RichardSefton/AUV/MidtermReport/MidtermReport.pdf

# Final Project: Draft Report

### Richard Sefton

# Contents

Introduction | 1
Literature Review | 4
Project Design | 9
Feature Prototype | 14
Appendices | 26
A Project Permission | 27
B Project Plan | 28
C VQFN Breakout | 30
D AVR ATTiny 1627 Features | 32
E TWI Library Code | 43
F Sonar Schematics | 54

1

G Depth Controller | 56
H Pseudocode | 64
I Code | 80

2

Abstract

This preliminary report focuses on the initial research into, and the making of a prototype of an Autonomous Underwater Vehicle (AUV) for the Final Project. The AUV will be written in primarily C code using bare metal AVR ATTiny1627 Microcontrollers and developed as independent modules networked using the I

2C peripheral in a way that would make it extensible to accommodate various sensor payloads. An outline of the Minimum Viable Product for this project is a vehicle that is able to Autonomously drive itself through a body of water, avoiding obstacles, with additional features such as data transmission and following mission paths to be developed in phases once MVP has been reached.

# Introduction

For this project, I plan to develop an autonomous submarine or AUV (Autonomous Underwater Vehicle) as they are commonly known. AUVs are not a new or unexplored field. They have been produced since the 1950s with various examples at the commercial and research levels along with some parallels that can be drawn in the amateur space with remote control submarine projects.
This project was born from a personal enjoyment of the Internet of Things module which allowed me to explore microcontroller programming, and interacting with physical electronic sensors and actuators. This blossomed into a passion for robotics, and as one of the early module videos highlighted our projects should be something we are passionate about: without passion, we would be unmotivated to complete this lengthy and isolated piece of work [23]. This project does not comfortably fit within any of the given templates - I found the templates for Internet of Things were topics I’m not passionate about. I did gain permission for this idea via the Coursera forums[31] prior to embarking on this journey. Screenshots of the permission can be found in the images A and A of Appendix A.
The inspiration for this project came from various YouTube videos by a single YouTuber (Brick Experiment Channel[5]) whereby the person created iterative versions of a remote controlled submarine using a watertight container and Lego. While these videos and their associated blog[6] serves as the initial inspiration, the idea to automate it comes from a fascination with robotics.

## Previous Works

### Amateur Level

The YouTuber Brick Experiment Channel[5] wrote a series of blog posts[6] outlining the build process for the 4th iteration of their remote controlled submarine.
The posts are detailed covering the steps of building this submarine with reasoning behind the design decisions along with a critical evaluation of each step. This version is using a large syringe to bring water onboard the vehicle

1

to control buoyancy, and is driven by two motors: one for propulsion, and one for direction. The sensors incorporated measure pressure to accurately gauge depth, and a laser to measure distance from the bed of a body of water.
The blog also raised communication as a consideration: While the aim of this project is to build an autonomous vehicle, it would be nice to communicate with it in flight. The problem is this cannot be done easily with wireless frequencies as the higher frequencies that provide the required bandwidth do not penetrate water that well.

### Commercial Level

The company Advanced Navigation makes the Hydrus Drone[22], which claims to be one of the smallest AUVs on the market. The device itself controls depth and position with impellers, a 4K camera with AI integrations, and a forward facing sonar. The most important aspect of Advanced Navigation’s AUV is how they address the issues around wireless communication. This company has fitted their device with acoustic and optical modems so data can be transferred using audio frequencies and light (presumably similar to fibre octics).

### Research Level

The Woods Hole Oceanographic Institute[15] draws attention to the use of different AUVs depending on the area of research or environment. They use one of 6 AUV models, which operate at different depths or different functionality.The REMUS[16] can be equipped with varying sensors and is programmed for survey missions. It was adapted to survey the Delaware river Aqueduct for leaks.
One of the more interesting AUVs this institute uses is the Spray Glider[17]. This description for this device is one that glides through the water without any external thrusters so can be travel for weeks at a time. The device uses internal bladders to control buoyancy, and is set to navigate preset paths equipped with varying sensors. What is interesting about this device is the lack of external propulsion seems to make this device more passive, and can therefore operate at lower voltage.
The UK National Oceanography Centre has details on the challenges around an designing an AUV[14]. For power and propulsion it highlights the lack of oxygen for internal combustion makes it necessary to use batteries for power and notes the difference in speed between AUVs and surface ships. For navigation it highlights that because GPS can’t penetrate the top few mm of water, the reliance on other techniques is required. It suggests an approach called Dead Reckoning which gets the speed of the AUV by measuring the Doppler shift from the sea bed for relative speed and using

2

a gyro to measure the heading. It highlights that navigational accuracy is vital to survey missions.

3

# Literature Review

The definition for an AUV is best described in an article titled ”Autonomous Underwater Vehicles (AUVs): Their past, present and future contributions to the advancement of marine geoscience”.

Autonomous Underwater Vehicles (AUVs) are unmanned, selfpropelled vehicles that are typically deployed from a surface vessel, and can operate independently of that vessel for periods of
a few h to several days.[35]

The authors go on to highlight that ”In addition, recent economic drivers, such as rapidly increasing vessel fuel oil costs, are making autonomous systems a potentially attractive proposition to organisations responsible for large-scale and cost-effective marine data collection programmes”[35]. This article addresses the commercial benefits of AUV production and deployment but doesn’t address the human benefits such as safety.
The authors also discuss the applications of AUVs and point out that ”the sensors deployed determine the vehicle altitude, as well as its speed and endurance.”[35] The endurance in this context is the available power to the AUV which would affect its overall range. Because different sensors and actuators have varying power requirements, some of these components may draw more power than others. The array of sensors required is defined by the AUVs use case: it would be inefficient mounting water quality sensors onto an AUV designed for ocean bed mapping survey.
While this article includes a lot of jargon relating to marine geosciences, it provides a good overview of the uses of AUVs and their previous applications. More importantly, it provides some good starting points for some concepts I will need to explore during the development of this project. This includes references to works that look into the Dead Reckoning method of positioning, and a launch pad into some key concepts such as Sonar.

## Communication

Because the sensors deployed on an AUV are specific to its function and is something that can be configured, it is worth considering a modular design. As a part of this there could be some level of connectivity between

4

the separate modules. Modern MCUs typically feature multiple options for communication protocols such as UART, USART, I

2C, SPI, USB, Ethernet
or could be as simple as pulling a pin high or low. For the purpose of this project, we will consider I

2C as it uses minimal wires, and allows for two way communication. The MCU data sheet[20] is the manufacturers documentation and is a vital reference for development on any given MCU and it directly relates to the MCU specific library in code. It has all the details and requirements to setup any of the provided MCU features, and gives a brief overview of each feature.
With regards to the ATTiny 1627 MCU, the data sheet describes I

2C
as a TWI (Two Wire Interface): ”The Two-Wire Interface (TWI) is a bidirectional, two-wire communication interface (bus) with a Serial Data Line (SDA) and a Serial Clock Line (SCL)”[20]. There are several advantages to using the TWI bus as a communication protocol as it allows the connection of ”one or several slave devices to one or several master devices”[20] allowing a network of devices to become interconnected. This would also allow for parallel computation as instead leaving one device to perform all of the sensor readings and calculations, some of which could be computationally expensive or using deliberate pauses of code execution, a master device could simply trigger the networked modules to each perform their actions and then do nothing while waiting for the responses.
In the article ’FEATURES, OPERATION PRINCIPLE AND LIMITS OF SPI AND I

2C COMMUNICATION PROTOCOLS FOR SMART OB-JECTS’ the authors share their opinion on how an IoT network should operate and how it should be secured, and then give an overview of both I

2C and SPI protocols before suggesting a hybrid version of the two. For IoT networks the authors suggest that ”different devices with different capabilities will take part in the creation of a network. A self-describing interface for each device is necessary in order to optimize the management of required tasks”[32]. This point backs up my idea of a modular design where sensor modules can be attached in a way to form a network where each module is responsible for a specific task. They then go on to highlight that ”adding an object to the network should not cause the collapse of the network itself. The network should also properly handle the failure of a device”[32]. This point involves error handling within a network of discreet modules. If one module fails, the whole unit should not. If the module is deemed vital to the devices operation, such as obstacle avoidance sensors on an AUV, a graceful way to handle this could be to surface the device and broadcast a signal indicating the error on a predefined wavelength so it can be collected.
For I

2C the authors give a detailed overview stating that:

The Inter Integrated Circuit (I

2C) protocol, ..., was developed by Philips in 1982 and it is a serial, single-ended bus with multimaster support and typically used to connect low speed de-

5

vices.[32]

The bandwidth available over the standard I

2C rail is slow at 100kbit/s, but there is a Fast mode and Fast Plus mode which allows up to 1Mbit/s. Additionally some devices also support a high speed mode which allows up to 3.4Mbit/s.[4]. This means the I

2C rail may not be suitable for all types of sensors attached, particularly ones that gather a lot of data in real time, for example high definition cameras.

Since the bus is completely shared, it is possible, for devices, to receive not only unicast transmission but also broadcast messages: for this reason, whenever master wants to write or read data from a particular slave, it will address it first. Addressing bits were originally seven, extended to 10 with the latest reviews to increase supported maximum number of connected devices. I

2C bus supports multiple masters on the same bus too, but a proper conflict-solving algorithm has to be implemented. [32]

This addressing is how the devices know what devices they need to talk to on a network. With the system of addressing and the ability to broadcast transmissions we can begin to visualise the I

2C protocol as akin to web sockets. The interesting point raised here is that conflict resolution needs to be handled where the network has multiple masters. One such proposal they put forward is Arbitration: ”since I

2C supports multiple masters, an arbitration rule is necessary. In this protocol, arbitration proceeds bit by bit and the rule is deterministic: the first master that produces a one when the other produces a zero loses the arbitration”[32].
Another resource that covers a lot of information about AVR Microcontrollers and also providing an overview of the features as well as how to interact with actuators such as servos and stepper motors, is ’Make: AVR Programming’[33]. While this book does contain quite a broad overview of the features and protocols, it also has examples of code to interact with them, as well as an overview of the toolchain required to programme a microcontroller (in this instance involving Make, avr-gcc[11] and AVRDude[3] as well as a physical hardware programmer). However, the example code is all written for a specific MCU that the book focuses on, being the AT-MEGA168. However, as the author notes, this should not be too difficult to port to my specifically chosen MCU as the book also tries to teach another skill being the ability to refer to relevant sections of the data sheet.
As well as internal device communication protocols, it would also be good if we could have some way of interacting with the device in flight: receiving data, and possibly some rudimentary manual over ride/remote control. As corroborated in an article exploring underwater wireless networks, ”radio is seriously attenuated in water”[13]. Radio waves exist on the EM Spectrum and the lower the frequency, the further it can penetrate water due

6

to the electrical dissipation that occurs, which is accentuated by salt water. High frequencies that we are used to as standard data transfer frequencies (WiFi, Bluetooth) are measured in GHz, and these penetrate only a few cm of water. Even LoRa at 433MHz will only penetrate 30-50cm of water. The military use lower radio frequencies operating in the range of Hz to kHz to communicate with their submarines but the trade off is lower frequencies bandwidth (less data can be transferred as there are fewer cycles per second). Additionally, radio frequencies are controlled[24] and as a hobby enthusiast/student I only have access to a limited range of frequencies. The article also states ”acoustic communication is almost the only effective way for underwater wireless transmission. Nevertheless, compared with the traditional radio, underwater acoustic communication is greatly affected by poor conditions, such as absorption, scattering, multipath interference and Doppler effect”[13]. While I think the authors are perhaps exaggerating this point to justify their experiments somewhat, it does offer an alternate avenue to wireless communication with a device while it is operating underwater, but it would require the development of an ultrasonic modem of some description. Alternatively we could just add a plug to the device for a physical wire for external control/data transmission. While this goes against the design of an AUV as being untethered, it would also act as a lifeline to retrieve the device while minimising risk, even when testing in controlled bodies of water.

## Navigation

Since AUVs are unmanned, they require a method of obstacle avoidance. Above water levels, using air as the medium there are several options available such as ultrasonic range finding, lasers or LiDAR devices, Radar, machine vision (aided with cameras), or radio signal strength to avoid obstacles such as similar devices that are networked. When the environment changes, the methods become more restricted: ultrasonic range finding is not an option in the vacuum of space as it requires a medium for the sound waves to travel through. In the case of underwater, most of the options listed above can work under certain conditions. Machine vision using cameras for example can work in clear waters. Once the water becomes murky or turbulence occurs the images can become distorted or the effective range is reduced. Lasers have a similar issue where the refraction of light in the water makes it difficult to use this as an accurate gauge. Of all the options, Ultrasonic range finding is one of the few consistently viable options for consistently accurate measurements. When used underwater, Ultrasonic range finding becomes Sonar. ’A Brief History of Active Sonar’ while discussing the threat of submarines during WW1 states that:

Since sound is the only transmitted energy that penetrates water

7

for any appreciable distance, acoustic echo-ranging had to be exploited to counter this threat. [7]

the technology was developed by Reginald A Fessenden. ”In a response to the need for enhanced detection of submerged objects and enemies, the first successful underwater transducer developed was a 540-Hz electrodynamically driven circular plate”[7] and ”the use of the word sonar for these systems, defined as Sounding Navigation and Ranging, was coined in 1942 by F. V. Test Hunt, director of the Harvard Underwater Sound Laboratory” [7]. A transducer is an electrical component that can emit sound waves in a set frequency. Additionally, the transducer can detect sound waves on the same resonant frequency. When the detection occurs the sound waves cause the transducer to vibrate generating an electrical signal [28].

The inter-war period was also a time for basic research in underwater acoustics. One key discovery during this period was that amplitude of higher frequencies of underwater sound are attenuated more than lower frequencies as they pass through
the seawater. [7]

This observation states that lower frequencies penetrate water better than the higher frequencies, i.e. lower frequencies provide a longer range, but what this article fails to cover is that higher frequencies provide a higher resolution when it comes to sonar imaging technology [34].

8

# Project Design

## Domain

AUVs have applications spanning multiple domains both in scientific exploration as well as commercial enterprise. For science they are used for surveying coastlines and ocean beds, sampling in remote or hard to reach locations and exploring the depths to name a few applications. For commerce they can de deployed to monitor gas and oil pipelines, monitor drills, survey potential resource sites, and monitor ship hulls etc. The deployment of AUVs over physical diving or manned equipment offer more benefits when compared to the cost. AUVs can potentially spend longer underwater depending on the design and payload they are equipped with and the size of the power source, and can gather far more data than a diver with far less risk to human life (if they are deployed at sea the risk will never be zero, but there is considerably less additional risk).
For the purposes of this project the AUV I will develop will be targeted towards the scientific exploration domain, specifically those designed for survey missions. AUVs in this domain are highly configurable with the payload (being the array of sensors attached) being customised for the survey being conducted, often with fallback sensors to verify the data (such as cameras coupled with sonar), or designed from the ground up for a specific operational area. This project will be focused on a customisable AUV focusing on the core mechanics that make it autonomous. The minimal viable product for this project is going to offer basic functionality (object avoidance primarily), but will be modular in design. The sonar and motor controllers would be separate Client modules bound by a central Host MCU.

## Technologies

For this project I plan to use predominantly AVR based microcontrollers with code written in C using the official AVR libraries, but otherwise a ”bare metal” approach. This project will be using little to no Arduino code as now is a good learning opportunity to programme microcontrollers without relying the Arduino layer of abstraction or the on board programmer

9

attached to a pre-fabricated Arduino boards. Additionally, by focusing on the MCU alone, PCBs can be fabricated for this project with a far lower footprint than trying to fit in multiple individual Arduino boards, which could prove invaluable if space and weight becomes a premium. The specific MCU I plan to use is the AVR ATTiny1627[20] due to its small size and power requirements. The device can operate on 1.8V to 5.5V making it potentially extremely low powered, and is also feature rich (Appendix D). Unfortunately the chip itself is extremely small as the 24 pin 1627 is only available in QFN (or VQFN packaging), which is incompatible with a breadboard for development and testing. To mitigate this I have developed a QFN breakout board (Appendix C). This has proven to be economically viable as the cost per board was only £7 and the MCU was less than £1 making the per board cost for each MCU to be ¡ £8. This comparable with the Raspberry Pi Pico or the NodeMCU 8266[8] and significantly cheaper than the Arduino Uno or larger Raspberry Pi models.
The AUV itself will be using predominantly large diameter plastic tubing or a suitable size plastic tub along with various adhesives and sealants (silicone based) for waterproofing the device. Lego will also be used for structural support and for aiding in the various mechanisms to drive the device (such as rotors/propellers). The use of Lego has been decided over creating custom devices on a 3D printer due to budget and time constraints. For navigation and obstacle avoidance this project will employ the use of sonar. While prefabricated sonar units designed for underwater applications exist, these are often expensive with devices such as the Ping2 by Blue Robotics[27] which is designed for this type of application starting from £400. While devices such as this are extremely feature rich, they are out of reach for this project. Alternatively there are various fish finders on the market that start from £40 which could be hacked to become compatible with this project. There is also the option to use the HC-SR04[10] ultrasonic rangefinders, but they may not be suitable for this application for a few reasons:
- The HC-SR04 is not designed for underwater applications. There may be an issue with the air gap between the transducer itself and the hull of the vessel which in itself could be problematic. The transducers may have to be mounted outside of the vessel.
- The HC-SR04 is primarily designed for over the air applications. Speed of sound travels faster through water than in the air and the MCU that is controlling the device may be tuned to enable the receiving transducer only after set time period to reduce false positives and noise. This period would shorten the minimum range of the sensor.

For these reasons I will aim to develop a sonar module from scratch. The data sheet for the HC-SR04 module is also quite useful as it provides a

10 formula for calculating distance in the air.

Range =

HighLevelT ime × V elocity 2
[10]
In this formula, Velocity is the speed of sound. The data sheet describes this as a flat 340m/s which is slightly inaccurate. The speed of sound is impacted by environmental factors such as temperature, humidity and the transmission medium meaning the Velocity would need to be adjusted for water, and saltwater more so[9]. Another article, titled ’Design and Development of an Ultrasonic Motion Detector’[1] could prove to be valuable to this project as it covers the development process in creating an ultrasonic device to detect motion. While this is not fully what I will be looking to accomplish, it provides insight on two key concepts: A Sonar circuit diagram example, and Doppler Shift which is used in Dead Reckoning to help provide the speed of the AUV relative to a fixed point.
For propulsion the plan is to use either a toy motor or a stepper motor. The toy motors are easier to drive, using Pulse Width Modulation fed into a prefabricated driver circuit to specify the speed. The issue with the toy motor however is the torque - it may not have the required torque to drive a shaft as the current plan is to use magnets to connect an internal and external shaft in the same way as the YouTuber ”Brick Experiment Channel”[6]. The stepper motor will provide the required torque but speed adjustment is not quite as simple as modifying the PWM duty cycles.
For depth control the plan is to use a large syringe similar to ”Brick Experiment Channel” RC Submarine but this will involve some experimentation to see if this can be achieved by modifying the weight of the vessel by taking on water from outside, or by changing the density of the vessel by compressing the available air. The syringe will be driven by a motor, which will likely be a stepper motor given the compression and decompression will require more torque than the toy motors can provide and because this requires somewhat more precision. This will also require a method to convert the rotary force to a linear push/pull force on the syringe plunger.

## Project Plan

This is a highly ambitious project. For this reason it is necessary to outline a clear minimum viable product, with phased further development beyond this point. The MVP will consist of the core components that will make an AUV able to move through a body of water:

- Propulsion
- Directional control

11

- Depth Control
- Sonar for obstacle avoidance
- Main control unit to gather sonar data and respond to external influence (directional control and driving) - In short, Autonomy.

The MVP for this project will be broken down to its core modules and developed as discreet entities. For example the sonar module would be a module that sits on the I

2C rail and performs on receiving a command returning the distance to the requester. By splitting the development into modules, the development can be easily broken down to follow a more Agile method of development where the modules can be developed and integrated into the final product in sprints. The modular design will also allow the easy integration of multiple of the same modules: if it becomes apparent that more sonar is required, we can simply add another to the I

2C with
minimal changes to the controlling module.
Phase 2 of this project will involve expanding on the MVP to include the following features:
- Algorithm for surfacing and data transmission.
- Configured WiFi device (8266) to transmit the data
- Companion app to receive and visualise the data

Phase 3 of this project will involve expanding on Phase 2 to include the following feature:

- Use of Dead Reckoning to obtain relative speed of the vessel
- Integration of a gyro to gauge an accurate heading
- Programming interface to upload a planned path
- Algorithms to follow the path, correcting for unknown obstacles along the way

The project has been planned with the aid of GitHub Projects[12]. The details of the project planning can be found in B of the Appendix, and the GitHub repository is referenced in the bibliography. [29] [30]. The repository should be public, but the project itself may be private and inaccessible. Going by the project plan I am currently behind schedule owing to issues discovered building a working Sonar module from scratch, but this is the last component required to get working before MVP can be achieved so I am not overly concerned right now.

12

## Evaluation Plan

For the MVP of this project, the plan is to test each module in isolation before bringing them all together. The testing will primarily be done outside of the water, with calculations for the sonar tuned to over the air transmission and reception, with the objective to modify this small part prior to testing in the water. Using the RTC peripheral with a high frequency clock provides the requisite resolution to calculate underwater so this approach should work. Testing in water will only be done at the end of the project once a complete device has been created and can be verified to be water proof, as even with low voltages I lack the expertise to comfortably and safely test with water.
The acceptance criteria for a successful evaluation for the MVP once it has been accomplished will be a device that when in a body of water will be able to move autonomously in any direction, avoiding obstacles. There are ethical concerns surrounding wildlife that could be affected: ultrasonic is outside the range of human hearing, but even if wildlife can’t hear ultrasonic sound waves, there are other considerations such as failed tests causing injury to wildlife, or issues surrounding encroaching on territory and wildlife gaining injuries by attacking the AUV. To mitigate these concerns, the AUV will only be tested in small controllable bodies of water where no wildlife is present. The ideal solution would be a large swimming pool but this may not be an option due to availability or cost in renting a public pool for any period of time. Testing may have to be done in a smaller pool that can be erected and filled for testing purposes and relatively inexpensive depending on its capacity. A valid pool for testing would be one that allows testing of both navigation and depth control so it would need to be at least 1m in depth.

13

# Feature Prototype

## Overview

For this stage in the project I have developed a prototype as a proof of concept of the modular design of each of the feature components. This prototype consists of 3 different modules:

- Sonar
- Motor Controller
- Central Controller

The modules are all networked using the I

2C protocol using the AVR
TWI peripheral using a star network topology where the Sonar and Motor Controller modules are each connected to the Central Controller with a Hos -¿ Client or Master -¿ Slave relationship, with the Central Controller acting as the Host/Master. The Central Controller is configured to perform the same action every second. This is accomplished using the Real Time Counter setup to trigger an event every second using the Overflow Interrupt which uses I

2C to retrieve a distance from the Sonar Module, and depending on the data sent from the Sonar module will then issue an instruction to the Motor Controller module to either start or stop the motor, again using I

2C. The Sonar module is also using the RTC peripheral to time the delay between triggering the ultrasonic and receiving the response then calculates the distance before sending back the result. The Motor Controller module drives a motor in the main loop, controlled by a global variable adjusted depending on the value of the command received from the Central Controller module.

1. Device powers on
2. Module peripherals setup
3. Modules enter infinite loop
(a) Controller: RTC Interrupt event

14

(b) Controller: RTC issues I

2C read operation to the Sonar module and enters a waiting state for the response

(c) Sonar: I

2C Interrupt event fires

(d) Sonar: start time recorded from the RTC count buffer
(e) Sonar: HC-SR04 trigger pin pulled high for 10µs
(f) Sonar: Module waits for echo pin to fall low
(g) Sonar: Module gets the end time from the RTC count buffer and calculates the distance
(h) Sonar: Module sends data back to the Controller over I

2C

(i) Controller: Module uses the distance response to send either a start or stop command to the Motor Controller
(j) Motor Controller: Module receives a command to either start or stop the motor. I

2C interrupt updates the global variable controlling the motor

(k) Motor Controller: Motor is driven by pulling pins connected to a motor driver high or low in a specific order

The full code for this can be found in Appendix D and E.

## Challenges

While the prototype concept is quite a simple one, the decision to not use Arduino code to facilitate this made it much harder to build. There were a couple of challenges in making this prototype that needed to be overcome or a compromise devised. First was with the Sonar module. The original plan was to build my own Sonar module that functions similarly to the popular HC-SR04[10] prefabricated ultrasonic range finder. This module uses inexpensive 40kHz transducers to emit a signal pulse using a Pulse Width Modulation signal of the same frequency connected to a MOSFET with a power source 12V from a DC voltage step up circuit. The theory is the emitting transducer will emit a pulse which when bouncing off an object will cause the receiving transducer to oscillate at the same frequency generating an electrical signal. The received signal is amplified as the voltage would be quite small, and the time between starting the transmitter and receiving the response would be used to calculate the distance. In practice, this is not what is happening. The distance in my module is currently always returning the same value. At this stage I do not have any concrete reason why this is occurring but speculating I have a couple of ideas. First, it is possible that the voltage driving the transducers is not high enough. I have two different varieties of transducers: plastic ones[26] similar to the HC-SR04, and Aluminium ones[25] which are more waterproof. When integrating the

15

Aluminium ones into this module absolutely nothing happens. The data sheet for the Aluminium transducers indicates that the maximum voltage is 160V and 12V source is not even 10% of this. The plastic transducers have no maximum voltage in the data sheet but appears to work. The issue with the device always displaying the same distance value could be the receiving transducer is picking up the resonance from the transmitter while it is transmitting. As a compromise to build the prototype in time for this submission, I made this Sonar module using the HC-SR04[10]. The schematics for my Sonar module in its current state can be found in Appendix F
The second challenge faced during the development of this prototype was surrounding the I

2C protocol. Using Arduino, there is easy access to the ”Wire” class which initialises the protocol and supplies functions to send and receive data. The choice to use the bare metal approach meant I do not have access to such libraries. This meant that I needed to create my own library in order to use this feature, which I managed to do using a combination of the MCU data sheet[20] and the Make: AVR Programming book[33]. The way the protocol works is the Host is configured with a baud rate to set the clock and the Client devices are initialised with an Address. The Host makes a request to a Client by sending the Client Address along with a bit indicating the mode of operation (Read or Write).
For write operations, the Client must respond with an acknowledgement that the address is correct. Once the Host has received acknowledgement (ACK) the clock (SCL) is held low and the bus is set to a busy state. The host can then send data. Each time the Client reads from the data buffer it can send the (ACK). If the Client can no longer receive data, it will send a not acknowledged bit (NACK). At this point the Host can send the stop command. Once the stop command is issued the bus state is set back to Idle where it is ready for the next command. Read operations are similar to this, with the exceptions that the Client device is handed control of the SCL and the Host must issue the ACK or NACK bits as well as the stop command.
Luckily, the ACK and NACK bits are handled automatically if ”Smart Mode” is enabled on the peripheral which will automatically send these bits when the data buffers are read from or written to, or when the Interrupt flags are cleared. The main challenge faced developing this library was surrounding the stop command being issued incorrectly, which was either leaving the bus in an error state. This caused the protocol to hang after successfully sending the first request, or caused the Central Controller module to reset itself. This was eventually overcome after discovering[21] that the stop command should be sent before writing to or reading from the data buffer. Once this was discovered, the stop command successfully put the bus state to idle when ending an operation, ready for the next.

16

## Further Development

The next stage of development following on from this prototype is to get a working sonar module using the waterproof transducers[25]. This will require further research into increasing the voltage which is difficult with DC current. I think the options are either try to amplify the PWM signal, or convert the PWM signal into an analogue AC signal and use a transformer to try and reach anywhere between 40-100V. I don’t think this will require significant amperage, so this should be relatively safe. Once this is completed, the task after this would be to connect multiple modules to a central controller and have that drive 3 different motors depending on the distances recorded from each module. I will require to connect 4 sonar modules (left, right, bottom and front) and 3 motors (propulsion, direction and depth). Following this, it will be a case of designing PCBs and getting them fabricated while working on the vessel itself ensuring it is a suitable size and is water proof, and working out a mechanism to push or pull the plunger on a large syringe.

17

# Implementation

Disclaimer: this is a zero weighted draft report so this is not going to be very pretty. This will be a quick informal outline of development to date with some reflection but probably won’t be very well written.

## Sonar

So in a nutshell, the development to date has been rough, to the point I wished I didn’t choose an AUV when a land based vehicle would have been so much easier. I honestly thought I would be done with my own sonar module a week or so after the midterm but as it turns out, developing a sonar module from scratch is actually really difficult! So the issue is as mentioned, the HC-SR04[10] module is not really waterproof, and if housed inside, there are concerns about the air gap between the module and the water it would be trying to detect obstacles in causing either a degraded signal, reduced range or false positives.
The aluminium transducers I purchased to combat this are proving hard to power when compared to the plastic ones or the transducers on the SR04 module. The datasheet states they can take a maximum voltage of 160V peak to peak. While this is the maximum rating, I am presuming that in order to get nominal operation, they require more than say 5-10V. I have explored a number of DC-DC convertors to provide more power. I have tried this with a 12V supply, and more recently with a 30V supply, with the latter providing some briefly promising results. I am also waiting for a 30V DC-DC convertor that will provide a supply of pm15V (30V peak to peak). I also briefly experimented with a 100V DC-DC convertor but stopped this avenue of exploration as they get incredibly hot to the point that they pose a fire risk, and this device must be safe. In addition to this I have also tried printing waterproof enclosures for the lower power transducers, but these have a degraded (weakened) return signal when compared to unenclosed. However, while I am incredibly keen to finish this module and provide my own solution I have also been exploring other avenues so this is not a complete failure. To this end I have purchased 2 other devices similar to the HC-SR04 that are more weather/water proof, yet still more affordable than

18 dedicated underwater modules such as the Ping 2[27]. My journey to date has led me to understand why such modules are so expensive. These weather/water proof modules I originally discounted from being used as there are conflicting responses in forums as to their suitability underwater, with varying degrees of success, but at this stage, at least for a first prototype, it will be better to have something that kind of works than nothing at all. However, these modules will leave the device with an uncontrollable blind spot of about 4 times the over the air blind spot (which may be why online accounts little success with testing in small bodies of water such as buckets and bathtubs). I’ll do the maths later to determine the actual blind spot. If all else fails, and either the off the shelf modules don’t work and my module is not possible in the available timeframe, I have had another more unique idea for obstacle avoidance being whiskers. This was literally a shower thought and not fully researched but a quick google and such sensors are not readily available (maybe I’m inventing something here, I don’t know) but the concept is basically like a cats whisker: a flexible stick that when bent, will alert that there is an obstacle. this can be done simply with a wire and contacts in a side wall at the base. If the wire touches the side wall (caused by bending the stick) this would cause a rise in voltage which we can use to trigger some code in an interrupt routine. Its just an idea and probably won’t be implemented, and probably won’t even get mentioned in the final report.

## Vessel

Previously in the report, I mentioned that I would be aiming to use lego and a some unspecified suitable receptacle or tubing for the vessel itself. I stated that while 3D printers exist, this and CAD software for design would be too much of a learning curve in the alloted time.
During the course of making the prototype for the midterm, some elements, such as the stepper motor, are just incompatible with lego in a way to house it securely. Since some elements such as the depth controller requires securely fitted components with enough torque to pull a plunger from a large syringe I felt that some elements of the project required some custom made parts.
As it turns out, CAD software in general has not changed all that much since GCSE design tech from 20 years ago. The first iteration of the depth controller I sent to a company to get printed and the result was a poor design where I couldn’t get the stepper motor into the housing. This highlighted a necessity to invest in a 3D printer which also was not as big of a learning curve as imagined.
Currently, I have the main body of the hull and head of the AUV designed and printing in sections as I type. Once a complete prototype is printed

19 which should be the middle of next week as each section takes somewhere between 6-10 hours to print, I can test it for water proof, which will simply involve measuring moisture from inside the device after being submerged for a periods of time while attempting to simulate the various motions that it will be subjected to. The method of measuring the moisture quite low tech. I will be padding the interior with kitchen roll and checking its dry when the tests are completed. If any moisture is present, I will iteratively repeat the tests with checking for moisture in between to determine the cause and redesign as necessary.

## Depth Control

The Depth controller is a large (300mL) syringe, which will be driven by a stepper motor. The problem that required solving on this part of the AUV was converting the rotary force of the stepper motor to linear motion. As mentioned this was solved by designing and fabricating specific components in a secure enough housing. The stepper motor shaft is connected to a long threaded shaft with a large nut connected to the syringe plunger. As the motor turns, it traverses the length of the thread, pulling and pushing the plunger.
The mechanical side of this is theoretically sound. The next issue is the stepper motor must know when to stop and start. To this end, the two ends of the depth controller will have a metal plate with a voltage running through it and the plunger nut will have a wire that once in contact with the plate will detect the voltage telling the microcontroller it has reached the end of its travel. The code itself is also going to store the current position in an array. The array is zeroed and a 1 will mark its current position. The array will be updated after a period of time the motor is running using one of the microcontrollers Timer Counter peripherals using the end plates to calibrate itself.
The depth controller is in a working state: its not currently controlled by the central controller, but the stepper motor does drive the mechanics as expected (with one small alteration required being the end screw holder needs to be closed off to prevent the other end of the screw coming off the motor shaft). The inputs acting as a kind of buffer to detect the ends of the travel get triggered correctly and set the position array. The code for this is in Appendix G

## Central Controller

Just like the midterm prototype the different parts of the AUV (Sonars, Depth Controller and driving motors) will be connected to a central controller via the I

2C rail. This is a tested solution that only needs to be fleshed

20 out to handle more sensors on the rail and responds to the readings from the sensors as required.
While it will be a bit more complex due to the device running primarily on interrupts and Timer Counters, the pseudocode for the controller would look something like this:
1 | //Max distance is an arbitrary value here
2 | maxDistance = 30;
3 | array Sonars = [LEFT, RIGHT, DOWN, FORWARD];
4 | foreach sonar in Sonars
5 | {
6 | result = i2c.read(sonar);
7 | if (result < maxDistance)
8 | {
9 | respondToSensor(sonar)
10 | }
11 | }
12
13 | function respondToSensor(sensor)
14 | {
15 | switch(sensor)
16 | case LEFT:
17 | i2c.write(TURNRIGHT)
18 | case RIGHT:
19 | i2c.write(TURNLEFT)
20 | case FORWARD:
21 | i2c.write(STOP)
22 | i2c.write(UP)
23 | case DOWN
24 | i2c.write(UP)
25 | }
| The final solution will be more complex than this as the directional
| commands will require constant monitoring of the sensors, particularly those
| that triggered the operation, to check the obstacle has been cleared.

21

# FINAL DRAFT DEVELOPMENT NOTES

## 0.1 v1

Version 1 of the sonar (H, H.2 and I I.2) is working more or less as expected. On button press it returns a number. The number seems to be relative to whatever the sonar is bouncing from. This needs some refinement but for now it is in a place we can take it forward and connect I

2C peripheral and
get a value on request.
Version 1 of the depth controller (H, H.1 and I, I.1) more or less works. The button press doesn’t work but it bounces off the end buffers as expected. It needed a little tweaking from the pseudocode but not too much. The buffers are basically modified mosfets glued to the depth controller mechanics at each end of the screw. Wires are soldered to the heat sync of the mosfet (because I needed a plate) and voltage passed through. When the voltage is detected in the buffer pins it causes a change in direction of the stepper motor. Its simple and it shouldn’t cause an endless cycle of interrupt code to be triggered as we’re only listening for rising edges. We Can move these on to version 2.
Version 2 of the depth controller and sonar are written but untested. I need to write the central controller code to control these modules.
First waterproof test was not successful. Water leaked from the outside to the inside while fully submerged with the weakness being on the gaskets joining the sections. As a result of this, I’ve applied some silicon sealant to the affected areas and tightened the bolts with excess torque and will try again. The lower hull end sections are being reprinted as the design has been modified to accomodate the side motors for directional control. These have been placed at each end and to turn left or right, the motor at each end opposing each other would be used. This is preferable to the single point of turning being at the back as the turning circle is smaller.
Second waterproof test was not successful. Water did not ingress from the now silicone sealed gaskets and joints, but as it transpires there is a fundemantal flaw with PLA printed parts having small gaps in between the

22 layer lines that allows water in. The quickest solution to this will be to try and coat the parts with epoxy. If I coat both the interior and exterior this should hopefully elimninate this issue. I also need to look into waterproofing the electrinics. Maybe putting them inside a box.
The resin coating will take a few days to arrive. I have about 1 week therefore to get the electronics in a working order.
Coating with resin worked. In combination with the silicon this now creates a water tight seal.
Developing the internal electronics has been a challenge. For the midterm I had an TWI/I

2C library I developed but this seemed to not want to work for the final iterations of the code. So I’ve had to revisit this section. For Arduino, the TwoWire[2] library (the Wire.h file that is included for such communications) works flawlessly. However because the ATTiny 1627 is relatively new and also not commonly found on a prefabricated Arduino board, the registry addresses may not be accurate. Luckily, this MCU is covered by the megaTinyCore[18] which has a version of the TwoWire [19] library converted using the correct registers. Unfortunately it is coupled to some other libraries included in Arduino code and written in C++ so there was a bit of work to convert it to C and remove the dependencies. These dependencies were pretty much all around the Stream library to send and receive strings which I don’t care about for this application so easy to drop. This took some time but it works and seems to be quite stable as long as all the MCUs using the protocol have a common power source.

23

# Evaluation

So far no evaluations have taken place to date outside of testing the individual components during the course of development which in itself has been minimal due to the unexpected issues surrounding making a sonar module from scratch. However, I am currently just about on track to have an early prototype to begin testing and iteratively improve upon by the start of August.
These tests will primarily be ”simulations” by testing the device out of the water (substituting the speed of sound calculations to be suitable for over the air). Testing the device will be testing how the device responds to obstacles in each direction on the MVP. Once these tests pass it will be a case of moving on to testing in water. This includes testing the device is suitably water tight, and the weight is correct so it can sit in the desired position in the water without assistance. This will involve adding extra weight to both ends for balance, then testing the devices ability to traverse a body of water avoiding obstacles placed in its path.
The difficulty is going to be finding a place suitable to test. Ideally, I need a swimming pool. In practice I would find it highly unlikely that public pools would grant me permission to carry out such testing. Call me jaded, but in a world where insurance and liability exists its a pointless avenue to even entertain.
There are solutions however to try and get around this. First I will approach my local community on social media to see if anyone has a pool available I can test in. If this proves unsuccessful, I will search a wider area (the whole of the UK) for a location. There are sites that rent out pools for the purposes of film shoots but this comes at a price. If this is the case, I will need to carefully plan what will be tested to maximize the productivity in the allotted time frame.

24

# Conclusion

Overall, the project progress to date has been poorer than anticipated. In hindsight, I should have picked a land based autonomous vehicle as the limitations that have presented themselves have been related to the environment the device is designed to run in.
The Sonar module has been the biggest challenge and regret that I have sunk so much time into this with very little to show for it so far. I was blindly optimistic that this would be far easier than it turned out to be, and it has highlighted a need to study electronics in more depth in order to continue down this path in the future. The time spent on this specific module has prevented any hope of development beyond the Minimal Viable Product which is disappointing. But in fairness, even if I did reach a stage beyond MVP, I would still be disappointed not reaching a phase beyond any of the phases outlined earlier in the report. However there is plenty of room left for future development beyond the academic module.
It has been fun though and full of learning experiences and has even let me employ some design skills that I’ve not had the chance to use since school. I would have deffinately had more success sticking to the web based template projects, since this is what I do for work, but then it would have been less of an accomplishment as I would be far less likely to have learnt anything new. And really, isn’t that the whole point of this?

25

# Appendices

26

# Appendix A

# Project Permission

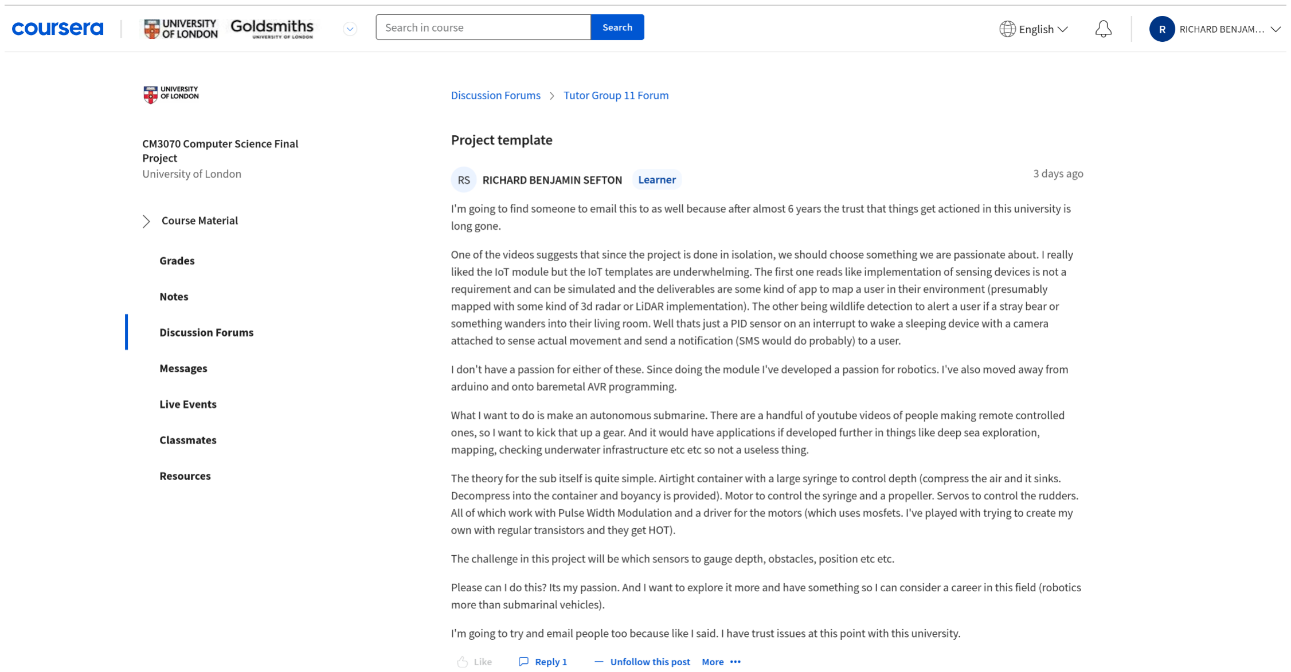
[picture p43: figure]
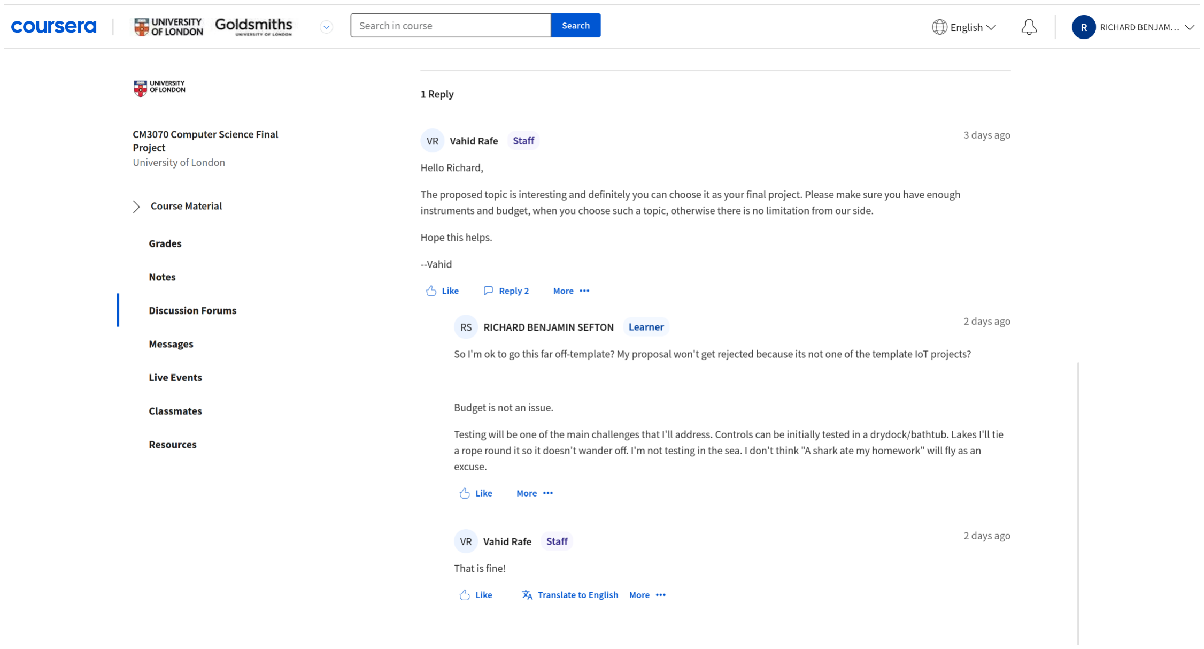
[picture p44: figure]

27

# Appendix B

# Project Plan


28


29

# Appendix C

# VQFN Breakout

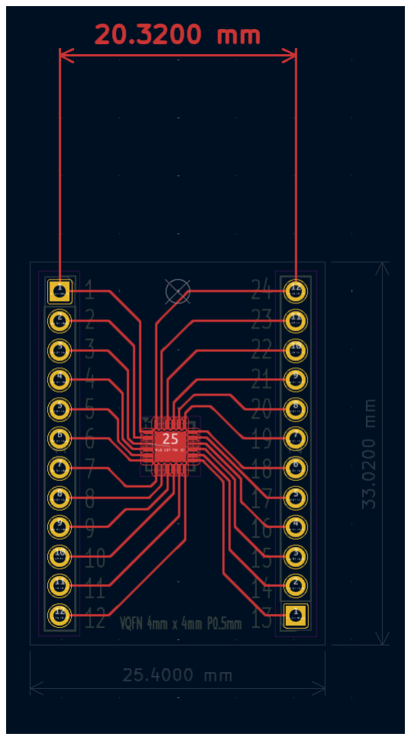
[picture p45: figure]

30


31

# Appendix D

# AVR ATTiny 1627 Features

- Low Power
- 16kB programmable flash memory
- 256B EEPROM
- Power on Reset
- Brown out Detection
- Configurable clock
- UPDI
- Idle, Standby and Power down sleep modes
- 3x 16 bit Timer Counters (TCA and 2 x TCB)
- PWM generation
- Real time Counter
- USART
- SPI
- TWI (I
2C)
- Analog to Digital conversion (ADC) with amplifier
- Watchdog Timer
- Interrupts on all GPIO pins
- 22 Programmable GPIO pins

32

# Prototype Module Code

Central Controller code

1 | #include <avr/io.h>
2 | #include <avr/interrupt.h>
3 | #include <util/delay.h>
4 | #include "TWI.h"
5
6 | #define MOTOR_DRIVER_ADDR 0x49
7 | #define SONAR_ADDR 0x08
8
9 | #define COM_STOP 0xFF
10 | #define COM_START 0xAA
11
12 | // LED For debugging
13 | #define RED PIN6_bm
14 | #define GREEN PIN5_bm
15 | #define BLUE PIN7_bm
16 | #define YELLOW (PIN6_bm | PIN5_bm)
17 | #define PURPLE (PIN6_bm | PIN7_bm)
18 | #define CYAN (PIN5_bm | PIN7_bm)
19 | #define WHITE (PIN6_bm | PIN5_bm | PIN7_bm)
20
21 | void MainClkCtrl(void);
22 | void SetupRTC(void);
23 | void SetupTCA(void);
24
25 | // For LED Debugging
26 | void SetupPins(void);
27 | void ChangeColour(uint8_t);
28
29 | volatile uint8_t distance = 0;
30 | volatile uint8_t sendMotorInstruction = 0;
31
32 | int main()
33 | {
34 | MainClkCtrl();
35
36 | // Allow Slaves to init first

33

37 | _delay_ms(2000);
38
39 | SetupRTC();
40 | SetupTCA();
41
42 | TWI_Master_Init();
43
44 | SetupPins();
45
46 | sei();
47
48 | while(1)
49 | {
50 | ChangeColour(GREEN);
51 | }
52
53 | return 0;
54 | }
55
56 | void MainClkCtrl(void)
57 | {
58 | _PROTECTED_WRITE(CLKCTRL.MCLKCTRLA,
| CLKCTRL_CLKSEL_OSC20M_gc);
59 | _PROTECTED_WRITE(CLKCTRL.MCLKCTRLB, CLKCTRL_PDIV_6X_gc |
| CLKCTRL_PEN_bm);
60 | // F_CPU with this configuration will be 3.33MHz
61 | }
62
63 | void SetupRTC(void)
64 | {
65 | RTC.CLKSEL |= RTC_CLKSEL_INT1K_gc;
66 | RTC.PER = 1024; //provides a 1 second interval timer
67 | // Clear any existing flags
68 | RTC.INTFLAGS |= RTC_OVF_bm;
69 | // Enable the overflow interrupt
70 | RTC.INTCTRL |= RTC_OVF_bm;
71 | // Enable the RTC
72 | RTC.CTRLA |= RTC_RTCEN_bm;
73 | }
74
75 | void SetupTCA(void)
76 | {
77 | // Set up TCA to overflow at a desired interval
78 | TCA0.SINGLE.PER = 0xFFFF; // Maximum period
79 | // Enable TCA overflow interrupt
80 | TCA0.SINGLE.INTCTRL |= TCA_SINGLE_OVF_bm;
81 | // Set TCA to Normal mode
82 | TCA0.SINGLE.CTRLB |= TCA_SINGLE_WGMODE_NORMAL_gc;
83 | // Use the system clock and set prescaler

34

84 | TCA0.SINGLE.CTRLA |= TCA_SINGLE_CLKSEL_DIV1_gc;
85 | }
86
87 | void SetupPins(void)
88 | {
89 | PORTB.DIR |= RED | GREEN | BLUE;
90 | }
91
92 | void ChangeColour(uint8_t c)
93 | {
94 | PORTB.OUTSET = RED | GREEN | BLUE;
95 | PORTB.OUTCLR = c;
96 | }
97
98 | ISR(RTC_CNT_vect)
99 | {
100 | // Clear the interrupt flag
101 | RTC.INTFLAGS = RTC_OVF_bm;
102
103 | ChangeColour(RED);
104
105 | // Start TWI operation
106 | distance = 0; //reset the distance
107 | TWI_Master_Start(SONAR_ADDR, 0x01); //Start TWI to sonar
| module
108 | distance = TWI_Master_Read_NACK(); //Get the distance
109 | TWI_Master_Start((uint8_t)MOTOR_DRIVER_ADDR, 0x00); //Start
| TWI to Motor
110 | if (distance < 55)
111 | {
112 | TWI_Master_Write(COM_STOP); //Send motor a stop command
113 | }
114 | else
115 | {
116 | TWI_Master_Write(COM_START); //Send motor a start
| command.
117 | }
118 | TWI_Master_Stop();
119
120 | ChangeColour(PURPLE);
121 | }

35

Ultrasonic Module code

1 | #include <avr/io.h>
2 | #include <avr/interrupt.h>
3 | #include <util/delay.h>
4
5 | #include "TWI.h"
6
7 | #define ADDR 0x08
8
9 | #define COM_SCAN 0xFF
10
11 | void MainClkCtrl(void);
12 | void SetupPins(void);
13 | void SetupRTC(void);
14 | void I2C_RX_Callback(uint8_t);
15 | uint8_t I2C_TX_Callback(void);
16
17 | uint8_t waitingForEcho = 0;
18 | uint16_t startTime = 0.0;
19 | uint16_t endTime = 0;
20 | float distance = 0.0;
21 | float speedOfSound = 0.0343; // cm per microsecond
22 | float ticks = 0.0;
23
24 | int main()
25 | {
26 | MainClkCtrl();
27 | SetupPins();
28 | SetupRTC();
29
30 | TWI_Slave_Init(ADDR, I2C_RX_Callback, I2C_TX_Callback);
31
32 | sei();
33
34 | while(1)
35 | {
36 | // Main loop does nothing, waiting for interrupts
37 | }
38
39 | return 0;
40 | }
41
42 | void MainClkCtrl(void)
43 | {
44 | _PROTECTED_WRITE(CLKCTRL.MCLKCTRLA,
| CLKCTRL_CLKSEL_OSC20M_gc);
45 | _PROTECTED_WRITE(CLKCTRL.MCLKCTRLB, CLKCTRL_PDIV_6X_gc |
| CLKCTRL_PEN_bm);

36

46 | // F_CPU with this configuration will be 3.33MHz
47 | }
48
49 | void SetupPins(void)
50 | {
51 | // Trigger
52 | PORTA.DIR |= PIN2_bm;
53
54 | // Echo
55 | PORTA.DIR &= ~(PIN3_bm);
56 | // | PORTA.PIN3CTRL = PORT_ISC_FALLING_gc;
57 | }
58
59 | void SetupRTC(void) {
60 | RTC.CLKSEL = RTC_CLKSEL_INT32K_gc;
61 | // Wait for synchronization
62 | while (RTC.STATUS & RTC_CTRLABUSY_bm);
63 | RTC.PER = 0xFFFF; //Maximum period
64 | // Enable the RTC, run in standby mode, no prescaler
65 | RTC.CTRLA = RTC_RUNSTDBY_bm | RTC_PRESCALER_DIV1_gc |
| | RTC_RTCEN_bm;
66 | }
67
68 | void I2C_RX_Callback(uint8_t com)
69 | {
70 | // We’re not actually using this. Just need the function
| | for the SlaveInit function
71 | }
72
73 | uint8_t I2C_TX_Callback(void)
74 | {
75 | // Set trigger pin to high
76 | PORTA.OUTSET = PIN2_bm;
77 | _delay_us(10); // Wait at least 10us
78 | PORTA.OUTCLR = PIN2_bm; // Disable trigger
79 | startTime = RTC.CNT;
80
81 | // Wait for echo pin to go high
82 | while (!(PORTA.IN & PIN3_bm));
83
84 | // Wait for echo pin to go low
85 | while (PORTA.IN & PIN3_bm);
86
87 | // Read RTC counter value
88 | endTime = RTC.CNT;
89
90 | // Calculate distance
91 | ticks = (float)(endTime - startTime) * 30.5176; // Convert
| | to microseconds

37

92 | distance = (ticks * speedOfSound) / 2;
93
94 | // Return the calculated distance as a byte
95 | return (uint8_t)distance;
96 | }

38

Motor Controller code

1 | #define F_CPU 3333333UL
2 | #include <avr/io.h>
3 | #include <util/delay.h>
4 | #include "TWI.h"
5
6 | void MainClkCtrl(void);
7 | void SetupPins(void);
8 | void digitalWrite(uint8_t, uint8_t);
9 | void I2C_RX_Callback(uint8_t);
10 | uint8_t I2C_TX_Callback(void);
11
12 | #define HIGH 0x01
13 | #define LOW 0x00
14
15 | #define STOP 0xFF
16 | #define FORWARD 0xAA
17 | #define BACKWARD 0x02
18
19 | #define ADDR 0x49
20
21 | volatile uint8_t state = FORWARD;
22 | volatile uint8_t step = 0x00;
23
24
25 | void stepperMotorStep(uint8_t step);
26
27 | int main()
28 | {
29 | MainClkCtrl();
30 | SetupPins();
31 | TWI_Slave_Init(ADDR, I2C_RX_Callback, I2C_TX_Callback);
32
33 | while(1)
34 | {
35 | if (state != STOP)
36 | {
37 | stepperMotorStep(step);
38
39 | if(state == FORWARD)
40 | {
41 | step++;
42 | }
43 | else
44 | {
45 | step--;
46 | }
47

39

48 | if(step > 0x07)
49 | {
50 | step = 0x00;
51 | }
52
53 | if(step < 0x00)
54 | {
55 | step = 0x07;
56 | }
57
58 | _delay_us(750); // Adjust delay as needed
59 | }
60 | }
61
62 | return 0;
63 | }
64
65 | void MainClkCtrl(void)
66 | {
67 | _PROTECTED_WRITE(CLKCTRL.MCLKCTRLA,
| CLKCTRL_CLKSEL_OSC20M_gc);
68 | _PROTECTED_WRITE(CLKCTRL.MCLKCTRLB, CLKCTRL_PDIV_6X_gc |
| CLKCTRL_PEN_bm); // Prescaler of 6
69 | // F_CPU with this configuration will be 3.33MHz
70 | }
71
72 | void SetupPins()
73 | {
74 | PORTA.DIR |= PIN4_bm | PIN5_bm | PIN6_bm | PIN7_bm;
75 | }
76
77 | void digitalWrite(uint8_t pin, uint8_t value)
78 | {
79 | if (value == LOW)
80 | {
81 | PORTA.OUTCLR = pin;
82 | }
83 | else
84 | {
85 | PORTA.OUTSET = pin;
86 | }
87 | }
88
89 | void stepperMotorStep(uint8_t step)
90 | {
91 | //This is basically from the datasheet
| http://eeshop.unl.edu/pdf/Stepper+Driver.pdf
92 | //Made the digitalWrite function to keep it inline.
93 | switch (step)

40

94 | {
95 | case 0:
96 | digitalWrite(PIN4_bm, LOW);
97 | digitalWrite(PIN5_bm, LOW);
98 | digitalWrite(PIN6_bm, LOW);
99 | digitalWrite(PIN7_bm, HIGH);
100 | break;
101 | case 1:
102 | digitalWrite(PIN4_bm, LOW);
103 | digitalWrite(PIN5_bm, LOW);
104 | digitalWrite(PIN6_bm, HIGH);
105 | digitalWrite(PIN7_bm, HIGH);
106 | break;
107 | case 2:
108 | digitalWrite(PIN4_bm, LOW);
109 | digitalWrite(PIN5_bm, LOW);
110 | digitalWrite(PIN6_bm, HIGH);
111 | digitalWrite(PIN7_bm, LOW);
112 | break;
113 | case 3:
114 | digitalWrite(PIN4_bm, LOW);
115 | digitalWrite(PIN5_bm, HIGH);
116 | digitalWrite(PIN6_bm, HIGH);
117 | digitalWrite(PIN7_bm, LOW);
118 | break;
119 | case 4:
120 | digitalWrite(PIN4_bm, LOW);
121 | digitalWrite(PIN5_bm, HIGH);
122 | digitalWrite(PIN6_bm, LOW);
123 | digitalWrite(PIN7_bm, LOW);
124 | break;
125 | case 5:
126 | digitalWrite(PIN4_bm, HIGH);
127 | digitalWrite(PIN5_bm, HIGH);
128 | digitalWrite(PIN6_bm, LOW);
129 | digitalWrite(PIN7_bm, LOW);
130 | break;
131 | case 6:
132 | digitalWrite(PIN4_bm, HIGH);
133 | digitalWrite(PIN5_bm, LOW);
134 | digitalWrite(PIN6_bm, LOW);
135 | digitalWrite(PIN7_bm, LOW);
136 | break;
137 | case 7:
138 | digitalWrite(PIN4_bm, HIGH);
139 | digitalWrite(PIN5_bm, LOW);
140 | digitalWrite(PIN6_bm, LOW);
141 | digitalWrite(PIN7_bm, HIGH);
142 | break;

41

143 | }
144 | }
145
146 | void I2C_RX_Callback(uint8_t com)
147 | {
148 | if (com == STOP)
149 | {
150 | state = STOP;
151 | }
152 | else if (com == FORWARD)
153 | {
154 | state = FORWARD;
155 | }
156 | else if (com == BACKWARD)
157 | {
158 | state = BACKWARD;
159 | }
160 | else
161 | {
162 | state = STOP;
163 | }
164 | }
165
166 | uint8_t I2C_TX_Callback(void)
167 | {
168 | //Not used, but needed for SlaveInit
169 | }

42

# Appendix E

# TWI Library Code

TWI.h

1 | #ifndef TWI_H
2 | #define TWI_H
3
4 | #include <avr/io.h>
5 | #include <avr/interrupt.h>
6 | #include <stddef.h>
7
8 | /*
9 | * Macros used to help calculate the BAUD rate for the TWI/I2C
| Protocol.
10 | *
11 | * The formulas can be found on the datasheet.
12 | */
13 | //only if not defined.
14 | #ifndef F_CPU
15 | #define F_CPU 3333333UL
16 | #endif
17 | #define TWI_FREQ 100000UL //1MHz
18 | #define TWI_BAUD(F_SCL, T_RISE) ((((F_CPU / (F_SCL)) - 10) /
2) - (T_RISE / 2))
19
20 | /*
21 | * Callback functions for the Slave initialisation of the
| protocol. This will be
22 | * called by the ISR for Slave received requests so the code
| that implements this
23 | * library can provide functionality without having to
| customise the library itself,
24 | * and call helper functions outside the scope of the library.
25 | */
26 | typedef void (*I2C_ReceiveCallback)(uint8_t data);
27 | typedef uint8_t (*I2C_TransmitCallback)(void);
28
| 43

29 | // TWI/I2C Master functions
30 | /**
31 | * This function initialises the TWI/I2C Protocol on a device
designated as the master
32 | * where it will be able to specify and send requests to the
connected slave devices.
33 | */
34 | void TWI_Master_Init(void);
35
36 | /**
37 | * This function will try to force the TWI protocol back into
its starting state.
38 | * This is to stop an issue where repeated requests are
crashing the device.
39 | */
40 | void TWI_Master_Reset(void);
41
42 | /**
43 | * This function will put the protocol in a state where it is
able to either read or
44 | * write data. It will target a slave, and specify if its a
read or write operation.
45 | *
46 | * Read | 0x01
47 | * Write | 0x00
48 | *
49 | * @param address | The Slave address to be contacted
50 | * @param read | The mode of operation (Read, Write)
51 | */
52 | void TWI_Master_Start(uint8_t address, uint8_t read);
53
54 | /**
55 | * This function will perform the Write operation. The function
will write data to the
56 | * MDATA buffer which should transfer to the Slave.
57 | *
58 | * At the moment, this library will only really send a single
uint8_t (one byte) of
59 | * data.
60 | *
61 | * @param data | Data to be sent.
62 | */
63 | void TWI_Master_Write(uint8_t data);
64
65 | /**
66 | * This function will read from the MDATA buffer for data sent
from the Slave on Read
67 | * operations. The device will then send an ACK (0) to confirm
it is ready for more

44

68 | * data.
69 | *
70 | * @return | Data received from the Slave
71 | */
72 | uint8_t TWI_Master_Read_ACK(void);
73
74 | /**
75 | * This function will read from the MDATA buffer for data sent
from the Slave on Read
76 | * operations. The device will then send an NACK (1) to tell
the Slave it can’t accept
77 | * more data.
78 | *
79 | * @return | Data received from the Slave
80 | */
81 | uint8_t TWI_Master_Read_NACK(void);
82
83 | /**
84 | * This function issues a stop command to the protocol to cease
| transmissions.
85 | *
86 | * This should then put the bus in an IDLE state.
87 | */
88 | void TWI_Master_Stop(void);
89
90 | // I2C Slave functions
91 | /**
92 | * This function will initialise the I2C Protocol on Slave
devices. It will set the
93 | * address to the SADDR buffer, and set the callback functions
so they can be called
94 | * by the ISR when an address is confirmed and the mode of
operation is identified.
95 | *
96 | * In Read operations the data should be returned by the TX
callback function so the ISR
97 | * can pick it up and continue. In the current state we can’t
just leave this function hanging.
98 | * It MUST return a value that will be sent so we can’t rely on
interrupts to populate a value.
99 | *
100 | * In Write operations the data from the Master will be sent to
the RX callback function.
101 | * @param address | The address of the Slave device. Requests
from the Master will work on this device.
102 | * @param | The RX Callback function
103 | * @param | The TX Callback function
104 | */
105 | void TWI_Slave_Init(uint8_t address, I2C_ReceiveCallback,

45

I2C_TransmitCallback);
106
107 | /**
108 | * This function will send data to the Master device. It will
write data to the SDATA
109 | * buffer which will be transmitted to the Master.
110 | *
111 | * @param data | The data to be sent
112 | */
113 | void TWI_Slave_Write(uint8_t data);
114
115 | /**
116 | * This function will read data from the Master device. It will
get the data sent by
117 | * reading from the SDATA buffer.
118 | *
119 | * @return | The received data
120 | */
121 | uint8_t TWI_Slave_Read(void);
122
123 | /**
124 | * Same as above but explicitly sends ACK
125 | * @return
126 | */
127 | uint8_t TWI_Slave_Read_ACK(void);
128
129 | /**
130 | * Same as above but explicitly sends NACK and Transaction
Complete command.
131 | * @return
132 | */
133 | uint8_t TWI_Slave_Read_NACK(void);
134
135 | #endif // TWI_H

46

TWI.c

1 | #include "TWI.h"
2
3 | /* Initialize TWI/I2C master - TWI is AVR version that
| supports I2C since I2C is a
4 | * protocol made by Phillips and supported by many MCUs.
5 | *
6 | * This library is developed using the datasheet and the Make:
| AVR Programming book
7 | * with some reference to libraries such as
| https://github.com/technoblogy/tiny-i2c
8 | *
9 | * Finding code examples online is a challenge and they need to
| be adapted because
10 | * the ATTiny1627 is not widely used as say anything from the
| ATMega line. Typically
11 | * users of the Tiny series use chips such as the ATTiny45 or
| similar that comes in a
12 | * DIP (breadboard friendly) packaging.
13 | *
14 | * Also alot of the existing libraries are focused towards
| Arduino which I’m trying
15 | * to move away from.
16 | */
17
18 | void TWI_Master_Init(void)
19 | {
20 | /* Set the TWI baud rate
21 | * This calculation should for the ATTiny1627 on standard
| speed come to ~12
22 | * but because the way C handles float conversion to uint8,
| the fractional is dropped
23 | * and the result rounded down. So we’re adding one at the
| end to combat this.
24 | */
25 | TWI0.MBAUD = (uint8_t)TWI_BAUD(TWI_FREQ, 0) + 1; // Adding
| 1 as it is rounding down
26
27 | /* Enable TWI master and Smart Mode
28 | * Smart mode will automatically raise the DIF, RIF and WIF
| interrupt flags when
29 | * reading from and or writing to the MDATA, SDATA and MADDR
| buffers. This takes
30 | * a fair bit of the work out of our hands, but may raise
| some issues when we come
31 | * to ending the Read operation as the Master should send a
| NACK to RXACK with a
32 | * stop condition to end the operation.

47

33 | */
34 | TWI0.MCTRLA |= TWI_ENABLE_bm | TWI_SMEN_bm;
35
36 | /**
37 | * Writing to the Flush bit on the MCTRLB register will
| | flush any errors or bus busy states
38 | * try to force the protocol into IDLE. Since in this
| | implementation we only have
39 | * one Master, this should work but I’ve never writen a
| | protocol from scratch before
40 | * so I guess we’ll find out..
41 | */
42 | TWI0.MCTRLB |= TWI_FLUSH_bm; // Flush TWI data
43
44 | // Explicitly set the bus state to IDLE.
45 | TWI0.MSTATUS = TWI_BUSSTATE_IDLE_gc;
46
47 | // Enable the Master Write Interrupt and Master Read
| | Interrupt
48 | TWI0.MCTRLA |= TWI_WIEN_bm | TWI_RIEN_bm;
49
50 | /**
51 | * Because some implementations of this library may not need
| | Interrupts (Motor
52 | * Controller is a key suspect here), we should enable
| | Interrupts so code in this
53 | * library will still work.
54 | */
55 | sei();
56 | }
57
58 | void TWI_Master_Reset(void)
59 | {
60 | // Disable TWI by writing a zero to the enable bit
61 | TWI0.MCTRLA &= ~TWI_ENABLE_bm;
62
63 | // Clear status registers to reset the state
64 | TWI0.MSTATUS |= TWI_BUSERR_bm | TWI_ARBLOST_bm |
| | TWI_RXACK_bm | TWI_COLL_bm | TWI_BUSSTATE_IDLE_gc;
65 | // | TWI0.MCTRLB |= TWI_FLUSH_bm; // Flush TWI
66
67 | // Re-enable TWI
68 | TWI0.MCTRLA |= TWI_ENABLE_bm;
69 | }
70
71 | void TWI_Master_Start(uint8_t address, uint8_t read)
72 | {
73 | TWI0.MADDR = (address << 1) | read;
74 | //Wait for the address transmission to complete. When the

48

address is confirmed
75 | //by the slave, the WIF or RIF flags will be raised.
76 | while (!(TWI0.MSTATUS & (TWI_RIF_bm | TWI_WIF_bm)));
77 | }
78
79 | void TWI_Master_Write(uint8_t data)
80 | {
81 | TWI0.MDATA = data;
82
83 | //Wait for the WIF to become high. Writing data will set it
low (Smart mode),
84 | //When the Slave receives it will be set back to high.
85 | while (!(TWI0.MSTATUS & TWI_WIF_bm));
86
87 | // Check for arbitration lost or bus error
88 | if (TWI0.MSTATUS & (TWI_ARBLOST_bm | TWI_BUSERR_bm)) {
89 | | // Handle error
90 | | TWI0.MCTRLB = TWI_FLUSH_bm;
91 | | TWI0.MSTATUS = TWI_BUSSTATE_IDLE_gc;
92 | }
93 | }
94
95 | uint8_t TWI_Master_Read_ACK(void)
96 | {
97 | // | //Temporarily Disable SM
98 | // | TWI0.MCTRLA &= ~TWI_SMEN_bm;
99 | //Prime the MCTRLB with the ACK bit
100 | TWI0.MCTRLB = TWI_ACKACT_ACK_gc;
101
102 | //Wait till the device has received data
103 | while (!(TWI0.MSTATUS & TWI_RIF_bm));
104
105 | //return the data from the buffer. Smart mode should then
| | send the ACK bit and
106 | //clear the relevant flags.
107 | return TWI0.MDATA;
108 | }
109
110 | uint8_t TWI_Master_Read_NACK(void)
111 | {
112 | //Temporarily Disable SM
113 | // | TWI0.MCTRLA &= ~TWI_SMEN_bm;
114
115 | //Prime the MCTRLB with the NACK bit
116 | TWI0.MCTRLB = TWI_ACKACT_NACK_gc;
117
118 | //Wait till the device has received the data
119 | while (!(TWI0.MSTATUS & TWI_RIF_bm));
120

49

121 | TWI0.MCTRLB |= TWI_MCMD_STOP_gc;
122 | //Return the data from the buffer. Smart mode should then
send the NACK bit
123 | //and clear the relevant flags
124 | uint8_t data = TWI0.MDATA;
125
126 | // | TWI0.MCTRLB |= TWI_MCMD_STOP_gc;
127
128 | //Renable SM
129 | // | TWI0.MCTRLA |= TWI_SMEN_bm;
130
131 | // | return TWI0.MDATA;
132 | return data;
133 | }
134
135 | /**
136 | * DO NOT CALL ARBITRARILY. THIS COULD PUT THE BUS IN AN ERROR
STATE.
137 | */
138 | void TWI_Master_Stop(void) {
139 | TWI0.MCTRLB = TWI_MCMD_STOP_gc;
140 | // | TWI0.MSTATUS = TWI_BUSSTATE_IDLE_gc;
141 | }
142
143 | // Global variable to store the receive callback function
144 | static I2C_ReceiveCallback receive_callback = NULL;
145 | static I2C_TransmitCallback transmit_callback = NULL;
146
147 | void TWI_Slave_Init(uint8_t address, I2C_ReceiveCallback rx,
I2C_TransmitCallback tx)
148 | {
149 | //Assign the RX and TX callback functions so they can be
| | accessed by this script (raise their scope).
150 | receive_callback = rx;
151 | transmit_callback = tx;
152
153 | // Set the slave address. << 1 as the first bit is for
| | enabling broadcast mode on 0x00
154 | TWI0.SADDR = address << 1;
155
156 | // Enable TWI slave and various interrupts. Also Smart Mode.
157 | TWI0.SCTRLA |= TWI_ENABLE_bm | TWI_SMEN_bm | TWI_DIEN_bm |
| | TWI_APIEN_bm | TWI_PIEN_bm;
158
159 | sei();
160 | }
161
162 | void TWI_Slave_Write(uint8_t data) {
163 | //Write the data to the buffer to send to the Master. This

50 should clear the DIF interrupt.
164 | TWI0.SDATA = data;
165
166 | //When the Master has received the data the DIF interrupt
should be high again.
167 | while (!(TWI0.SSTATUS & TWI_DIF_bm));
168
169 | if (TWI0.SSTATUS & TWI_RXACK_bm)
170 | {
171 | | //Master send dobby an NACK. END TRANSMISSION
172 | | TWI0.SCTRLB |= TWI_SCMD_COMPTRANS_gc;
173 | }
174
175 | // Clear the DIF
176 | // | TWI0.SSTATUS |= TWI_DIF_bm;
177
178 | }
179
180 | uint8_t TWI_Slave_Read(void) {
181 | //Wait for the data to be ready.
182 | while (!(TWI0.SSTATUS & TWI_DIF_bm));
183
184 | //Read the data from the buffer
185 | uint8_t data = TWI0.SDATA;
186
187 | // Clear the data interrupt flag
188 | //THIS SHOULDNT BE REQUIRED BECAUSE SMART MODE.
189 | // | TWI0.SSTATUS |= TWI_DIF_bm;
190
191
192 | return data;
193 | }
194
195 | uint8_t TWI_Slave_Read_ACK(void) {
196 | // Wait for the data to be ready
197 | while (!(TWI0.SSTATUS & TWI_DIF_bm));
198
199 | // Read the data from the buffer
200 | uint8_t data = TWI0.SDATA;
201
202 | // Send ACK after receiving data
203 | TWI0.SCTRLB = TWI_ACKACT_ACK_gc;
204
205 | return data;
206 | }
207
208 | uint8_t TWI_Slave_Read_NACK(void) {
209 | // Wait for the data to be ready
210 | while (!(TWI0.SSTATUS & TWI_DIF_bm));

51

211
212 | // | Send NACK after receiving data
213 | TWI0.SCTRLB = TWI_ACKACT_NACK_gc;
214
215 | return TWI0.SDATA;
216 | }
217
218 | /**
219 | * Interrupt Service Routines
220 | *
221 | * This is how the Slave will begin responding to the requests.
222 | *
223 | * First it will check the address. AP is an address match.
Clearing the flag will
224 | * trigger the Master to begin its operation.
225 | *
226 | * DIF is raised when data is received or Master is ready to
receive. the DIR register bit
227 | * will identify which mode of operation it is.
228 | */
229 | ISR(TWI0_TWIS_vect)
230 | {
231 | // Check if Address/Stop interrupt
232 | // | if (TWI0.SSTATUS & TWI_APIF_bm) {
233 | // | // Clear the interrupt flag
234 | // | TWI0.SSTATUS |= TWI_APIF_bm;
235 | // | // Check if the address match
236 | // | if (TWI0.SSTATUS & TWI_AP_bm) {
237 | // | // Clear the address match flag
238 | // | TWI0.SSTATUS |= TWI_AP_bm;
239 | // | }
240 | // | }
241 | // Check if Address/Stop interrupt
242 | if (TWI0.SSTATUS & TWI_APIF_bm)
243 | {
244 | // Clear the interrupt flag
245 | TWI0.SSTATUS = TWI_APIF_bm;
246
247 | // Check if the address match
248 | if (TWI0.SSTATUS & TWI_AP_bm)
249 | {
250 | // Clear the address match flag
251 | TWI0.SSTATUS = TWI_AP_bm;
252 | TWI0.SCTRLB = TWI_SCMD_RESPONSE_gc;
253 | }
254 | // | else
255 | // | {
256 | // | // If not an address match, it must be a
stop condition

52

257 | // | TWI0.SCTRLB = TWI_SCMD_COMPTRANS_gc;
258 | // | }
259 | }
260
261 | // Check if Data interrupt
262 | if (TWI0.SSTATUS & TWI_DIF_bm) {
263 | // Check if data was requested (read operation)
264 | if (TWI0.SSTATUS & TWI_DIR_bm) {
265 | //Get the data from the callback function passed in in
| | initialisation.
266 | //Should handle cases where this is NULL. but eh. Not
| | for this this implementation.
267 | uint8_t data_to_send = transmit_callback();
268 | TWI_Slave_Write(data_to_send); // Example data
269 | } else {
270 | //Read the received data.
271 | uint8_t received_data = TWI_Slave_Read_NACK();
272 | //Send the data to the callback function
273 | receive_callback(received_data);
274 | }
275
276 | TWI0.SSTATUS |= TWI_DIF_bm;
277 | }
278 | }

53

# Appendix F

# Sonar Schematics

Transmitter

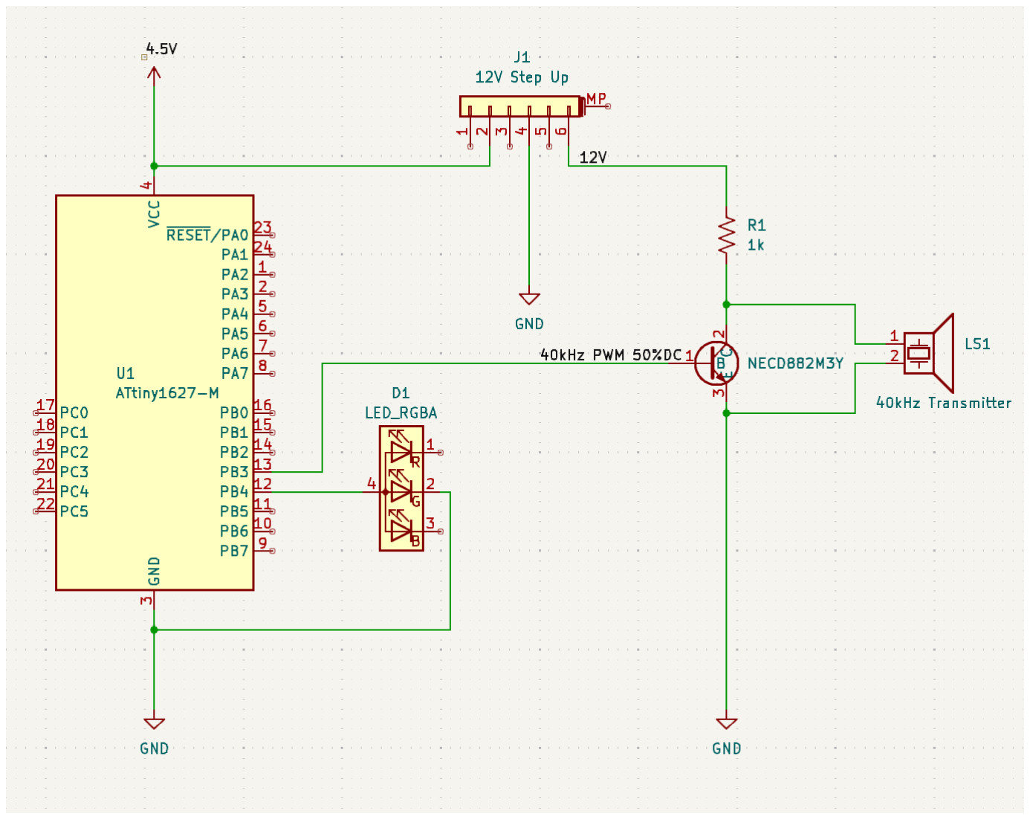
[picture p46: figure]

54

Receiver


55

# Appendix G

# Depth Controller

1 | /**
2 | * This is the depth controller for the submarine.
3 | *
4 | * This is a stepper motor connected to a convertor of my own
| design to convert
5 | * linear to rotary force. Its basically a screw connected to a
| large nut with a housing for the syringe
6 | * plunger.
7 | *
8 | * So basically this controller needs to control the stepper
| motor in two directions (forward
9 | * and reverse), and also make sure the motor does not turn
| beyond a certain point in either direction.
10 | *
11 | * Basically we need a way to track the position of the nut.
12 | */
13
14 | //Lets get the basics out the way.
15 | #define F_CPU 3333333UL
16 | #include <avr/io.h>
17 | #include <util/delay.h>
18 | #include <avr/interrupt.h>
19
20 | void MainClkCtrl(void);
21
22 | /**
23 | * Need a way to track the position. I’m thinking an array. As
| the motor turns,
24 | * every second or so we can either increment or decrement the
| array based on direction.
25 | *
26 | * If the array is at the start of end, we can’t progress. It
| would be neat. As long
27 | * as theres no reset of the device.
| 56

28 | *
29 | * Option 2 would be a wire and a contact plate so we know
| where at the start or the
30 | * end of the rail.
31 | *
32 | * I think both. So in cases where the device has no power at
| non-start or stop position its
33 | * reference isn’t completely lost.
34 | *
35 | * To traverse the array we’ll have a Timer Counter that will
| increment the index after a
36 | * set period
37 | */
38 | volatile uint8_t pos[30];
39 | void PosSetup(void);
40 | void BufferSetup(void);
41 | void RTCSetup(void);
42 | void PosDec(void);
43 | void PosInc(void);
44
45 | /*
46 | * Motor driver. We can steal this from the midterm prototype.
| which in itself was
47 | * stolen from some forum describing how to use stepper motors
| with arduino. I think it
48 | * was the original stepper motor datasheet but this was a
| while ago. - I just read its
49 | * comments. It was from the datasheet
50 | *
51 | * So we need a digital write function
52 | *
53 | * We also need to rejig the pins its using.
54 | *
55 | * And have a setup function to setup the pins
56 | */
57 | void MotorSetup(void);
58 | void StepperMotorStep(int8_t);
59 | void digitalWrite(uint8_t, uint8_t);
60 | #define HIGH 0x01
61 | #define LOW 0x00
62 | //Contols the step
63 | volatile int8_t step = 1; //needs to be signed so it can slip
| into negative values
64
65 | /**
66 | * Need a way to control the direction. We’ll use some
| constants and a direction variable
67 | *
68 | * There are 3 possible directions. UP, DOWN and NONE

57

69 | */
70 | #define UP 0
71 | #define NONE 1
72 | #define DOWN 2
73 | volatile uint8_t dir = 2;
74
75 | int main(void)
76 | {
77 | MainClkCtrl();
78 | PosSetup();
79 | BufferSetup();
80
81 | MotorSetup();
82
83 | sei();
84
85 | while(1)
86 | {
87 | //1 is the marker number. If the element is 1, it means
| the device thinks the
88 | //nut is in that position. so we won’t go any further.
89 | if (dir == UP && pos[29] != 1)
90 | {
91 | StepperMotorStep(step);
92 | step--;
93 | }
94 | else if (dir == DOWN && pos[0] != 1)
95 | {
96 | StepperMotorStep(step);
97 | step++;
98 | }
99
100 | //Keep the step in bounds
101 | if(step > 0x07)
102 | {
103 | step = 0x00;
104 | }
105
106 | if(step < 0x00)
107 | {
108 | step = 0x07;
109 | }
110
111 | _delay_us(750); //controls the speed. Adjust as needed.
112 | }
113
114 | return 0;
115 | }
116

58

117 | /**
118 | * I think I’ve mentioned this in a previous part. This MCU has
a default clock speed
119 | * of 3.33MHz. (20MHz with a default prescaler of 6). These
settings are fine so we’re
120 | * just going to make it explicit.
121 | */
122 | void MainClkCtrl(void)
123 | {
124 | _PROTECTED_WRITE(CLKCTRL.MCLKCTRLA,
| | CLKCTRL_CLKSEL_OSC20M_gc | CLKCTRL_CLKOUT_bm);
125 | _PROTECTED_WRITE(CLKCTRL.MCLKCTRLB, CLKCTRL_PDIV_6X_gc |
| | CLKCTRL_PEN_bm);
126 | }
127
128 | /*
129 | * Basically we’re going to 0 the array and make the midpoint
(512) 1.
130 | * It will sort itself out in travel with the buffer
131 | */
132 | void PosSetup(void)
133 | {
134 | for (int i = 0; i < 30; i++)
135 | {
136 | | pos[i] = 0;
137 | }
138 | pos[15] = 1;
139 | }
140
141 | /**
142 | Buffer setup is the setup function for the start/stop plate we
can use to reset the array to
143 | * make sure we don’t go out of bounds.
144 | */
145 | void BufferSetup(void)
146 | {
147 | //Pins to avoid are 15(PB1) and 16(PB0) as these are SDA
| | and SCL respectively.
148 | //also 23 (PA0) is the UPDI pin.
149
150 | //Going to use 6(PA5), 7(PA6). These need to be inputs to
| | detect voltage
151 | // | PORTA.DIR &= ~(PIN5_bm | PIN6_bm);
152 | PORTA.DIR &= ~(PIN5_bm);
153 | PORTA.DIR &= ~(PIN6_bm);
154 | // | PORTA.IN |= PIN5_bm | PIN6_bm;
155
156 | //Gonna need the interrupts on these
157 | //Because these pins are floating they need a pullup.

59

158 | PORTA.PIN5CTRL |= PORT_PULLUPEN_bm | PORT_ISC_RISING_gc;
159 | PORTA.PIN6CTRL |= PORT_PULLUPEN_bm | PORT_ISC_RISING_gc;
160 | }
161
162 | /**
163 | * Setup the RTC to count periods of time to control the motor
| position
164 | */
165 | void RTCSetup(void)
166 | {
167
168 | }
169
170 | /**
171 | * Pos mover.
172 | */
173 | void PosDec(void)
174 | {
175 | int index = 0;
176 | for (int i = 0; i < 30; i++)
177 | {
178 | if (pos[i] == 1)
179 | {
180 | index = i;
181 | }
182 | pos[i] = 0;
183 | }
184 | pos[index - 1] = 1;
185 | }
186 | void PosInc(void)
187 | {
188 | int index = 0;
189 | for (int i = 0; i < 30; i++)
190 | {
191 | if (pos[i] == 1)
192 | {
193 | index = i;
194 | }
195 | pos[i] = 0;
196 | }
197 | pos[index + 1] = 1;
198 | }
199
200 | /**
201 | * Need to setup the pins for the stepper motor. Because of the
| digital write function
202 | * we need to keep them on the same port.
203 | *
204 | * We’ll use port c.

60

205 | * 17 - PC0
206 | * 18 - PC1
207 | * 19 - PC2
208 | * 20 - PC3
209 | */
210 | void MotorSetup(void)
211 | {
212 | PORTC.DIR |= PIN0_bm | PIN1_bm | PIN2_bm | PIN3_bm;
213 | }
214
215 | /*
216 | * This function will drive the stepper motor. The sequance
| depends on the step
217 | */
218 | void StepperMotorStep(int8_t step)
219 | {
220 | //This is basically from the datasheet
| http://eeshop.unl.edu/pdf/Stepper+Driver.pdf
221 | //Made the digitalWrite function to keep it inline.
222 | switch (step)
223 | {
224 | case 0:
225 | digitalWrite(PIN0_bm, LOW);
226 | digitalWrite(PIN1_bm, LOW);
227 | digitalWrite(PIN2_bm, LOW);
228 | digitalWrite(PIN3_bm, HIGH);
229 | break;
230 | case 1:
231 | digitalWrite(PIN0_bm, LOW);
232 | digitalWrite(PIN1_bm, LOW);
233 | digitalWrite(PIN2_bm, HIGH);
234 | digitalWrite(PIN3_bm, HIGH);
235 | break;
236 | case 2:
237 | digitalWrite(PIN0_bm, LOW);
238 | digitalWrite(PIN1_bm, LOW);
239 | digitalWrite(PIN2_bm, HIGH);
240 | digitalWrite(PIN3_bm, LOW);
241 | break;
242 | case 3:
243 | digitalWrite(PIN0_bm, LOW);
244 | digitalWrite(PIN1_bm, HIGH);
245 | digitalWrite(PIN2_bm, HIGH);
246 | digitalWrite(PIN3_bm, LOW);
247 | break;
248 | case 4:
249 | digitalWrite(PIN0_bm, LOW);
250 | digitalWrite(PIN1_bm, HIGH);
251 | digitalWrite(PIN2_bm, LOW);

61

252 | digitalWrite(PIN3_bm, LOW);
253 | break;
254 | case 5:
255 | digitalWrite(PIN0_bm, HIGH);
256 | digitalWrite(PIN1_bm, HIGH);
257 | digitalWrite(PIN2_bm, LOW);
258 | digitalWrite(PIN3_bm, LOW);
259 | break;
260 | case 6:
261 | digitalWrite(PIN0_bm, HIGH);
262 | digitalWrite(PIN1_bm, LOW);
263 | digitalWrite(PIN2_bm, LOW);
264 | digitalWrite(PIN3_bm, LOW);
265 | break;
266 | case 7:
267 | digitalWrite(PIN0_bm, HIGH);
268 | digitalWrite(PIN1_bm, LOW);
269 | digitalWrite(PIN2_bm, LOW);
270 | digitalWrite(PIN3_bm, HIGH);
271 | break;
272 | }
273 | }
274 | void digitalWrite(uint8_t pin, uint8_t value)
275 | {
276 | if (value == LOW)
277 | {
278 | PORTC.OUTCLR = pin;
279 | }
280 | else
281 | {
282 | PORTC.OUTSET = pin;
283 | }
284 | }
285
286 | ISR(PORTA_PORT_vect)
287 | {
288 | //Two pins that could trigger this. Need to handle each one
| differently
289 | //5 We’ll have as the near end
290 | if (PORTA.INTFLAGS & PIN5_bm) {
291 | //I know normally we would use the size of the array but
| in c we need to calculate this.
292 | //Its sizeof the array / sizeof the first element. We
| know the size and its not going to change.
293 | //so we’ll just use that..
294 | if (pos[29] != 1)
295 | {
296 | for (int i = 0; i < 30; i++)
297 | {

62

298 | pos[i] = 0;
299 | }
300 | pos[29] = 1;
301 | }
302
303 | //Clear the flag so it can be raised in the future
304 | PORTA.INTFLAGS = PIN5_bm;
305 | }
306
307 | if (PORTA.INTFLAGS & PIN6_bm) {
308 | if (pos[1] != 1)
309 | {
310 | for (int i = 0; i < 30; i++)
311 | {
312 | pos[i] = 0;
313 | }
314 | pos[0] = 1;
315 | }
316
317 | //Clear the flag so it can be raised in the future
318 | PORTA.INTFLAGS = PIN6_bm;
319 | }
320 | }

63

# Appendix H

# Pseudocode

H.1 | Depth Controller v1
1 | /*
2 | So this is v1 before connection to any i2c controller.
3 | We are going to use a button to stop start, let it travel
| to the end and go back. Should be very simple.
4
5 | This is pseudocode so its not going to be precise in terms
| of memory addresses.
6
7 | blocks of ISR are Interrupt Service Routines so will be
| triggered by events of the peripherals. For simplicity
| we will skip over things like interrupt flags etc.
8 | */
9
10 | //Going to track the position of the plunger nut along the
| screw
11 | //we can do this with a simple integer. 0 - 255
12 | int plungerPos = 0 //fully in.
13
14 | //Also need a direction
15 | int OUT = 1
16 | int IN = 2
17 | int dir = OUT
18
19 | //Also need a start/stop condition.
20 | int START = 1
21 | int STOP = 0
22 | int move = STOP
23
24 | function main() {
25 | setup()
26

64

27 | int step = 0
28 | //main infinite loop
29 | while(1) {
30 | if (move == START) {
31 | //Make sure we don’t over extend
32 | if (dir == OUT && plungerPos != 255) &&
33 | (dir == IN && plungerPos != 0) {
34 | stepper(step)
35
36 | if (dir == IN) {
37 | step--
38 | } else {
39 | step++
40 | }
41
42 | //make sure the step is in range
43 | if (step < 0) {
44 | step = 7
45 | }
46 | if (step > 7) {
47 | step = 0
48 | }
49 | }
50 | }
51 | }
52 | }
53
54 | //function to move the stepper motor.
55 | //This is repetitive and the code is known. Its basically
56 | //a switch statement turning various pins for the stepper
| motor on and //off.
57 | function stepper(int step) {
58 | switch (step)
59 | {
60 | case 0:
61 | STEP_PIN_1 = LOW
62 | STEP_PIN_2 = LOW
63 | STEP_PIN_3 = LOW
64 | STEP_PIN_4 = HIGH
65 | break
66 | case 1:
67 | STEP_PIN_1 = LOW
68 | STEP_PIN_2 = LOW
69 | STEP_PIN_3 = HIGH
70 | STEP_PIN_4 = HIGH
71 | break
72 | case 2:
73 | STEP_PIN_1 = LOW
74 | STEP_PIN_2 = LOW

65

75 | STEP_PIN_3 = HIGH
76 | STEP_PIN_4 = LOW
77 | break
78 | case 3:
79 | STEP_PIN_1 = LOW
80 | STEP_PIN_2 = HIGH
81 | STEP_PIN_3 = HIGH
82 | STEP_PIN_4 = LOW
83 | break
84 | case 4:
85 | STEP_PIN_1 = LOW
86 | STEP_PIN_2 = HIGH
87 | STEP_PIN_3 = LOW
88 | STEP_PIN_4 = LOW
89 | break
90 | case 5:
91 | STEP_PIN_1 = HIGH
92 | STEP_PIN_2 = HIGH
93 | STEP_PIN_3 = LOW
94 | STEP_PIN_4 = LOW
95 | break
96 | case 6:
97 | STEP_PIN_1 = HIGH
98 | STEP_PIN_2 = LOW
99 | STEP_PIN_3 = LOW
100 | STEP_PIN_4 = LOW
101 | break
102 | case 7:
103 | STEP_PIN_1 = HIGH
104 | STEP_PIN_2 = LOW
105 | STEP_PIN_3 = LOW
106 | STEP_PIN_4 = HIGH
107 | break
108 | }
109 | }
110
111 | function setup() {
112 | setupRTC()
113 | setupPins()
114 | }
115
116 | /*
117 | pins to setup:
118 | Button to start/stop
119 | OUT buffer detection
120 | IN buffer detection
121
122 | Stepper Motor Pins
123 | */

66

124 | function setupPins() {
125 | BUTTON_PIN.DIR = IN
126 | BUFFER_OUT_PIN.DIR = IN
127 | BUFFER_IN_PIN.DIR = IN
128
129 | STEP_PIN_1 = OUT
130 | STEP_PIN_2 = OUT
131 | STEP_PIN_3 = OUT
132 | STEP_PIN_4 = OUT
133 | }
134
135 | //RTC should count to 5 seconds.
136 | function setupRTC() {
137 | //Timing is controlled with Clock and Period. with the
| standard //32k clock, the period for 5 seconds would
| need to be ~32000 * 5
138
139 | //32000 * 5 = 160000. Too big for 16 bit integer. so a
| prescaler //of 64 will be applied.
140
141 | //Could also select the 1k clock. Either are valid.
142 | RTC.CLKSEL = 32000 / 64
143
144 | //This makes the calc (32000/64) * 5 = 2500
145 | RTC.PER = 2500
146 | }
147
148 | //Function to enable the RTC. We should set the count to 0.
149 | function enableRTC() {
150 | RTC.CNT = 0
151 | RTC.ENABLE = 1
152 | }
153
154 | //function to disable the RTC
155 | function disableRTC() {
156 | RTC.ENABLE = 0
157 | }
158
159 | //ISR for the RTC Period so this code will trigger 5 seconds
| after RTC // has been enabled.
160 | ISR(RTC_Period) {
161 | if (dir == OUT) {
162 | //Add 1 tick per second. To be adjusted later
163 | plungerPos += 5
164 | }
165 | if (dir == IN) {
166 | //Remove 1 tick per second. To be adjusted
167 | plungerPos -= 5
168 | }

67

169 | }
170
171 | //ISRs for the Buffer detection
172 | ISR(BUFFER_OUT_PIN) {
173 | plungerPos = 255
174 | dir = IN
175 | }
176 | ISR(BUFFER_IN_PIN) {
177 | plungerPos = 0
178 | dir = OUT
179 | }
180
181 | //ISR for the Button Press
182 | ISR(BUTTON_PIN) {
183 | if (move == STOP) {
184 | enableRTC()
185 | move = START
186 | }
187 | else if (move == START) {
188 | disableRTC()
189 | move = STOP
190 | }
191 | }
H.2 | Sonar Module v1
1 | /*
2 | This version of the sonar module will just ping a sonar module
| using over the air calculations on button press. This way,
| when it comes to verification it works I can just hook up
| a debugger and stop the code on the lines calculating the
| total value.
3 | */
4
5 | //we need a variable to hold the distance.
6 | long count
7 | double distance
8
9
10 | //main function
11 | function main() {
12 | setup()
13
14 | while(1) {
15 | //main loop
16 | }
17 | }
| 68

18
19 | function setup() {
20 | setupPins()
21 | setupTCA()
22 | setupTCB()
23 | }
24
25 | /*
26 | We’re going to wire the echo pin from the ultrasonic to 2
| different pins: one for trigger, one for input. We’ll use
| 2 pins for the echo. One to sense the rising edge and one
| for the falling edge. We could do this in 1 isr looking
| for both edges but then we need to verify which edge it is
| before starting and stopping the counter.
27 | */
28 | function setupPins() {
29 | TRIGGER_PIN.DIR = OUT
30 | ECHO_PIN_RISING.DIR = IN
31 | ECHO_PIN_FALLING = IN
32
33 | //The temporary testing trigger.
34 | BUTTON_PIN.DIR = IN
35 | }
36
37 | //The TCA peripheral will be used to count the ticks between
| the rising //and falling edges of the ECHO pin
38 | function setupTCA() {
39 | TCA.PER = 0xFFFF //Maximum on the Period
40 | }
41 | //function to enable the TCA peripheral. Reset the Count
| buffer and start
42 | function enableTCA() {
43 | TCA.CNT = 0
44 | TCA.ENABLE = 1
45 | }
46 | //function to disable the TCA peripheral
47 | function disableTCA() {
48 | TCA.ENABLE = 0
49 | }
50
51 | //We need TCB to count to 10us
52 | function setupTCB() {
53 | //Need to convert the required time (10us) from seconds to
| ticks
54 | int period = (TCB.CLK / TCB.PRESCALER) * 10 / 1000000;
55 | TCB.PERIOD = period;
56 | }
57 | //Need to enable TCB and disable
58 | function enableTCB() {

69

59 | TCB.CNT = 0
60 | TCB.ENABLE = 1
61 | }
62 | function disableTCB() {
63 | TCB.ENABLE = 0
64 | }
65
66 | //We need a function to pull the trigger pin high for minimum
| of 10us
67 | function triggerSonar() {
68 | TRIGGER_PIN = HIGH
69 | enableTCB()
70 | }
71
72 | //function to calculate the distance
73 | function calcDistance(int ticks) {
74 | /*
75 | Speed of sound OTA is 343m/s. For cm this would be 34300
76
77 | distance = (time * SoS) / 2
78
79 | time is in ticks. We need to convert the ticks to a unit
| of time in seconds.
80
81 | time = ticks / (freq/prescaler)
82 | */
83 | double time = ticks / (F_CPU / TCA.PRESCALER)
84 | distance = (time * SOS) / 2
85 | }
86
87 | //Interrupt Service Routines
88 | //TCB for the trigger
89 | ISR(TCB) {
90 | disableTCB()
91 | TRIGGER_PIN = LOW
92 | }
93
94 | //The ultrasonic is calculated by using the time the Echo pin
| is held //high.
95 | ISR(ECHO_PIN_RISING) {
96 | enableTCA()
97 | }
98
99 | ISR(ECHO_PIN_FALLING) {
100 | disableTCA()
101 | int ticks = TCA.CNT
102 | calcDistance(ticks)
103 | }
104

70

105 | //Button press to trigger the whole ping cycle
106 | ISR(BUTTON_PIN) {
107 | triggerSonar()
108 | }
H.3 | Depth Controller v2
1 | /*
2 | Version 2 of the depth controller is building off of v1. We
| really need to refine the ability to travel along the
| mechanism to raise or lower the AUV.
3
4 | The final version of this module will be I2C connected, where
| the I2C Host sends this module a command with a position.
| So we’ll let the Host send a value between 0 and 255. 0 is
| fully surfaced, 255 is max depth (depending on testing
| this may need to be limited due to water pressure).
5
6 | So we need an algorithm to move to position. We’ll also remove
| the button press control from this version and replace it
| with I2C commands
7 | */
8
9 | //Going to track the position of the plunger nut along the
| screw
10 | //we can do this with a simple integer. 0 - 255
11 | int plungerPos = 125 //approximately halfway. The buffers will
| track the position
12 | //Also need a commanded position so the device knows where its
| going
13 | //Primed at the surface. This will mean before a command is
| received it should always //home in on home
14 | int commandedPos = 0
15
16 | //Also need a direction
17 | int OUT = 1
18 | int IN = 2
19 | int dir = OUT
20
21 | function main() {
22 | setup()
23
24 | int step = 0
25 | //main infinite loop
26 | while(1) {
27 | //Only move if the commanded position comparison is
| false.
| 71

28 | if (plungerPos != commandedPos) {
29 | //Make sure we don’t over extend
30 | if (dir == OUT && plungerPos != 255) {
31 | stepper(step)
32 | step--
33 | if (step < 0) {
34 | step = 7
35 | }
36 | }
37
38 | if (dir == IN && plungerPos != 0) {
39 | stepper(step)
40 | step++
41 | if (step > 7) {
42 | step = 0
43 | }
44 | }
45 | }
46 | }
47 | }
48
49 | //function to move the stepper motor.
50 | //This is repetitive and the code is known. Its basically
51 | //a switch statement turning various pins for the stepper
| motor on and //off.
52 | function stepper(int step) {
53 | switch (step)
54 | {
55 | case 0:
56 | STEP_PIN_1 = LOW
57 | STEP_PIN_2 = LOW
58 | STEP_PIN_3 = LOW
59 | STEP_PIN_4 = HIGH
60 | break
61 | case 1:
62 | STEP_PIN_1 = LOW
63 | STEP_PIN_2 = LOW
64 | STEP_PIN_3 = HIGH
65 | STEP_PIN_4 = HIGH
66 | break
67 | case 2:
68 | STEP_PIN_1 = LOW
69 | STEP_PIN_2 = LOW
70 | STEP_PIN_3 = HIGH
71 | STEP_PIN_4 = LOW
72 | break
73 | case 3:
74 | STEP_PIN_1 = LOW
75 | STEP_PIN_2 = HIGH

72

76 | STEP_PIN_3 = HIGH
77 | STEP_PIN_4 = LOW
78 | break
79 | case 4:
80 | STEP_PIN_1 = LOW
81 | STEP_PIN_2 = HIGH
82 | STEP_PIN_3 = LOW
83 | STEP_PIN_4 = LOW
84 | break
85 | case 5:
86 | STEP_PIN_1 = HIGH
87 | STEP_PIN_2 = HIGH
88 | STEP_PIN_3 = LOW
89 | STEP_PIN_4 = LOW
90 | break
91 | case 6:
92 | STEP_PIN_1 = HIGH
93 | STEP_PIN_2 = LOW
94 | STEP_PIN_3 = LOW
95 | STEP_PIN_4 = LOW
96 | break
97 | case 7:
98 | STEP_PIN_1 = HIGH
99 | STEP_PIN_2 = LOW
100 | STEP_PIN_3 = LOW
101 | STEP_PIN_4 = HIGH
102 | break
103 | }
104 | }
105
106 | function setup() {
107 | setupRTC()
108 | setupPins()
109 | }
110
111 | /*
112 | pins to setup:
113 | Button to start/stop
114 | OUT buffer detection
115 | IN buffer detection
116
117 | Stepper Motor Pins
118 | */
119 | function setupPins() {
120 | BUTTON_PIN.DIR = IN
121 | BUFFER_OUT_PIN.DIR = IN
122 | BUFFER_IN_PIN.DIR = IN
123
124 | STEP_PIN_1 = OUT

73

125 | STEP_PIN_2 = OUT
126 | STEP_PIN_3 = OUT
127 | STEP_PIN_4 = OUT
128 | }
129
130 | //RTC should count to 1 seconds. Each second will increase or
| decrese the
131 | function setupRTC() {
132 | //Timing is controlled with Clock and Period.
133
134 | //Could also select the 1k clock. Either are valid.
135 | RTC.CLKSEL = 32000 / 64
136
137 | //This makes the calc (32000/64) = 500
138 | RTC.PER = 500
139 | }
140
141 | //Function to enable the RTC. We should set the count to 0.
142 | function enableRTC() {
143 | RTC.CNT = 0
144 | RTC.ENABLE = 1
145 | }
146
147 | //function to disable the RTC
148 | function disableRTC() {
149 | RTC.ENABLE = 0
150 | }
151
152 | //ISR for the RTC Period so this code will trigger 5 seconds
| after RTC // has been enabled.
153 | ISR(RTC_Period) {
154 | if (dir == OUT) {
155 | //Add 1 tick per second. To be adjusted later
156 | plungerPos += 1
157 | }
158 | if (dir == IN) {
159 | //Remove 1 tick per second. To be adjusted
160 | plungerPos -= 1
161 | }
162 | }
163
164 | ISR(TWI) {
165 | int command = TWI.IN
166
167 | //Set the direction so the buffer stops from going out of
| bounds.
168 | if (command > plungerPos) {
169 | dir = OUT
170 | } else {

74

171 | dir = IN
172 | }
173
174 | //Setting the commandedPos should start the depth controller
175 | commandedPos = command
176 | }
177
178 | //ISRs for the Buffer detection
179 | ISR(BUFFER_OUT_PIN) {
180 | plungerPos = 255
181 | dir = IN
182 | }
183 | ISR(BUFFER_IN_PIN) {
184 | plungerPos = 0
185 | dir = OUT
186 | }
H.4 | Sonar Module v2
1 | /*
2 | Now we have a working calculation we are going to change the
| button trigger to an I2C trigger.
3 | */
4
5 | //we need a variable to hold the distance.
6 | long count
7 | double distance
8
9
10 | //main function
11 | function main() {
12 | setup()
13
14 | while(1) {
15 | //main loop
16 | }
17 | }
18
19 | function setup() {
20 | setupPins()
21 | setupTCA()
22 | setupTCB()
23 | }
24
25 | /*
26 | We’re going to wire the echo pin from the ultrasonic to 2
| different pins: one for trigger, one for input. We’ll use
| 75

2 pins for the echo. One to sense the rising edge and one for the falling edge. We could do this in 1 isr looking for both edges but then we need to verify which edge it is before starting and stopping the counter.
27 | */
28 | function setupPins() {
29 | TRIGGER_PIN.DIR = OUT
30 | ECHO_PIN_RISING.DIR = IN
31 | ECHO_PIN_FALLING = IN
32
33 | //The temporary testing trigger.
34 | BUTTON_PIN.DIR = IN
35 | }
36
37 | //The TCA peripheral will be used to count the ticks between
| the rising //and falling edges of the ECHO pin
38 | function setupTCA() {
39 | TCA.PER = 0xFFFF //Maximum on the Period
40 | }
41 | //function to enable the TCA peripheral. Reset the Count
| buffer and start
42 | function enableTCA() {
43 | TCA.CNT = 0
44 | TCA.ENABLE = 1
45 | }
46 | //function to disable the TCA peripheral
47 | function disableTCA() {
48 | TCA.ENABLE = 0
49 | }
50
51 | //We need TCB to count to 10us
52 | function setupTCB() {
53 | //Need to convert the required time (10us) from seconds to
| ticks
54 | int period = (TCB.CLK / TCB.PRESCALER) * 10 / 1000000;
55 | TCB.PERIOD = period;
56 | }
57 | //Need to enable TCB and disable
58 | function enableTCB() {
59 | TCB.CNT = 0
60 | TCB.ENABLE = 1
61 | }
62 | function disableTCB() {
63 | TCB.ENABLE = 0
64 | }
65
66 | //We need a function to pull the trigger pin high for minimum
| of 10us
67 | function triggerSonar() {

76

68 | TRIGGER_PIN = HIGH
69 | enableTCB()
70 | }
71
72 | //function to calculate the distance
73 | function calcDistance(int ticks) {
74 | /*
75 | Speed of sound OTA is 343m/s. For cm this would be 34300
76
77 | distance = (time * SoS) / 2
78
79 | time is in ticks. We need to convert the ticks to a unit of
| time in seconds.
80
81 | time = ticks / (freq/prescaler)
82 | */
83 | double time = ticks / (F_CPU / TCA.PRESCALER)
84 | distance = (time * SOS) / 2
85 | }
86
87 | //Interrupt Service Routines
88 | //TCB for the trigger
89 | ISR(TCB) {
90 | disableTCB()
91 | TRIGGER_PIN = LOW
92 | }
93
94 | //The ultrasonic is calculated by using the time the Echo pin
| is held //high.
95 | ISR(ECHO_PIN_RISING) {
96 | enableTCA()
97 | }
98
99 | ISR(ECHO_PIN_FALLING) {
100 | disableTCA()
101 | int ticks = TCA.CNT
102 | calcDistance(ticks)
103 | TWI.MDATA = distance
104 | }
105
106 | //Button press to trigger the whole ping cycle
107 | ISR(TWI) {
108 | triggerSonar()
109 | }
H.5 | Central Controller v1

77

1 | /*
2 | The central controller is the controller responsible for
| querying the sensor modules
3 | and sending instructions to the actuator modules based on
| the results received.
4 | */
5
6 | //We need to define the sensors. For now we’ll focus on the
| bottom only then iteratively add the rest.
7 | ULTRASONIC_BOTTOM = 0x08
8
9 | //And the actuators
10 | DEPTH_CONTROLLER = 0x09
11
12 | //We also need to track the current depth
13 | int depth = 0
14
15 | function main() {
16 | setup()
17
18 | //To start, this is a submarine so lets DIVE DIVE DIVE
19 | dive(255);
20
21 | while(1) {
22
23 | }
24
25 | return 0
26 | }
27
28 | function setup() {
29 | setupRTC()
30 | }
31
32 | //Need a function to query the sonar module and a function to
| handle the response.
33 | function ping(sensor) {
34 | TWI.SEND(sensor)
35 | int distance = TWI.MDATA
36 | return distance
37 | }
38
39 | function handleDistanceResponse(distance, direction) {
40 | switch(direction) {
41 | case: ’LOWER’: {
42 | //Because we will be affected by a blind spot and we
| don’t know how large that will be,
43 | //(should be ~4.5*20cm so ~80-90cm), we will respond
| to anything < 1m
| 78

44 | if (distance < 100) {
45 | //If we’re at surface, we will need to stop and
| reverse. We’ll handle that when we plug in the
| forward prop
46 | if (depth == 0) {
47 | //Handle later.
48 | } else {
49 | depth -= 10
50 | raise(depth)
51 | }
52 | }
53 | }
54 | }
55 | }
56
57 | //I know its bad to repeat code, but this is for readability.
| Both functions perform the same but when reading the code
58 | //its better to be able to differentiate between dive and
| raise.
59 | function dive(depth) {
60 | TWI.MDATA = depth
61 | TWI.SEND(DEPTH_CONTROLLER)
62 | }
63 | function raise(depth) {
64 | TWI.MDATA = depth
65 | TWI.SEND(DEPTH_CONTROLLER)
66 | }
67
68 | //Every Second we want to ping the sensor. We could use delay
| but that is blocking code.
69 | //We want a timer setup to count to 1s
70 | function setupRTC() {
71 | //Timing is controlled with Clock and Period.
72
73 | //1k clock. 1 cycle = 1 second
74 | RTC.CLKSEL = 1024
75 | RTC.PER = 1024
76 | }
77
78 | //ISR to respond every second
79 | ISR(RTC) {
80 | int distance = ping(ULTRASONIC_BOTTOM)
81 | handleDistanceResponse(distance, ’LOWER’)
82 | }

79

# Appendix I

# Code

I.1 | Depth Controller v1
1 | /**
2 | * v1 based on the Psuedocode.
3 | */
4
5 | #define F_CPU 3333333UL
6 | #include <avr/io.h>
7 | // #include <avr/iotn1627.h>
8 | #include <util/delay.h>
9 | #include <avr/interrupt.h>
10
11 | int plungerPos = 0;
12
13 | #define OUT 1
14 | #define IN 2
15 | int dir = OUT;
16
17 | #define START 1
18 | #define STOP 0
19 | int move = START;
20
21 | /*
22 | * Lets apply the pins to some defines
23 | *
24 | *
25 | *
26 | * StepperMotor
27 | * 17 - PC0
28 | * 18 - PC1
29 | * 19 - PC2
30 | * 20 - PC3
31 | *

80

32 | * Going to use 6(PA5), 7(PA6). These need to be inputs to
| detect voltage
33 | * Will also need interrupts on these and pullup enabled
| because they’re floating
34 | *
35 | * Button we’ll put on PB2
36 | * Also we’ll add the pullup because while theres no voltage
| its also floating.
37 | */
38 | //PortC
39 | #define STEP_PIN_1 PIN0_bm
40 | #define STEP_PIN_2 PIN1_bm
41 | #define STEP_PIN_3 PIN2_bm
42 | #define STEP_PIN_4 PIN3_bm
43
44 | //PortA
45 | #define BUFFER_OUT_PIN PIN5_bm
46 | #define BUFFER_IN_PIN PIN7_bm
47
48 | //PortB
49 | #define BUTTON_PIN PIN2_bm
50
51 | //Functions we need to define.
52 | //This isn’t in pseudocode. I like to include it to be explicit
53 | void mainClkCtrl(void);
54 | void stepper(int);
55 | void setup(void);
56 | void setupPins(void);
57 | void setupRTC(void);
58 | void enableRTC(void);
59 | void disableRTC(void);
60
61 | int main(void) {
62 | setup();
63
64 | sei();
65
66 | int step = 0;
67 | while(1) {
68 | if (move == START) {
69 | if (dir == OUT && plungerPos != 255) {
70 | stepper(step);
71 | step--;
72 | if (step < 0) {
73 | step = 7;
74 | }
75 | } else if (dir == IN && plungerPos != 0) {
76 | stepper(step);
77 | step++;

81

78 | if (step > 7) {
79 | step = 0;
80 | }
81 | }
82 | _delay_us(750);
83 | }
84 | }
85
86 | return 0;
87 | }
88
89 | void stepper(int step) {
90 | switch(step) {
91 | case 0:
92 | PORTC.OUTCLR |= STEP_PIN_1 | STEP_PIN_2 | STEP_PIN_3;
93 | PORTC.OUTSET |= STEP_PIN_4;
94 | break;
95 | case 1:
96 | PORTC.OUTCLR |= STEP_PIN_1 | STEP_PIN_2;
97 | PORTC.OUTSET |= STEP_PIN_3 | STEP_PIN_4;
98 | break;
99 | case 2:
100 | PORTC.OUTCLR |= STEP_PIN_1 | STEP_PIN_2 | STEP_PIN_4;
101 | PORTC.OUTSET |= STEP_PIN_3;
102 | break;
103 | case 3:
104 | PORTC.OUTCLR |= STEP_PIN_1 | STEP_PIN_4;
105 | PORTC.OUTSET |= STEP_PIN_2 | STEP_PIN_3;
106 | break;
107 | case 4:
108 | PORTC.OUTCLR |= STEP_PIN_1 | STEP_PIN_3 | STEP_PIN_4;
109 | PORTC.OUTSET |= STEP_PIN_2;
110 | break;
111 | case 5:
112 | PORTC.OUTCLR |= STEP_PIN_3 | STEP_PIN_4;
113 | PORTC.OUTSET |= STEP_PIN_1 | STEP_PIN_2;
114 | break;
115 | case 6:
116 | PORTC.OUTCLR |= STEP_PIN_2 | STEP_PIN_3 | STEP_PIN_4;
117 | PORTC.OUTSET |= STEP_PIN_1;
118 | break;
119 | case 7:
120 | PORTC.OUTCLR |= STEP_PIN_2 | STEP_PIN_3;
121 | PORTC.OUTSET |= STEP_PIN_1 | STEP_PIN_4;
122 | break;
123 | }
124 | }
125
126 | void mainClkCtrl(void)

82

127 | {
128 | _PROTECTED_WRITE(CLKCTRL.MCLKCTRLA,
| CLKCTRL_CLKSEL_OSC20M_gc | CLKCTRL_CLKOUT_bm);
129 | _PROTECTED_WRITE(CLKCTRL.MCLKCTRLB, CLKCTRL_PDIV_6X_gc |
| CLKCTRL_PEN_bm);
130 | }
131
132 | void setup(void) {
133 | mainClkCtrl();
134 | setupRTC();
135 | setupPins();
136 | }
137
138 | void setupRTC(void) {
139 | RTC.CLKSEL = RTC_CLKSEL_INT32K_gc; // Using internal 32.768
| kHz oscillator
140 | RTC.CTRLA = RTC_PRESCALER_DIV64_gc;
141 | RTC.PER = 2560;
142 | RTC.INTCTRL |= RTC_OVF_bm;
143 | }
144
145 | void enableRTC(void) {
146 | RTC.CNT = 0;
147 | RTC.CTRLA |= RTC_RTCEN_bm;
148 | }
149 | void disableRTC(void) {
150 | RTC.CTRLA &= ~(RTC_RTCEN_bm);
151 | }
152
153 | void setupPins(void) {
154 | //Motor
155 | PORTC.DIR |= STEP_PIN_1 | STEP_PIN_2 | STEP_PIN_3 |
STEP_PIN_4;
156
157 | //Buffers
158 | PORTA.DIR &= ~(BUFFER_OUT_PIN);
159 | PORTA.DIR &= ~(BUFFER_IN_PIN);
160 | PORTA.PIN5CTRL |= PORT_PULLUPEN_bm | PORT_ISC_RISING_gc;
161 | PORTA.PIN7CTRL |= PORT_PULLUPEN_bm | PORT_ISC_RISING_gc;
162
163 | //Button
164 | PORTB.DIR &= ~(BUTTON_PIN);
165 | PORTB.PIN2CTRL |= PORT_PULLUPEN_bm | PORT_ISC_RISING_gc;
166 | }
167
168 | //ISRS
169 | ISR(RTC_CNT_vect) {
170 | RTC.INTFLAGS = RTC_OVF_bm;
171 | if (dir == OUT) {

83

172 | plungerPos += 5;
173 | } else if (dir == IN) {
174 | plungerPos -= 5;
175 | }
176 | }
177
178 | ISR(PORTA_PORT_vect) {
179 | if (PORTA.INTFLAGS & BUFFER_OUT_PIN) {
180 | plungerPos = 255;
181 | dir = IN;
182 | PORTA.INTFLAGS |= BUFFER_OUT_PIN;
183 | }
184
185 | if (PORTA.INTFLAGS & BUFFER_IN_PIN) {
186 | plungerPos = 0;
187 | dir = OUT;
188 | PORTA.INTFLAGS |= BUFFER_IN_PIN;
189 | }
190 | }
191
192 | ISR(PORTB_PORT_vect) {
193 | if (move == STOP) {
194 | enableRTC();
195 | move = START;
196 | } else if (move == START) {
197 | disableRTC();
198 | move = STOP;
199 | }
200 | PORTB.INTFLAGS |= BUTTON_PIN;
201 | }
I.2 | Sonar Module v1
1 | /**
2 | * Based on the v1 pseudocode
3 | */
4 | #define F_CPU 3333333UL
5
6 | #include <avr/io.h>
7 | // #include <avr/iotn1627.h>
8
9 | #include <util/delay.h>
10 | #include <avr/interrupt.h>
11
12 | float distance = 0.0;
13
14 | #define TRIGGER_PIN PIN0_bm
| 84

15 | #define ECHO_PIN_RISING PIN1_bm
16 | #define ECHO_PIN_FALLING PIN2_bm
17 | #define BUTTON_PIN PIN3_bm
18
19 | void setup(void);
20 | void mainClkCtrl(void);
21 | void setupPins(void);
22 | void setupTCA(void);
23 | void enableTCA(void);
24 | void disableTCA(void);
25 | void setupTCB(void);
26 | void enableTCB(void);
27 | void disableTCB(void);
28 | void triggerSonar(void);
29 | void calcDistance(float);
30
31
32 | int main(void) {
33 | setup();
34
35 | sei();
36
37 | while(1) {
38 | //Do nothing.
39 | }
40 | }
41
42 | void setup(void) {
43 | mainClkCtrl();
44 | setupPins();
45 | setupTCA();
46 | setupTCB();
47 | }
48
49 | void mainClkCtrl(void) {
50 | _PROTECTED_WRITE(CLKCTRL.MCLKCTRLA,
| CLKCTRL_CLKSEL_OSC20M_gc | CLKCTRL_CLKOUT_bm);
51 | _PROTECTED_WRITE(CLKCTRL.MCLKCTRLB, CLKCTRL_PDIV_6X_gc |
| CLKCTRL_PEN_bm);
52 | }
53
54 | void setupPins(void) {
55 | PORTC.DIR |= TRIGGER_PIN;
56 | PORTC.DIR &= ~(ECHO_PIN_RISING | ECHO_PIN_FALLING |
| BUTTON_PIN);
57
58 | PORTC.PIN1CTRL |= PORT_ISC_RISING_gc | PORT_PULLUPEN_bm;
59 | PORTC.PIN2CTRL |= PORT_ISC_FALLING_gc | PORT_PULLUPEN_bm;
60

85

61 | PORTC.PIN3CTRL |= PORT_ISC_RISING_gc | PORT_PULLUPEN_bm;
62 | }
63
64 | void setupTCA(void) {
65 | TCA0.SINGLE.CTRLA |= TCA_SINGLE_CLKSEL_DIV1_gc;
66 | TCA0.SINGLE.CNT = 0;
67 | TCA0.SINGLE.PER = 0xFFFF;
68 | TCA0.SINGLE.INTCTRL |= TCA_SINGLE_OVF_bm;
69 | }
70 | void enableTCA(void) {
71 | TCA0.SINGLE.CNT = 0;
72 | TCA0.SINGLE.CTRLA |= TCA_SINGLE_ENABLE_bm;
73 | }
74 | void disableTCA(void) {
75 | TCA0.SINGLE.CTRLA &= ~(TCA_SINGLE_ENABLE_bm);
76 | }
77
78 | void setupTCB(void) {
79 | TCB0.CTRLA |= TCB_CLKSEL_DIV2_gc; // Clock / 2
80 | uint16_t period = (F_CPU / 2) * 10 / 1000000;
81 | TCB0.CCMP = period;
82 | TCB0.CTRLB |= TCB_CNTMODE_INT_gc;
83 | TCB0.INTCTRL |= TCB_CAPT_bm;
84 | }
85 | void enableTCB(void) {
86 | TCB0.CNT = 0;
87 | TCB0.CTRLA |= TCB_ENABLE_bm;
88 | }
89 | void disableTCB(void) {
90 | TCB0.CTRLA &= ~(TCB_ENABLE_bm);
91 | }
92
93 | void triggerSonar(void) {
94 | PORTC.OUTSET |= TRIGGER_PIN;
95 | enableTCB();
96 | }
97
98 | void calcDistance(float ticks) {
99 | float cpu = (float)F_CPU / 64.0f;
100 | float time = ticks / cpu;
101 | float sos = 34300.0f;
102 | distance = time * sos / 2.0f;
103 | }
104
105 | ISR(PORTC_PORT_vect) {
106 | if (PORTC.INTFLAGS & ECHO_PIN_RISING) {
107 | enableTCA();
108 | PORTC.INTFLAGS |= ECHO_PIN_RISING;
109 | }

86

110
111 | if (PORTC.INTFLAGS & ECHO_PIN_FALLING) {
112 | disableTCA();
113 | uint16_t ticks = TCA0.SINGLE.CNT;
114 | calcDistance((float)ticks);
115 | PORTC.INTFLAGS |= ECHO_PIN_FALLING;
116 | }
117
118 | if (PORTC.INTFLAGS & BUTTON_PIN) {
119 | triggerSonar();
120 | PORTC.INTFLAGS = BUTTON_PIN;
121 | }
122 | }
123
124 | ISR(TCB0_INT_vect) {
125 | disableTCB();
126 | PORTC.OUTCLR |= TRIGGER_PIN;
127 | TCB0.INTFLAGS = TCB_CAPT_bm;
128 | }
I.3 | Depth Controller v2
1 | /**
2 | * v2 based on the Psuedocode.
3 | */
4
5 | #define F_CPU 3333333UL
6 | #include <avr/io.h>
7 | #include <avr/iotn1627.h>
8 | #include <util/delay.h>
9 | #include <avr/interrupt.h>
10 | #include "TWI.h"
11
12 | int plungerPos = 125;
13 | int commandedPos = 0;
14
15 | #define OUT 1
16 | #define IN 2
17 | int dir = IN;
18
19 | /*
20 | * Lets apply the pins to some defines
21 | *
22 | *
23 | *
24 | * StepperMotor
25 | * 17 - PC0
| 87

26 | * 18 - PC1
27 | * 19 - PC2
28 | * 20 - PC3
29 | *
30 | * Going to use 6(PA5), 7(PA6). These need to be inputs to
| detect voltage
31 | * Will also need interrupts on these and pullup enabled
| because they’re floating
32 | *
33 | * Button we’ll put on PB2
34 | * Also we’ll add the pullup because while theres no voltage
| its also floating.
35 | */
36 | //PortC
37 | #define STEP_PIN_1 PIN0_bm
38 | #define STEP_PIN_2 PIN1_bm
39 | #define STEP_PIN_3 PIN2_bm
40 | #define STEP_PIN_4 PIN3_bm
41
42 | //PortA
43 | #define BUFFER_OUT_PIN PIN5_bm
44 | #define BUFFER_IN_PIN PIN7_bm
45
46 | //Functions we need to define.
47 | //This isn’t in pseudocode. I like to include it to be explicit
48 | void mainClkCtrl(void);
49 | void stepper(int);
50 | void setup(void);
51 | void setupPins(void);
52 | void setupRTC(void);
53 | void enableRTC(void);
54 | void disableRTC(void);
55
56 | //My TWI Library requires callbacks.
57 | void I2C_RX_Callback(uint8_t);
58 | uint8_t I2C_TX_Callback(void);
59 | //Also need an address we can bind this module to.
60 | #define ADDR 0x08
61
62 | int main(void) {
63 | setup();
64
65 | TWI_Slave_Init(ADDR, I2C_RX_Callback, I2C_TX_Callback);
66
67 | sei();
68
69 | int step = 0;
70 | while(1) {
71 | if (plungerPos != commandedPos) {

88

72 | if (dir == OUT && plungerPos != 255) {
73 | stepper(step);
74 | step--;
75 | if (step < 0) {
76 | step = 7;
77 | }
78 | } else if (dir == IN && plungerPos != 0) {
79 | stepper(step);
80 | step++;
81 | if (step > 7) {
82 | step = 0;
83 | }
84 | }
85 | _delay_us(750);
86 | }
87 | }
88
89 | return 0;
90 | }
91
92 | void stepper(int step) {
93 | switch(step) {
94 | case 0:
95 | PORTC.OUTCLR |= STEP_PIN_1 | STEP_PIN_2 | STEP_PIN_3;
96 | PORTC.OUTSET |= STEP_PIN_4;
97 | break;
98 | case 1:
99 | PORTC.OUTCLR |= STEP_PIN_1 | STEP_PIN_2;
100 | PORTC.OUTSET |= STEP_PIN_3 | STEP_PIN_4;
101 | break;
102 | case 2:
103 | PORTC.OUTCLR |= STEP_PIN_1 | STEP_PIN_2 | STEP_PIN_4;
104 | PORTC.OUTSET |= STEP_PIN_3;
105 | break;
106 | case 3:
107 | PORTC.OUTCLR |= STEP_PIN_1 | STEP_PIN_4;
108 | PORTC.OUTSET |= STEP_PIN_2 | STEP_PIN_3;
109 | break;
110 | case 4:
111 | PORTC.OUTCLR |= STEP_PIN_1 | STEP_PIN_3 | STEP_PIN_4;
112 | PORTC.OUTSET |= STEP_PIN_2;
113 | break;
114 | case 5:
115 | PORTC.OUTCLR |= STEP_PIN_3 | STEP_PIN_4;
116 | PORTC.OUTSET |= STEP_PIN_1 | STEP_PIN_2;
117 | break;
118 | case 6:
119 | PORTC.OUTCLR |= STEP_PIN_2 | STEP_PIN_3 | STEP_PIN_4;
120 | PORTC.OUTSET |= STEP_PIN_1;

89

121 | break;
122 | case 7:
123 | PORTC.OUTCLR |= STEP_PIN_2 | STEP_PIN_3;
124 | PORTC.OUTSET |= STEP_PIN_1 | STEP_PIN_4;
125 | break;
126 | }
127 | }
128
129 | void mainClkCtrl(void)
130 | {
131 | _PROTECTED_WRITE(CLKCTRL.MCLKCTRLA,
| CLKCTRL_CLKSEL_OSC20M_gc | CLKCTRL_CLKOUT_bm);
132 | _PROTECTED_WRITE(CLKCTRL.MCLKCTRLB, CLKCTRL_PDIV_6X_gc |
| CLKCTRL_PEN_bm);
133 | }
134
135 | void setup(void) {
136 | mainClkCtrl();
137 | setupRTC();
138 | setupPins();
139 | }
140
141 | void setupRTC(void) {
142 | RTC.CLKSEL = RTC_CLKSEL_INT32K_gc; // Using internal 32.768
| kHz oscillator
143 | RTC.CTRLA = RTC_PRESCALER_DIV64_gc;
144 | RTC.PER = 2560;
145 | RTC.INTCTRL |= RTC_OVF_bm;
146 | }
147
148 | void enableRTC(void) {
149 | RTC.CNT = 0;
150 | RTC.CTRLA |= RTC_RTCEN_bm;
151 | }
152 | void disableRTC(void) {
153 | RTC.CTRLA &= ~(RTC_RTCEN_bm);
154 | }
155
156 | void setupPins(void) {
157 | //Motor
158 | PORTC.DIR |= STEP_PIN_1 | STEP_PIN_2 | STEP_PIN_3 |
STEP_PIN_4;
159
160 | //Buffers
161 | PORTA.DIR &= ~(BUFFER_OUT_PIN);
162 | PORTA.DIR &= ~(BUFFER_IN_PIN);
163 | PORTA.PIN5CTRL |= PORT_PULLUPEN_bm | PORT_ISC_RISING_gc;
164 | PORTA.PIN7CTRL |= PORT_PULLUPEN_bm | PORT_ISC_RISING_gc;
165 | }

90

166
167 | void I2C_RX_Callback(uint8_t com) {
168 | // We’re not actually using this. Just need the function
| for the SlaveInit function
169 | if (com > plungerPos) {
170 | dir = OUT;
171 | } else {
172 | dir = IN;
173 | }
174
175 | commandedPos = com;
176 | }
177
178 | uint8_t I2C_TX_Callback(void) {
179 | // We’re not actually using this. Just need the function
| for the SlaveInit function
180 | }
181
182 | //ISRS
183 | ISR(RTC_CNT_vect) {
184 | RTC.INTFLAGS = RTC_OVF_bm;
185 | if (dir == OUT) {
186 | plungerPos += 5;
187 | } else if (dir == IN) {
188 | plungerPos -= 5;
189 | }
190 | }
191
192 | ISR(PORTA_PORT_vect) {
193 | if (PORTA.INTFLAGS & BUFFER_OUT_PIN) {
194 | plungerPos = 255;
195 | dir = IN;
196 | PORTA.INTFLAGS |= BUFFER_OUT_PIN;
197 | }
198
199 | if (PORTA.INTFLAGS & BUFFER_IN_PIN) {
200 | plungerPos = 0;
201 | dir = OUT;
202 | PORTA.INTFLAGS |= BUFFER_IN_PIN;
203 | }
204 | }
I.4 | Sonar Module v2
1 | /**
2 | * Based on the v2 pseudocode
3 | */
| 91

4 | #include <stdint.h>
5 | #define F_CPU 3333333UL
6
7 | #include <avr/io.h>
8 | #include <avr/iotn1627.h>
9
10 | #include <util/delay.h>
11 | #include <avr/interrupt.h>
12
13 | #include "TWI.h"
14
15 | float distance = 0.0;
16
17 | #define TRIGGER_PIN PIN0_bm
18 | #define ECHO_PIN PIN1_bm
19
20 | void setup(void);
21 | void mainClkCtrl(void);
22 | void setupPins(void);
23 | void setupTCA(void);
24 | void enableTCA(void);
25 | void disableTCA(void);
26 | void triggerSonar(void);
27 | void calcDistance(float);
28
29 | //TWI Library requires callbacks.
30 | void I2C_RX_Callback(uint8_t);
31 | uint8_t I2C_TX_Callback(void);
32 | //Also need an address
33 | #define ADDR 0x09
34
35 | int main(void) {
36 | setup();
37
38 | TWI_Slave_Init(ADDR, I2C_RX_Callback, I2C_TX_Callback);
39
40 | sei();
41
42 | while(1) {
43 | //Do nothing.
44 | }
45 | }
46
47 | void setup(void) {
48 | mainClkCtrl();
49 | setupPins();
50 | setupTCA();
51 | }
52

92

53 | void mainClkCtrl(void) {
54 | _PROTECTED_WRITE(CLKCTRL.MCLKCTRLA,
| CLKCTRL_CLKSEL_OSC20M_gc | CLKCTRL_CLKOUT_bm);
55 | _PROTECTED_WRITE(CLKCTRL.MCLKCTRLB, CLKCTRL_PDIV_6X_gc |
| CLKCTRL_PEN_bm);
56 | }
57
58 | void setupPins(void) {
59 | PORTC.DIR |= TRIGGER_PIN;
60 | PORTC.DIR &= ~(ECHO_PIN);
61
62 | PORTC.PIN1CTRL |= PORT_PULLUPEN_bm;
63
64 | PORTC.PIN3CTRL |= PORT_ISC_RISING_gc | PORT_PULLUPEN_bm;
65 | }
66
67 | void setupTCA(void) {
68 | TCA0.SINGLE.CTRLA |= TCA_SINGLE_CLKSEL_DIV1_gc;
69 | TCA0.SINGLE.CNT = 0;
70 | TCA0.SINGLE.PER = 0xFFFF;
71 | }
72 | void enableTCA(void) {
73 | TCA0.SINGLE.CNT = 0;
74 | TCA0.SINGLE.CTRLA |= TCA_SINGLE_ENABLE_bm;
75 | }
76 | void disableTCA(void) {
77 | TCA0.SINGLE.CTRLA &= ~(TCA_SINGLE_ENABLE_bm);
78 | }
79
80 | void triggerSonar(void) {
81 | PORTC.OUTSET |= TRIGGER_PIN;
82 | _delay_us(10);
83 | PORTC.OUTCLR |= TRIGGER_PIN;
84 | }
85
86 | void calcDistance(float ticks) {
87 | float cpu = (float)F_CPU / 64.0f;
88 | float time = ticks / cpu;
89 | float sos = 34300.0f;
90 | distance = time * sos / 2.0f;
91 | }
92
93 | void I2C_RX_Callback(uint8_t) {
94 | //This one doesn’t do anything. We receive a command and
| send a distance.
95 | //There is no need to use any data passed to the request
96 | }
97 | //The response requires blocking code as we can’t just sit
| around and wait for the calculations

93

98 | //to drop. We need to sequentially do everything in this
| function
99 | uint8_t I2C_TX_Callback(void) {
100 | triggerSonar();
101 | //wait for echo to go high
102 | while((!(PORTC.IN & ECHO_PIN)));
103 | enableTCA();
104 | //Wait for echo to go High
105 | while(PORTC.IN & ECHO_PIN);
106 | disableTCA();
107 | uint16_t ticks = TCA0.SINGLE.CNT;
108 | calcDistance((float)ticks);
109 | return (uint8_t)distance;
110 | }
I.5 | Central Controller v1
1 | /**
2 | Based on the v1 pseudocode
3 | */
4
5 | #include <avr/io.h>
6 | #include <avr/iotn1627.h>
7
8 | #include "TWI.h"
9
10 | #define ULTRASONIC_BOTTOM 0x08
11
12 | #define DEPTH_CONTROLLER 0x09
13
14 | int depth = 0;
15
16 | #define LOWER 1
17
18 | void setup(void);
19 | void mainClkCtrl(void);
20 | void setupRTC(void);
21 | int ping(void);
22 | void handleDistanceResponse(int, int);
23 | void dive(int);
24 | void raise(int);
25
26 | int main() {
27 | setup();
28
29 | TWI_Master_Init();
30
| 94

31 | //DIVE, DIVE, DIVE!
32 | dive(255);
33
34 | sei();
35 | while(1) {
36
37 | }
38
39 | return 0;
40 | }
41
42 | void setup(void) {
43 | setupRTC();
44 | mainClkCtrl();
45 | }
46
47 | void mainClkCtrl(void)
48 | {
49 | _PROTECTED_WRITE(CLKCTRL.MCLKCTRLA,
| CLKCTRL_CLKSEL_OSC20M_gc);
50 | _PROTECTED_WRITE(CLKCTRL.MCLKCTRLB, CLKCTRL_PDIV_6X_gc |
| CLKCTRL_PEN_bm);
51 | // F_CPU with this configuration will be 3.33MHz
52 | }
53
54 | void setupRTC(void) {
55 | RTC.CLKSEL = RTC_CLKSEL_INT1K_gc; // Using internal 32.768
| kHz oscillator
56 | RTC.PER = 1024;
57 | RTC.INTCTRL |= RTC_OVF_bm;
58 | RTC.CTRLA |= RTC_RTCEN_bm;
59 | }
60
61 | int ping(void) {
62 | TWI_Master_Start(ULTRASONIC_BOTTOM, 0x01); //Start TWI to
| sonar module
63 | int distance = TWI_Master_Read_NACK();
64 | return distance;
65 | TWI_Master_Stop();
66 | }
67
68 | void handleDistanceResponse(int distance, int direction) {
69 | switch (direction) {
70 | case LOWER: {
71 | if (depth == 0) {
72 | //Handle later
73 | } else {
74 | depth -= 10;
75 | raise(depth);

95

76 | }
77 | }
78
79 | default: {
80 | return;
81 | }
82 | }
83 | }
84
85 | void dive(int d) {
86 | TWI_Master_Start(DEPTH_CONTROLLER, 0x00); //Write Command..
87 | TWI_Master_Write(d);
88 | TWI_Master_Stop();
89 | }
90 | void raise(int d) {
91 | TWI_Master_Start(DEPTH_CONTROLLER, 0x00);
92 | TWI_Master_Write(d);
93 | TWI_Master_Stop();
94 | }
95
96 | ISR(RTC_CNT_vect) {
97 | int distance = ping();
98 | handleDistanceResponse(distance, LOWER);
99 | }

96

# Bibliography

[1] M. Z. Adamu. Design and development of an ultrasonic motion detector. International Journal of Security Privacy and Trust Management, 2013.
[2] Arduino. Wire.h. url: https://github.com/arduino/ArduinoCorerenesas/tree/main/libraries/Wire.
[3] avrdude. Avrdude documentation. 15 2023. url: https://avrdudes.github.io/avrdude/7.2/avrdude.pdf.
[4] I. Bus. Fast mode. url: https://www.i2c-bus.org/fastmode/.
[5] B. E. Channel. Brick experiment channel. url: https://www.youtube.com/c/BrickExperimentChannel.
[6] B. E. Channel. Brick experiment channel. url: https://brickexperimentchannel.wordpress.com/.
[7] A. D’Amico and R. Pittenger. A breif history of active sonar. Aquatic
Mammels, 35:426–434, 2009.
[8] Espressif. Esp8266ex datasheet. url: https://components101.com/sites/default/files/component_datasheet/ESP8266%20NodeMCU%20Datasheet.pdf.
[9] A. L. et al. Correction factors in determining speed of sound amoung freshmen in undergraduate physics laboratory. Journal of Physics, 997, 2018.
[10] E. Freaks. Ultrasonic ranging module hc - sr04. url: https://cdn.robotshop.com/media/s/spa/rb-spa-1388/pdf/hcsr04-ultrasonicrange-finder.pdf.
[11] gcc. Avr-gcc documentation. 27 2024. url: https://gcc.gnu.org/wiki/avr-gcc.
[12] GitHub. About projects. url: https : / / docs . github . com / en / issues/planning-and-tracking-with-projects/learning-about-projects/about-projects.
[13] Z. Hong, X. Pan, P. Chen, X. Su, N. Wang, and W. Lu. A topology control with energy balance in underwater wireless sensor networks for iot-based applications. Sensors, 2018.

97

[14] N. O. Institute. Autosubs. url: https://noc.ac.uk/facilities/marine-autonomous-robotic-systems/autosubs.
[15] W. H. O. Institute. Auvs. url: https://www.whoi.edu/what-we-do/explore/underwater-vehicles/auvs/.
[16] W. H. O. Institute. Remus. url: https://www.whoi.edu/what-we-do/explore/underwater-vehicles/auvs/remus/.
[17] W. H. O. Institute. Spray glider. url: https://www.whoi.edu/what-we-do/explore/underwater-vehicles/auvs/spray-glider/.
[18] megaTinyCore. Spence konde. url: https://github.com/SpenceKonde/megaTinyCore.
[19] megaTinyCore TwoWire. Spence konde. url: https://github.com/SpenceKonde / megaTinyCore / tree / master / megaavr / libraries /
Wire/src.
[20] Microchip. Attiny1624/1626/1627 data sheet. url: https : / / ww1 . microchip.com/downloads/aemDocuments/documents/MCU08/ProductDocuments/ DataSheets/ATtiny1624-26-27-DataSheet-DS40002234B.pdf.
[21] Microchip. What is twi? how to configure the twi for i2c communication. url: https://ww1.microchip.com/downloads/en/DeviceDoc/90003181A.pdf.
[22] A. Navigation. Hydrus. url: https : / / www . advancednavigation . com/robotics/micro-auv/hydrus.
[23] U. of London. Module author interviews - project templates. url: https : / / www . coursera . org / learn / uol - cm3070 - computer -science-final-project/lecture/xTXbf/module-author-interviewsproject-templates.
[24] Ofcom. Uk frequency allocation table. Aug. 2022. url: http : / / static.ofcom.org.uk/static/spectrum/fat.html.
[25] M. Pro. Ultrasonic sensor. url: https://www.farnell.com/datasheets/3771814.pdf.
[26] M. Pro. Ultrasonic transmitter. url: https://www.farnell.com/datasheets/3771805.pdf.
[27] B. Robotics. Ping2 sonar altimeter and echosounder. url: https : //bluerobotics.com/store/sonars/echosounders/ping-sonarr2-rp/.
[28] scanlime. Ultrasonic transducer - scanlime:011. url: https://www.youtube.com/watch?v=VuzytIcSxwI.
[29] R. Sefton. Auv. url: https://github.com/RichardSefton/AUV.
[30] R. Sefton. Auv. url: https://github.com/users/RichardSefton/projects/1.

98

[31] R. Sefton. Project template. url: https : / / www . coursera . org / learn/uol-cm3070-computer-science-final-project/discussions/ groups/nZogU_NUEe6kARIL6JjJgQ/threads/SPXNkveKEe6EwA4ifGOouQ.
[32] P. Visconti, G. Giannotta, R. Brama, P. Primiceri, A. Malvasi, and
A. Centuori. Feature, operation principle and limits of spi and i2c communication protocols for smart objects: a novel spi-based hybrid protocol especially suitable for iot applications. International Journal on Smart Sensing and Intelligent Systems, 10:262–295, 2017.
[33] E. Williams. Make: AVR Programming. Maker Media Inc., 2015.
[34] Wolfram. High-frequency sonar performance. url: https://demonstrations.wolfram.com/HighFrequencySonarPerformance/.
[35] R. B. Wynn, V. A. Huvenne, T. P. L. Bas, B. J. Murton, D. P. Connelly, B. J. Bett, H. A. Ruhl, K. J. Morris, J. Peakall, D. R. Parsons,
E. J. Summer, S. E. Darby, R. M. Dorrell, and J. E. Hunt. Autonomous underwater vehicles (auvs): their past, present and future contributions to the advancement of marine geoscience. Elsevier, 352:451–468, 2014.

99
