RichardSefton/AUV/assesment/assets/AUV_Electronics1.jpg

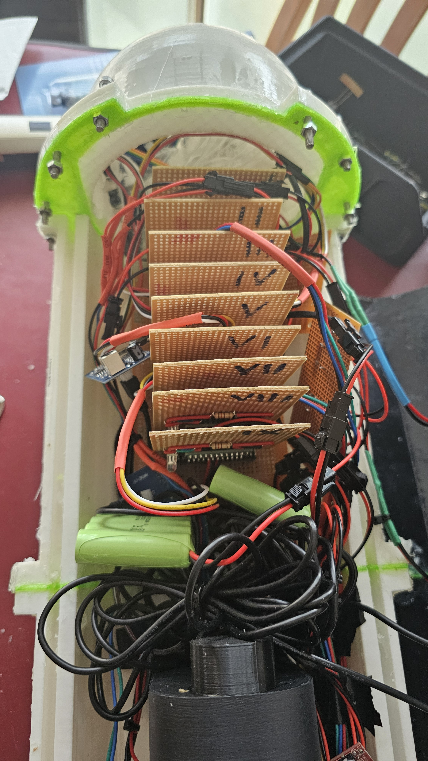
assesment/assets/AUV_Electronics1.jpg
