RichardSefton/AUV/assesment/assets/AUV_Electronics2.jpg

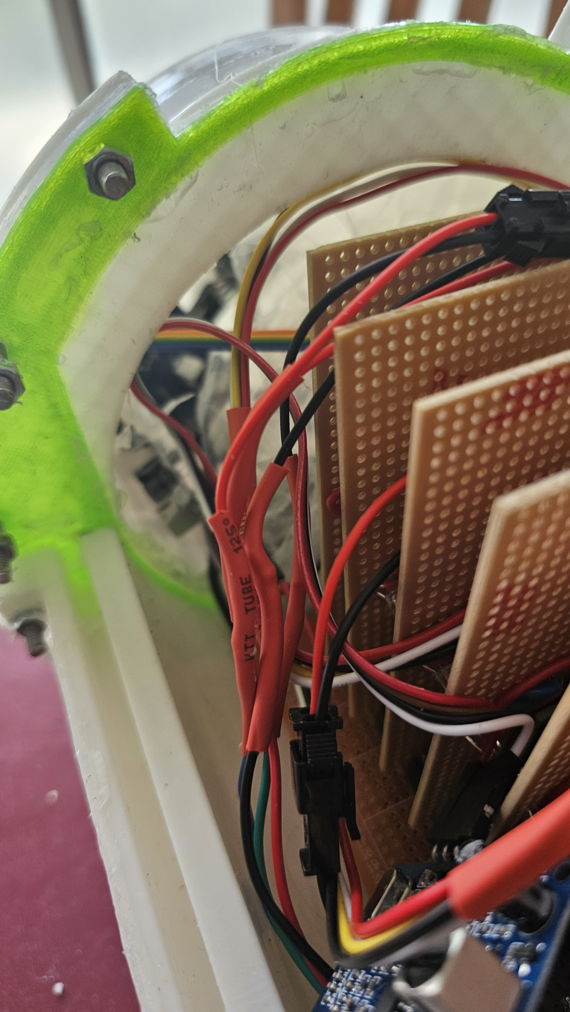
assesment/assets/AUV_Electronics2.jpg
