RichardSefton/AUV/assesment/assets/Transducer_response1.jpg

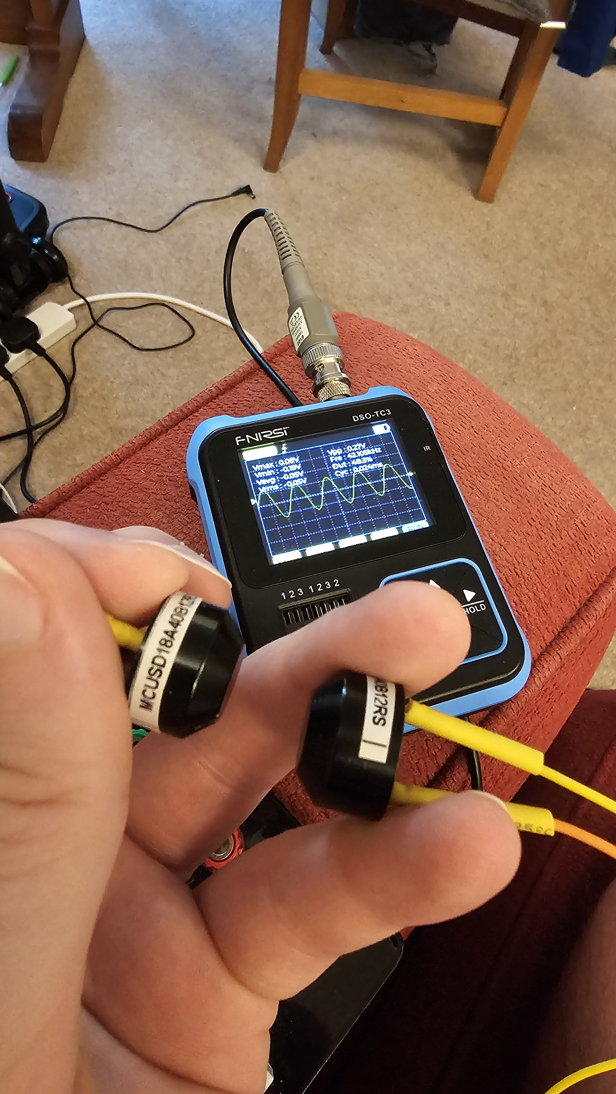
assesment/assets/Transducer_response1.jpg
