RichardSefton/AUV/(list of files, cad)

Other CAD files:
CAD/AUVv27_0808241707.dwg
