RichardSefton/AUV/assesment/assets/Water_test1.jpg

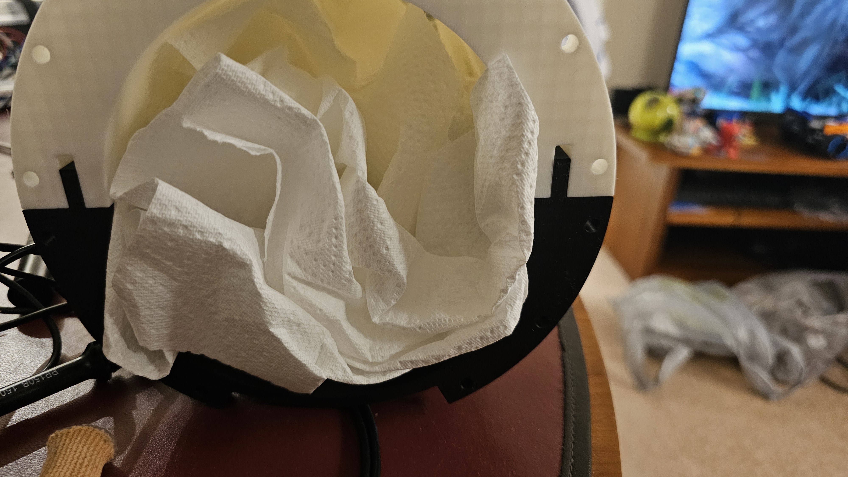
assesment/assets/Water_test1.jpg
