RichardSefton/AUV/assesment/assets/Water_Test2.jpg

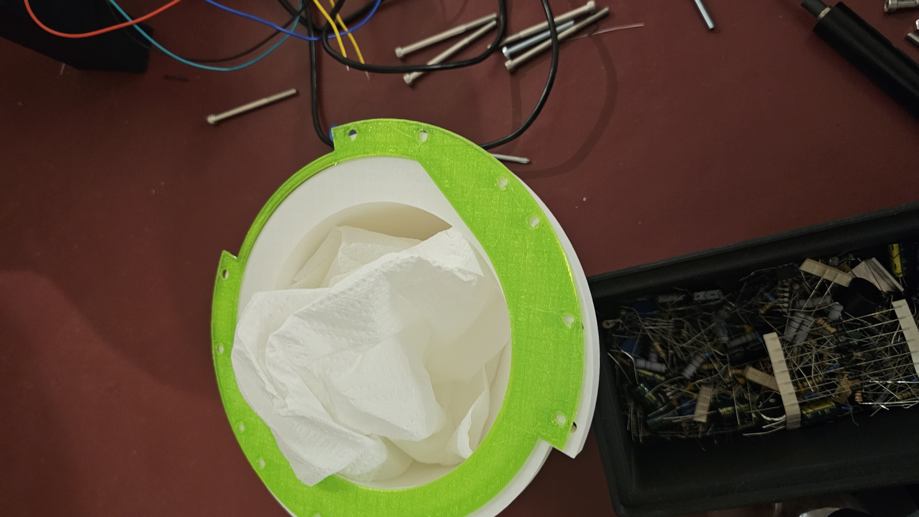
assesment/assets/Water_Test2.jpg
