RichardSefton/AUV/FinalCode/Sonar_Forward.X/queuelogs/debugtool.txt

768 1724082343642 GEN4_CONNECT_DIAGNOSTICS:MPLABCommTool is NOT null
768 1724082343642 GEN4_CONNECT_DIAGNOSTICS:AttachedToolPID = 2141, AttachedToolVID = 3eb
768 1724082343642 GEN4_CONNECT_DIAGNOSTICS:transport type = USB
768 1724082343642 GEN4_CONNECT_DIAGNOSTICS:AttachedToolPID = 2141, AttachedToolVID = 3eb
768 1724082343713 com.microchip.mplab.mdbcore.RealICETool.RIDbgToolCom
768 1724082343713 GEN4_CONNECT_DIAGNOSTICS:Before MPLABCommTool.Connect()
768 1724082343713 GEN4_CONNECT_DIAGNOSTICS:After MPLABCommTool.Connect()
768 1724082343713 GEN4_CONNECT_DIAGNOSTICS:MPLABCommTool.Connect() returned MPLABCOMM_NO_ERROR
768 1724082343714 GEN4_CONNECT_DIAGNOSTICS:Attaching to MPLABCommTool plugnplay
768 1724082343733 GEN4_CONNECT_DIAGNOSTICS:Adding new plug and play observer com.microchip.mplab.mdbcore.RI4Tool.RI4ToolBase$RI4PlugNPlayObserver@75d7fd1f
768 1724082343733 GEN4_CONNECT_DIAGNOSTICS:Begin PlugNPlayObservers list dump:
768 1724082343733 GEN4_CONNECT_DIAGNOSTICS:com.microchip.mplab.mdbcore.RI4Tool.RI4ToolBase$RI4PlugNPlayObserver@75d7fd1f
768 1724082343733 GEN4_CONNECT_DIAGNOSTICS:End PlugNPlayObservers list dump:
768 1724082343738 GEN4_CONNECT_DIAGNOSTICS:Registering for alternate PNP notifications. CommPnPCriteria.cPIDList = [2177, 2179, 217a, 2142, 2142], CommPnPCriteria.cSerialNumber = j42700073141

768 1724082343877 GEN4_TO_CONTROLLER_LOG:GEN4_INIT_INT_LOG_ATtiny1627 Pre:init
768 1724082343877 GEN4_TO_CONTROLLER_LOG:GEN4_INIT_INT_LOG_ATtiny1627 Payload
768 1724082343877 GEN4_TO_CONTROLLER_LOG:GEN4_INIT_INT_LOG_ATtiny1627 DeviceInfo: Values:
768 1724082343877 GEN4_TO_CONTROLLER_LOG:GEN4_INIT_INT_LOG_ATtiny1627 DeviceInfo: pcAddress = 7fffffffffffffff, Vpp = 5.00, useRowEraseIfVoltageIsLow = false, voltageBelowWhichUseRowErase = 0.00, deviceName = ATtiny1627, programmerType = 
768 1724082343877 GEN4_TO_CONTROLLER_LOG:GEN4_INIT_INT_LOG_ATtiny1627 DeviceInfo: MemInfo values:
768 1724082343878 GEN4_TO_CONTROLLER_LOG:GEN4_INIT_INT_LOG_ATtiny1627 DeviceInfo: mask = ffff, exists = true, startAddr = 00000000, endAddr = 00003fff, rowSize = 0040, rowEraseSize = 0040, addrInc = 0001, widthProgram = 0001
768 1724082343878 GEN4_TO_CONTROLLER_LOG:GEN4_INIT_INT_LOG_ATtiny1627 DeviceInfo: mask = 00ff, exists = true, startAddr = 00821280, endAddr = 0083128a, rowSize = 0001, rowEraseSize = 0000, addrInc = 0001, widthProgram = 0001
768 1724082343878 GEN4_TO_CONTROLLER_LOG:GEN4_INIT_INT_LOG_ATtiny1627 DeviceInfo: mask = 0000, exists = false, startAddr = 00000000, endAddr = 00000000, rowSize = 0000, rowEraseSize = 0000, addrInc = 0000, widthProgram = 0000
768 1724082343878 GEN4_TO_CONTROLLER_LOG:GEN4_INIT_INT_LOG_ATtiny1627 DeviceInfo: mask = 00ff, exists = true, startAddr = 00001400, endAddr = 000014ff, rowSize = 0020, rowEraseSize = 0000, addrInc = 0001, widthProgram = 0001
768 1724082343878 GEN4_TO_CONTROLLER_LOG:GEN4_INIT_INT_LOG_ATtiny1627 DeviceInfo: mask = 00ff, exists = true, startAddr = 00001300, endAddr = 0000131f, rowSize = 0020, rowEraseSize = 0000, addrInc = 0001, widthProgram = 0001
768 1724082343878 GEN4_TO_CONTROLLER_LOG:GEN4_INIT_INT_LOG_ATtiny1627 DeviceInfo: mask = 0000, exists = false, startAddr = 00000000, endAddr = 00000000, rowSize = 0000, rowEraseSize = 0040, addrInc = 0000, widthProgram = 0000
768 1724082343878 GEN4_TO_CONTROLLER_LOG:GEN4_INIT_INT_LOG_ATtiny1627 DeviceInfo: mask = 0000, exists = false, startAddr = 00000000, endAddr = 00000000, rowSize = 0000, rowEraseSize = 0000, addrInc = 0001, widthProgram = 0001
768 1724082343878 GEN4_TO_CONTROLLER_LOG:GEN4_INIT_INT_LOG_ATtiny1627 DeviceInfo: mask = 0000, exists = false, startAddr = 00000000, endAddr = 00000000, rowSize = 0000, rowEraseSize = 0000, addrInc = 0000, widthProgram = 0000
768 1724082343878 GEN4_TO_CONTROLLER_LOG:GEN4_INIT_INT_LOG_ATtiny1627 DeviceInfo: mask = 0000, exists = false, startAddr = 00000000, endAddr = 00000000, rowSize = 0000, rowEraseSize = 0000, addrInc = 0000, widthProgram = 0000
768 1724082343878 GEN4_TO_CONTROLLER_LOG:GEN4_INIT_INT_LOG_ATtiny1627 DeviceInfo: mask = 0000, exists = false, startAddr = 00000000, endAddr = 00000000, rowSize = 0000, rowEraseSize = 0000, addrInc = 0000, widthProgram = 0000
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
768 1724082343878 GEN4_TO_CONTROLLER_LOG:GEN4_INIT_INT_LOG_ATtiny1627 Address = 0000110c, Mask = 00000000
768 1724082343878 GEN4_TO_CONTROLLER_LOG:GEN4_INIT_INT_LOG_ATtiny1627 Address = 00001118, Mask = 00000000
768 1724082343878 GEN4_TO_CONTROLLER_LOG:GEN4_INIT_INT_LOG_ATtiny1627 Address = 00001119, Mask = 00000000
768 1724082343878 GEN4_TO_CONTROLLER_LOG:GEN4_INIT_INT_LOG_ATtiny1627 Address = 0000111a, Mask = 00000000
768 1724082343878 GEN4_TO_CONTROLLER_LOG:GEN4_INIT_INT_LOG_ATtiny1627 Address = 0000111b, Mask = 00000000
768 1724082343878 GEN4_TO_CONTROLLER_LOG:GEN4_INIT_INT_LOG_ATtiny1627 Address = 00001120, Mask = 00000000
768 1724082343878 GEN4_TO_CONTROLLER_LOG:GEN4_INIT_INT_LOG_ATtiny1627 Address = 00001121, Mask = 00000000
768 1724082343878 GEN4_TO_CONTROLLER_LOG:GEN4_INIT_INT_LOG_ATtiny1627 Address = 00821280, Mask = 000000ff
768 1724082343878 GEN4_TO_CONTROLLER_LOG:GEN4_INIT_INT_LOG_ATtiny1627 Address = 00821281, Mask = 000000ff
768 1724082343878 GEN4_TO_CONTROLLER_LOG:GEN4_INIT_INT_LOG_ATtiny1627 Address = 00821282, Mask = 00000083
768 1724082343878 GEN4_TO_CONTROLLER_LOG:GEN4_INIT_INT_LOG_ATtiny1627 Address = 00821285, Mask = 000000dd
768 1724082343878 GEN4_TO_CONTROLLER_LOG:GEN4_INIT_INT_LOG_ATtiny1627 Address = 00821286, Mask = 00000007
768 1724082343878 GEN4_TO_CONTROLLER_LOG:GEN4_INIT_INT_LOG_ATtiny1627 Address = 00821287, Mask = 000000ff
768 1724082343878 GEN4_TO_CONTROLLER_LOG:GEN4_INIT_INT_LOG_ATtiny1627 Address = 00821288, Mask = 000000ff
768 1724082343878 GEN4_TO_CONTROLLER_LOG:GEN4_INIT_INT_LOG_ATtiny1627 Address = 0083128a, Mask = 000000ff
768 1724082343878 GEN4_TO_CONTROLLER_LOG:GEN4_INIT_INT_LOG_ATtiny1627 BasicInfo: Values:
768 1724082343878 GEN4_TO_CONTROLLER_LOG:GEN4_INIT_INT_LOG_ATtiny1627 Payload End
768 1724082343946 GEN4_TO_CONTROLLER_LOG:GEN4_INIT_INT_LOG_ATtiny1627 Post:init
768 1724082343946 GEN4_TO_CONTROLLER_LOG:GEN4_INIT_INT_LOG_ATtiny1627 Return Value
768 1724082343946 GEN4_TO_CONTROLLER_LOG:GEN4_INIT_INT_LOG_ATtiny1627 none
768 1724082343946 GEN4_TO_CONTROLLER_LOG:GEN4_INIT_INT_LOG_ATtiny1627 Return End

768 1724082343946 GEN4_TO_CONTROLLER_LOG:GEN4_INIT_INT_LOG_ATtiny1627 Pre:GetInterfaceProvider
768 1724082343946 GEN4_TO_CONTROLLER_LOG:GEN4_INIT_INT_LOG_ATtiny1627 Payload
768 1724082343946 GEN4_TO_CONTROLLER_LOG:GEN4_INIT_INT_LOG_ATtiny1627 RI4DebugInterface
768 1724082343946 GEN4_TO_CONTROLLER_LOG:GEN4_INIT_INT_LOG_ATtiny1627 Payload End
768 1724082343947 GEN4_TO_CONTROLLER_LOG:GEN4_INIT_INT_LOG_ATtiny1627 Post:GetInterfaceProvider
768 1724082343947 GEN4_TO_CONTROLLER_LOG:GEN4_INIT_INT_LOG_ATtiny1627 Return Value
768 1724082343947 GEN4_TO_CONTROLLER_LOG:GEN4_INIT_INT_LOG_ATtiny1627 com.microchip.mplab.libs.atmelice.implementations.DebugInterface@3b72b1a2
768 1724082343947 GEN4_TO_CONTROLLER_LOG:GEN4_INIT_INT_LOG_ATtiny1627 Return End

768 1724082343973 GEN4_TO_CONTROLLER_LOG:GEN4_INIT_INT_LOG_ATtiny1627 Pre:GetInterfaceProvider
768 1724082343973 GEN4_TO_CONTROLLER_LOG:GEN4_INIT_INT_LOG_ATtiny1627 Payload
768 1724082343973 GEN4_TO_CONTROLLER_LOG:GEN4_INIT_INT_LOG_ATtiny1627 RI4ProgramInterface
768 1724082343973 GEN4_TO_CONTROLLER_LOG:GEN4_INIT_INT_LOG_ATtiny1627 Payload End
768 1724082343973 GEN4_TO_CONTROLLER_LOG:GEN4_INIT_INT_LOG_ATtiny1627 Post:GetInterfaceProvider
768 1724082343973 GEN4_TO_CONTROLLER_LOG:GEN4_INIT_INT_LOG_ATtiny1627 Return Value
768 1724082343973 GEN4_TO_CONTROLLER_LOG:GEN4_INIT_INT_LOG_ATtiny1627 com.microchip.mplab.libs.atmelice.implementations.ProgramInterface@36d14e93
768 1724082343973 GEN4_TO_CONTROLLER_LOG:GEN4_INIT_INT_LOG_ATtiny1627 Return End

768 1724082343985 GEN4_TO_CONTROLLER_LOG:GEN4_INIT_INT_LOG_ATtiny1627 Pre:GetInterfaceProvider
768 1724082343985 GEN4_TO_CONTROLLER_LOG:GEN4_INIT_INT_LOG_ATtiny1627 Payload
768 1724082343985 GEN4_TO_CONTROLLER_LOG:GEN4_INIT_INT_LOG_ATtiny1627 RI4ConnectInterface
768 1724082343985 GEN4_TO_CONTROLLER_LOG:GEN4_INIT_INT_LOG_ATtiny1627 Payload End
768 1724082343985 GEN4_TO_CONTROLLER_LOG:GEN4_INIT_INT_LOG_ATtiny1627 Post:GetInterfaceProvider
768 1724082343985 GEN4_TO_CONTROLLER_LOG:GEN4_INIT_INT_LOG_ATtiny1627 Return Value
768 1724082343985 GEN4_TO_CONTROLLER_LOG:GEN4_INIT_INT_LOG_ATtiny1627 com.microchip.mplab.libs.atmelice.implementations.ConnectInterface@333972ad
768 1724082343985 GEN4_TO_CONTROLLER_LOG:GEN4_INIT_INT_LOG_ATtiny1627 Return End

768 1724082343989 GEN4_TO_CONTROLLER_LOG:GEN4_INIT_INT_LOG_ATtiny1627 Pre:GetInterfaceProvider
768 1724082343989 GEN4_TO_CONTROLLER_LOG:GEN4_INIT_INT_LOG_ATtiny1627 Payload
768 1724082343989 GEN4_TO_CONTROLLER_LOG:GEN4_INIT_INT_LOG_ATtiny1627 RI4ControllerDiagnosticsInterface
768 1724082343989 GEN4_TO_CONTROLLER_LOG:GEN4_INIT_INT_LOG_ATtiny1627 Payload End
768 1724082343990 GEN4_TO_CONTROLLER_LOG:GEN4_INIT_INT_LOG_ATtiny1627 Post:GetInterfaceProvider
768 1724082343990 GEN4_TO_CONTROLLER_LOG:GEN4_INIT_INT_LOG_ATtiny1627 Return Value
768 1724082343990 GEN4_TO_CONTROLLER_LOG:GEN4_INIT_INT_LOG_ATtiny1627 com.microchip.mplab.libs.atmelice.implementations.UnimplementedDiagnostics@57326f74
768 1724082343990 GEN4_TO_CONTROLLER_LOG:GEN4_INIT_INT_LOG_ATtiny1627 Return End

768 1724082343990 GEN4_TO_CONTROLLER_LOG:GEN4_INIT_INT_LOG_ATtiny1627 Pre:GetInterfaceProvider
768 1724082343990 GEN4_TO_CONTROLLER_LOG:GEN4_INIT_INT_LOG_ATtiny1627 Payload
768 1724082343990 GEN4_TO_CONTROLLER_LOG:GEN4_INIT_INT_LOG_ATtiny1627 ProgrammerToGo
768 1724082343990 GEN4_TO_CONTROLLER_LOG:GEN4_INIT_INT_LOG_ATtiny1627 Payload End
768 1724082343990 GEN4_TO_CONTROLLER_LOG:GEN4_INIT_INT_LOG_ATtiny1627 Post:GetInterfaceProvider
768 1724082343990 GEN4_TO_CONTROLLER_LOG:GEN4_INIT_INT_LOG_ATtiny1627 Return Value
768 1724082343990 GEN4_TO_CONTROLLER_LOG:GEN4_INIT_INT_LOG_ATtiny1627 null
768 1724082343990 GEN4_TO_CONTROLLER_LOG:GEN4_INIT_INT_LOG_ATtiny1627 Return End

768 1724082343990 GEN4_TO_CONTROLLER_LOG:GEN4_INIT_INT_LOG_ATtiny1627 Pre:GetInterfaceProvider
768 1724082343990 GEN4_TO_CONTROLLER_LOG:GEN4_INIT_INT_LOG_ATtiny1627 Payload
768 1724082343990 GEN4_TO_CONTROLLER_LOG:GEN4_INIT_INT_LOG_ATtiny1627 Status
768 1724082343990 GEN4_TO_CONTROLLER_LOG:GEN4_INIT_INT_LOG_ATtiny1627 Payload End
768 1724082343990 GEN4_TO_CONTROLLER_LOG:GEN4_INIT_INT_LOG_ATtiny1627 Post:GetInterfaceProvider
768 1724082343990 GEN4_TO_CONTROLLER_LOG:GEN4_INIT_INT_LOG_ATtiny1627 Return Value
768 1724082343990 GEN4_TO_CONTROLLER_LOG:GEN4_INIT_INT_LOG_ATtiny1627 null
768 1724082343990 GEN4_TO_CONTROLLER_LOG:GEN4_INIT_INT_LOG_ATtiny1627 Return End

768 1724082344016 GEN4_TO_CONTROLLER_LOG:GEN4_CONNECT_INT_LOG Pre:EstablishCommunincations
768 1724082344016 GEN4_TO_CONTROLLER_LOG:GEN4_CONNECT_INT_LOG Payload
768 1724082344016 GEN4_TO_CONTROLLER_LOG:GEN4_CONNECT_INT_LOG com.microchip.mplab.mdbcore.AtmelIceScripting.AIceScriptingCom@2fca9b55
768 1724082344016 GEN4_TO_CONTROLLER_LOG:GEN4_CONNECT_INT_LOG Payload End
768 1724082344023 NativeController::EstablishCommunincations entry
768 1724082344026 pro JtagIce3 [0x00] <<< 00 00 00 
768 1724082344030 pro JtagIce3 [0x00] >>> 81 00 00 01 11 12 13 14 
768 1724082344031 pro JtagIce3 [0x01] <<< 10 00 
768 1724082344033 pro JtagIce3 [0x01] >>> 80 00 
768 1724082344035 pro JtagIce3 [0x00] <<< 00 00 03 
768 1724082344036 pro JtagIce3 [0x00] >>> 81 00 01 04 05 06 07 
768 1724082344043 pro JtagIce3 [0x01] <<< 02 00 01 20 02 
768 1724082344045 pro JtagIce3 [0x01] >>> 84 01 00 00 11 
768 1724082344047 NativeController::EstablishCommunincations exit
768 1724082344047 GEN4_TO_CONTROLLER_LOG:GEN4_CONNECT_INT_LOG Post:EstablishCommunincations
768 1724082344047 GEN4_TO_CONTROLLER_LOG:GEN4_CONNECT_INT_LOG Return Value
768 1724082344048 GEN4_TO_CONTROLLER_LOG:GEN4_CONNECT_INT_LOG true
768 1724082344048 GEN4_TO_CONTROLLER_LOG:GEN4_CONNECT_INT_LOG Return End

768 1724082344048 GEN4_TO_CONTROLLER_LOG:GEN4_CONNECT_INT_LOG Pre:GetFirmwareInfo
768 1724082344048 GEN4_TO_CONTROLLER_LOG:GEN4_CONNECT_INT_LOG Payload
768 1724082344048 GEN4_TO_CONTROLLER_LOG:GEN4_CONNECT_INT_LOG null
768 1724082344048 GEN4_TO_CONTROLLER_LOG:GEN4_CONNECT_INT_LOG Payload End
768 1724082344048 NativeController::GetFirmwareInfo entry
768 1724082344048 pro JtagIce3 [0x01] <<< 02 00 00 00 01 
768 1724082344051 pro JtagIce3 [0x01] >>> 84 01 00 00 
768 1724082344051 NativeController::getFirmwareVersion entry
768 1724082344051 pro JtagIce3 [0x01] <<< 02 00 00 01 01 
768 1724082344051 pro JtagIce3 [0x01] >>> 84 01 01 00 
768 1724082344051 pro JtagIce3 [0x01] <<< 02 00 00 02 01 
768 1724082344054 pro JtagIce3 [0x01] >>> 84 01 2D 00 
768 1724082344054 pro JtagIce3 [0x01] <<< 02 00 00 03 02 
768 1724082344055 pro JtagIce3 [0x01] >>> 84 01 07 00 00 
768 1724082344055 NativeController::getFirmwareVersion exit
768 1724082344055 pro JtagIce3 [0x01] <<< 02 00 00 09 01 
768 1724082344057 pro JtagIce3 [0x01] >>> 84 01 00 11 
768 1724082344057 NativeController::tryGetFPGAVersion entry
768 1724082344057 pro JtagIce3 [0x01] <<< 02 00 00 10 01 
768 1724082344058 pro JtagIce3 [0x01] >>> 84 01 00 11 
768 1724082344058 pro JtagIce3 [0x01] <<< 02 00 00 11 01 
768 1724082344060 pro JtagIce3 [0x01] >>> 84 01 00 11 
768 1724082344060 pro JtagIce3 [0x01] <<< 02 00 00 12 01 
768 1724082344061 pro JtagIce3 [0x01] >>> 84 01 00 11 
768 1724082344061 NativeController::tryGetFPGAVersion exit
768 1724082344061 NativeController::tryGetFPGAVersion exit with exception No value present
768 1724082344061 pro JtagIce3 [0x01] <<< 02 00 00 06 01 
768 1724082344062 pro JtagIce3 [0x01] >>> 84 01 05 00 
768 1724082344062 pro JtagIce3 [0x01] <<< 02 00 00 07 01 
768 1724082344063 pro JtagIce3 [0x01] >>> 84 01 05 00 
768 1724082344063 pro JtagIce3 [0x01] <<< 02 00 00 0A 01 
768 1724082344064 pro JtagIce3 [0x01] >>> 84 01 00 11 
768 1724082344065 NativeController::GetFirmwareInfo exit
768 1724082344065 GEN4_TO_CONTROLLER_LOG:GEN4_CONNECT_INT_LOG Post:GetFirmwareInfo
768 1724082344065 GEN4_TO_CONTROLLER_LOG:GEN4_CONNECT_INT_LOG Return Value
768 1724082344065 GEN4_TO_CONTROLLER_LOG:GEN4_CONNECT_INT_LOG FirmwareInfo: Values:
768 1724082344065 GEN4_TO_CONTROLLER_LOG:GEN4_CONNECT_INT_LOG FirmwareInfo: boot = false, bootVer = 5.5.0 (0x05.0x05.0x00), apVer = 1.45.7 (0x01.0x2d.0x07), fpgaVer = null, scriptVer = null, macAddress = , devID = 0, devID1 = 0, devSN0 = 0, devSN1 = 0, serialNumber = null, appCommitID = null, scriptCommitID = null, PCB_ID = 0
768 1724082344065 GEN4_TO_CONTROLLER_LOG:GEN4_CONNECT_INT_LOG Return End
768 1724082344067 GEN4_CONNECT_DIAGNOSTICS:ENTERING: com.microchip.mplab.mdbcore.RI4Tool.ConnectionHandler.CheckForFWUpdates()
768 1724082344068 GEN4_CONNECT_DIAGNOSTICS:Created FirmwareUpdateHandler com.microchip.mplab.mdbcore.AtmelIceScripting.OperationHandlers.AIceScriptingFirmwareUpdateHandler@12372fa8

768 1724082344086 GEN4_TO_CONTROLLER_LOG:GEN4_CONNECT_INT_LOG Pre:SetUpdateFirmwareInfo
768 1724082344086 GEN4_TO_CONTROLLER_LOG:GEN4_CONNECT_INT_LOG Payload
768 1724082344086 GEN4_TO_CONTROLLER_LOG:GEN4_CONNECT_INT_LOG UpdateFirmwareInfo: Values:
768 1724082344086 GEN4_TO_CONTROLLER_LOG:GEN4_CONNECT_INT_LOG UpdateFirmwareInfo: license = dCejLCt9ZV4fWdqYk3htQgdNYCC2nccSTvVdTD2oCjW3gRUtjikRtla11IiYo1wq, updateId = 2147483647
768 1724082344086 GEN4_TO_CONTROLLER_LOG:GEN4_CONNECT_INT_LOG Payload End
768 1724082344086 GEN4_TO_CONTROLLER_LOG:GEN4_CONNECT_INT_LOG Post:SetUpdateFirmwareInfo
768 1724082344086 GEN4_TO_CONTROLLER_LOG:GEN4_CONNECT_INT_LOG Return Value
768 1724082344086 GEN4_TO_CONTROLLER_LOG:GEN4_CONNECT_INT_LOG none
768 1724082344086 GEN4_TO_CONTROLLER_LOG:GEN4_CONNECT_INT_LOG Return End
768 1724082344087 GEN4_CONNECT_DIAGNOSTICS:EXITING: com.microchip.mplab.mdbcore.RI4Tool.ConnectionHandler.CheckForFWUpdates()

768 1724082344089 GEN4_TO_CONTROLLER_LOG:GEN4_CONNECT_INT_LOG Pre:SetPowerInfo
768 1724082344089 GEN4_TO_CONTROLLER_LOG:GEN4_CONNECT_INT_LOG Payload
768 1724082344089 GEN4_TO_CONTROLLER_LOG:GEN4_CONNECT_INT_LOG PowerInfo: Values:
768 1724082344089 GEN4_TO_CONTROLLER_LOG:GEN4_CONNECT_INT_LOG PowerInfo: shotDownSystem = false, isToolPower = false, voltage = 5.000000, useVppFirst = false, useLowVoltageProgramming = true, useMaintainActivePower = false
768 1724082344089 GEN4_TO_CONTROLLER_LOG:GEN4_CONNECT_INT_LOG Payload End
768 1724082344089 NativeController::GetVoltageInfo entry
768 1724082344089 pro JtagIce3 [0x01] <<< 02 00 01 00 02 
768 1724082344090 pro JtagIce3 [0x01] >>> 84 01 FC 10 00 
768 1724082344091 pro JtagIce3 [0x01] <<< 02 00 01 20 02 
768 1724082344092 pro JtagIce3 [0x01] >>> 84 01 00 00 11 
768 1724082344092 NativeController::GetVoltageInfo TSUP exit with exception + The requested command is not supported. (17)
768 1724082344092 pro JtagIce3 [0x01] <<< 02 00 01 02 02 
768 1724082344093 pro JtagIce3 [0x01] >>> 84 01 00 00 11 
768 1724082344093 NativeController::GetVoltageInfo VUSB exit with exception + The requested command is not supported. (17)
768 1724082344093 NativeController::GetVoltageInfo exit
768 1724082344093 GEN4_TO_CONTROLLER_LOG:GEN4_CONNECT_INT_LOG Post:SetPowerInfo
768 1724082344093 GEN4_TO_CONTROLLER_LOG:GEN4_CONNECT_INT_LOG Return Value
768 1724082344093 GEN4_TO_CONTROLLER_LOG:GEN4_CONNECT_INT_LOG none
768 1724082344094 GEN4_TO_CONTROLLER_LOG:GEN4_CONNECT_INT_LOG Return End

768 1724082344094 GEN4_TO_CONTROLLER_LOG:GEN4_CONNECT_INT_LOG Pre:GetVoltageInfo
768 1724082344094 GEN4_TO_CONTROLLER_LOG:GEN4_CONNECT_INT_LOG Payload
768 1724082344094 GEN4_TO_CONTROLLER_LOG:GEN4_CONNECT_INT_LOG null
768 1724082344094 GEN4_TO_CONTROLLER_LOG:GEN4_CONNECT_INT_LOG Payload End
768 1724082344094 NativeController::GetVoltageInfo entry
768 1724082344094 pro JtagIce3 [0x01] <<< 02 00 01 00 02 
768 1724082344095 pro JtagIce3 [0x01] >>> 84 01 FD 10 00 
768 1724082344095 pro JtagIce3 [0x01] <<< 02 00 01 20 02 
768 1724082344096 pro JtagIce3 [0x01] >>> 84 01 00 00 11 
768 1724082344096 NativeController::GetVoltageInfo TSUP exit with exception + The requested command is not supported. (17)
768 1724082344096 pro JtagIce3 [0x01] <<< 02 00 01 02 02 
768 1724082344098 pro JtagIce3 [0x01] >>> 84 01 00 00 11 
768 1724082344098 NativeController::GetVoltageInfo VUSB exit with exception + The requested command is not supported. (17)
768 1724082344098 NativeController::GetVoltageInfo exit
768 1724082344098 GEN4_TO_CONTROLLER_LOG:GEN4_CONNECT_INT_LOG Post:GetVoltageInfo
768 1724082344098 GEN4_TO_CONTROLLER_LOG:GEN4_CONNECT_INT_LOG Return Value
768 1724082344098 GEN4_TO_CONTROLLER_LOG:GEN4_CONNECT_INT_LOG VoltagesInfo: Values:
768 1724082344098 GEN4_TO_CONTROLLER_LOG:GEN4_CONNECT_INT_LOG VoltagesInfo: internalVdd = 0, internalVpp = 0, targetVdd = 0, targetVpp = -2147483648, vddSense = 4349, temp = 0, vddCurrentSense = 0, vddVoltageSense = -2147483648
768 1724082344098 GEN4_TO_CONTROLLER_LOG:GEN4_CONNECT_INT_LOG Return End

768 1724082344098 GEN4_TO_CONTROLLER_LOG:GEN4_CONNECT_INT_LOG Pre:SetLEDBrightness
768 1724082344098 GEN4_TO_CONTROLLER_LOG:GEN4_CONNECT_INT_LOG Payload
768 1724082344098 GEN4_TO_CONTROLLER_LOG:GEN4_CONNECT_INT_LOG 5
768 1724082344098 GEN4_TO_CONTROLLER_LOG:GEN4_CONNECT_INT_LOG Payload End
768 1724082344098 GEN4_TO_CONTROLLER_LOG:GEN4_CONNECT_INT_LOG Post:SetLEDBrightness
768 1724082344098 GEN4_TO_CONTROLLER_LOG:GEN4_CONNECT_INT_LOG Return Value
768 1724082344098 GEN4_TO_CONTROLLER_LOG:GEN4_CONNECT_INT_LOG none
768 1724082344098 GEN4_TO_CONTROLLER_LOG:GEN4_CONNECT_INT_LOG Return End

768 1724082344098 GEN4_TO_CONTROLLER_LOG:GEN4_CONNECT_INT_LOG Pre:SetToolInfo
768 1724082344098 GEN4_TO_CONTROLLER_LOG:GEN4_CONNECT_INT_LOG Payload
768 1724082344098 GEN4_TO_CONTROLLER_LOG:GEN4_CONNECT_INT_LOG ToolInfo: Values:
768 1724082344098 GEN4_TO_CONTROLLER_LOG:GEN4_CONNECT_INT_LOG ToolInfo: speedLevel = 1, PGCResistance = 4700, PGDResistance = 4700, PGCPullDir = PullDown, PGDPullDir = PullDown, ICSPSelected = Wire2
768 1724082344098 GEN4_TO_CONTROLLER_LOG:GEN4_CONNECT_INT_LOG Payload End
768 1724082344098 GEN4_TO_CONTROLLER_LOG:GEN4_CONNECT_INT_LOG Post:SetToolInfo
768 1724082344098 GEN4_TO_CONTROLLER_LOG:GEN4_CONNECT_INT_LOG Return Value
768 1724082344098 GEN4_TO_CONTROLLER_LOG:GEN4_CONNECT_INT_LOG none
768 1724082344098 GEN4_TO_CONTROLLER_LOG:GEN4_CONNECT_INT_LOG Return End

768 1724082344099 GEN4_TO_CONTROLLER_LOG:GEN4_CONNECT_INT_LOG Pre:GetTargetIDInfo
768 1724082344099 GEN4_TO_CONTROLLER_LOG:GEN4_CONNECT_INT_LOG Payload
768 1724082344099 GEN4_TO_CONTROLLER_LOG:GEN4_CONNECT_INT_LOG null
768 1724082344099 GEN4_TO_CONTROLLER_LOG:GEN4_CONNECT_INT_LOG Payload End
768 1724082344099 NativeController::GetTargetIDInfo entry
768 1724082344100 pro JtagIce3 [0x12] <<< 01 00 01 31 02 F4 01 
768 1724082344101 pro JtagIce3 [0x12] >>> 80 00 
768 1724082344101 pro JtagIce3 [0x12] <<< 01 00 00 00 01 05 
768 1724082344102 pro JtagIce3 [0x12] >>> 80 00 
768 1724082344103 pro JtagIce3 [0x12] <<< 01 00 00 01 01 01 
768 1724082344104 pro JtagIce3 [0x12] >>> 80 00 
768 1724082344104 pro JtagIce3 [0x12] <<< 01 00 01 00 01 08 
768 1724082344106 pro JtagIce3 [0x12] >>> 80 00 
768 1724082344106 pro JtagIce3 [0x12] <<< 01 00 02 00 30 00 80 40 20 00 10 80 0F 94 11 8C 0A 98 08 DC 05 EE 02 00 40 00 00 00 01 20 00 0A 05 FF 00 FF 00 00 14 00 13 00 11 80 12 8A 12 28 94 00 00 00 00 
768 1724082344108 pro JtagIce3 [0x12] >>> 80 00 
768 1724082344108 pro JtagIce3 [0x12] <<< 01 00 03 06 01 00 
768 1724082344109 pro JtagIce3 [0x12] >>> 80 00 
768 1724082344110 pro JtagIce3 [0x12] <<< 10 00 00 
768 1724082344123 pro JtagIce3 [0x12] >>> 84 00 74 69 6E 79 00 
768 1724082344123 pro JtagIce3 [0x12] <<< 01 00 03 06 01 00 
768 1724082344124 pro JtagIce3 [0x12] >>> 80 00 
768 1724082344125 pro JtagIce3 [0x12] <<< 15 00 
768 1724082344191 pro JtagIce3 [0x12] >>> 80 00 
768 1724082344192 pro JtagIce3 [0x12] <<< 21 00 B4 00 11 00 00 03 00 00 00 
768 1724082344193 pro JtagIce3 [0x12] >>> 84 00 1E 94 28 00 
768 1724082344196 pro JtagIce3 [0x12] <<< 21 00 B4 00 11 00 00 03 00 00 00 
768 1724082344198 pro JtagIce3 [0x12] >>> 84 00 1E 94 28 00 
768 1724082344198 pro JtagIce3 [0x12] <<< 21 00 B4 00 11 00 00 03 00 00 00 
768 1724082344199 pro JtagIce3 [0x12] >>> 84 00 1E 94 28 00 
768 1724082344199 pro JtagIce3 [0x12] <<< 21 00 B2 01 0F 00 00 01 00 00 00 
768 1724082344201 pro JtagIce3 [0x12] >>> 84 00 04 00 
768 1724082344201 pro JtagIce3 [0x12] <<< 16 00 
768 1724082344204 pro JtagIce3 [0x12] >>> 80 00 
768 1724082344204 pro JtagIce3 [0x12] <<< 11 00 
768 1724082344204 pro JtagIce3 [0x12] >>> 80 00 
768 1724082344204 pro JtagIce3 [0x01] <<< 11 00 00 
768 1724082344206 pro JtagIce3 [0x01] >>> 80 00 
768 1724082344206 NativeController::GetTargetIDInfo exit device ID 0x1e9428
768 1724082344206 GEN4_TO_CONTROLLER_LOG:GEN4_CONNECT_INT_LOG Post:GetTargetIDInfo
768 1724082344206 GEN4_TO_CONTROLLER_LOG:GEN4_CONNECT_INT_LOG Return Value
768 1724082344206 GEN4_TO_CONTROLLER_LOG:GEN4_CONNECT_INT_LOG TargetIDInfo: Values:
768 1724082344206 GEN4_TO_CONTROLLER_LOG:GEN4_CONNECT_INT_LOG TargetIDInfo: DeviceID = 001e9428
768 1724082344206 GEN4_TO_CONTROLLER_LOG:GEN4_CONNECT_INT_LOG Return End

768 1724082344265 GEN4_TO_CONTROLLER_LOG:GEN4_PROGRAM_INT_LOG_ATtiny1627 Pre:SendOperation
768 1724082344265 GEN4_TO_CONTROLLER_LOG:GEN4_PROGRAM_INT_LOG_ATtiny1627 Payload
768 1724082344265 GEN4_TO_CONTROLLER_LOG:GEN4_PROGRAM_INT_LOG_ATtiny1627 OperationInfo: Values:
768 1724082344265 GEN4_TO_CONTROLLER_LOG:GEN4_PROGRAM_INT_LOG_ATtiny1627 OperationInfo: Type = erase, Mask = 00000000, Erase = false, Production Mode = true
768 1724082344265 GEN4_TO_CONTROLLER_LOG:GEN4_PROGRAM_INT_LOG_ATtiny1627 TransferInfo: Start = 0, End = 3fff, Buffer Length = 0, Type = Pgm, Mask = 00000000
768 1724082344265 GEN4_TO_CONTROLLER_LOG:GEN4_PROGRAM_INT_LOG_ATtiny1627 TransferInfo: Start = 1280, End = 1288, Buffer Length = 0, Type = Cfg, Mask = 00000000
768 1724082344265 GEN4_TO_CONTROLLER_LOG:GEN4_PROGRAM_INT_LOG_ATtiny1627 TransferInfo: Start = 128a, End = 128a, Buffer Length = 0, Type = Cfg, Mask = 00000000
768 1724082344265 GEN4_TO_CONTROLLER_LOG:GEN4_PROGRAM_INT_LOG_ATtiny1627 TransferInfo: Start = 1400, End = 14ff, Buffer Length = 0, Type = EEData, Mask = 00000000
768 1724082344265 GEN4_TO_CONTROLLER_LOG:GEN4_PROGRAM_INT_LOG_ATtiny1627 TransferInfo: Start = 1300, End = 131f, Buffer Length = 0, Type = UserID, Mask = 00000000
768 1724082344265 GEN4_TO_CONTROLLER_LOG:GEN4_PROGRAM_INT_LOG_ATtiny1627 Payload End
768 1724082344266 pro JtagIce3 [0x12] <<< 01 00 01 31 02 F4 01 
768 1724082344267 pro JtagIce3 [0x12] >>> 80 00 
768 1724082344267 pro JtagIce3 [0x12] <<< 01 00 00 00 01 05 
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
768 1724082344925 GEN4_TO_CONTROLLER_LOG:GEN4_PROGRAM_INT_LOG_ATtiny1627 Return Value
768 1724082344925 GEN4_TO_CONTROLLER_LOG:GEN4_PROGRAM_INT_LOG_ATtiny1627 None
768 1724082344925 GEN4_TO_CONTROLLER_LOG:GEN4_PROGRAM_INT_LOG_ATtiny1627 Return End

768 1724082344929 GEN4_TO_CONTROLLER_LOG:GEN4_PROGRAM_INT_LOG_ATtiny1627 Pre:SendOperation
768 1724082344929 GEN4_TO_CONTROLLER_LOG:GEN4_PROGRAM_INT_LOG_ATtiny1627 Payload
768 1724082344929 GEN4_TO_CONTROLLER_LOG:GEN4_PROGRAM_INT_LOG_ATtiny1627 OperationInfo: Values:
768 1724082344929 GEN4_TO_CONTROLLER_LOG:GEN4_PROGRAM_INT_LOG_ATtiny1627 OperationInfo: Type = releasefromreset, Mask = 00000000, Erase = false, Production Mode = true
768 1724082344929 GEN4_TO_CONTROLLER_LOG:GEN4_PROGRAM_INT_LOG_ATtiny1627 Payload End
768 1724082344929 pro JtagIce3 [0x01] <<< 11 00 00 
768 1724082344930 pro JtagIce3 [0x01] >>> 80 00 
768 1724082344930 GEN4_TO_CONTROLLER_LOG:GEN4_PROGRAM_INT_LOG_ATtiny1627 Post:SendOperation
768 1724082344930 GEN4_TO_CONTROLLER_LOG:GEN4_PROGRAM_INT_LOG_ATtiny1627 Return Value
768 1724082344930 GEN4_TO_CONTROLLER_LOG:GEN4_PROGRAM_INT_LOG_ATtiny1627 None
768 1724082344930 GEN4_TO_CONTROLLER_LOG:GEN4_PROGRAM_INT_LOG_ATtiny1627 Return End
768 1724082344931 GEN4_CONNECT_DIAGNOSTICS:MPLABCommTool is null

768 1724082344931 GEN4_TO_CONTROLLER_LOG:GEN4_CONNECT_INT_LOG Pre:GetFirmwareInfo
768 1724082344931 GEN4_TO_CONTROLLER_LOG:GEN4_CONNECT_INT_LOG Payload
768 1724082344931 GEN4_TO_CONTROLLER_LOG:GEN4_CONNECT_INT_LOG null
768 1724082344931 GEN4_TO_CONTROLLER_LOG:GEN4_CONNECT_INT_LOG Payload End
768 1724082344931 NativeController::GetFirmwareInfo entry
768 1724082344931 pro JtagIce3 [0x01] <<< 02 00 00 00 01 
768 1724082344932 pro JtagIce3 [0x01] >>> 84 01 00 00 
768 1724082344932 NativeController::getFirmwareVersion entry
768 1724082344932 pro JtagIce3 [0x01] <<< 02 00 00 01 01 
768 1724082344934 pro JtagIce3 [0x01] >>> 84 01 01 00 
768 1724082344934 pro JtagIce3 [0x01] <<< 02 00 00 02 01 
768 1724082344935 pro JtagIce3 [0x01] >>> 84 01 2D 00 
768 1724082344935 pro JtagIce3 [0x01] <<< 02 00 00 03 02 
768 1724082344937 pro JtagIce3 [0x01] >>> 84 01 07 00 00 
768 1724082344937 NativeController::getFirmwareVersion exit
768 1724082344937 pro JtagIce3 [0x01] <<< 02 00 00 09 01 
768 1724082344938 pro JtagIce3 [0x01] >>> 84 01 00 11 
768 1724082344938 NativeController::tryGetFPGAVersion entry
768 1724082344938 pro JtagIce3 [0x01] <<< 02 00 00 10 01 
768 1724082344939 pro JtagIce3 [0x01] >>> 84 01 00 11 
768 1724082344940 pro JtagIce3 [0x01] <<< 02 00 00 11 01 
768 1724082344941 pro JtagIce3 [0x01] >>> 84 01 00 11 
768 1724082344941 pro JtagIce3 [0x01] <<< 02 00 00 12 01 
768 1724082344942 pro JtagIce3 [0x01] >>> 84 01 00 11 
768 1724082344942 NativeController::tryGetFPGAVersion exit
768 1724082344942 NativeController::tryGetFPGAVersion exit with exception No value present
768 1724082344943 pro JtagIce3 [0x01] <<< 02 00 00 06 01 
768 1724082344944 pro JtagIce3 [0x01] >>> 84 01 05 00 
768 1724082344944 pro JtagIce3 [0x01] <<< 02 00 00 07 01 
768 1724082344946 pro JtagIce3 [0x01] >>> 84 01 05 00 
768 1724082344946 pro JtagIce3 [0x01] <<< 02 00 00 0A 01 
768 1724082344947 pro JtagIce3 [0x01] >>> 84 01 00 11 
768 1724082344947 NativeController::GetFirmwareInfo exit
768 1724082344947 GEN4_TO_CONTROLLER_LOG:GEN4_CONNECT_INT_LOG Post:GetFirmwareInfo
768 1724082344947 GEN4_TO_CONTROLLER_LOG:GEN4_CONNECT_INT_LOG Return Value
768 1724082344947 GEN4_TO_CONTROLLER_LOG:GEN4_CONNECT_INT_LOG FirmwareInfo: Values:
768 1724082344947 GEN4_TO_CONTROLLER_LOG:GEN4_CONNECT_INT_LOG FirmwareInfo: boot = false, bootVer = 5.5.0 (0x05.0x05.0x00), apVer = 1.45.7 (0x01.0x2d.0x07), fpgaVer = null, scriptVer = null, macAddress = , devID = 0, devID1 = 0, devSN0 = 0, devSN1 = 0, serialNumber = null, appCommitID = null, scriptCommitID = null, PCB_ID = 0
768 1724082344947 GEN4_TO_CONTROLLER_LOG:GEN4_CONNECT_INT_LOG Return End

768 1724082344947 GEN4_TO_CONTROLLER_LOG:GEN4_CONNECT_INT_LOG Pre:SetPowerInfo
768 1724082344947 GEN4_TO_CONTROLLER_LOG:GEN4_CONNECT_INT_LOG Payload
768 1724082344947 GEN4_TO_CONTROLLER_LOG:GEN4_CONNECT_INT_LOG PowerInfo: Values:
768 1724082344947 GEN4_TO_CONTROLLER_LOG:GEN4_CONNECT_INT_LOG PowerInfo: shotDownSystem = true, isToolPower = false, voltage = 0.000000, useVppFirst = false, useLowVoltageProgramming = true, useMaintainActivePower = false
768 1724082344947 GEN4_TO_CONTROLLER_LOG:GEN4_CONNECT_INT_LOG Payload End
768 1724082344947 NativeController::GetVoltageInfo entry
768 1724082344947 pro JtagIce3 [0x01] <<< 02 00 01 00 02 
768 1724082344949 pro JtagIce3 [0x01] >>> 84 01 1F 11 00 
768 1724082344949 pro JtagIce3 [0x01] <<< 02 00 01 20 02 
768 1724082344950 pro JtagIce3 [0x01] >>> 84 01 00 00 11 
768 1724082344950 NativeController::GetVoltageInfo TSUP exit with exception + The requested command is not supported. (17)
768 1724082344950 pro JtagIce3 [0x01] <<< 02 00 01 02 02 
768 1724082344951 pro JtagIce3 [0x01] >>> 84 01 00 00 11 
768 1724082344951 NativeController::GetVoltageInfo VUSB exit with exception + The requested command is not supported. (17)
768 1724082344951 NativeController::GetVoltageInfo exit
768 1724082344951 GEN4_TO_CONTROLLER_LOG:GEN4_CONNECT_INT_LOG Post:SetPowerInfo
768 1724082344951 GEN4_TO_CONTROLLER_LOG:GEN4_CONNECT_INT_LOG Return Value
768 1724082344951 GEN4_TO_CONTROLLER_LOG:GEN4_CONNECT_INT_LOG none
768 1724082344952 GEN4_TO_CONTROLLER_LOG:GEN4_CONNECT_INT_LOG Return End

768 1724082344952 GEN4_TO_CONTROLLER_LOG:GEN4_CONNECT_INT_LOG Pre:Disconnect
768 1724082344952 GEN4_TO_CONTROLLER_LOG:GEN4_CONNECT_INT_LOG Payload
768 1724082344952 GEN4_TO_CONTROLLER_LOG:GEN4_CONNECT_INT_LOG Payload End
768 1724082344952 NativeController::Disconnect entry
768 1724082344952 pro JtagIce3 [0x01] <<< 11 00 00 
768 1724082344953 pro JtagIce3 [0x01] >>> 80 00 
768 1724082344953 NativeController::Disconnect exit
768 1724082344953 GEN4_TO_CONTROLLER_LOG:GEN4_CONNECT_INT_LOG Post:Disconnect
768 1724082344953 GEN4_TO_CONTROLLER_LOG:GEN4_CONNECT_INT_LOG Return Value
768 1724082344953 GEN4_TO_CONTROLLER_LOG:GEN4_CONNECT_INT_LOG none
768 1724082344953 GEN4_TO_CONTROLLER_LOG:GEN4_CONNECT_INT_LOG Return End
768 1724082344953 GEN4_CONNECT_DIAGNOSTICS:Removing plug and play observer com.microchip.mplab.mdbcore.RI4Tool.RI4ToolBase$RI4PlugNPlayObserver@75d7fd1f
768 1724082344953 GEN4_CONNECT_DIAGNOSTICS:Begin PlugNPlayObservers list dump:
768 1724082344953 GEN4_CONNECT_DIAGNOSTICS:End PlugNPlayObservers list dump:
768 1724082345054 GEN4_CONNECT_DIAGNOSTICS:Calling RIDbgToolCom.Disconnect
768 1724082345054 GEN4_CONNECT_DIAGNOSTICS:Calling MPLABCommTool.Detach to remove tool from plug and play list
768 1724082345054 GEN4_CONNECT_DIAGNOSTICS:Calling RIDbgToolCom.DisconnectFromMPlabComm
768 1724082345054 GEN4_CONNECT_DIAGNOSTICS:Calling MPLABCommTool.Disconnect
1349 1724099441030 GEN4_CONNECT_DIAGNOSTICS:MPLABCommTool is NOT null
1349 1724099441030 GEN4_CONNECT_DIAGNOSTICS:AttachedToolPID = 2141, AttachedToolVID = 3eb
1349 1724099441030 GEN4_CONNECT_DIAGNOSTICS:transport type = USB
1349 1724099441030 GEN4_CONNECT_DIAGNOSTICS:AttachedToolPID = 2141, AttachedToolVID = 3eb
1349 1724099441035 com.microchip.mplab.mdbcore.RealICETool.RIDbgToolCom
1349 1724099441035 GEN4_CONNECT_DIAGNOSTICS:Before MPLABCommTool.Connect()
1349 1724099441035 GEN4_CONNECT_DIAGNOSTICS:After MPLABCommTool.Connect()
1349 1724099441035 GEN4_CONNECT_DIAGNOSTICS:MPLABCommTool.Connect() returned MPLABCOMM_NO_ERROR
1349 1724099441035 GEN4_CONNECT_DIAGNOSTICS:Attaching to MPLABCommTool plugnplay
1349 1724099441035 GEN4_CONNECT_DIAGNOSTICS:Adding new plug and play observer com.microchip.mplab.mdbcore.RI4Tool.RI4ToolBase$RI4PlugNPlayObserver@37c3e317
1349 1724099441035 GEN4_CONNECT_DIAGNOSTICS:Begin PlugNPlayObservers list dump:
1349 1724099441035 GEN4_CONNECT_DIAGNOSTICS:com.microchip.mplab.mdbcore.RI4Tool.RI4ToolBase$RI4PlugNPlayObserver@37c3e317
1349 1724099441035 GEN4_CONNECT_DIAGNOSTICS:End PlugNPlayObservers list dump:
1349 1724099441036 GEN4_CONNECT_DIAGNOSTICS:Registering for alternate PNP notifications. CommPnPCriteria.cPIDList = [2177, 2179, 217a, 2142, 2142], CommPnPCriteria.cSerialNumber = j42700073141

1349 1724099441061 GEN4_TO_CONTROLLER_LOG:GEN4_INIT_INT_LOG_ATtiny1627 Pre:init
1349 1724099441061 GEN4_TO_CONTROLLER_LOG:GEN4_INIT_INT_LOG_ATtiny1627 Payload
1349 1724099441061 GEN4_TO_CONTROLLER_LOG:GEN4_INIT_INT_LOG_ATtiny1627 DeviceInfo: Values:
1349 1724099441061 GEN4_TO_CONTROLLER_LOG:GEN4_INIT_INT_LOG_ATtiny1627 DeviceInfo: pcAddress = 7fffffffffffffff, Vpp = 5.00, useRowEraseIfVoltageIsLow = false, voltageBelowWhichUseRowErase = 0.00, deviceName = ATtiny1627, programmerType = 
1349 1724099441061 GEN4_TO_CONTROLLER_LOG:GEN4_INIT_INT_LOG_ATtiny1627 DeviceInfo: MemInfo values:
1349 1724099441062 GEN4_TO_CONTROLLER_LOG:GEN4_INIT_INT_LOG_ATtiny1627 DeviceInfo: mask = ffff, exists = true, startAddr = 00000000, endAddr = 00003fff, rowSize = 0040, rowEraseSize = 0040, addrInc = 0001, widthProgram = 0001
1349 1724099441062 GEN4_TO_CONTROLLER_LOG:GEN4_INIT_INT_LOG_ATtiny1627 DeviceInfo: mask = 00ff, exists = true, startAddr = 00821280, endAddr = 0083128a, rowSize = 0001, rowEraseSize = 0000, addrInc = 0001, widthProgram = 0001
1349 1724099441062 GEN4_TO_CONTROLLER_LOG:GEN4_INIT_INT_LOG_ATtiny1627 DeviceInfo: mask = 0000, exists = false, startAddr = 00000000, endAddr = 00000000, rowSize = 0000, rowEraseSize = 0000, addrInc = 0000, widthProgram = 0000
1349 1724099441062 GEN4_TO_CONTROLLER_LOG:GEN4_INIT_INT_LOG_ATtiny1627 DeviceInfo: mask = 00ff, exists = true, startAddr = 00001400, endAddr = 000014ff, rowSize = 0020, rowEraseSize = 0000, addrInc = 0001, widthProgram = 0001
1349 1724099441062 GEN4_TO_CONTROLLER_LOG:GEN4_INIT_INT_LOG_ATtiny1627 DeviceInfo: mask = 00ff, exists = true, startAddr = 00001300, endAddr = 0000131f, rowSize = 0020, rowEraseSize = 0000, addrInc = 0001, widthProgram = 0001
1349 1724099441062 GEN4_TO_CONTROLLER_LOG:GEN4_INIT_INT_LOG_ATtiny1627 DeviceInfo: mask = 0000, exists = false, startAddr = 00000000, endAddr = 00000000, rowSize = 0000, rowEraseSize = 0040, addrInc = 0000, widthProgram = 0000
1349 1724099441062 GEN4_TO_CONTROLLER_LOG:GEN4_INIT_INT_LOG_ATtiny1627 DeviceInfo: mask = 0000, exists = false, startAddr = 00000000, endAddr = 00000000, rowSize = 0000, rowEraseSize = 0000, addrInc = 0001, widthProgram = 0001
1349 1724099441062 GEN4_TO_CONTROLLER_LOG:GEN4_INIT_INT_LOG_ATtiny1627 DeviceInfo: mask = 0000, exists = false, startAddr = 00000000, endAddr = 00000000, rowSize = 0000, rowEraseSize = 0000, addrInc = 0000, widthProgram = 0000
1349 1724099441062 GEN4_TO_CONTROLLER_LOG:GEN4_INIT_INT_LOG_ATtiny1627 DeviceInfo: mask = 0000, exists = false, startAddr = 00000000, endAddr = 00000000, rowSize = 0000, rowEraseSize = 0000, addrInc = 0000, widthProgram = 0000
1349 1724099441062 GEN4_TO_CONTROLLER_LOG:GEN4_INIT_INT_LOG_ATtiny1627 DeviceInfo: mask = 0000, exists = false, startAddr = 00000000, endAddr = 00000000, rowSize = 0000, rowEraseSize = 0000, addrInc = 0000, widthProgram = 0000
1349 1724099441062 GEN4_TO_CONTROLLER_LOG:GEN4_INIT_INT_LOG_ATtiny1627 DeviceInfo: mask = 0000, exists = false, startAddr = 00000000, endAddr = 00000000, rowSize = 0000, rowEraseSize = 0000, addrInc = 0000, widthProgram = 0000
1349 1724099441062 GEN4_TO_CONTROLLER_LOG:GEN4_INIT_INT_LOG_ATtiny1627 DeviceInfo: mask = 0000, exists = false, startAddr = 00000000, endAddr = 00000000, rowSize = 0000, rowEraseSize = 0000, addrInc = 0001, widthProgram = 0001
1349 1724099441062 GEN4_TO_CONTROLLER_LOG:GEN4_INIT_INT_LOG_ATtiny1627 DeviceInfo: mask = 0000, exists = false, startAddr = 00000000, endAddr = 00000000, rowSize = 0000, rowEraseSize = 0000, addrInc = 0000, widthProgram = 0000
1349 1724099441062 GEN4_TO_CONTROLLER_LOG:GEN4_INIT_INT_LOG_ATtiny1627 DeviceInfo: mask = 0000, exists = false, startAddr = 00000000, endAddr = 00000000, rowSize = 0000, rowEraseSize = 0000, addrInc = 0000, widthProgram = 0000
1349 1724099441062 GEN4_TO_CONTROLLER_LOG:GEN4_INIT_INT_LOG_ATtiny1627 DeviceInfo: mask = 0000, exists = false, startAddr = 00000000, endAddr = 00000000, rowSize = 0000, rowEraseSize = 0000, addrInc = 0000, widthProgram = 0000
1349 1724099441062 GEN4_TO_CONTROLLER_LOG:GEN4_INIT_INT_LOG_ATtiny1627 DeviceInfo: mask = 0000, exists = false, startAddr = 00000000, endAddr = 00000000, rowSize = 0000, rowEraseSize = 0000, addrInc = 0000, widthProgram = 0000
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
1349 1724099441063 GEN4_TO_CONTROLLER_LOG:GEN4_INIT_INT_LOG_ATtiny1627 com.microchip.mplab.libs.atmelice.implementations.ConnectInterface@382efb42
1349 1724099441063 GEN4_TO_CONTROLLER_LOG:GEN4_INIT_INT_LOG_ATtiny1627 Return End

1349 1724099441063 GEN4_TO_CONTROLLER_LOG:GEN4_INIT_INT_LOG_ATtiny1627 Pre:GetInterfaceProvider
1349 1724099441063 GEN4_TO_CONTROLLER_LOG:GEN4_INIT_INT_LOG_ATtiny1627 Payload
1349 1724099441064 GEN4_TO_CONTROLLER_LOG:GEN4_INIT_INT_LOG_ATtiny1627 RI4ControllerDiagnosticsInterface
1349 1724099441064 GEN4_TO_CONTROLLER_LOG:GEN4_INIT_INT_LOG_ATtiny1627 Payload End
1349 1724099441064 GEN4_TO_CONTROLLER_LOG:GEN4_INIT_INT_LOG_ATtiny1627 Post:GetInterfaceProvider
1349 1724099441064 GEN4_TO_CONTROLLER_LOG:GEN4_INIT_INT_LOG_ATtiny1627 Return Value
1349 1724099441064 GEN4_TO_CONTROLLER_LOG:GEN4_INIT_INT_LOG_ATtiny1627 com.microchip.mplab.libs.atmelice.implementations.UnimplementedDiagnostics@3a5b1e12
1349 1724099441064 GEN4_TO_CONTROLLER_LOG:GEN4_INIT_INT_LOG_ATtiny1627 Return End

1349 1724099441064 GEN4_TO_CONTROLLER_LOG:GEN4_INIT_INT_LOG_ATtiny1627 Pre:GetInterfaceProvider
1349 1724099441064 GEN4_TO_CONTROLLER_LOG:GEN4_INIT_INT_LOG_ATtiny1627 Payload
1349 1724099441064 GEN4_TO_CONTROLLER_LOG:GEN4_INIT_INT_LOG_ATtiny1627 ProgrammerToGo
1349 1724099441064 GEN4_TO_CONTROLLER_LOG:GEN4_INIT_INT_LOG_ATtiny1627 Payload End
1349 1724099441064 GEN4_TO_CONTROLLER_LOG:GEN4_INIT_INT_LOG_ATtiny1627 Post:GetInterfaceProvider
1349 1724099441064 GEN4_TO_CONTROLLER_LOG:GEN4_INIT_INT_LOG_ATtiny1627 Return Value
1349 1724099441064 GEN4_TO_CONTROLLER_LOG:GEN4_INIT_INT_LOG_ATtiny1627 null
1349 1724099441064 GEN4_TO_CONTROLLER_LOG:GEN4_INIT_INT_LOG_ATtiny1627 Return End

1349 1724099441064 GEN4_TO_CONTROLLER_LOG:GEN4_INIT_INT_LOG_ATtiny1627 Pre:GetInterfaceProvider
1349 1724099441064 GEN4_TO_CONTROLLER_LOG:GEN4_INIT_INT_LOG_ATtiny1627 Payload
1349 1724099441064 GEN4_TO_CONTROLLER_LOG:GEN4_INIT_INT_LOG_ATtiny1627 Status
1349 1724099441064 GEN4_TO_CONTROLLER_LOG:GEN4_INIT_INT_LOG_ATtiny1627 Payload End
1349 1724099441064 GEN4_TO_CONTROLLER_LOG:GEN4_INIT_INT_LOG_ATtiny1627 Post:GetInterfaceProvider
1349 1724099441064 GEN4_TO_CONTROLLER_LOG:GEN4_INIT_INT_LOG_ATtiny1627 Return Value
1349 1724099441064 GEN4_TO_CONTROLLER_LOG:GEN4_INIT_INT_LOG_ATtiny1627 null
1349 1724099441064 GEN4_TO_CONTROLLER_LOG:GEN4_INIT_INT_LOG_ATtiny1627 Return End

1349 1724099441084 GEN4_TO_CONTROLLER_LOG:GEN4_CONNECT_INT_LOG Pre:EstablishCommunincations
1349 1724099441084 GEN4_TO_CONTROLLER_LOG:GEN4_CONNECT_INT_LOG Payload
1349 1724099441084 GEN4_TO_CONTROLLER_LOG:GEN4_CONNECT_INT_LOG com.microchip.mplab.mdbcore.AtmelIceScripting.AIceScriptingCom@5491b614
1349 1724099441084 GEN4_TO_CONTROLLER_LOG:GEN4_CONNECT_INT_LOG Payload End
1349 1724099441084 NativeController::EstablishCommunincations entry
1349 1724099441084 pro JtagIce3 [0x00] <<< 00 00 00 
1349 1724099441086 pro JtagIce3 [0x00] >>> 81 00 00 01 11 12 13 14 
1349 1724099441086 pro JtagIce3 [0x01] <<< 10 00 
1349 1724099441089 pro JtagIce3 [0x01] >>> 80 00 
1349 1724099441089 pro JtagIce3 [0x00] <<< 00 00 03 
1349 1724099441090 pro JtagIce3 [0x00] >>> 81 00 01 04 05 06 07 
1349 1724099441090 pro JtagIce3 [0x01] <<< 02 00 01 20 02 
1349 1724099441091 pro JtagIce3 [0x01] >>> 84 01 00 00 11 
1349 1724099441091 NativeController::EstablishCommunincations exit
1349 1724099441091 GEN4_TO_CONTROLLER_LOG:GEN4_CONNECT_INT_LOG Post:EstablishCommunincations
1349 1724099441091 GEN4_TO_CONTROLLER_LOG:GEN4_CONNECT_INT_LOG Return Value
1349 1724099441091 GEN4_TO_CONTROLLER_LOG:GEN4_CONNECT_INT_LOG true
1349 1724099441091 GEN4_TO_CONTROLLER_LOG:GEN4_CONNECT_INT_LOG Return End

1349 1724099441091 GEN4_TO_CONTROLLER_LOG:GEN4_CONNECT_INT_LOG Pre:GetFirmwareInfo
1349 1724099441091 GEN4_TO_CONTROLLER_LOG:GEN4_CONNECT_INT_LOG Payload
1349 1724099441091 GEN4_TO_CONTROLLER_LOG:GEN4_CONNECT_INT_LOG null
1349 1724099441091 GEN4_TO_CONTROLLER_LOG:GEN4_CONNECT_INT_LOG Payload End
1349 1724099441091 NativeController::GetFirmwareInfo entry
1349 1724099441091 pro JtagIce3 [0x01] <<< 02 00 00 00 01 
1349 1724099441093 pro JtagIce3 [0x01] >>> 84 01 00 00 
1349 1724099441093 NativeController::getFirmwareVersion entry
1349 1724099441093 pro JtagIce3 [0x01] <<< 02 00 00 01 01 
1349 1724099441094 pro JtagIce3 [0x01] >>> 84 01 01 00 
1349 1724099441094 pro JtagIce3 [0x01] <<< 02 00 00 02 01 
1349 1724099441095 pro JtagIce3 [0x01] >>> 84 01 2D 00 
1349 1724099441095 pro JtagIce3 [0x01] <<< 02 00 00 03 02 
1349 1724099441096 pro JtagIce3 [0x01] >>> 84 01 07 00 00 
1349 1724099441096 NativeController::getFirmwareVersion exit
1349 1724099441096 pro JtagIce3 [0x01] <<< 02 00 00 09 01 
1349 1724099441098 pro JtagIce3 [0x01] >>> 84 01 00 11 
1349 1724099441098 NativeController::tryGetFPGAVersion entry
1349 1724099441098 pro JtagIce3 [0x01] <<< 02 00 00 10 01 
1349 1724099441099 pro JtagIce3 [0x01] >>> 84 01 00 11 
1349 1724099441099 pro JtagIce3 [0x01] <<< 02 00 00 11 01 
1349 1724099441101 pro JtagIce3 [0x01] >>> 84 01 00 11 
1349 1724099441101 pro JtagIce3 [0x01] <<< 02 00 00 12 01 
1349 1724099441102 pro JtagIce3 [0x01] >>> 84 01 00 11 
1349 1724099441102 NativeController::tryGetFPGAVersion exit
1349 1724099441102 NativeController::tryGetFPGAVersion exit with exception No value present
1349 1724099441102 pro JtagIce3 [0x01] <<< 02 00 00 06 01 
1349 1724099441103 pro JtagIce3 [0x01] >>> 84 01 05 00 
1349 1724099441103 pro JtagIce3 [0x01] <<< 02 00 00 07 01 
1349 1724099441105 pro JtagIce3 [0x01] >>> 84 01 05 00 
1349 1724099441105 pro JtagIce3 [0x01] <<< 02 00 00 0A 01 
1349 1724099441106 pro JtagIce3 [0x01] >>> 84 01 00 11 
1349 1724099441106 NativeController::GetFirmwareInfo exit
1349 1724099441106 GEN4_TO_CONTROLLER_LOG:GEN4_CONNECT_INT_LOG Post:GetFirmwareInfo
1349 1724099441106 GEN4_TO_CONTROLLER_LOG:GEN4_CONNECT_INT_LOG Return Value
1349 1724099441106 GEN4_TO_CONTROLLER_LOG:GEN4_CONNECT_INT_LOG FirmwareInfo: Values:
1349 1724099441106 GEN4_TO_CONTROLLER_LOG:GEN4_CONNECT_INT_LOG FirmwareInfo: boot = false, bootVer = 5.5.0 (0x05.0x05.0x00), apVer = 1.45.7 (0x01.0x2d.0x07), fpgaVer = null, scriptVer = null, macAddress = , devID = 0, devID1 = 0, devSN0 = 0, devSN1 = 0, serialNumber = null, appCommitID = null, scriptCommitID = null, PCB_ID = 0
1349 1724099441106 GEN4_TO_CONTROLLER_LOG:GEN4_CONNECT_INT_LOG Return End
1349 1724099441106 GEN4_CONNECT_DIAGNOSTICS:ENTERING: com.microchip.mplab.mdbcore.RI4Tool.ConnectionHandler.CheckForFWUpdates()
1349 1724099441106 GEN4_CONNECT_DIAGNOSTICS:Created FirmwareUpdateHandler com.microchip.mplab.mdbcore.AtmelIceScripting.OperationHandlers.AIceScriptingFirmwareUpdateHandler@e85f2f3

1349 1724099441121 GEN4_TO_CONTROLLER_LOG:GEN4_CONNECT_INT_LOG Pre:SetUpdateFirmwareInfo
1349 1724099441121 GEN4_TO_CONTROLLER_LOG:GEN4_CONNECT_INT_LOG Payload
1349 1724099441121 GEN4_TO_CONTROLLER_LOG:GEN4_CONNECT_INT_LOG UpdateFirmwareInfo: Values:
1349 1724099441121 GEN4_TO_CONTROLLER_LOG:GEN4_CONNECT_INT_LOG UpdateFirmwareInfo: license = dCejLCt9ZV4fWdqYk3htQgdNYCC2nccSTvVdTD2oCjW3gRUtjikRtla11IiYo1wq, updateId = 2147483647
1349 1724099441121 GEN4_TO_CONTROLLER_LOG:GEN4_CONNECT_INT_LOG Payload End
1349 1724099441121 GEN4_TO_CONTROLLER_LOG:GEN4_CONNECT_INT_LOG Post:SetUpdateFirmwareInfo
1349 1724099441121 GEN4_TO_CONTROLLER_LOG:GEN4_CONNECT_INT_LOG Return Value
1349 1724099441121 GEN4_TO_CONTROLLER_LOG:GEN4_CONNECT_INT_LOG none
1349 1724099441121 GEN4_TO_CONTROLLER_LOG:GEN4_CONNECT_INT_LOG Return End
1349 1724099441121 GEN4_CONNECT_DIAGNOSTICS:EXITING: com.microchip.mplab.mdbcore.RI4Tool.ConnectionHandler.CheckForFWUpdates()

1349 1724099441121 GEN4_TO_CONTROLLER_LOG:GEN4_CONNECT_INT_LOG Pre:SetPowerInfo
1349 1724099441121 GEN4_TO_CONTROLLER_LOG:GEN4_CONNECT_INT_LOG Payload
1349 1724099441121 GEN4_TO_CONTROLLER_LOG:GEN4_CONNECT_INT_LOG PowerInfo: Values:
1349 1724099441122 GEN4_TO_CONTROLLER_LOG:GEN4_CONNECT_INT_LOG PowerInfo: shotDownSystem = false, isToolPower = false, voltage = 5.000000, useVppFirst = false, useLowVoltageProgramming = true, useMaintainActivePower = false
1349 1724099441122 GEN4_TO_CONTROLLER_LOG:GEN4_CONNECT_INT_LOG Payload End
1349 1724099441122 NativeController::GetVoltageInfo entry
1349 1724099441122 pro JtagIce3 [0x01] <<< 02 00 01 00 02 
1349 1724099441123 pro JtagIce3 [0x01] >>> 84 01 FC 10 00 
1349 1724099441123 pro JtagIce3 [0x01] <<< 02 00 01 20 02 
1349 1724099441124 pro JtagIce3 [0x01] >>> 84 01 00 00 11 
1349 1724099441124 NativeController::GetVoltageInfo TSUP exit with exception + The requested command is not supported. (17)
1349 1724099441124 pro JtagIce3 [0x01] <<< 02 00 01 02 02 
1349 1724099441126 pro JtagIce3 [0x01] >>> 84 01 00 00 11 
1349 1724099441126 NativeController::GetVoltageInfo VUSB exit with exception + The requested command is not supported. (17)
1349 1724099441126 NativeController::GetVoltageInfo exit
1349 1724099441126 GEN4_TO_CONTROLLER_LOG:GEN4_CONNECT_INT_LOG Post:SetPowerInfo
1349 1724099441126 GEN4_TO_CONTROLLER_LOG:GEN4_CONNECT_INT_LOG Return Value
1349 1724099441126 GEN4_TO_CONTROLLER_LOG:GEN4_CONNECT_INT_LOG none
1349 1724099441126 GEN4_TO_CONTROLLER_LOG:GEN4_CONNECT_INT_LOG Return End

1349 1724099441126 GEN4_TO_CONTROLLER_LOG:GEN4_CONNECT_INT_LOG Pre:GetVoltageInfo
1349 1724099441126 GEN4_TO_CONTROLLER_LOG:GEN4_CONNECT_INT_LOG Payload
1349 1724099441126 GEN4_TO_CONTROLLER_LOG:GEN4_CONNECT_INT_LOG null
1349 1724099441126 GEN4_TO_CONTROLLER_LOG:GEN4_CONNECT_INT_LOG Payload End
1349 1724099441126 NativeController::GetVoltageInfo entry
1349 1724099441126 pro JtagIce3 [0x01] <<< 02 00 01 00 02 
1349 1724099441127 pro JtagIce3 [0x01] >>> 84 01 F6 10 00 
1349 1724099441127 pro JtagIce3 [0x01] <<< 02 00 01 20 02 
1349 1724099441128 pro JtagIce3 [0x01] >>> 84 01 00 00 11 
1349 1724099441128 NativeController::GetVoltageInfo TSUP exit with exception + The requested command is not supported. (17)
1349 1724099441128 pro JtagIce3 [0x01] <<< 02 00 01 02 02 
1349 1724099441129 pro JtagIce3 [0x01] >>> 84 01 00 00 11 
1349 1724099441130 NativeController::GetVoltageInfo VUSB exit with exception + The requested command is not supported. (17)
1349 1724099441130 NativeController::GetVoltageInfo exit
1349 1724099441130 GEN4_TO_CONTROLLER_LOG:GEN4_CONNECT_INT_LOG Post:GetVoltageInfo
1349 1724099441130 GEN4_TO_CONTROLLER_LOG:GEN4_CONNECT_INT_LOG Return Value
1349 1724099441130 GEN4_TO_CONTROLLER_LOG:GEN4_CONNECT_INT_LOG VoltagesInfo: Values:
1349 1724099441130 GEN4_TO_CONTROLLER_LOG:GEN4_CONNECT_INT_LOG VoltagesInfo: internalVdd = 0, internalVpp = 0, targetVdd = 0, targetVpp = -2147483648, vddSense = 4342, temp = 0, vddCurrentSense = 0, vddVoltageSense = -2147483648
1349 1724099441130 GEN4_TO_CONTROLLER_LOG:GEN4_CONNECT_INT_LOG Return End

1349 1724099441130 GEN4_TO_CONTROLLER_LOG:GEN4_CONNECT_INT_LOG Pre:SetLEDBrightness
1349 1724099441130 GEN4_TO_CONTROLLER_LOG:GEN4_CONNECT_INT_LOG Payload
1349 1724099441130 GEN4_TO_CONTROLLER_LOG:GEN4_CONNECT_INT_LOG 5
1349 1724099441130 GEN4_TO_CONTROLLER_LOG:GEN4_CONNECT_INT_LOG Payload End
1349 1724099441130 GEN4_TO_CONTROLLER_LOG:GEN4_CONNECT_INT_LOG Post:SetLEDBrightness
1349 1724099441130 GEN4_TO_CONTROLLER_LOG:GEN4_CONNECT_INT_LOG Return Value
1349 1724099441130 GEN4_TO_CONTROLLER_LOG:GEN4_CONNECT_INT_LOG none
1349 1724099441130 GEN4_TO_CONTROLLER_LOG:GEN4_CONNECT_INT_LOG Return End

1349 1724099441130 GEN4_TO_CONTROLLER_LOG:GEN4_CONNECT_INT_LOG Pre:SetToolInfo
1349 1724099441130 GEN4_TO_CONTROLLER_LOG:GEN4_CONNECT_INT_LOG Payload
1349 1724099441130 GEN4_TO_CONTROLLER_LOG:GEN4_CONNECT_INT_LOG ToolInfo: Values:
1349 1724099441130 GEN4_TO_CONTROLLER_LOG:GEN4_CONNECT_INT_LOG ToolInfo: speedLevel = 1, PGCResistance = 4700, PGDResistance = 4700, PGCPullDir = PullDown, PGDPullDir = PullDown, ICSPSelected = Wire2
1349 1724099441130 GEN4_TO_CONTROLLER_LOG:GEN4_CONNECT_INT_LOG Payload End
1349 1724099441130 GEN4_TO_CONTROLLER_LOG:GEN4_CONNECT_INT_LOG Post:SetToolInfo
1349 1724099441130 GEN4_TO_CONTROLLER_LOG:GEN4_CONNECT_INT_LOG Return Value
1349 1724099441130 GEN4_TO_CONTROLLER_LOG:GEN4_CONNECT_INT_LOG none
1349 1724099441130 GEN4_TO_CONTROLLER_LOG:GEN4_CONNECT_INT_LOG Return End

1349 1724099441131 GEN4_TO_CONTROLLER_LOG:GEN4_CONNECT_INT_LOG Pre:GetTargetIDInfo
1349 1724099441131 GEN4_TO_CONTROLLER_LOG:GEN4_CONNECT_INT_LOG Payload
1349 1724099441131 GEN4_TO_CONTROLLER_LOG:GEN4_CONNECT_INT_LOG null
1349 1724099441131 GEN4_TO_CONTROLLER_LOG:GEN4_CONNECT_INT_LOG Payload End
1349 1724099441131 NativeController::GetTargetIDInfo entry
1349 1724099441131 pro JtagIce3 [0x12] <<< 01 00 01 31 02 F4 01 
1349 1724099441132 pro JtagIce3 [0x12] >>> 80 00 
1349 1724099441132 pro JtagIce3 [0x12] <<< 01 00 00 00 01 05 
1349 1724099441133 pro JtagIce3 [0x12] >>> 80 00 
1349 1724099441133 pro JtagIce3 [0x12] <<< 01 00 00 01 01 01 
1349 1724099441134 pro JtagIce3 [0x12] >>> 80 00 
1349 1724099441134 pro JtagIce3 [0x12] <<< 01 00 01 00 01 08 
1349 1724099441136 pro JtagIce3 [0x12] >>> 80 00 
1349 1724099441136 pro JtagIce3 [0x12] <<< 01 00 02 00 30 00 80 40 20 00 10 80 0F 94 11 8C 0A 98 08 DC 05 EE 02 00 40 00 00 00 01 20 00 0A 05 FF 00 FF 00 00 14 00 13 00 11 80 12 8A 12 28 94 00 00 00 00 
1349 1724099441137 pro JtagIce3 [0x12] >>> 80 00 
1349 1724099441137 pro JtagIce3 [0x12] <<< 01 00 03 06 01 00 
1349 1724099441138 pro JtagIce3 [0x12] >>> 80 00 
1349 1724099441138 pro JtagIce3 [0x12] <<< 10 00 00 
1349 1724099441264 pro JtagIce3 [0x12] >>> A0 00 19 
1349 1724099441265 NativeController::GetTargetIDInfo exit with exception PDI physical timed out. (25)
