RichardSefton/AUV/ExperimentalCode/DepthController.X/queuelogs/debugtool.txt

3980 1721593070516 GEN4_TO_CONTROLLER_LOG:GEN4_INIT_INT_LOG_ATtiny1627 DeviceInfo: mask = 0000, exists = false, startAddr = 00000000, endAddr = 00000000, rowSize = 0000, rowEraseSize = 0000, addrInc = 0000, widthProgram = 0000
3980 1721593070516 GEN4_TO_CONTROLLER_LOG:GEN4_INIT_INT_LOG_ATtiny1627 DeviceInfo: CfgRequiredBitsMask Values:
3980 1721593070516 GEN4_TO_CONTROLLER_LOG:GEN4_INIT_INT_LOG_ATtiny1627 Address = 00001100, Mask = 00000000
3980 1721593070516 GEN4_TO_CONTROLLER_LOG:GEN4_INIT_INT_LOG_ATtiny1627 Address = 00001101, Mask = 00000000
3980 1721593070516 GEN4_TO_CONTROLLER_LOG:GEN4_INIT_INT_LOG_ATtiny1627 Address = 00001102, Mask = 00000000
3980 1721593070516 GEN4_TO_CONTROLLER_LOG:GEN4_INIT_INT_LOG_ATtiny1627 Address = 00001103, Mask = 00000000
3980 1721593070516 GEN4_TO_CONTROLLER_LOG:GEN4_INIT_INT_LOG_ATtiny1627 Address = 00001104, Mask = 00000000
3980 1721593070516 GEN4_TO_CONTROLLER_LOG:GEN4_INIT_INT_LOG_ATtiny1627 Address = 00001105, Mask = 00000000
3980 1721593070516 GEN4_TO_CONTROLLER_LOG:GEN4_INIT_INT_LOG_ATtiny1627 Address = 00001106, Mask = 00000000
3980 1721593070516 GEN4_TO_CONTROLLER_LOG:GEN4_INIT_INT_LOG_ATtiny1627 Address = 00001107, Mask = 00000000
3980 1721593070516 GEN4_TO_CONTROLLER_LOG:GEN4_INIT_INT_LOG_ATtiny1627 Address = 00001108, Mask = 00000000
3980 1721593070516 GEN4_TO_CONTROLLER_LOG:GEN4_INIT_INT_LOG_ATtiny1627 Address = 00001109, Mask = 00000000
3980 1721593070516 GEN4_TO_CONTROLLER_LOG:GEN4_INIT_INT_LOG_ATtiny1627 Address = 0000110a, Mask = 00000000
3980 1721593070516 GEN4_TO_CONTROLLER_LOG:GEN4_INIT_INT_LOG_ATtiny1627 Address = 0000110b, Mask = 00000000
3980 1721593070516 GEN4_TO_CONTROLLER_LOG:GEN4_INIT_INT_LOG_ATtiny1627 Address = 0000110c, Mask = 00000000
3980 1721593070516 GEN4_TO_CONTROLLER_LOG:GEN4_INIT_INT_LOG_ATtiny1627 Address = 00001118, Mask = 00000000
3980 1721593070516 GEN4_TO_CONTROLLER_LOG:GEN4_INIT_INT_LOG_ATtiny1627 Address = 00001119, Mask = 00000000
3980 1721593070516 GEN4_TO_CONTROLLER_LOG:GEN4_INIT_INT_LOG_ATtiny1627 Address = 0000111a, Mask = 00000000
3980 1721593070516 GEN4_TO_CONTROLLER_LOG:GEN4_INIT_INT_LOG_ATtiny1627 Address = 0000111b, Mask = 00000000
3980 1721593070516 GEN4_TO_CONTROLLER_LOG:GEN4_INIT_INT_LOG_ATtiny1627 Address = 00001120, Mask = 00000000
3980 1721593070516 GEN4_TO_CONTROLLER_LOG:GEN4_INIT_INT_LOG_ATtiny1627 Address = 00001121, Mask = 00000000
3980 1721593070516 GEN4_TO_CONTROLLER_LOG:GEN4_INIT_INT_LOG_ATtiny1627 Address = 00821280, Mask = 000000ff
3980 1721593070516 GEN4_TO_CONTROLLER_LOG:GEN4_INIT_INT_LOG_ATtiny1627 Address = 00821281, Mask = 000000ff
3980 1721593070516 GEN4_TO_CONTROLLER_LOG:GEN4_INIT_INT_LOG_ATtiny1627 Address = 00821282, Mask = 00000083
3980 1721593070516 GEN4_TO_CONTROLLER_LOG:GEN4_INIT_INT_LOG_ATtiny1627 Address = 00821285, Mask = 000000dd
3980 1721593070516 GEN4_TO_CONTROLLER_LOG:GEN4_INIT_INT_LOG_ATtiny1627 Address = 00821286, Mask = 00000007
3980 1721593070516 GEN4_TO_CONTROLLER_LOG:GEN4_INIT_INT_LOG_ATtiny1627 Address = 00821287, Mask = 000000ff
3980 1721593070516 GEN4_TO_CONTROLLER_LOG:GEN4_INIT_INT_LOG_ATtiny1627 Address = 00821288, Mask = 000000ff
3980 1721593070516 GEN4_TO_CONTROLLER_LOG:GEN4_INIT_INT_LOG_ATtiny1627 Address = 0083128a, Mask = 000000ff
3980 1721593070516 GEN4_TO_CONTROLLER_LOG:GEN4_INIT_INT_LOG_ATtiny1627 BasicInfo: Values:
3980 1721593070516 GEN4_TO_CONTROLLER_LOG:GEN4_INIT_INT_LOG_ATtiny1627 Payload End
3980 1721593070516 GEN4_TO_CONTROLLER_LOG:GEN4_INIT_INT_LOG_ATtiny1627 Post:init
3980 1721593070516 GEN4_TO_CONTROLLER_LOG:GEN4_INIT_INT_LOG_ATtiny1627 Return Value
3980 1721593070516 GEN4_TO_CONTROLLER_LOG:GEN4_INIT_INT_LOG_ATtiny1627 none
3980 1721593070516 GEN4_TO_CONTROLLER_LOG:GEN4_INIT_INT_LOG_ATtiny1627 Return End

3980 1721593070516 GEN4_TO_CONTROLLER_LOG:GEN4_INIT_INT_LOG_ATtiny1627 Pre:GetInterfaceProvider
3980 1721593070516 GEN4_TO_CONTROLLER_LOG:GEN4_INIT_INT_LOG_ATtiny1627 Payload
3980 1721593070516 GEN4_TO_CONTROLLER_LOG:GEN4_INIT_INT_LOG_ATtiny1627 RI4DebugInterface
3980 1721593070516 GEN4_TO_CONTROLLER_LOG:GEN4_INIT_INT_LOG_ATtiny1627 Payload End
3980 1721593070516 GEN4_TO_CONTROLLER_LOG:GEN4_INIT_INT_LOG_ATtiny1627 Post:GetInterfaceProvider
3980 1721593070516 GEN4_TO_CONTROLLER_LOG:GEN4_INIT_INT_LOG_ATtiny1627 Return Value
3980 1721593070516 GEN4_TO_CONTROLLER_LOG:GEN4_INIT_INT_LOG_ATtiny1627 com.microchip.mplab.libs.atmelice.implementations.DebugInterface@40163a22
3980 1721593070516 GEN4_TO_CONTROLLER_LOG:GEN4_INIT_INT_LOG_ATtiny1627 Return End

3980 1721593070516 GEN4_TO_CONTROLLER_LOG:GEN4_INIT_INT_LOG_ATtiny1627 Pre:GetInterfaceProvider
3980 1721593070516 GEN4_TO_CONTROLLER_LOG:GEN4_INIT_INT_LOG_ATtiny1627 Payload
3980 1721593070516 GEN4_TO_CONTROLLER_LOG:GEN4_INIT_INT_LOG_ATtiny1627 RI4ProgramInterface
3980 1721593070516 GEN4_TO_CONTROLLER_LOG:GEN4_INIT_INT_LOG_ATtiny1627 Payload End
3980 1721593070516 GEN4_TO_CONTROLLER_LOG:GEN4_INIT_INT_LOG_ATtiny1627 Post:GetInterfaceProvider
3980 1721593070516 GEN4_TO_CONTROLLER_LOG:GEN4_INIT_INT_LOG_ATtiny1627 Return Value
3980 1721593070516 GEN4_TO_CONTROLLER_LOG:GEN4_INIT_INT_LOG_ATtiny1627 com.microchip.mplab.libs.atmelice.implementations.ProgramInterface@355ad6ca
3980 1721593070516 GEN4_TO_CONTROLLER_LOG:GEN4_INIT_INT_LOG_ATtiny1627 Return End

3980 1721593070516 GEN4_TO_CONTROLLER_LOG:GEN4_INIT_INT_LOG_ATtiny1627 Pre:GetInterfaceProvider
3980 1721593070516 GEN4_TO_CONTROLLER_LOG:GEN4_INIT_INT_LOG_ATtiny1627 Payload
3980 1721593070516 GEN4_TO_CONTROLLER_LOG:GEN4_INIT_INT_LOG_ATtiny1627 RI4ConnectInterface
3980 1721593070516 GEN4_TO_CONTROLLER_LOG:GEN4_INIT_INT_LOG_ATtiny1627 Payload End
3980 1721593070516 GEN4_TO_CONTROLLER_LOG:GEN4_INIT_INT_LOG_ATtiny1627 Post:GetInterfaceProvider
3980 1721593070516 GEN4_TO_CONTROLLER_LOG:GEN4_INIT_INT_LOG_ATtiny1627 Return Value
3980 1721593070516 GEN4_TO_CONTROLLER_LOG:GEN4_INIT_INT_LOG_ATtiny1627 com.microchip.mplab.libs.atmelice.implementations.ConnectInterface@6527bf3d
3980 1721593070516 GEN4_TO_CONTROLLER_LOG:GEN4_INIT_INT_LOG_ATtiny1627 Return End

3980 1721593070516 GEN4_TO_CONTROLLER_LOG:GEN4_INIT_INT_LOG_ATtiny1627 Pre:GetInterfaceProvider
3980 1721593070516 GEN4_TO_CONTROLLER_LOG:GEN4_INIT_INT_LOG_ATtiny1627 Payload
3980 1721593070516 GEN4_TO_CONTROLLER_LOG:GEN4_INIT_INT_LOG_ATtiny1627 RI4ControllerDiagnosticsInterface
3980 1721593070516 GEN4_TO_CONTROLLER_LOG:GEN4_INIT_INT_LOG_ATtiny1627 Payload End
3980 1721593070517 GEN4_TO_CONTROLLER_LOG:GEN4_INIT_INT_LOG_ATtiny1627 Post:GetInterfaceProvider
3980 1721593070517 GEN4_TO_CONTROLLER_LOG:GEN4_INIT_INT_LOG_ATtiny1627 Return Value
3980 1721593070517 GEN4_TO_CONTROLLER_LOG:GEN4_INIT_INT_LOG_ATtiny1627 com.microchip.mplab.libs.atmelice.implementations.UnimplementedDiagnostics@3e7d1526
3980 1721593070517 GEN4_TO_CONTROLLER_LOG:GEN4_INIT_INT_LOG_ATtiny1627 Return End

3980 1721593070517 GEN4_TO_CONTROLLER_LOG:GEN4_INIT_INT_LOG_ATtiny1627 Pre:GetInterfaceProvider
3980 1721593070517 GEN4_TO_CONTROLLER_LOG:GEN4_INIT_INT_LOG_ATtiny1627 Payload
3980 1721593070517 GEN4_TO_CONTROLLER_LOG:GEN4_INIT_INT_LOG_ATtiny1627 ProgrammerToGo
3980 1721593070517 GEN4_TO_CONTROLLER_LOG:GEN4_INIT_INT_LOG_ATtiny1627 Payload End
3980 1721593070517 GEN4_TO_CONTROLLER_LOG:GEN4_INIT_INT_LOG_ATtiny1627 Post:GetInterfaceProvider
3980 1721593070517 GEN4_TO_CONTROLLER_LOG:GEN4_INIT_INT_LOG_ATtiny1627 Return Value
3980 1721593070517 GEN4_TO_CONTROLLER_LOG:GEN4_INIT_INT_LOG_ATtiny1627 null
3980 1721593070517 GEN4_TO_CONTROLLER_LOG:GEN4_INIT_INT_LOG_ATtiny1627 Return End

3980 1721593070517 GEN4_TO_CONTROLLER_LOG:GEN4_INIT_INT_LOG_ATtiny1627 Pre:GetInterfaceProvider
3980 1721593070517 GEN4_TO_CONTROLLER_LOG:GEN4_INIT_INT_LOG_ATtiny1627 Payload
3980 1721593070517 GEN4_TO_CONTROLLER_LOG:GEN4_INIT_INT_LOG_ATtiny1627 Status
3980 1721593070517 GEN4_TO_CONTROLLER_LOG:GEN4_INIT_INT_LOG_ATtiny1627 Payload End
3980 1721593070517 GEN4_TO_CONTROLLER_LOG:GEN4_INIT_INT_LOG_ATtiny1627 Post:GetInterfaceProvider
3980 1721593070517 GEN4_TO_CONTROLLER_LOG:GEN4_INIT_INT_LOG_ATtiny1627 Return Value
3980 1721593070517 GEN4_TO_CONTROLLER_LOG:GEN4_INIT_INT_LOG_ATtiny1627 null
3980 1721593070517 GEN4_TO_CONTROLLER_LOG:GEN4_INIT_INT_LOG_ATtiny1627 Return End

3980 1721593070519 GEN4_TO_CONTROLLER_LOG:GEN4_CONNECT_INT_LOG Pre:EstablishCommunincations
3980 1721593070519 GEN4_TO_CONTROLLER_LOG:GEN4_CONNECT_INT_LOG Payload
3980 1721593070519 GEN4_TO_CONTROLLER_LOG:GEN4_CONNECT_INT_LOG com.microchip.mplab.mdbcore.AtmelIceScripting.AIceScriptingCom@4fcbefe1
3980 1721593070519 GEN4_TO_CONTROLLER_LOG:GEN4_CONNECT_INT_LOG Payload End
3980 1721593070519 NativeController::EstablishCommunincations entry
3980 1721593070519 pro JtagIce3 [0x00] <<< 00 00 00 
3980 1721593070520 pro JtagIce3 [0x00] >>> 81 00 00 01 11 12 13 14 
3980 1721593070521 pro JtagIce3 [0x01] <<< 10 00 
3980 1721593070523 pro JtagIce3 [0x01] >>> 80 00 
3980 1721593070523 pro JtagIce3 [0x00] <<< 00 00 03 
3980 1721593070524 pro JtagIce3 [0x00] >>> 81 00 01 04 05 06 07 
3980 1721593070524 pro JtagIce3 [0x01] <<< 02 00 01 20 02 
3980 1721593070525 pro JtagIce3 [0x01] >>> 84 01 00 00 11 
3980 1721593070525 NativeController::EstablishCommunincations exit
3980 1721593070525 GEN4_TO_CONTROLLER_LOG:GEN4_CONNECT_INT_LOG Post:EstablishCommunincations
3980 1721593070525 GEN4_TO_CONTROLLER_LOG:GEN4_CONNECT_INT_LOG Return Value
3980 1721593070525 GEN4_TO_CONTROLLER_LOG:GEN4_CONNECT_INT_LOG true
3980 1721593070525 GEN4_TO_CONTROLLER_LOG:GEN4_CONNECT_INT_LOG Return End

3980 1721593070525 GEN4_TO_CONTROLLER_LOG:GEN4_CONNECT_INT_LOG Pre:GetFirmwareInfo
3980 1721593070525 GEN4_TO_CONTROLLER_LOG:GEN4_CONNECT_INT_LOG Payload
3980 1721593070525 GEN4_TO_CONTROLLER_LOG:GEN4_CONNECT_INT_LOG null
3980 1721593070525 GEN4_TO_CONTROLLER_LOG:GEN4_CONNECT_INT_LOG Payload End
3980 1721593070525 NativeController::GetFirmwareInfo entry
3980 1721593070525 pro JtagIce3 [0x01] <<< 02 00 00 00 01 
3980 1721593070526 pro JtagIce3 [0x01] >>> 84 01 00 00 
3980 1721593070526 NativeController::getFirmwareVersion entry
3980 1721593070526 pro JtagIce3 [0x01] <<< 02 00 00 01 01 
3980 1721593070527 pro JtagIce3 [0x01] >>> 84 01 01 00 
3980 1721593070527 pro JtagIce3 [0x01] <<< 02 00 00 02 01 
3980 1721593070528 pro JtagIce3 [0x01] >>> 84 01 2D 00 
3980 1721593070528 pro JtagIce3 [0x01] <<< 02 00 00 03 02 
3980 1721593070529 pro JtagIce3 [0x01] >>> 84 01 07 00 00 
3980 1721593070529 NativeController::getFirmwareVersion exit
3980 1721593070529 pro JtagIce3 [0x01] <<< 02 00 00 09 01 
3980 1721593070531 pro JtagIce3 [0x01] >>> 84 01 00 11 
3980 1721593070531 NativeController::tryGetFPGAVersion entry
3980 1721593070531 pro JtagIce3 [0x01] <<< 02 00 00 10 01 
3980 1721593070532 pro JtagIce3 [0x01] >>> 84 01 00 11 
3980 1721593070532 pro JtagIce3 [0x01] <<< 02 00 00 11 01 
3980 1721593070533 pro JtagIce3 [0x01] >>> 84 01 00 11 
3980 1721593070533 pro JtagIce3 [0x01] <<< 02 00 00 12 01 
3980 1721593070534 pro JtagIce3 [0x01] >>> 84 01 00 11 
3980 1721593070534 NativeController::tryGetFPGAVersion exit
3980 1721593070534 NativeController::tryGetFPGAVersion exit with exception No value present
3980 1721593070534 pro JtagIce3 [0x01] <<< 02 00 00 06 01 
3980 1721593070535 pro JtagIce3 [0x01] >>> 84 01 05 00 
3980 1721593070535 pro JtagIce3 [0x01] <<< 02 00 00 07 01 
3980 1721593070536 pro JtagIce3 [0x01] >>> 84 01 05 00 
3980 1721593070536 pro JtagIce3 [0x01] <<< 02 00 00 0A 01 
3980 1721593070537 pro JtagIce3 [0x01] >>> 84 01 00 11 
3980 1721593070537 NativeController::GetFirmwareInfo exit
3980 1721593070537 GEN4_TO_CONTROLLER_LOG:GEN4_CONNECT_INT_LOG Post:GetFirmwareInfo
3980 1721593070537 GEN4_TO_CONTROLLER_LOG:GEN4_CONNECT_INT_LOG Return Value
3980 1721593070537 GEN4_TO_CONTROLLER_LOG:GEN4_CONNECT_INT_LOG FirmwareInfo: Values:
3980 1721593070537 GEN4_TO_CONTROLLER_LOG:GEN4_CONNECT_INT_LOG FirmwareInfo: boot = false, bootVer = 5.5.0 (0x05.0x05.0x00), apVer = 1.45.7 (0x01.0x2d.0x07), fpgaVer = null, scriptVer = null, macAddress = , devID = 0, devID1 = 0, devSN0 = 0, devSN1 = 0, serialNumber = null, appCommitID = null, scriptCommitID = null, PCB_ID = 0
3980 1721593070537 GEN4_TO_CONTROLLER_LOG:GEN4_CONNECT_INT_LOG Return End
3980 1721593070538 GEN4_CONNECT_DIAGNOSTICS:ENTERING: com.microchip.mplab.mdbcore.RI4Tool.ConnectionHandler.CheckForFWUpdates()
3980 1721593070538 GEN4_CONNECT_DIAGNOSTICS:Created FirmwareUpdateHandler com.microchip.mplab.mdbcore.AtmelIceScripting.OperationHandlers.AIceScriptingFirmwareUpdateHandler@2c449c54

3980 1721593070540 GEN4_TO_CONTROLLER_LOG:GEN4_CONNECT_INT_LOG Pre:SetUpdateFirmwareInfo
3980 1721593070540 GEN4_TO_CONTROLLER_LOG:GEN4_CONNECT_INT_LOG Payload
3980 1721593070540 GEN4_TO_CONTROLLER_LOG:GEN4_CONNECT_INT_LOG UpdateFirmwareInfo: Values:
3980 1721593070540 GEN4_TO_CONTROLLER_LOG:GEN4_CONNECT_INT_LOG UpdateFirmwareInfo: license = dCejLCt9ZV4fWdqYk3htQgdNYCC2nccSTvVdTD2oCjW3gRUtjikRtla11IiYo1wq, updateId = 2147483647
3980 1721593070540 GEN4_TO_CONTROLLER_LOG:GEN4_CONNECT_INT_LOG Payload End
3980 1721593070540 GEN4_TO_CONTROLLER_LOG:GEN4_CONNECT_INT_LOG Post:SetUpdateFirmwareInfo
3980 1721593070540 GEN4_TO_CONTROLLER_LOG:GEN4_CONNECT_INT_LOG Return Value
3980 1721593070540 GEN4_TO_CONTROLLER_LOG:GEN4_CONNECT_INT_LOG none
3980 1721593070540 GEN4_TO_CONTROLLER_LOG:GEN4_CONNECT_INT_LOG Return End
3980 1721593070540 GEN4_CONNECT_DIAGNOSTICS:EXITING: com.microchip.mplab.mdbcore.RI4Tool.ConnectionHandler.CheckForFWUpdates()

3980 1721593070540 GEN4_TO_CONTROLLER_LOG:GEN4_CONNECT_INT_LOG Pre:SetPowerInfo
3980 1721593070540 GEN4_TO_CONTROLLER_LOG:GEN4_CONNECT_INT_LOG Payload
3980 1721593070540 GEN4_TO_CONTROLLER_LOG:GEN4_CONNECT_INT_LOG PowerInfo: Values:
3980 1721593070540 GEN4_TO_CONTROLLER_LOG:GEN4_CONNECT_INT_LOG PowerInfo: shotDownSystem = false, isToolPower = false, voltage = 5.000000, useVppFirst = false, useLowVoltageProgramming = true, useMaintainActivePower = false
3980 1721593070540 GEN4_TO_CONTROLLER_LOG:GEN4_CONNECT_INT_LOG Payload End
3980 1721593070540 NativeController::GetVoltageInfo entry
3980 1721593070540 pro JtagIce3 [0x01] <<< 02 00 01 00 02 
3980 1721593070542 pro JtagIce3 [0x01] >>> 84 01 A6 13 00 
3980 1721593070542 pro JtagIce3 [0x01] <<< 02 00 01 20 02 
3980 1721593070543 pro JtagIce3 [0x01] >>> 84 01 00 00 11 
3980 1721593070543 NativeController::GetVoltageInfo TSUP exit with exception + The requested command is not supported. (17)
3980 1721593070543 pro JtagIce3 [0x01] <<< 02 00 01 02 02 
3980 1721593070544 pro JtagIce3 [0x01] >>> 84 01 00 00 11 
3980 1721593070544 NativeController::GetVoltageInfo VUSB exit with exception + The requested command is not supported. (17)
3980 1721593070544 NativeController::GetVoltageInfo exit
3980 1721593070544 GEN4_TO_CONTROLLER_LOG:GEN4_CONNECT_INT_LOG Post:SetPowerInfo
3980 1721593070544 GEN4_TO_CONTROLLER_LOG:GEN4_CONNECT_INT_LOG Return Value
3980 1721593070544 GEN4_TO_CONTROLLER_LOG:GEN4_CONNECT_INT_LOG none
3980 1721593070544 GEN4_TO_CONTROLLER_LOG:GEN4_CONNECT_INT_LOG Return End

3980 1721593070544 GEN4_TO_CONTROLLER_LOG:GEN4_CONNECT_INT_LOG Pre:GetVoltageInfo
3980 1721593070544 GEN4_TO_CONTROLLER_LOG:GEN4_CONNECT_INT_LOG Payload
3980 1721593070544 GEN4_TO_CONTROLLER_LOG:GEN4_CONNECT_INT_LOG null
3980 1721593070544 GEN4_TO_CONTROLLER_LOG:GEN4_CONNECT_INT_LOG Payload End
3980 1721593070544 NativeController::GetVoltageInfo entry
3980 1721593070544 pro JtagIce3 [0x01] <<< 02 00 01 00 02 
3980 1721593070545 pro JtagIce3 [0x01] >>> 84 01 A9 13 00 
3980 1721593070545 pro JtagIce3 [0x01] <<< 02 00 01 20 02 
3980 1721593070546 pro JtagIce3 [0x01] >>> 84 01 00 00 11 
3980 1721593070546 NativeController::GetVoltageInfo TSUP exit with exception + The requested command is not supported. (17)
3980 1721593070546 pro JtagIce3 [0x01] <<< 02 00 01 02 02 
3980 1721593070547 pro JtagIce3 [0x01] >>> 84 01 00 00 11 
3980 1721593070547 NativeController::GetVoltageInfo VUSB exit with exception + The requested command is not supported. (17)
3980 1721593070547 NativeController::GetVoltageInfo exit
3980 1721593070547 GEN4_TO_CONTROLLER_LOG:GEN4_CONNECT_INT_LOG Post:GetVoltageInfo
3980 1721593070547 GEN4_TO_CONTROLLER_LOG:GEN4_CONNECT_INT_LOG Return Value
3980 1721593070547 GEN4_TO_CONTROLLER_LOG:GEN4_CONNECT_INT_LOG VoltagesInfo: Values:
3980 1721593070547 GEN4_TO_CONTROLLER_LOG:GEN4_CONNECT_INT_LOG VoltagesInfo: internalVdd = 0, internalVpp = 0, targetVdd = 0, targetVpp = -2147483648, vddSense = 5033, temp = 0, vddCurrentSense = 0, vddVoltageSense = -2147483648
3980 1721593070547 GEN4_TO_CONTROLLER_LOG:GEN4_CONNECT_INT_LOG Return End

3980 1721593070547 GEN4_TO_CONTROLLER_LOG:GEN4_CONNECT_INT_LOG Pre:SetLEDBrightness
3980 1721593070547 GEN4_TO_CONTROLLER_LOG:GEN4_CONNECT_INT_LOG Payload
3980 1721593070547 GEN4_TO_CONTROLLER_LOG:GEN4_CONNECT_INT_LOG 5
3980 1721593070547 GEN4_TO_CONTROLLER_LOG:GEN4_CONNECT_INT_LOG Payload End
3980 1721593070547 GEN4_TO_CONTROLLER_LOG:GEN4_CONNECT_INT_LOG Post:SetLEDBrightness
3980 1721593070547 GEN4_TO_CONTROLLER_LOG:GEN4_CONNECT_INT_LOG Return Value
3980 1721593070547 GEN4_TO_CONTROLLER_LOG:GEN4_CONNECT_INT_LOG none
3980 1721593070547 GEN4_TO_CONTROLLER_LOG:GEN4_CONNECT_INT_LOG Return End

3980 1721593070547 GEN4_TO_CONTROLLER_LOG:GEN4_CONNECT_INT_LOG Pre:SetToolInfo
3980 1721593070547 GEN4_TO_CONTROLLER_LOG:GEN4_CONNECT_INT_LOG Payload
3980 1721593070547 GEN4_TO_CONTROLLER_LOG:GEN4_CONNECT_INT_LOG ToolInfo: Values:
3980 1721593070547 GEN4_TO_CONTROLLER_LOG:GEN4_CONNECT_INT_LOG ToolInfo: speedLevel = 1, PGCResistance = 4700, PGDResistance = 4700, PGCPullDir = PullDown, PGDPullDir = PullDown, ICSPSelected = Wire2
3980 1721593070547 GEN4_TO_CONTROLLER_LOG:GEN4_CONNECT_INT_LOG Payload End
3980 1721593070547 GEN4_TO_CONTROLLER_LOG:GEN4_CONNECT_INT_LOG Post:SetToolInfo
3980 1721593070547 GEN4_TO_CONTROLLER_LOG:GEN4_CONNECT_INT_LOG Return Value
3980 1721593070547 GEN4_TO_CONTROLLER_LOG:GEN4_CONNECT_INT_LOG none
3980 1721593070547 GEN4_TO_CONTROLLER_LOG:GEN4_CONNECT_INT_LOG Return End

3980 1721593070547 GEN4_TO_CONTROLLER_LOG:GEN4_CONNECT_INT_LOG Pre:GetTargetIDInfo
3980 1721593070547 GEN4_TO_CONTROLLER_LOG:GEN4_CONNECT_INT_LOG Payload
3980 1721593070547 GEN4_TO_CONTROLLER_LOG:GEN4_CONNECT_INT_LOG null
3980 1721593070547 GEN4_TO_CONTROLLER_LOG:GEN4_CONNECT_INT_LOG Payload End
3980 1721593070547 NativeController::GetTargetIDInfo entry
3980 1721593070547 pro JtagIce3 [0x12] <<< 01 00 01 31 02 F4 01 
3980 1721593070548 pro JtagIce3 [0x12] >>> 80 00 
3980 1721593070548 pro JtagIce3 [0x12] <<< 01 00 00 00 01 05 
3980 1721593070549 pro JtagIce3 [0x12] >>> 80 00 
3980 1721593070549 pro JtagIce3 [0x12] <<< 01 00 00 01 01 01 
3980 1721593070550 pro JtagIce3 [0x12] >>> 80 00 
3980 1721593070550 pro JtagIce3 [0x12] <<< 01 00 01 00 01 08 
3980 1721593070551 pro JtagIce3 [0x12] >>> 80 00 
3980 1721593070551 pro JtagIce3 [0x12] <<< 01 00 02 00 30 00 80 40 20 00 10 80 0F 94 11 8C 0A 98 08 DC 05 EE 02 00 40 00 00 00 01 20 00 0A 05 FF 00 FF 00 00 14 00 13 00 11 80 12 8A 12 28 94 00 00 00 00 
3980 1721593070552 pro JtagIce3 [0x12] >>> 80 00 
3980 1721593070552 pro JtagIce3 [0x12] <<< 01 00 03 06 01 00 
3980 1721593070553 pro JtagIce3 [0x12] >>> 80 00 
3980 1721593070553 pro JtagIce3 [0x12] <<< 10 00 00 
3980 1721593070565 pro JtagIce3 [0x12] >>> 84 00 74 69 6E 79 00 
3980 1721593070565 pro JtagIce3 [0x12] <<< 01 00 03 06 01 00 
3980 1721593070567 pro JtagIce3 [0x12] >>> 80 00 
3980 1721593070567 pro JtagIce3 [0x12] <<< 15 00 
3980 1721593070630 pro JtagIce3 [0x12] >>> 80 00 
3980 1721593070630 pro JtagIce3 [0x12] <<< 21 00 B4 00 11 00 00 03 00 00 00 
3980 1721593070632 pro JtagIce3 [0x12] >>> 84 00 1E 94 28 00 
3980 1721593070632 pro JtagIce3 [0x12] <<< 21 00 B4 00 11 00 00 03 00 00 00 
3980 1721593070633 pro JtagIce3 [0x12] >>> 84 00 1E 94 28 00 
3980 1721593070633 pro JtagIce3 [0x12] <<< 21 00 B4 00 11 00 00 03 00 00 00 
3980 1721593070635 pro JtagIce3 [0x12] >>> 84 00 1E 94 28 00 
3980 1721593070635 pro JtagIce3 [0x12] <<< 21 00 B2 01 0F 00 00 01 00 00 00 
3980 1721593070636 pro JtagIce3 [0x12] >>> 84 00 04 00 
3980 1721593070636 pro JtagIce3 [0x12] <<< 16 00 
3980 1721593070638 pro JtagIce3 [0x12] >>> 80 00 
3980 1721593070638 pro JtagIce3 [0x12] <<< 11 00 
3980 1721593070639 pro JtagIce3 [0x12] >>> 80 00 
3980 1721593070639 pro JtagIce3 [0x01] <<< 11 00 00 
3980 1721593070640 pro JtagIce3 [0x01] >>> 80 00 
3980 1721593070640 NativeController::GetTargetIDInfo exit device ID 0x1e9428
3980 1721593070640 GEN4_TO_CONTROLLER_LOG:GEN4_CONNECT_INT_LOG Post:GetTargetIDInfo
3980 1721593070640 GEN4_TO_CONTROLLER_LOG:GEN4_CONNECT_INT_LOG Return Value
3980 1721593070640 GEN4_TO_CONTROLLER_LOG:GEN4_CONNECT_INT_LOG TargetIDInfo: Values:
3980 1721593070640 GEN4_TO_CONTROLLER_LOG:GEN4_CONNECT_INT_LOG TargetIDInfo: DeviceID = 001e9428
3980 1721593070640 GEN4_TO_CONTROLLER_LOG:GEN4_CONNECT_INT_LOG Return End

3980 1721593070643 GEN4_TO_CONTROLLER_LOG:GEN4_PROGRAM_INT_LOG_ATtiny1627 Pre:SendOperation
3980 1721593070643 GEN4_TO_CONTROLLER_LOG:GEN4_PROGRAM_INT_LOG_ATtiny1627 Payload
3980 1721593070643 GEN4_TO_CONTROLLER_LOG:GEN4_PROGRAM_INT_LOG_ATtiny1627 OperationInfo: Values:
3980 1721593070643 GEN4_TO_CONTROLLER_LOG:GEN4_PROGRAM_INT_LOG_ATtiny1627 OperationInfo: Type = erase, Mask = 00000000, Erase = false, Production Mode = false
3980 1721593070643 GEN4_TO_CONTROLLER_LOG:GEN4_PROGRAM_INT_LOG_ATtiny1627 TransferInfo: Start = 0, End = 3fff, Buffer Length = 0, Type = Pgm, Mask = 00000000
3980 1721593070643 GEN4_TO_CONTROLLER_LOG:GEN4_PROGRAM_INT_LOG_ATtiny1627 TransferInfo: Start = 1280, End = 1288, Buffer Length = 0, Type = Cfg, Mask = 00000000
3980 1721593070643 GEN4_TO_CONTROLLER_LOG:GEN4_PROGRAM_INT_LOG_ATtiny1627 TransferInfo: Start = 128a, End = 128a, Buffer Length = 0, Type = Cfg, Mask = 00000000
3980 1721593070643 GEN4_TO_CONTROLLER_LOG:GEN4_PROGRAM_INT_LOG_ATtiny1627 TransferInfo: Start = 1400, End = 14ff, Buffer Length = 0, Type = EEData, Mask = 00000000
3980 1721593070643 GEN4_TO_CONTROLLER_LOG:GEN4_PROGRAM_INT_LOG_ATtiny1627 TransferInfo: Start = 1300, End = 131f, Buffer Length = 0, Type = UserID, Mask = 00000000
3980 1721593070643 GEN4_TO_CONTROLLER_LOG:GEN4_PROGRAM_INT_LOG_ATtiny1627 Payload End
3980 1721593070643 pro JtagIce3 [0x12] <<< 01 00 01 31 02 F4 01 
3980 1721593070644 pro JtagIce3 [0x12] >>> 80 00 
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
3980 1721593070922 GEN4_TO_CONTROLLER_LOG:GEN4_PROGRAM_INT_LOG_ATtiny1627 Return Value
3980 1721593070922 GEN4_TO_CONTROLLER_LOG:GEN4_PROGRAM_INT_LOG_ATtiny1627 None
3980 1721593070922 GEN4_TO_CONTROLLER_LOG:GEN4_PROGRAM_INT_LOG_ATtiny1627 Return End

3980 1721593070922 GEN4_TO_CONTROLLER_LOG:GEN4_DEBUG_INT_LOG_ATtiny1627 Pre:InitDebugSession
3980 1721593070922 GEN4_TO_CONTROLLER_LOG:GEN4_DEBUG_INT_LOG_ATtiny1627 Payload
3980 1721593070922 GEN4_TO_CONTROLLER_LOG:GEN4_DEBUG_INT_LOG_ATtiny1627 null
3980 1721593070922 GEN4_TO_CONTROLLER_LOG:GEN4_DEBUG_INT_LOG_ATtiny1627 Payload End
3980 1721593070923 pro JtagIce3 [0x00] <<< 00 00 00 
3980 1721593070924 pro JtagIce3 [0x00] >>> 81 00 00 01 11 12 13 14 
3980 1721593070924 pro JtagIce3 [0x01] <<< 10 00 
3980 1721593070925 pro JtagIce3 [0x01] >>> 80 00 
3980 1721593070925 pro JtagIce3 [0x00] <<< 00 00 03 
3980 1721593070926 pro JtagIce3 [0x00] >>> 81 00 01 04 05 06 07 
3980 1721593070926 pro JtagIce3 [0x01] <<< 02 00 01 20 02 
3980 1721593070927 pro JtagIce3 [0x01] >>> 84 01 00 00 11 
3980 1721593070927 pro JtagIce3 [0x12] <<< 01 00 01 31 02 F4 01 
3980 1721593070928 pro JtagIce3 [0x12] >>> 80 00 
3980 1721593070928 pro JtagIce3 [0x12] <<< 01 00 00 00 01 05 
3980 1721593070929 pro JtagIce3 [0x12] >>> 80 00 
3980 1721593070929 pro JtagIce3 [0x12] <<< 01 00 00 01 01 02 
3980 1721593070930 pro JtagIce3 [0x12] >>> 80 00 
3980 1721593070930 pro JtagIce3 [0x12] <<< 01 00 01 00 01 08 
3980 1721593070931 pro JtagIce3 [0x12] >>> 80 00 
3980 1721593070931 pro JtagIce3 [0x12] <<< 01 00 02 00 30 00 80 40 20 00 10 80 0F 94 11 8C 0A 98 08 DC 05 EE 02 00 40 00 00 00 01 20 00 0A 05 FF 00 FF 00 00 14 00 13 00 11 80 12 8A 12 28 94 00 00 00 00 
3980 1721593070932 pro JtagIce3 [0x12] >>> 80 00 
3980 1721593070932 pro JtagIce3 [0x12] <<< 01 00 03 06 01 00 
3980 1721593070933 pro JtagIce3 [0x12] >>> 80 00 
3980 1721593070933 pro JtagIce3 [0x12] <<< 10 00 00 
3980 1721593070946 pro JtagIce3 [0x12] >>> 84 00 74 69 6E 79 00 
3980 1721593070946 pro JtagIce3 [0x12] <<< 01 00 03 06 01 00 
3980 1721593070947 pro JtagIce3 [0x12] >>> 80 00 
3980 1721593070947 pro JtagIce3 [0x12] <<< 13 00 00 
3980 1721593070983 pro JtagIce3 [0x12] >>> 80 00 
3980 1721593070983 pro JtagIce3 [0x12] <<< 31 00 01 
3980 1721593070985 pro JtagIce3 [0x12] >>> 80 00 
3980 1721593071036 pro JtagIce3 ||| 0E 00 43 01 12 40 15 01 00 00 01 44 00 0E 
3980 1721593071036 pro JtagIce3 [0x12] <<< 30 00 01 
3980 1721593071038 pro JtagIce3 [0x12] >>> 80 00 
3980 1721593071138 pro JtagIce3 ||| 0E 00 44 01 12 40 00 00 00 00 01 84 00 0E 
3980 1721593071138 GEN4_TO_CONTROLLER_LOG:GEN4_DEBUG_INT_LOG_ATtiny1627 Post:InitDebugSession
3980 1721593071138 GEN4_TO_CONTROLLER_LOG:GEN4_DEBUG_INT_LOG_ATtiny1627 Return Value
3980 1721593071138 GEN4_TO_CONTROLLER_LOG:GEN4_DEBUG_INT_LOG_ATtiny1627 none
3980 1721593071138 GEN4_TO_CONTROLLER_LOG:GEN4_DEBUG_INT_LOG_ATtiny1627 Return End

3986 1721593071146 GEN4_TO_CONTROLLER_LOG:GEN4_DEBUG_INT_LOG_ATtiny1627 Pre:setTraceDescriptor
3986 1721593071146 GEN4_TO_CONTROLLER_LOG:GEN4_DEBUG_INT_LOG_ATtiny1627 Payload
3986 1721593071146 GEN4_TO_CONTROLLER_LOG:GEN4_DEBUG_INT_LOG_ATtiny1627 com.microchip.mplab.libs.RI4ToolsController.DataClasses.TraceDescriptor@7c06d3f3
3986 1721593071146 GEN4_TO_CONTROLLER_LOG:GEN4_DEBUG_INT_LOG_ATtiny1627 Payload End
3986 1721593071146 GEN4_TO_CONTROLLER_LOG:GEN4_DEBUG_INT_LOG_ATtiny1627 Post:setTraceDescriptor
3986 1721593071146 GEN4_TO_CONTROLLER_LOG:GEN4_DEBUG_INT_LOG_ATtiny1627 Return Value
3986 1721593071146 GEN4_TO_CONTROLLER_LOG:GEN4_DEBUG_INT_LOG_ATtiny1627 none
3986 1721593071146 GEN4_TO_CONTROLLER_LOG:GEN4_DEBUG_INT_LOG_ATtiny1627 Return End

3986 1721593071146 GEN4_TO_CONTROLLER_LOG:GEN4_DEBUG_INT_LOG_ATtiny1627 Pre:SetSoftwareBreakpoint
3986 1721593071146 GEN4_TO_CONTROLLER_LOG:GEN4_DEBUG_INT_LOG_ATtiny1627 Payload
3986 1721593071146 GEN4_TO_CONTROLLER_LOG:GEN4_DEBUG_INT_LOG_ATtiny1627 133
3986 1721593071146 GEN4_TO_CONTROLLER_LOG:GEN4_DEBUG_INT_LOG_ATtiny1627 9598
3986 1721593071146 GEN4_TO_CONTROLLER_LOG:GEN4_DEBUG_INT_LOG_ATtiny1627 1
3986 1721593071146 GEN4_TO_CONTROLLER_LOG:GEN4_DEBUG_INT_LOG_ATtiny1627 Payload End
3986 1721593071146 pro JtagIce3 [0x12] <<< 43 00 66 02 00 00 
3986 1721593071148 pro JtagIce3 [0x12] >>> 80 00 
3986 1721593071148 GEN4_TO_CONTROLLER_LOG:GEN4_DEBUG_INT_LOG_ATtiny1627 Post:SetSoftwareBreakpoint
3986 1721593071148 GEN4_TO_CONTROLLER_LOG:GEN4_DEBUG_INT_LOG_ATtiny1627 Return Value
3986 1721593071148 GEN4_TO_CONTROLLER_LOG:GEN4_DEBUG_INT_LOG_ATtiny1627 9598
3986 1721593071148 GEN4_TO_CONTROLLER_LOG:GEN4_DEBUG_INT_LOG_ATtiny1627 Return End

3986 1721593071148 GEN4_TO_CONTROLLER_LOG:GEN4_DEBUG_INT_LOG_ATtiny1627 Pre:SetSoftwareBreakpoint
3986 1721593071148 GEN4_TO_CONTROLLER_LOG:GEN4_DEBUG_INT_LOG_ATtiny1627 Payload
3986 1721593071148 GEN4_TO_CONTROLLER_LOG:GEN4_DEBUG_INT_LOG_ATtiny1627 147
3986 1721593071148 GEN4_TO_CONTROLLER_LOG:GEN4_DEBUG_INT_LOG_ATtiny1627 9598
3986 1721593071148 GEN4_TO_CONTROLLER_LOG:GEN4_DEBUG_INT_LOG_ATtiny1627 1
3986 1721593071148 GEN4_TO_CONTROLLER_LOG:GEN4_DEBUG_INT_LOG_ATtiny1627 Payload End
3986 1721593071148 pro JtagIce3 [0x12] <<< 43 00 8E 02 00 00 
3986 1721593071149 pro JtagIce3 [0x12] >>> 80 00 
3986 1721593071149 GEN4_TO_CONTROLLER_LOG:GEN4_DEBUG_INT_LOG_ATtiny1627 Post:SetSoftwareBreakpoint
3986 1721593071149 GEN4_TO_CONTROLLER_LOG:GEN4_DEBUG_INT_LOG_ATtiny1627 Return Value
3986 1721593071149 GEN4_TO_CONTROLLER_LOG:GEN4_DEBUG_INT_LOG_ATtiny1627 9598
3986 1721593071149 GEN4_TO_CONTROLLER_LOG:GEN4_DEBUG_INT_LOG_ATtiny1627 Return End

3986 1721593071149 GEN4_TO_CONTROLLER_LOG:GEN4_DEBUG_INT_LOG_ATtiny1627 Pre:GetPC
3986 1721593071149 GEN4_TO_CONTROLLER_LOG:GEN4_DEBUG_INT_LOG_ATtiny1627 Payload
3986 1721593071149 GEN4_TO_CONTROLLER_LOG:GEN4_DEBUG_INT_LOG_ATtiny1627 null
3986 1721593071149 GEN4_TO_CONTROLLER_LOG:GEN4_DEBUG_INT_LOG_ATtiny1627 Payload End
3986 1721593071149 pro JtagIce3 [0x12] <<< 35 00 
3986 1721593071150 pro JtagIce3 [0x12] >>> 83 00 00 00 00 00 
3986 1721593071150 GEN4_TO_CONTROLLER_LOG:GEN4_DEBUG_INT_LOG_ATtiny1627 Post:GetPC
3986 1721593071150 GEN4_TO_CONTROLLER_LOG:GEN4_DEBUG_INT_LOG_ATtiny1627 Return Value
3986 1721593071150 GEN4_TO_CONTROLLER_LOG:GEN4_DEBUG_INT_LOG_ATtiny1627 0
3986 1721593071150 GEN4_TO_CONTROLLER_LOG:GEN4_DEBUG_INT_LOG_ATtiny1627 Return End

3986 1721593071150 GEN4_TO_CONTROLLER_LOG:GEN4_DEBUG_INT_LOG_ATtiny1627 Pre:RunTarget
3986 1721593071150 GEN4_TO_CONTROLLER_LOG:GEN4_DEBUG_INT_LOG_ATtiny1627 Payload
3986 1721593071150 GEN4_TO_CONTROLLER_LOG:GEN4_DEBUG_INT_LOG_ATtiny1627 com.microchip.mplab.mdbcore.RI4Tool.atmelice.AIceDebugHandlerWithBP@783948ab
3986 1721593071150 GEN4_TO_CONTROLLER_LOG:GEN4_DEBUG_INT_LOG_ATtiny1627 Payload End
3986 1721593071150 pro JtagIce3 [0x12] <<< 32 00 
3986 1721593071177 pro JtagIce3 [0x12] >>> 80 00 
3986 1721593071178 GEN4_TO_CONTROLLER_LOG:GEN4_DEBUG_INT_LOG_ATtiny1627 Post:RunTarget
3986 1721593071178 GEN4_TO_CONTROLLER_LOG:GEN4_DEBUG_INT_LOG_ATtiny1627 Return Value
3986 1721593071178 GEN4_TO_CONTROLLER_LOG:GEN4_DEBUG_INT_LOG_ATtiny1627 true
3986 1721593071178 GEN4_TO_CONTROLLER_LOG:GEN4_DEBUG_INT_LOG_ATtiny1627 Return End
3986 1721593092809 pro JtagIce3 ||| 0E 00 45 01 01 11 00 01 00 

3986 1721593096914 GEN4_TO_CONTROLLER_LOG:GEN4_DEBUG_INT_LOG_ATtiny1627 Pre:HaltTarget
3986 1721593096914 GEN4_TO_CONTROLLER_LOG:GEN4_DEBUG_INT_LOG_ATtiny1627 Payload
3986 1721593096914 GEN4_TO_CONTROLLER_LOG:GEN4_DEBUG_INT_LOG_ATtiny1627 null
3986 1721593096914 GEN4_TO_CONTROLLER_LOG:GEN4_DEBUG_INT_LOG_ATtiny1627 Payload End
3986 1721593096914 pro JtagIce3 [0x12] <<< 31 00 01 
3986 1721593097064 pro JtagIce3 [0x12] >>> A0 00 1C 

2511 1721593100425 GEN4_TO_CONTROLLER_LOG:GEN4_DEBUG_INT_LOG_ATtiny1627 Pre:SetSoftwareBreakpoint
2511 1721593100425 GEN4_TO_CONTROLLER_LOG:GEN4_DEBUG_INT_LOG_ATtiny1627 Payload
2511 1721593100425 GEN4_TO_CONTROLLER_LOG:GEN4_DEBUG_INT_LOG_ATtiny1627 133
2511 1721593100425 GEN4_TO_CONTROLLER_LOG:GEN4_DEBUG_INT_LOG_ATtiny1627 9598
2511 1721593100425 GEN4_TO_CONTROLLER_LOG:GEN4_DEBUG_INT_LOG_ATtiny1627 0
2511 1721593100425 GEN4_TO_CONTROLLER_LOG:GEN4_DEBUG_INT_LOG_ATtiny1627 Payload End
2511 1721593100425 pro JtagIce3 [0x12] <<< 44 00 66 02 00 00 

2511 1721593100426 GEN4_TO_CONTROLLER_LOG:GEN4_DEBUG_INT_LOG_ATtiny1627 Pre:SetSoftwareBreakpoint
2511 1721593100426 GEN4_TO_CONTROLLER_LOG:GEN4_DEBUG_INT_LOG_ATtiny1627 Payload
2511 1721593100426 GEN4_TO_CONTROLLER_LOG:GEN4_DEBUG_INT_LOG_ATtiny1627 133
2511 1721593100426 GEN4_TO_CONTROLLER_LOG:GEN4_DEBUG_INT_LOG_ATtiny1627 9598
2511 1721593100426 GEN4_TO_CONTROLLER_LOG:GEN4_DEBUG_INT_LOG_ATtiny1627 0
2511 1721593100426 GEN4_TO_CONTROLLER_LOG:GEN4_DEBUG_INT_LOG_ATtiny1627 Payload End
2511 1721593100426 pro JtagIce3 [0x12] <<< 44 00 66 02 00 00 

2511 1721593100426 GEN4_TO_CONTROLLER_LOG:GEN4_DEBUG_INT_LOG_ATtiny1627 Pre:SetSoftwareBreakpoint
2511 1721593100426 GEN4_TO_CONTROLLER_LOG:GEN4_DEBUG_INT_LOG_ATtiny1627 Payload
2511 1721593100426 GEN4_TO_CONTROLLER_LOG:GEN4_DEBUG_INT_LOG_ATtiny1627 133
2511 1721593100426 GEN4_TO_CONTROLLER_LOG:GEN4_DEBUG_INT_LOG_ATtiny1627 9598
2511 1721593100426 GEN4_TO_CONTROLLER_LOG:GEN4_DEBUG_INT_LOG_ATtiny1627 0
2511 1721593100426 GEN4_TO_CONTROLLER_LOG:GEN4_DEBUG_INT_LOG_ATtiny1627 Payload End
2511 1721593100426 pro JtagIce3 [0x12] <<< 44 00 66 02 00 00 
2511 1721593100428 pro JtagIce3 [0x12] >>> A0 00 32 
4244 1721593106576 GEN4_CONNECT_DIAGNOSTICS:MPLABCommTool is null

4244 1721593106576 GEN4_TO_CONTROLLER_LOG:GEN4_DEBUG_INT_LOG_ATtiny1627 Pre:EndDebugSession
4244 1721593106576 GEN4_TO_CONTROLLER_LOG:GEN4_DEBUG_INT_LOG_ATtiny1627 Payload
4244 1721593106576 GEN4_TO_CONTROLLER_LOG:GEN4_DEBUG_INT_LOG_ATtiny1627 null
4244 1721593106576 GEN4_TO_CONTROLLER_LOG:GEN4_DEBUG_INT_LOG_ATtiny1627 Payload End
4244 1721593106576 pro JtagIce3 [0x12] <<< 45 00 
4244 1721593106577 pro JtagIce3 [0x12] >>> A0 00 32 
4244 1721593106578 GEN4_CONNECT_DIAGNOSTICS:Removing plug and play observer com.microchip.mplab.mdbcore.RI4Tool.RI4ToolBase$RI4PlugNPlayObserver@30f33bca
4244 1721593106578 GEN4_CONNECT_DIAGNOSTICS:Begin PlugNPlayObservers list dump:
4244 1721593106578 GEN4_CONNECT_DIAGNOSTICS:End PlugNPlayObservers list dump:
4244 1721593106680 GEN4_CONNECT_DIAGNOSTICS:Calling RIDbgToolCom.Disconnect
4244 1721593106680 GEN4_CONNECT_DIAGNOSTICS:Calling MPLABCommTool.Detach to remove tool from plug and play list
4244 1721593106680 GEN4_CONNECT_DIAGNOSTICS:Calling RIDbgToolCom.DisconnectFromMPlabComm
4244 1721593106680 GEN4_CONNECT_DIAGNOSTICS:Calling MPLABCommTool.Disconnect
4244 1721593106680 GEN4_CONNECT_DIAGNOSTICS:MPLABCommTool is NOT null
4244 1721593106680 GEN4_CONNECT_DIAGNOSTICS:AttachedToolPID = 2141, AttachedToolVID = 3eb
4244 1721593106680 GEN4_CONNECT_DIAGNOSTICS:transport type = USB
4244 1721593106680 GEN4_CONNECT_DIAGNOSTICS:AttachedToolPID = 2141, AttachedToolVID = 3eb
4244 1721593106681 com.microchip.mplab.mdbcore.RealICETool.RIDbgToolCom
4244 1721593106681 GEN4_CONNECT_DIAGNOSTICS:Before MPLABCommTool.Connect()
4244 1721593106681 GEN4_CONNECT_DIAGNOSTICS:After MPLABCommTool.Connect()
4244 1721593106681 GEN4_CONNECT_DIAGNOSTICS:MPLABCommTool.Connect() returned MPLABCOMM_NO_ERROR
4244 1721593106681 GEN4_CONNECT_DIAGNOSTICS:Attaching to MPLABCommTool plugnplay
4244 1721593106681 GEN4_CONNECT_DIAGNOSTICS:Adding new plug and play observer com.microchip.mplab.mdbcore.RI4Tool.RI4ToolBase$RI4PlugNPlayObserver@a30e648
4244 1721593106681 GEN4_CONNECT_DIAGNOSTICS:Begin PlugNPlayObservers list dump:
4244 1721593106681 GEN4_CONNECT_DIAGNOSTICS:com.microchip.mplab.mdbcore.RI4Tool.RI4ToolBase$RI4PlugNPlayObserver@a30e648
4244 1721593106681 GEN4_CONNECT_DIAGNOSTICS:End PlugNPlayObservers list dump:
4244 1721593106681 GEN4_CONNECT_DIAGNOSTICS:Registering for alternate PNP notifications. CommPnPCriteria.cPIDList = [2177, 2179, 217a, 2142, 2142], CommPnPCriteria.cSerialNumber = j42700073141

4244 1721593106689 GEN4_TO_CONTROLLER_LOG:GEN4_INIT_INT_LOG_ATtiny1627 Pre:init
4244 1721593106689 GEN4_TO_CONTROLLER_LOG:GEN4_INIT_INT_LOG_ATtiny1627 Payload
4244 1721593106689 GEN4_TO_CONTROLLER_LOG:GEN4_INIT_INT_LOG_ATtiny1627 DeviceInfo: Values:
4244 1721593106689 GEN4_TO_CONTROLLER_LOG:GEN4_INIT_INT_LOG_ATtiny1627 DeviceInfo: pcAddress = 7fffffffffffffff, Vpp = 5.00, useRowEraseIfVoltageIsLow = false, voltageBelowWhichUseRowErase = 0.00, deviceName = ATtiny1627, programmerType = 
4244 1721593106689 GEN4_TO_CONTROLLER_LOG:GEN4_INIT_INT_LOG_ATtiny1627 DeviceInfo: MemInfo values:
4244 1721593106689 GEN4_TO_CONTROLLER_LOG:GEN4_INIT_INT_LOG_ATtiny1627 DeviceInfo: mask = ffff, exists = true, startAddr = 00000000, endAddr = 00003fff, rowSize = 0040, rowEraseSize = 0040, addrInc = 0001, widthProgram = 0001
4244 1721593106689 GEN4_TO_CONTROLLER_LOG:GEN4_INIT_INT_LOG_ATtiny1627 DeviceInfo: mask = 00ff, exists = true, startAddr = 00821280, endAddr = 0083128a, rowSize = 0001, rowEraseSize = 0000, addrInc = 0001, widthProgram = 0001
4244 1721593106689 GEN4_TO_CONTROLLER_LOG:GEN4_INIT_INT_LOG_ATtiny1627 DeviceInfo: mask = 0000, exists = false, startAddr = 00000000, endAddr = 00000000, rowSize = 0000, rowEraseSize = 0000, addrInc = 0000, widthProgram = 0000
4244 1721593106689 GEN4_TO_CONTROLLER_LOG:GEN4_INIT_INT_LOG_ATtiny1627 DeviceInfo: mask = 00ff, exists = true, startAddr = 00001400, endAddr = 000014ff, rowSize = 0020, rowEraseSize = 0000, addrInc = 0001, widthProgram = 0001
4244 1721593106689 GEN4_TO_CONTROLLER_LOG:GEN4_INIT_INT_LOG_ATtiny1627 DeviceInfo: mask = 00ff, exists = true, startAddr = 00001300, endAddr = 0000131f, rowSize = 0020, rowEraseSize = 0000, addrInc = 0001, widthProgram = 0001
4244 1721593106689 GEN4_TO_CONTROLLER_LOG:GEN4_INIT_INT_LOG_ATtiny1627 DeviceInfo: mask = 0000, exists = false, startAddr = 00000000, endAddr = 00000000, rowSize = 0000, rowEraseSize = 0040, addrInc = 0000, widthProgram = 0000
4244 1721593106689 GEN4_TO_CONTROLLER_LOG:GEN4_INIT_INT_LOG_ATtiny1627 DeviceInfo: mask = 0000, exists = false, startAddr = 00000000, endAddr = 00000000, rowSize = 0000, rowEraseSize = 0000, addrInc = 0001, widthProgram = 0001
4244 1721593106689 GEN4_TO_CONTROLLER_LOG:GEN4_INIT_INT_LOG_ATtiny1627 DeviceInfo: mask = 0000, exists = false, startAddr = 00000000, endAddr = 00000000, rowSize = 0000, rowEraseSize = 0000, addrInc = 0000, widthProgram = 0000
4244 1721593106689 GEN4_TO_CONTROLLER_LOG:GEN4_INIT_INT_LOG_ATtiny1627 DeviceInfo: mask = 0000, exists = false, startAddr = 00000000, endAddr = 00000000, rowSize = 0000, rowEraseSize = 0000, addrInc = 0000, widthProgram = 0000
4244 1721593106689 GEN4_TO_CONTROLLER_LOG:GEN4_INIT_INT_LOG_ATtiny1627 DeviceInfo: mask = 0000, exists = false, startAddr = 00000000, endAddr = 00000000, rowSize = 0000, rowEraseSize = 0000, addrInc = 0000, widthProgram = 0000
4244 1721593106689 GEN4_TO_CONTROLLER_LOG:GEN4_INIT_INT_LOG_ATtiny1627 DeviceInfo: mask = 0000, exists = false, startAddr = 00000000, endAddr = 00000000, rowSize = 0000, rowEraseSize = 0000, addrInc = 0000, widthProgram = 0000
4244 1721593106689 GEN4_TO_CONTROLLER_LOG:GEN4_INIT_INT_LOG_ATtiny1627 DeviceInfo: mask = 0000, exists = false, startAddr = 00000000, endAddr = 00000000, rowSize = 0000, rowEraseSize = 0000, addrInc = 0001, widthProgram = 0001
4244 1721593106689 GEN4_TO_CONTROLLER_LOG:GEN4_INIT_INT_LOG_ATtiny1627 DeviceInfo: mask = 0000, exists = false, startAddr = 00000000, endAddr = 00000000, rowSize = 0000, rowEraseSize = 0000, addrInc = 0000, widthProgram = 0000
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
4244 1721593106689 GEN4_TO_CONTROLLER_LOG:GEN4_INIT_INT_LOG_ATtiny1627 Address = 00001121, Mask = 00000000
4244 1721593106689 GEN4_TO_CONTROLLER_LOG:GEN4_INIT_INT_LOG_ATtiny1627 Address = 00821280, Mask = 000000ff
4244 1721593106689 GEN4_TO_CONTROLLER_LOG:GEN4_INIT_INT_LOG_ATtiny1627 Address = 00821281, Mask = 000000ff
4244 1721593106689 GEN4_TO_CONTROLLER_LOG:GEN4_INIT_INT_LOG_ATtiny1627 Address = 00821282, Mask = 00000083
4244 1721593106689 GEN4_TO_CONTROLLER_LOG:GEN4_INIT_INT_LOG_ATtiny1627 Address = 00821285, Mask = 000000dd
4244 1721593106689 GEN4_TO_CONTROLLER_LOG:GEN4_INIT_INT_LOG_ATtiny1627 Address = 00821286, Mask = 00000007
4244 1721593106689 GEN4_TO_CONTROLLER_LOG:GEN4_INIT_INT_LOG_ATtiny1627 Address = 00821287, Mask = 000000ff
4244 1721593106689 GEN4_TO_CONTROLLER_LOG:GEN4_INIT_INT_LOG_ATtiny1627 Address = 00821288, Mask = 000000ff
4244 1721593106689 GEN4_TO_CONTROLLER_LOG:GEN4_INIT_INT_LOG_ATtiny1627 Address = 0083128a, Mask = 000000ff
4244 1721593106689 GEN4_TO_CONTROLLER_LOG:GEN4_INIT_INT_LOG_ATtiny1627 BasicInfo: Values:
4244 1721593106689 GEN4_TO_CONTROLLER_LOG:GEN4_INIT_INT_LOG_ATtiny1627 Payload End
4244 1721593106689 GEN4_TO_CONTROLLER_LOG:GEN4_INIT_INT_LOG_ATtiny1627 Post:init
4244 1721593106689 GEN4_TO_CONTROLLER_LOG:GEN4_INIT_INT_LOG_ATtiny1627 Return Value
4244 1721593106689 GEN4_TO_CONTROLLER_LOG:GEN4_INIT_INT_LOG_ATtiny1627 none
4244 1721593106689 GEN4_TO_CONTROLLER_LOG:GEN4_INIT_INT_LOG_ATtiny1627 Return End

4244 1721593106689 GEN4_TO_CONTROLLER_LOG:GEN4_INIT_INT_LOG_ATtiny1627 Pre:GetInterfaceProvider
4244 1721593106689 GEN4_TO_CONTROLLER_LOG:GEN4_INIT_INT_LOG_ATtiny1627 Payload
4244 1721593106689 GEN4_TO_CONTROLLER_LOG:GEN4_INIT_INT_LOG_ATtiny1627 RI4DebugInterface
4244 1721593106689 GEN4_TO_CONTROLLER_LOG:GEN4_INIT_INT_LOG_ATtiny1627 Payload End
4244 1721593106689 GEN4_TO_CONTROLLER_LOG:GEN4_INIT_INT_LOG_ATtiny1627 Post:GetInterfaceProvider
4244 1721593106689 GEN4_TO_CONTROLLER_LOG:GEN4_INIT_INT_LOG_ATtiny1627 Return Value
4244 1721593106689 GEN4_TO_CONTROLLER_LOG:GEN4_INIT_INT_LOG_ATtiny1627 com.microchip.mplab.libs.atmelice.implementations.DebugInterface@2799484b
4244 1721593106689 GEN4_TO_CONTROLLER_LOG:GEN4_INIT_INT_LOG_ATtiny1627 Return End

4244 1721593106689 GEN4_TO_CONTROLLER_LOG:GEN4_INIT_INT_LOG_ATtiny1627 Pre:GetInterfaceProvider
4244 1721593106689 GEN4_TO_CONTROLLER_LOG:GEN4_INIT_INT_LOG_ATtiny1627 Payload
4244 1721593106689 GEN4_TO_CONTROLLER_LOG:GEN4_INIT_INT_LOG_ATtiny1627 RI4ProgramInterface
4244 1721593106689 GEN4_TO_CONTROLLER_LOG:GEN4_INIT_INT_LOG_ATtiny1627 Payload End
4244 1721593106689 GEN4_TO_CONTROLLER_LOG:GEN4_INIT_INT_LOG_ATtiny1627 Post:GetInterfaceProvider
4244 1721593106689 GEN4_TO_CONTROLLER_LOG:GEN4_INIT_INT_LOG_ATtiny1627 Return Value
4244 1721593106689 GEN4_TO_CONTROLLER_LOG:GEN4_INIT_INT_LOG_ATtiny1627 com.microchip.mplab.libs.atmelice.implementations.ProgramInterface@678f1da2
4244 1721593106689 GEN4_TO_CONTROLLER_LOG:GEN4_INIT_INT_LOG_ATtiny1627 Return End

4244 1721593106689 GEN4_TO_CONTROLLER_LOG:GEN4_INIT_INT_LOG_ATtiny1627 Pre:GetInterfaceProvider
4244 1721593106689 GEN4_TO_CONTROLLER_LOG:GEN4_INIT_INT_LOG_ATtiny1627 Payload
4244 1721593106689 GEN4_TO_CONTROLLER_LOG:GEN4_INIT_INT_LOG_ATtiny1627 RI4ConnectInterface
4244 1721593106689 GEN4_TO_CONTROLLER_LOG:GEN4_INIT_INT_LOG_ATtiny1627 Payload End
4244 1721593106689 GEN4_TO_CONTROLLER_LOG:GEN4_INIT_INT_LOG_ATtiny1627 Post:GetInterfaceProvider
4244 1721593106689 GEN4_TO_CONTROLLER_LOG:GEN4_INIT_INT_LOG_ATtiny1627 Return Value
4244 1721593106689 GEN4_TO_CONTROLLER_LOG:GEN4_INIT_INT_LOG_ATtiny1627 com.microchip.mplab.libs.atmelice.implementations.ConnectInterface@57f6a5b8
4244 1721593106689 GEN4_TO_CONTROLLER_LOG:GEN4_INIT_INT_LOG_ATtiny1627 Return End

4244 1721593106689 GEN4_TO_CONTROLLER_LOG:GEN4_INIT_INT_LOG_ATtiny1627 Pre:GetInterfaceProvider
4244 1721593106689 GEN4_TO_CONTROLLER_LOG:GEN4_INIT_INT_LOG_ATtiny1627 Payload
4244 1721593106689 GEN4_TO_CONTROLLER_LOG:GEN4_INIT_INT_LOG_ATtiny1627 RI4ControllerDiagnosticsInterface
4244 1721593106689 GEN4_TO_CONTROLLER_LOG:GEN4_INIT_INT_LOG_ATtiny1627 Payload End
4244 1721593106689 GEN4_TO_CONTROLLER_LOG:GEN4_INIT_INT_LOG_ATtiny1627 Post:GetInterfaceProvider
4244 1721593106689 GEN4_TO_CONTROLLER_LOG:GEN4_INIT_INT_LOG_ATtiny1627 Return Value
4244 1721593106689 GEN4_TO_CONTROLLER_LOG:GEN4_INIT_INT_LOG_ATtiny1627 com.microchip.mplab.libs.atmelice.implementations.UnimplementedDiagnostics@307624eb
4244 1721593106689 GEN4_TO_CONTROLLER_LOG:GEN4_INIT_INT_LOG_ATtiny1627 Return End

4244 1721593106689 GEN4_TO_CONTROLLER_LOG:GEN4_INIT_INT_LOG_ATtiny1627 Pre:GetInterfaceProvider
4244 1721593106689 GEN4_TO_CONTROLLER_LOG:GEN4_INIT_INT_LOG_ATtiny1627 Payload
4244 1721593106689 GEN4_TO_CONTROLLER_LOG:GEN4_INIT_INT_LOG_ATtiny1627 ProgrammerToGo
4244 1721593106689 GEN4_TO_CONTROLLER_LOG:GEN4_INIT_INT_LOG_ATtiny1627 Payload End
4244 1721593106689 GEN4_TO_CONTROLLER_LOG:GEN4_INIT_INT_LOG_ATtiny1627 Post:GetInterfaceProvider
4244 1721593106689 GEN4_TO_CONTROLLER_LOG:GEN4_INIT_INT_LOG_ATtiny1627 Return Value
4244 1721593106689 GEN4_TO_CONTROLLER_LOG:GEN4_INIT_INT_LOG_ATtiny1627 null
4244 1721593106689 GEN4_TO_CONTROLLER_LOG:GEN4_INIT_INT_LOG_ATtiny1627 Return End

4244 1721593106689 GEN4_TO_CONTROLLER_LOG:GEN4_INIT_INT_LOG_ATtiny1627 Pre:GetInterfaceProvider
4244 1721593106689 GEN4_TO_CONTROLLER_LOG:GEN4_INIT_INT_LOG_ATtiny1627 Payload
4244 1721593106689 GEN4_TO_CONTROLLER_LOG:GEN4_INIT_INT_LOG_ATtiny1627 Status
4244 1721593106689 GEN4_TO_CONTROLLER_LOG:GEN4_INIT_INT_LOG_ATtiny1627 Payload End
4244 1721593106689 GEN4_TO_CONTROLLER_LOG:GEN4_INIT_INT_LOG_ATtiny1627 Post:GetInterfaceProvider
4244 1721593106689 GEN4_TO_CONTROLLER_LOG:GEN4_INIT_INT_LOG_ATtiny1627 Return Value
4244 1721593106689 GEN4_TO_CONTROLLER_LOG:GEN4_INIT_INT_LOG_ATtiny1627 null
4244 1721593106689 GEN4_TO_CONTROLLER_LOG:GEN4_INIT_INT_LOG_ATtiny1627 Return End

4244 1721593106690 GEN4_TO_CONTROLLER_LOG:GEN4_CONNECT_INT_LOG Pre:EstablishCommunincations
4244 1721593106690 GEN4_TO_CONTROLLER_LOG:GEN4_CONNECT_INT_LOG Payload
4244 1721593106690 GEN4_TO_CONTROLLER_LOG:GEN4_CONNECT_INT_LOG com.microchip.mplab.mdbcore.AtmelIceScripting.AIceScriptingCom@5d40e9be
4244 1721593106690 GEN4_TO_CONTROLLER_LOG:GEN4_CONNECT_INT_LOG Payload End
4244 1721593106690 NativeController::EstablishCommunincations entry
4244 1721593106690 pro JtagIce3 [0x00] <<< 00 00 00 
4244 1721593106692 pro JtagIce3 [0x00] >>> 81 00 00 01 11 12 13 14 
4244 1721593106692 pro JtagIce3 [0x01] <<< 10 00 
4244 1721593106693 pro JtagIce3 [0x01] >>> 80 00 
4244 1721593106693 pro JtagIce3 [0x00] <<< 00 00 03 
4244 1721593106694 pro JtagIce3 [0x00] >>> 81 00 01 04 05 06 07 
4244 1721593106694 pro JtagIce3 [0x01] <<< 02 00 01 20 02 
4244 1721593106695 pro JtagIce3 [0x01] >>> 84 01 00 00 11 
4244 1721593106695 NativeController::EstablishCommunincations exit
4244 1721593106695 GEN4_TO_CONTROLLER_LOG:GEN4_CONNECT_INT_LOG Post:EstablishCommunincations
4244 1721593106695 GEN4_TO_CONTROLLER_LOG:GEN4_CONNECT_INT_LOG Return Value
4244 1721593106695 GEN4_TO_CONTROLLER_LOG:GEN4_CONNECT_INT_LOG true
4244 1721593106695 GEN4_TO_CONTROLLER_LOG:GEN4_CONNECT_INT_LOG Return End

4244 1721593106695 GEN4_TO_CONTROLLER_LOG:GEN4_CONNECT_INT_LOG Pre:GetFirmwareInfo
4244 1721593106695 GEN4_TO_CONTROLLER_LOG:GEN4_CONNECT_INT_LOG Payload
4244 1721593106695 GEN4_TO_CONTROLLER_LOG:GEN4_CONNECT_INT_LOG null
4244 1721593106695 GEN4_TO_CONTROLLER_LOG:GEN4_CONNECT_INT_LOG Payload End
4244 1721593106695 NativeController::GetFirmwareInfo entry
4244 1721593106695 pro JtagIce3 [0x01] <<< 02 00 00 00 01 
4244 1721593106696 pro JtagIce3 [0x01] >>> 84 01 00 00 
4244 1721593106696 NativeController::getFirmwareVersion entry
4244 1721593106696 pro JtagIce3 [0x01] <<< 02 00 00 01 01 
4244 1721593106697 pro JtagIce3 [0x01] >>> 84 01 01 00 
4244 1721593106697 pro JtagIce3 [0x01] <<< 02 00 00 02 01 
4244 1721593106698 pro JtagIce3 [0x01] >>> 84 01 2D 00 
4244 1721593106698 pro JtagIce3 [0x01] <<< 02 00 00 03 02 
4244 1721593106699 pro JtagIce3 [0x01] >>> 84 01 07 00 00 
4244 1721593106699 NativeController::getFirmwareVersion exit
4244 1721593106699 pro JtagIce3 [0x01] <<< 02 00 00 09 01 
4244 1721593106700 pro JtagIce3 [0x01] >>> 84 01 00 11 
4244 1721593106700 NativeController::tryGetFPGAVersion entry
4244 1721593106700 pro JtagIce3 [0x01] <<< 02 00 00 10 01 
4244 1721593106701 pro JtagIce3 [0x01] >>> 84 01 00 11 
4244 1721593106701 pro JtagIce3 [0x01] <<< 02 00 00 11 01 
4244 1721593106702 pro JtagIce3 [0x01] >>> 84 01 00 11 
4244 1721593106702 pro JtagIce3 [0x01] <<< 02 00 00 12 01 
4244 1721593106703 pro JtagIce3 [0x01] >>> 84 01 00 11 
4244 1721593106703 NativeController::tryGetFPGAVersion exit
4244 1721593106703 NativeController::tryGetFPGAVersion exit with exception No value present
4244 1721593106703 pro JtagIce3 [0x01] <<< 02 00 00 06 01 
4244 1721593106704 pro JtagIce3 [0x01] >>> 84 01 05 00 
4244 1721593106704 pro JtagIce3 [0x01] <<< 02 00 00 07 01 
4244 1721593106705 pro JtagIce3 [0x01] >>> 84 01 05 00 
4244 1721593106705 pro JtagIce3 [0x01] <<< 02 00 00 0A 01 
4244 1721593106706 pro JtagIce3 [0x01] >>> 84 01 00 11 
4244 1721593106706 NativeController::GetFirmwareInfo exit
4244 1721593106706 GEN4_TO_CONTROLLER_LOG:GEN4_CONNECT_INT_LOG Post:GetFirmwareInfo
4244 1721593106706 GEN4_TO_CONTROLLER_LOG:GEN4_CONNECT_INT_LOG Return Value
4244 1721593106706 GEN4_TO_CONTROLLER_LOG:GEN4_CONNECT_INT_LOG FirmwareInfo: Values:
4244 1721593106706 GEN4_TO_CONTROLLER_LOG:GEN4_CONNECT_INT_LOG FirmwareInfo: boot = false, bootVer = 5.5.0 (0x05.0x05.0x00), apVer = 1.45.7 (0x01.0x2d.0x07), fpgaVer = null, scriptVer = null, macAddress = , devID = 0, devID1 = 0, devSN0 = 0, devSN1 = 0, serialNumber = null, appCommitID = null, scriptCommitID = null, PCB_ID = 0
4244 1721593106706 GEN4_TO_CONTROLLER_LOG:GEN4_CONNECT_INT_LOG Return End
4244 1721593106706 GEN4_CONNECT_DIAGNOSTICS:ENTERING: com.microchip.mplab.mdbcore.RI4Tool.ConnectionHandler.CheckForFWUpdates()
4244 1721593106706 GEN4_CONNECT_DIAGNOSTICS:Created FirmwareUpdateHandler com.microchip.mplab.mdbcore.AtmelIceScripting.OperationHandlers.AIceScriptingFirmwareUpdateHandler@423d9db9

4244 1721593106708 GEN4_TO_CONTROLLER_LOG:GEN4_CONNECT_INT_LOG Pre:SetUpdateFirmwareInfo
4244 1721593106708 GEN4_TO_CONTROLLER_LOG:GEN4_CONNECT_INT_LOG Payload
4244 1721593106708 GEN4_TO_CONTROLLER_LOG:GEN4_CONNECT_INT_LOG UpdateFirmwareInfo: Values:
4244 1721593106708 GEN4_TO_CONTROLLER_LOG:GEN4_CONNECT_INT_LOG UpdateFirmwareInfo: license = dCejLCt9ZV4fWdqYk3htQgdNYCC2nccSTvVdTD2oCjW3gRUtjikRtla11IiYo1wq, updateId = 2147483647
4244 1721593106708 GEN4_TO_CONTROLLER_LOG:GEN4_CONNECT_INT_LOG Payload End
4244 1721593106708 GEN4_TO_CONTROLLER_LOG:GEN4_CONNECT_INT_LOG Post:SetUpdateFirmwareInfo
4244 1721593106708 GEN4_TO_CONTROLLER_LOG:GEN4_CONNECT_INT_LOG Return Value
4244 1721593106708 GEN4_TO_CONTROLLER_LOG:GEN4_CONNECT_INT_LOG none
4244 1721593106708 GEN4_TO_CONTROLLER_LOG:GEN4_CONNECT_INT_LOG Return End
4244 1721593106708 GEN4_CONNECT_DIAGNOSTICS:EXITING: com.microchip.mplab.mdbcore.RI4Tool.ConnectionHandler.CheckForFWUpdates()

4244 1721593106708 GEN4_TO_CONTROLLER_LOG:GEN4_CONNECT_INT_LOG Pre:SetPowerInfo
4244 1721593106708 GEN4_TO_CONTROLLER_LOG:GEN4_CONNECT_INT_LOG Payload
4244 1721593106708 GEN4_TO_CONTROLLER_LOG:GEN4_CONNECT_INT_LOG PowerInfo: Values:
4244 1721593106708 GEN4_TO_CONTROLLER_LOG:GEN4_CONNECT_INT_LOG PowerInfo: shotDownSystem = false, isToolPower = false, voltage = 5.000000, useVppFirst = false, useLowVoltageProgramming = true, useMaintainActivePower = false
4244 1721593106708 GEN4_TO_CONTROLLER_LOG:GEN4_CONNECT_INT_LOG Payload End
4244 1721593106708 NativeController::GetVoltageInfo entry
4244 1721593106708 pro JtagIce3 [0x01] <<< 02 00 01 00 02 
4244 1721593106709 pro JtagIce3 [0x01] >>> 84 01 AD 13 00 
4244 1721593106709 pro JtagIce3 [0x01] <<< 02 00 01 20 02 
4244 1721593106710 pro JtagIce3 [0x01] >>> 84 01 00 00 11 
4244 1721593106710 NativeController::GetVoltageInfo TSUP exit with exception + The requested command is not supported. (17)
4244 1721593106710 pro JtagIce3 [0x01] <<< 02 00 01 02 02 
4244 1721593106711 pro JtagIce3 [0x01] >>> 84 01 00 00 11 
4244 1721593106711 NativeController::GetVoltageInfo VUSB exit with exception + The requested command is not supported. (17)
4244 1721593106711 NativeController::GetVoltageInfo exit
4244 1721593106711 GEN4_TO_CONTROLLER_LOG:GEN4_CONNECT_INT_LOG Post:SetPowerInfo
4244 1721593106711 GEN4_TO_CONTROLLER_LOG:GEN4_CONNECT_INT_LOG Return Value
4244 1721593106711 GEN4_TO_CONTROLLER_LOG:GEN4_CONNECT_INT_LOG none
4244 1721593106711 GEN4_TO_CONTROLLER_LOG:GEN4_CONNECT_INT_LOG Return End

4244 1721593106711 GEN4_TO_CONTROLLER_LOG:GEN4_CONNECT_INT_LOG Pre:GetVoltageInfo
4244 1721593106711 GEN4_TO_CONTROLLER_LOG:GEN4_CONNECT_INT_LOG Payload
4244 1721593106711 GEN4_TO_CONTROLLER_LOG:GEN4_CONNECT_INT_LOG null
4244 1721593106711 GEN4_TO_CONTROLLER_LOG:GEN4_CONNECT_INT_LOG Payload End
4244 1721593106711 NativeController::GetVoltageInfo entry
4244 1721593106711 pro JtagIce3 [0x01] <<< 02 00 01 00 02 
4244 1721593106712 pro JtagIce3 [0x01] >>> 84 01 AF 13 00 
4244 1721593106712 pro JtagIce3 [0x01] <<< 02 00 01 20 02 
4244 1721593106713 pro JtagIce3 [0x01] >>> 84 01 00 00 11 
4244 1721593106713 NativeController::GetVoltageInfo TSUP exit with exception + The requested command is not supported. (17)
4244 1721593106713 pro JtagIce3 [0x01] <<< 02 00 01 02 02 
4244 1721593106714 pro JtagIce3 [0x01] >>> 84 01 00 00 11 
4244 1721593106714 NativeController::GetVoltageInfo VUSB exit with exception + The requested command is not supported. (17)
4244 1721593106714 NativeController::GetVoltageInfo exit
4244 1721593106714 GEN4_TO_CONTROLLER_LOG:GEN4_CONNECT_INT_LOG Post:GetVoltageInfo
4244 1721593106714 GEN4_TO_CONTROLLER_LOG:GEN4_CONNECT_INT_LOG Return Value
4244 1721593106714 GEN4_TO_CONTROLLER_LOG:GEN4_CONNECT_INT_LOG VoltagesInfo: Values:
4244 1721593106714 GEN4_TO_CONTROLLER_LOG:GEN4_CONNECT_INT_LOG VoltagesInfo: internalVdd = 0, internalVpp = 0, targetVdd = 0, targetVpp = -2147483648, vddSense = 5039, temp = 0, vddCurrentSense = 0, vddVoltageSense = -2147483648
4244 1721593106714 GEN4_TO_CONTROLLER_LOG:GEN4_CONNECT_INT_LOG Return End

4244 1721593106714 GEN4_TO_CONTROLLER_LOG:GEN4_CONNECT_INT_LOG Pre:SetLEDBrightness
4244 1721593106714 GEN4_TO_CONTROLLER_LOG:GEN4_CONNECT_INT_LOG Payload
4244 1721593106714 GEN4_TO_CONTROLLER_LOG:GEN4_CONNECT_INT_LOG 5
4244 1721593106714 GEN4_TO_CONTROLLER_LOG:GEN4_CONNECT_INT_LOG Payload End
4244 1721593106714 GEN4_TO_CONTROLLER_LOG:GEN4_CONNECT_INT_LOG Post:SetLEDBrightness
4244 1721593106714 GEN4_TO_CONTROLLER_LOG:GEN4_CONNECT_INT_LOG Return Value
4244 1721593106714 GEN4_TO_CONTROLLER_LOG:GEN4_CONNECT_INT_LOG none
4244 1721593106714 GEN4_TO_CONTROLLER_LOG:GEN4_CONNECT_INT_LOG Return End

4244 1721593106714 GEN4_TO_CONTROLLER_LOG:GEN4_CONNECT_INT_LOG Pre:SetToolInfo
4244 1721593106714 GEN4_TO_CONTROLLER_LOG:GEN4_CONNECT_INT_LOG Payload
4244 1721593106714 GEN4_TO_CONTROLLER_LOG:GEN4_CONNECT_INT_LOG ToolInfo: Values:
4244 1721593106714 GEN4_TO_CONTROLLER_LOG:GEN4_CONNECT_INT_LOG ToolInfo: speedLevel = 1, PGCResistance = 4700, PGDResistance = 4700, PGCPullDir = PullDown, PGDPullDir = PullDown, ICSPSelected = Wire2
4244 1721593106714 GEN4_TO_CONTROLLER_LOG:GEN4_CONNECT_INT_LOG Payload End
4244 1721593106714 GEN4_TO_CONTROLLER_LOG:GEN4_CONNECT_INT_LOG Post:SetToolInfo
4244 1721593106714 GEN4_TO_CONTROLLER_LOG:GEN4_CONNECT_INT_LOG Return Value
4244 1721593106714 GEN4_TO_CONTROLLER_LOG:GEN4_CONNECT_INT_LOG none
4244 1721593106714 GEN4_TO_CONTROLLER_LOG:GEN4_CONNECT_INT_LOG Return End

4244 1721593106714 GEN4_TO_CONTROLLER_LOG:GEN4_CONNECT_INT_LOG Pre:GetTargetIDInfo
4244 1721593106714 GEN4_TO_CONTROLLER_LOG:GEN4_CONNECT_INT_LOG Payload
4244 1721593106714 GEN4_TO_CONTROLLER_LOG:GEN4_CONNECT_INT_LOG null
4244 1721593106714 GEN4_TO_CONTROLLER_LOG:GEN4_CONNECT_INT_LOG Payload End
4244 1721593106714 NativeController::GetTargetIDInfo entry
4244 1721593106714 pro JtagIce3 [0x12] <<< 01 00 01 31 02 F4 01 
4244 1721593106715 pro JtagIce3 [0x12] >>> 80 00 
4244 1721593106715 pro JtagIce3 [0x12] <<< 01 00 00 00 01 05 
4244 1721593106716 pro JtagIce3 [0x12] >>> 80 00 
4244 1721593106716 pro JtagIce3 [0x12] <<< 01 00 00 01 01 01 
4244 1721593106717 pro JtagIce3 [0x12] >>> 80 00 
4244 1721593106717 pro JtagIce3 [0x12] <<< 01 00 01 00 01 08 
4244 1721593106718 pro JtagIce3 [0x12] >>> 80 00 
4244 1721593106718 pro JtagIce3 [0x12] <<< 01 00 02 00 30 00 80 40 20 00 10 80 0F 94 11 8C 0A 98 08 DC 05 EE 02 00 40 00 00 00 01 20 00 0A 05 FF 00 FF 00 00 14 00 13 00 11 80 12 8A 12 28 94 00 00 00 00 
4244 1721593106719 pro JtagIce3 [0x12] >>> 80 00 
4244 1721593106719 pro JtagIce3 [0x12] <<< 01 00 03 06 01 00 
4244 1721593106720 pro JtagIce3 [0x12] >>> 80 00 
4244 1721593106720 pro JtagIce3 [0x12] <<< 10 00 00 
4244 1721593106845 pro JtagIce3 [0x12] >>> 84 00 74 69 6E 79 00 
4244 1721593106845 pro JtagIce3 [0x12] <<< 01 00 03 06 01 00 
4244 1721593106846 pro JtagIce3 [0x12] >>> 80 00 
4244 1721593106846 pro JtagIce3 [0x12] <<< 15 00 
4244 1721593106909 pro JtagIce3 [0x12] >>> 80 00 
4244 1721593106909 pro JtagIce3 [0x12] <<< 21 00 B4 00 11 00 00 03 00 00 00 
4244 1721593106911 pro JtagIce3 [0x12] >>> 84 00 1E 94 28 00 
4244 1721593106911 pro JtagIce3 [0x12] <<< 21 00 B4 00 11 00 00 03 00 00 00 
4244 1721593106913 pro JtagIce3 [0x12] >>> 84 00 1E 94 28 00 
4244 1721593106913 pro JtagIce3 [0x12] <<< 21 00 B4 00 11 00 00 03 00 00 00 
4244 1721593106915 pro JtagIce3 [0x12] >>> 84 00 1E 94 28 00 
4244 1721593106915 pro JtagIce3 [0x12] <<< 21 00 B2 01 0F 00 00 01 00 00 00 
4244 1721593106916 pro JtagIce3 [0x12] >>> 84 00 04 00 
4244 1721593106916 pro JtagIce3 [0x12] <<< 16 00 
4244 1721593106918 pro JtagIce3 [0x12] >>> 80 00 
4244 1721593106918 pro JtagIce3 [0x12] <<< 11 00 
4244 1721593106920 pro JtagIce3 [0x12] >>> 80 00 
4244 1721593106920 pro JtagIce3 [0x01] <<< 11 00 00 
4244 1721593106921 pro JtagIce3 [0x01] >>> 80 00 
4244 1721593106921 NativeController::GetTargetIDInfo exit device ID 0x1e9428
4244 1721593106921 GEN4_TO_CONTROLLER_LOG:GEN4_CONNECT_INT_LOG Post:GetTargetIDInfo
4244 1721593106921 GEN4_TO_CONTROLLER_LOG:GEN4_CONNECT_INT_LOG Return Value
4244 1721593106921 GEN4_TO_CONTROLLER_LOG:GEN4_CONNECT_INT_LOG TargetIDInfo: Values:
4244 1721593106921 GEN4_TO_CONTROLLER_LOG:GEN4_CONNECT_INT_LOG TargetIDInfo: DeviceID = 001e9428
4244 1721593106921 GEN4_TO_CONTROLLER_LOG:GEN4_CONNECT_INT_LOG Return End

4244 1721593106927 GEN4_TO_CONTROLLER_LOG:GEN4_PROGRAM_INT_LOG_ATtiny1627 Pre:SendOperation
4244 1721593106927 GEN4_TO_CONTROLLER_LOG:GEN4_PROGRAM_INT_LOG_ATtiny1627 Payload
4244 1721593106927 GEN4_TO_CONTROLLER_LOG:GEN4_PROGRAM_INT_LOG_ATtiny1627 OperationInfo: Values:
4244 1721593106927 GEN4_TO_CONTROLLER_LOG:GEN4_PROGRAM_INT_LOG_ATtiny1627 OperationInfo: Type = erase, Mask = 00000000, Erase = false, Production Mode = false
4244 1721593106927 GEN4_TO_CONTROLLER_LOG:GEN4_PROGRAM_INT_LOG_ATtiny1627 TransferInfo: Start = 0, End = 3fff, Buffer Length = 0, Type = Pgm, Mask = 00000000
4244 1721593106927 GEN4_TO_CONTROLLER_LOG:GEN4_PROGRAM_INT_LOG_ATtiny1627 TransferInfo: Start = 1280, End = 1288, Buffer Length = 0, Type = Cfg, Mask = 00000000
4244 1721593106927 GEN4_TO_CONTROLLER_LOG:GEN4_PROGRAM_INT_LOG_ATtiny1627 TransferInfo: Start = 128a, End = 128a, Buffer Length = 0, Type = Cfg, Mask = 00000000
4244 1721593106927 GEN4_TO_CONTROLLER_LOG:GEN4_PROGRAM_INT_LOG_ATtiny1627 TransferInfo: Start = 1400, End = 14ff, Buffer Length = 0, Type = EEData, Mask = 00000000
4244 1721593106927 GEN4_TO_CONTROLLER_LOG:GEN4_PROGRAM_INT_LOG_ATtiny1627 TransferInfo: Start = 1300, End = 131f, Buffer Length = 0, Type = UserID, Mask = 00000000
4244 1721593106927 GEN4_TO_CONTROLLER_LOG:GEN4_PROGRAM_INT_LOG_ATtiny1627 Payload End
4244 1721593106927 pro JtagIce3 [0x12] <<< 01 00 01 31 02 F4 01 
4244 1721593106928 pro JtagIce3 [0x12] >>> 80 00 
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
4244 1721593107424 GEN4_TO_CONTROLLER_LOG:GEN4_DEBUG_INT_LOG_ATtiny1627 Return Value
4244 1721593107424 GEN4_TO_CONTROLLER_LOG:GEN4_DEBUG_INT_LOG_ATtiny1627 none
4244 1721593107424 GEN4_TO_CONTROLLER_LOG:GEN4_DEBUG_INT_LOG_ATtiny1627 Return End

4258 1721593107429 GEN4_TO_CONTROLLER_LOG:GEN4_DEBUG_INT_LOG_ATtiny1627 Pre:setTraceDescriptor
4258 1721593107429 GEN4_TO_CONTROLLER_LOG:GEN4_DEBUG_INT_LOG_ATtiny1627 Payload
4258 1721593107429 GEN4_TO_CONTROLLER_LOG:GEN4_DEBUG_INT_LOG_ATtiny1627 com.microchip.mplab.libs.RI4ToolsController.DataClasses.TraceDescriptor@2d2f9f0
4258 1721593107429 GEN4_TO_CONTROLLER_LOG:GEN4_DEBUG_INT_LOG_ATtiny1627 Payload End
4258 1721593107429 GEN4_TO_CONTROLLER_LOG:GEN4_DEBUG_INT_LOG_ATtiny1627 Post:setTraceDescriptor
4258 1721593107429 GEN4_TO_CONTROLLER_LOG:GEN4_DEBUG_INT_LOG_ATtiny1627 Return Value
4258 1721593107429 GEN4_TO_CONTROLLER_LOG:GEN4_DEBUG_INT_LOG_ATtiny1627 none
4258 1721593107429 GEN4_TO_CONTROLLER_LOG:GEN4_DEBUG_INT_LOG_ATtiny1627 Return End

4258 1721593107429 GEN4_TO_CONTROLLER_LOG:GEN4_DEBUG_INT_LOG_ATtiny1627 Pre:SetSoftwareBreakpoint
4258 1721593107429 GEN4_TO_CONTROLLER_LOG:GEN4_DEBUG_INT_LOG_ATtiny1627 Payload
4258 1721593107429 GEN4_TO_CONTROLLER_LOG:GEN4_DEBUG_INT_LOG_ATtiny1627 147
4258 1721593107429 GEN4_TO_CONTROLLER_LOG:GEN4_DEBUG_INT_LOG_ATtiny1627 9598
4258 1721593107429 GEN4_TO_CONTROLLER_LOG:GEN4_DEBUG_INT_LOG_ATtiny1627 1
4258 1721593107429 GEN4_TO_CONTROLLER_LOG:GEN4_DEBUG_INT_LOG_ATtiny1627 Payload End
4258 1721593107429 pro JtagIce3 [0x12] <<< 43 00 8E 02 00 00 
4258 1721593107430 pro JtagIce3 [0x12] >>> 80 00 
4258 1721593107430 GEN4_TO_CONTROLLER_LOG:GEN4_DEBUG_INT_LOG_ATtiny1627 Post:SetSoftwareBreakpoint
4258 1721593107430 GEN4_TO_CONTROLLER_LOG:GEN4_DEBUG_INT_LOG_ATtiny1627 Return Value
4258 1721593107430 GEN4_TO_CONTROLLER_LOG:GEN4_DEBUG_INT_LOG_ATtiny1627 9598
4258 1721593107430 GEN4_TO_CONTROLLER_LOG:GEN4_DEBUG_INT_LOG_ATtiny1627 Return End

4258 1721593107430 GEN4_TO_CONTROLLER_LOG:GEN4_DEBUG_INT_LOG_ATtiny1627 Pre:GetPC
4258 1721593107430 GEN4_TO_CONTROLLER_LOG:GEN4_DEBUG_INT_LOG_ATtiny1627 Payload
4258 1721593107430 GEN4_TO_CONTROLLER_LOG:GEN4_DEBUG_INT_LOG_ATtiny1627 null
4258 1721593107430 GEN4_TO_CONTROLLER_LOG:GEN4_DEBUG_INT_LOG_ATtiny1627 Payload End
4258 1721593107430 pro JtagIce3 [0x12] <<< 35 00 
4258 1721593107431 pro JtagIce3 [0x12] >>> 83 00 00 00 00 00 
4258 1721593107431 GEN4_TO_CONTROLLER_LOG:GEN4_DEBUG_INT_LOG_ATtiny1627 Post:GetPC
4258 1721593107431 GEN4_TO_CONTROLLER_LOG:GEN4_DEBUG_INT_LOG_ATtiny1627 Return Value
4258 1721593107431 GEN4_TO_CONTROLLER_LOG:GEN4_DEBUG_INT_LOG_ATtiny1627 0
4258 1721593107431 GEN4_TO_CONTROLLER_LOG:GEN4_DEBUG_INT_LOG_ATtiny1627 Return End

4258 1721593107431 GEN4_TO_CONTROLLER_LOG:GEN4_DEBUG_INT_LOG_ATtiny1627 Pre:RunTarget
4258 1721593107431 GEN4_TO_CONTROLLER_LOG:GEN4_DEBUG_INT_LOG_ATtiny1627 Payload
4258 1721593107431 GEN4_TO_CONTROLLER_LOG:GEN4_DEBUG_INT_LOG_ATtiny1627 com.microchip.mplab.mdbcore.RI4Tool.atmelice.AIceDebugHandlerWithBP@6ed7d72
4258 1721593107431 GEN4_TO_CONTROLLER_LOG:GEN4_DEBUG_INT_LOG_ATtiny1627 Payload End
4258 1721593107431 pro JtagIce3 [0x12] <<< 32 00 
4258 1721593107446 pro JtagIce3 [0x12] >>> 80 00 
4258 1721593107448 GEN4_TO_CONTROLLER_LOG:GEN4_DEBUG_INT_LOG_ATtiny1627 Post:RunTarget
4258 1721593107448 GEN4_TO_CONTROLLER_LOG:GEN4_DEBUG_INT_LOG_ATtiny1627 Return Value
4258 1721593107448 GEN4_TO_CONTROLLER_LOG:GEN4_DEBUG_INT_LOG_ATtiny1627 true
4258 1721593107448 GEN4_TO_CONTROLLER_LOG:GEN4_DEBUG_INT_LOG_ATtiny1627 Return End
4258 1721593112034 pro JtagIce3 ||| 0E 00 49 01 01 11 00 01 00
