RichardSefton/AUV/ExperimentalCode/A02YYUW.X/queuelogs/debugtool.txt

1116 1721085184798 GEN4_CONNECT_DIAGNOSTICS:MPLABCommTool is null

1116 1721085184798 GEN4_TO_CONTROLLER_LOG:GEN4_DEBUG_INT_LOG_ATtiny1627 Pre:EndDebugSession
1116 1721085184798 GEN4_TO_CONTROLLER_LOG:GEN4_DEBUG_INT_LOG_ATtiny1627 Payload
1116 1721085184798 GEN4_TO_CONTROLLER_LOG:GEN4_DEBUG_INT_LOG_ATtiny1627 null
1116 1721085184798 GEN4_TO_CONTROLLER_LOG:GEN4_DEBUG_INT_LOG_ATtiny1627 Payload End
1116 1721085184798 pro JtagIce3 [0x12] <<< 45 00
