RichardSefton/AUV/ExperimentalCode/Sonar_Test.X/queuelogs/debugtool.txt

549 1720829370531 GEN4_CONNECT_DIAGNOSTICS:MPLABCommTool is null

549 1720829370531 GEN4_TO_CONTROLLER_LOG:GEN4_CONNECT_INT_LOG Pre:GetFirmwareInfo
549 1720829370531 GEN4_TO_CONTROLLER_LOG:GEN4_CONNECT_INT_LOG Payload
549 1720829370531 GEN4_TO_CONTROLLER_LOG:GEN4_CONNECT_INT_LOG null
549 1720829370531 GEN4_TO_CONTROLLER_LOG:GEN4_CONNECT_INT_LOG Payload End
549 1720829370531 NativeController::GetFirmwareInfo entry
549 1720829370531 pro JtagIce3 [0x01] <<< 02 00 00 00 01 
549 1720829370532 pro JtagIce3 [0x01] >>> 84 01 00 00 
549 1720829370532 NativeController::getFirmwareVersion entry
549 1720829370532 pro JtagIce3 [0x01] <<< 02 00 00 01 01 
549 1720829370534 pro JtagIce3 [0x01] >>> 84 01 01 00 
549 1720829370534 pro JtagIce3 [0x01] <<< 02 00 00 02 01 
549 1720829370536 pro JtagIce3 [0x01] >>> 84 01 2D 00 
549 1720829370536 pro JtagIce3 [0x01] <<< 02 00 00 03 02 
549 1720829370537 pro JtagIce3 [0x01] >>> 84 01 07 00 00 
549 1720829370537 NativeController::getFirmwareVersion exit
549 1720829370537 pro JtagIce3 [0x01] <<< 02 00 00 09 01 
549 1720829370539 pro JtagIce3 [0x01] >>> 84 01 00 11 
549 1720829370539 NativeController::tryGetFPGAVersion entry
549 1720829370539 pro JtagIce3 [0x01] <<< 02 00 00 10 01 
549 1720829370540 pro JtagIce3 [0x01] >>> 84 01 00 11 
549 1720829370540 pro JtagIce3 [0x01] <<< 02 00 00 11 01 
549 1720829370541 pro JtagIce3 [0x01] >>> 84 01 00 11 
549 1720829370541 pro JtagIce3 [0x01] <<< 02 00 00 12 01 
549 1720829370543 pro JtagIce3 [0x01] >>> 84 01 00 11 
549 1720829370543 NativeController::tryGetFPGAVersion exit
549 1720829370543 NativeController::tryGetFPGAVersion exit with exception No value present
549 1720829370543 pro JtagIce3 [0x01] <<< 02 00 00 06 01 
549 1720829370544 pro JtagIce3 [0x01] >>> 84 01 05 00 
549 1720829370544 pro JtagIce3 [0x01] <<< 02 00 00 07 01 
549 1720829370545 pro JtagIce3 [0x01] >>> 84 01 05 00 
549 1720829370545 pro JtagIce3 [0x01] <<< 02 00 00 0A 01 
549 1720829370546 pro JtagIce3 [0x01] >>> 84 01 00 11 
549 1720829370546 NativeController::GetFirmwareInfo exit
549 1720829370546 GEN4_TO_CONTROLLER_LOG:GEN4_CONNECT_INT_LOG Post:GetFirmwareInfo
549 1720829370546 GEN4_TO_CONTROLLER_LOG:GEN4_CONNECT_INT_LOG Return Value
549 1720829370546 GEN4_TO_CONTROLLER_LOG:GEN4_CONNECT_INT_LOG FirmwareInfo: Values:
549 1720829370546 GEN4_TO_CONTROLLER_LOG:GEN4_CONNECT_INT_LOG FirmwareInfo: boot = false, bootVer = 5.5.0 (0x05.0x05.0x00), apVer = 1.45.7 (0x01.0x2d.0x07), fpgaVer = null, scriptVer = null, macAddress = , devID = 0, devID1 = 0, devSN0 = 0, devSN1 = 0, serialNumber = null, appCommitID = null, scriptCommitID = null, PCB_ID = 0
549 1720829370546 GEN4_TO_CONTROLLER_LOG:GEN4_CONNECT_INT_LOG Return End

549 1720829370546 GEN4_TO_CONTROLLER_LOG:GEN4_CONNECT_INT_LOG Pre:SetPowerInfo
549 1720829370546 GEN4_TO_CONTROLLER_LOG:GEN4_CONNECT_INT_LOG Payload
549 1720829370546 GEN4_TO_CONTROLLER_LOG:GEN4_CONNECT_INT_LOG PowerInfo: Values:
549 1720829370546 GEN4_TO_CONTROLLER_LOG:GEN4_CONNECT_INT_LOG PowerInfo: shotDownSystem = true, isToolPower = false, voltage = 0.000000, useVppFirst = false, useLowVoltageProgramming = true, useMaintainActivePower = false
549 1720829370546 GEN4_TO_CONTROLLER_LOG:GEN4_CONNECT_INT_LOG Payload End
549 1720829370546 NativeController::GetVoltageInfo entry
549 1720829370546 pro JtagIce3 [0x01] <<< 02 00 01 00 02 
549 1720829370547 pro JtagIce3 [0x01] >>> 84 01 E9 13 00 
549 1720829370547 pro JtagIce3 [0x01] <<< 02 00 01 20 02 
549 1720829370548 pro JtagIce3 [0x01] >>> 84 01 00 00 11 
549 1720829370548 NativeController::GetVoltageInfo TSUP exit with exception + The requested command is not supported. (17)
549 1720829370548 pro JtagIce3 [0x01] <<< 02 00 01 02 02 
549 1720829370549 pro JtagIce3 [0x01] >>> 84 01 00 00 11 
549 1720829370549 NativeController::GetVoltageInfo VUSB exit with exception + The requested command is not supported. (17)
549 1720829370549 NativeController::GetVoltageInfo exit
549 1720829370549 GEN4_TO_CONTROLLER_LOG:GEN4_CONNECT_INT_LOG Post:SetPowerInfo
549 1720829370549 GEN4_TO_CONTROLLER_LOG:GEN4_CONNECT_INT_LOG Return Value
549 1720829370549 GEN4_TO_CONTROLLER_LOG:GEN4_CONNECT_INT_LOG none
549 1720829370549 GEN4_TO_CONTROLLER_LOG:GEN4_CONNECT_INT_LOG Return End

549 1720829370549 GEN4_TO_CONTROLLER_LOG:GEN4_CONNECT_INT_LOG Pre:Disconnect
549 1720829370549 GEN4_TO_CONTROLLER_LOG:GEN4_CONNECT_INT_LOG Payload
549 1720829370549 GEN4_TO_CONTROLLER_LOG:GEN4_CONNECT_INT_LOG Payload End
549 1720829370549 NativeController::Disconnect entry
549 1720829370549 pro JtagIce3 [0x01] <<< 11 00 00 
549 1720829370550 pro JtagIce3 [0x01] >>> 80 00 
549 1720829370550 NativeController::Disconnect exit
549 1720829370550 GEN4_TO_CONTROLLER_LOG:GEN4_CONNECT_INT_LOG Post:Disconnect
549 1720829370550 GEN4_TO_CONTROLLER_LOG:GEN4_CONNECT_INT_LOG Return Value
549 1720829370550 GEN4_TO_CONTROLLER_LOG:GEN4_CONNECT_INT_LOG none
549 1720829370550 GEN4_TO_CONTROLLER_LOG:GEN4_CONNECT_INT_LOG Return End
549 1720829370550 GEN4_CONNECT_DIAGNOSTICS:Removing plug and play observer com.microchip.mplab.mdbcore.RI4Tool.RI4ToolBase$RI4PlugNPlayObserver@4736c712
549 1720829370550 GEN4_CONNECT_DIAGNOSTICS:Begin PlugNPlayObservers list dump:
549 1720829370550 GEN4_CONNECT_DIAGNOSTICS:End PlugNPlayObservers list dump:
549 1720829370650 GEN4_CONNECT_DIAGNOSTICS:Calling RIDbgToolCom.Disconnect
549 1720829370650 GEN4_CONNECT_DIAGNOSTICS:Calling MPLABCommTool.Detach to remove tool from plug and play list
549 1720829370650 GEN4_CONNECT_DIAGNOSTICS:Calling RIDbgToolCom.DisconnectFromMPlabComm
549 1720829370650 GEN4_CONNECT_DIAGNOSTICS:Calling MPLABCommTool.Disconnect
559 1720829397834 GEN4_CONNECT_DIAGNOSTICS:MPLABCommTool is NOT null
559 1720829397834 GEN4_CONNECT_DIAGNOSTICS:AttachedToolPID = 2141, AttachedToolVID = 3eb
559 1720829397834 GEN4_CONNECT_DIAGNOSTICS:transport type = USB
559 1720829397834 GEN4_CONNECT_DIAGNOSTICS:AttachedToolPID = 2141, AttachedToolVID = 3eb
559 1720829397834 com.microchip.mplab.mdbcore.RealICETool.RIDbgToolCom
559 1720829397834 GEN4_CONNECT_DIAGNOSTICS:Before MPLABCommTool.Connect()
559 1720829397834 GEN4_CONNECT_DIAGNOSTICS:After MPLABCommTool.Connect()
559 1720829397834 GEN4_CONNECT_DIAGNOSTICS:MPLABCommTool.Connect() returned MPLABCOMM_NO_ERROR
559 1720829397834 GEN4_CONNECT_DIAGNOSTICS:Attaching to MPLABCommTool plugnplay
559 1720829397835 GEN4_CONNECT_DIAGNOSTICS:Adding new plug and play observer com.microchip.mplab.mdbcore.RI4Tool.RI4ToolBase$RI4PlugNPlayObserver@2b6735ff
559 1720829397835 GEN4_CONNECT_DIAGNOSTICS:Begin PlugNPlayObservers list dump:
559 1720829397835 GEN4_CONNECT_DIAGNOSTICS:com.microchip.mplab.mdbcore.RI4Tool.RI4ToolBase$RI4PlugNPlayObserver@2b6735ff
559 1720829397835 GEN4_CONNECT_DIAGNOSTICS:End PlugNPlayObservers list dump:
559 1720829397836 GEN4_CONNECT_DIAGNOSTICS:Registering for alternate PNP notifications. CommPnPCriteria.cPIDList = [2177, 2179, 217a, 2142, 2142], CommPnPCriteria.cSerialNumber = j42700073141

559 1720829397849 GEN4_TO_CONTROLLER_LOG:GEN4_INIT_INT_LOG_ATtiny1627 Pre:init
559 1720829397849 GEN4_TO_CONTROLLER_LOG:GEN4_INIT_INT_LOG_ATtiny1627 Payload
559 1720829397849 GEN4_TO_CONTROLLER_LOG:GEN4_INIT_INT_LOG_ATtiny1627 DeviceInfo: Values:
559 1720829397850 GEN4_TO_CONTROLLER_LOG:GEN4_INIT_INT_LOG_ATtiny1627 DeviceInfo: pcAddress = 7fffffffffffffff, Vpp = 5.00, useRowEraseIfVoltageIsLow = false, voltageBelowWhichUseRowErase = 0.00, deviceName = ATtiny1627, programmerType = 
559 1720829397850 GEN4_TO_CONTROLLER_LOG:GEN4_INIT_INT_LOG_ATtiny1627 DeviceInfo: MemInfo values:
559 1720829397850 GEN4_TO_CONTROLLER_LOG:GEN4_INIT_INT_LOG_ATtiny1627 DeviceInfo: mask = ffff, exists = true, startAddr = 00000000, endAddr = 00003fff, rowSize = 0040, rowEraseSize = 0040, addrInc = 0001, widthProgram = 0001
559 1720829397850 GEN4_TO_CONTROLLER_LOG:GEN4_INIT_INT_LOG_ATtiny1627 DeviceInfo: mask = 00ff, exists = true, startAddr = 00821280, endAddr = 0083128a, rowSize = 0001, rowEraseSize = 0000, addrInc = 0001, widthProgram = 0001
559 1720829397850 GEN4_TO_CONTROLLER_LOG:GEN4_INIT_INT_LOG_ATtiny1627 DeviceInfo: mask = 0000, exists = false, startAddr = 00000000, endAddr = 00000000, rowSize = 0000, rowEraseSize = 0000, addrInc = 0000, widthProgram = 0000
559 1720829397850 GEN4_TO_CONTROLLER_LOG:GEN4_INIT_INT_LOG_ATtiny1627 DeviceInfo: mask = 00ff, exists = true, startAddr = 00001400, endAddr = 000014ff, rowSize = 0020, rowEraseSize = 0000, addrInc = 0001, widthProgram = 0001
559 1720829397850 GEN4_TO_CONTROLLER_LOG:GEN4_INIT_INT_LOG_ATtiny1627 DeviceInfo: mask = 00ff, exists = true, startAddr = 00001300, endAddr = 0000131f, rowSize = 0020, rowEraseSize = 0000, addrInc = 0001, widthProgram = 0001
559 1720829397850 GEN4_TO_CONTROLLER_LOG:GEN4_INIT_INT_LOG_ATtiny1627 DeviceInfo: mask = 0000, exists = false, startAddr = 00000000, endAddr = 00000000, rowSize = 0000, rowEraseSize = 0040, addrInc = 0000, widthProgram = 0000
559 1720829397850 GEN4_TO_CONTROLLER_LOG:GEN4_INIT_INT_LOG_ATtiny1627 DeviceInfo: mask = 0000, exists = false, startAddr = 00000000, endAddr = 00000000, rowSize = 0000, rowEraseSize = 0000, addrInc = 0001, widthProgram = 0001
559 1720829397850 GEN4_TO_CONTROLLER_LOG:GEN4_INIT_INT_LOG_ATtiny1627 DeviceInfo: mask = 0000, exists = false, startAddr = 00000000, endAddr = 00000000, rowSize = 0000, rowEraseSize = 0000, addrInc = 0000, widthProgram = 0000
559 1720829397850 GEN4_TO_CONTROLLER_LOG:GEN4_INIT_INT_LOG_ATtiny1627 DeviceInfo: mask = 0000, exists = false, startAddr = 00000000, endAddr = 00000000, rowSize = 0000, rowEraseSize = 0000, addrInc = 0000, widthProgram = 0000
559 1720829397850 GEN4_TO_CONTROLLER_LOG:GEN4_INIT_INT_LOG_ATtiny1627 DeviceInfo: mask = 0000, exists = false, startAddr = 00000000, endAddr = 00000000, rowSize = 0000, rowEraseSize = 0000, addrInc = 0000, widthProgram = 0000
559 1720829397850 GEN4_TO_CONTROLLER_LOG:GEN4_INIT_INT_LOG_ATtiny1627 DeviceInfo: mask = 0000, exists = false, startAddr = 00000000, endAddr = 00000000, rowSize = 0000, rowEraseSize = 0000, addrInc = 0000, widthProgram = 0000
559 1720829397850 GEN4_TO_CONTROLLER_LOG:GEN4_INIT_INT_LOG_ATtiny1627 DeviceInfo: mask = 0000, exists = false, startAddr = 00000000, endAddr = 00000000, rowSize = 0000, rowEraseSize = 0000, addrInc = 0001, widthProgram = 0001
559 1720829397850 GEN4_TO_CONTROLLER_LOG:GEN4_INIT_INT_LOG_ATtiny1627 DeviceInfo: mask = 0000, exists = false, startAddr = 00000000, endAddr = 00000000, rowSize = 0000, rowEraseSize = 0000, addrInc = 0000, widthProgram = 0000
559 1720829397850 GEN4_TO_CONTROLLER_LOG:GEN4_INIT_INT_LOG_ATtiny1627 DeviceInfo: mask = 0000, exists = false, startAddr = 00000000, endAddr = 00000000, rowSize = 0000, rowEraseSize = 0000, addrInc = 0000, widthProgram = 0000
559 1720829397850 GEN4_TO_CONTROLLER_LOG:GEN4_INIT_INT_LOG_ATtiny1627 DeviceInfo: mask = 0000, exists = false, startAddr = 00000000, endAddr = 00000000, rowSize = 0000, rowEraseSize = 0000, addrInc = 0000, widthProgram = 0000
559 1720829397850 GEN4_TO_CONTROLLER_LOG:GEN4_INIT_INT_LOG_ATtiny1627 DeviceInfo: mask = 0000, exists = false, startAddr = 00000000, endAddr = 00000000, rowSize = 0000, rowEraseSize = 0000, addrInc = 0000, widthProgram = 0000
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
559 1720829397850 GEN4_TO_CONTROLLER_LOG:GEN4_INIT_INT_LOG_ATtiny1627 com.microchip.mplab.libs.atmelice.implementations.ConnectInterface@1e019106
559 1720829397850 GEN4_TO_CONTROLLER_LOG:GEN4_INIT_INT_LOG_ATtiny1627 Return End

559 1720829397850 GEN4_TO_CONTROLLER_LOG:GEN4_INIT_INT_LOG_ATtiny1627 Pre:GetInterfaceProvider
559 1720829397850 GEN4_TO_CONTROLLER_LOG:GEN4_INIT_INT_LOG_ATtiny1627 Payload
559 1720829397850 GEN4_TO_CONTROLLER_LOG:GEN4_INIT_INT_LOG_ATtiny1627 RI4ControllerDiagnosticsInterface
559 1720829397850 GEN4_TO_CONTROLLER_LOG:GEN4_INIT_INT_LOG_ATtiny1627 Payload End
559 1720829397850 GEN4_TO_CONTROLLER_LOG:GEN4_INIT_INT_LOG_ATtiny1627 Post:GetInterfaceProvider
559 1720829397850 GEN4_TO_CONTROLLER_LOG:GEN4_INIT_INT_LOG_ATtiny1627 Return Value
559 1720829397851 GEN4_TO_CONTROLLER_LOG:GEN4_INIT_INT_LOG_ATtiny1627 com.microchip.mplab.libs.atmelice.implementations.UnimplementedDiagnostics@426c4870
559 1720829397851 GEN4_TO_CONTROLLER_LOG:GEN4_INIT_INT_LOG_ATtiny1627 Return End

559 1720829397851 GEN4_TO_CONTROLLER_LOG:GEN4_INIT_INT_LOG_ATtiny1627 Pre:GetInterfaceProvider
559 1720829397851 GEN4_TO_CONTROLLER_LOG:GEN4_INIT_INT_LOG_ATtiny1627 Payload
559 1720829397851 GEN4_TO_CONTROLLER_LOG:GEN4_INIT_INT_LOG_ATtiny1627 ProgrammerToGo
559 1720829397851 GEN4_TO_CONTROLLER_LOG:GEN4_INIT_INT_LOG_ATtiny1627 Payload End
559 1720829397851 GEN4_TO_CONTROLLER_LOG:GEN4_INIT_INT_LOG_ATtiny1627 Post:GetInterfaceProvider
559 1720829397851 GEN4_TO_CONTROLLER_LOG:GEN4_INIT_INT_LOG_ATtiny1627 Return Value
559 1720829397851 GEN4_TO_CONTROLLER_LOG:GEN4_INIT_INT_LOG_ATtiny1627 null
559 1720829397851 GEN4_TO_CONTROLLER_LOG:GEN4_INIT_INT_LOG_ATtiny1627 Return End

559 1720829397851 GEN4_TO_CONTROLLER_LOG:GEN4_INIT_INT_LOG_ATtiny1627 Pre:GetInterfaceProvider
559 1720829397851 GEN4_TO_CONTROLLER_LOG:GEN4_INIT_INT_LOG_ATtiny1627 Payload
559 1720829397851 GEN4_TO_CONTROLLER_LOG:GEN4_INIT_INT_LOG_ATtiny1627 Status
559 1720829397851 GEN4_TO_CONTROLLER_LOG:GEN4_INIT_INT_LOG_ATtiny1627 Payload End
559 1720829397851 GEN4_TO_CONTROLLER_LOG:GEN4_INIT_INT_LOG_ATtiny1627 Post:GetInterfaceProvider
559 1720829397851 GEN4_TO_CONTROLLER_LOG:GEN4_INIT_INT_LOG_ATtiny1627 Return Value
559 1720829397851 GEN4_TO_CONTROLLER_LOG:GEN4_INIT_INT_LOG_ATtiny1627 null
559 1720829397851 GEN4_TO_CONTROLLER_LOG:GEN4_INIT_INT_LOG_ATtiny1627 Return End

559 1720829397851 GEN4_TO_CONTROLLER_LOG:GEN4_CONNECT_INT_LOG Pre:EstablishCommunincations
559 1720829397851 GEN4_TO_CONTROLLER_LOG:GEN4_CONNECT_INT_LOG Payload
559 1720829397851 GEN4_TO_CONTROLLER_LOG:GEN4_CONNECT_INT_LOG com.microchip.mplab.mdbcore.AtmelIceScripting.AIceScriptingCom@647cf610
559 1720829397851 GEN4_TO_CONTROLLER_LOG:GEN4_CONNECT_INT_LOG Payload End
559 1720829397851 NativeController::EstablishCommunincations entry
559 1720829397851 pro JtagIce3 [0x00] <<< 00 00 00 
559 1720829397854 pro JtagIce3 [0x00] >>> 81 00 00 01 11 12 13 14 
559 1720829397854 pro JtagIce3 [0x01] <<< 10 00 
559 1720829397856 pro JtagIce3 [0x01] >>> 80 00 
559 1720829397856 pro JtagIce3 [0x00] <<< 00 00 03 
559 1720829397857 pro JtagIce3 [0x00] >>> 81 00 01 04 05 06 07 
559 1720829397857 pro JtagIce3 [0x01] <<< 02 00 01 20 02 
559 1720829397858 pro JtagIce3 [0x01] >>> 84 01 00 00 11 
559 1720829397859 NativeController::EstablishCommunincations exit
559 1720829397859 GEN4_TO_CONTROLLER_LOG:GEN4_CONNECT_INT_LOG Post:EstablishCommunincations
559 1720829397859 GEN4_TO_CONTROLLER_LOG:GEN4_CONNECT_INT_LOG Return Value
559 1720829397859 GEN4_TO_CONTROLLER_LOG:GEN4_CONNECT_INT_LOG true
559 1720829397859 GEN4_TO_CONTROLLER_LOG:GEN4_CONNECT_INT_LOG Return End

559 1720829397859 GEN4_TO_CONTROLLER_LOG:GEN4_CONNECT_INT_LOG Pre:GetFirmwareInfo
559 1720829397859 GEN4_TO_CONTROLLER_LOG:GEN4_CONNECT_INT_LOG Payload
559 1720829397859 GEN4_TO_CONTROLLER_LOG:GEN4_CONNECT_INT_LOG null
559 1720829397859 GEN4_TO_CONTROLLER_LOG:GEN4_CONNECT_INT_LOG Payload End
559 1720829397859 NativeController::GetFirmwareInfo entry
559 1720829397859 pro JtagIce3 [0x01] <<< 02 00 00 00 01 
559 1720829397860 pro JtagIce3 [0x01] >>> 84 01 00 00 
559 1720829397860 NativeController::getFirmwareVersion entry
559 1720829397860 pro JtagIce3 [0x01] <<< 02 00 00 01 01 
559 1720829397861 pro JtagIce3 [0x01] >>> 84 01 01 00 
559 1720829397861 pro JtagIce3 [0x01] <<< 02 00 00 02 01 
559 1720829397862 pro JtagIce3 [0x01] >>> 84 01 2D 00 
559 1720829397862 pro JtagIce3 [0x01] <<< 02 00 00 03 02 
559 1720829397863 pro JtagIce3 [0x01] >>> 84 01 07 00 00 
559 1720829397863 NativeController::getFirmwareVersion exit
559 1720829397863 pro JtagIce3 [0x01] <<< 02 00 00 09 01 
559 1720829397864 pro JtagIce3 [0x01] >>> 84 01 00 11 
559 1720829397864 NativeController::tryGetFPGAVersion entry
559 1720829397864 pro JtagIce3 [0x01] <<< 02 00 00 10 01 
559 1720829397866 pro JtagIce3 [0x01] >>> 84 01 00 11 
559 1720829397866 pro JtagIce3 [0x01] <<< 02 00 00 11 01 
559 1720829397867 pro JtagIce3 [0x01] >>> 84 01 00 11 
559 1720829397867 pro JtagIce3 [0x01] <<< 02 00 00 12 01 
559 1720829397878 pro JtagIce3 [0x01] >>> 84 01 00 11 
559 1720829397878 NativeController::tryGetFPGAVersion exit
559 1720829397878 NativeController::tryGetFPGAVersion exit with exception No value present
559 1720829397878 pro JtagIce3 [0x01] <<< 02 00 00 06 01 
559 1720829397879 pro JtagIce3 [0x01] >>> 84 01 05 00 
559 1720829397879 pro JtagIce3 [0x01] <<< 02 00 00 07 01 
559 1720829397881 pro JtagIce3 [0x01] >>> 84 01 05 00 
559 1720829397881 pro JtagIce3 [0x01] <<< 02 00 00 0A 01 
559 1720829397882 pro JtagIce3 [0x01] >>> 84 01 00 11 
559 1720829397882 NativeController::GetFirmwareInfo exit
559 1720829397882 GEN4_TO_CONTROLLER_LOG:GEN4_CONNECT_INT_LOG Post:GetFirmwareInfo
559 1720829397882 GEN4_TO_CONTROLLER_LOG:GEN4_CONNECT_INT_LOG Return Value
559 1720829397882 GEN4_TO_CONTROLLER_LOG:GEN4_CONNECT_INT_LOG FirmwareInfo: Values:
559 1720829397882 GEN4_TO_CONTROLLER_LOG:GEN4_CONNECT_INT_LOG FirmwareInfo: boot = false, bootVer = 5.5.0 (0x05.0x05.0x00), apVer = 1.45.7 (0x01.0x2d.0x07), fpgaVer = null, scriptVer = null, macAddress = , devID = 0, devID1 = 0, devSN0 = 0, devSN1 = 0, serialNumber = null, appCommitID = null, scriptCommitID = null, PCB_ID = 0
559 1720829397882 GEN4_TO_CONTROLLER_LOG:GEN4_CONNECT_INT_LOG Return End
559 1720829397882 GEN4_CONNECT_DIAGNOSTICS:ENTERING: com.microchip.mplab.mdbcore.RI4Tool.ConnectionHandler.CheckForFWUpdates()
559 1720829397882 GEN4_CONNECT_DIAGNOSTICS:Created FirmwareUpdateHandler com.microchip.mplab.mdbcore.AtmelIceScripting.OperationHandlers.AIceScriptingFirmwareUpdateHandler@e0704c

559 1720829397885 GEN4_TO_CONTROLLER_LOG:GEN4_CONNECT_INT_LOG Pre:SetUpdateFirmwareInfo
559 1720829397885 GEN4_TO_CONTROLLER_LOG:GEN4_CONNECT_INT_LOG Payload
559 1720829397885 GEN4_TO_CONTROLLER_LOG:GEN4_CONNECT_INT_LOG UpdateFirmwareInfo: Values:
559 1720829397885 GEN4_TO_CONTROLLER_LOG:GEN4_CONNECT_INT_LOG UpdateFirmwareInfo: license = dCejLCt9ZV4fWdqYk3htQgdNYCC2nccSTvVdTD2oCjW3gRUtjikRtla11IiYo1wq, updateId = 2147483647
559 1720829397885 GEN4_TO_CONTROLLER_LOG:GEN4_CONNECT_INT_LOG Payload End
559 1720829397885 GEN4_TO_CONTROLLER_LOG:GEN4_CONNECT_INT_LOG Post:SetUpdateFirmwareInfo
559 1720829397885 GEN4_TO_CONTROLLER_LOG:GEN4_CONNECT_INT_LOG Return Value
559 1720829397885 GEN4_TO_CONTROLLER_LOG:GEN4_CONNECT_INT_LOG none
559 1720829397885 GEN4_TO_CONTROLLER_LOG:GEN4_CONNECT_INT_LOG Return End
559 1720829397885 GEN4_CONNECT_DIAGNOSTICS:EXITING: com.microchip.mplab.mdbcore.RI4Tool.ConnectionHandler.CheckForFWUpdates()

559 1720829397885 GEN4_TO_CONTROLLER_LOG:GEN4_CONNECT_INT_LOG Pre:SetPowerInfo
559 1720829397885 GEN4_TO_CONTROLLER_LOG:GEN4_CONNECT_INT_LOG Payload
559 1720829397885 GEN4_TO_CONTROLLER_LOG:GEN4_CONNECT_INT_LOG PowerInfo: Values:
559 1720829397885 GEN4_TO_CONTROLLER_LOG:GEN4_CONNECT_INT_LOG PowerInfo: shotDownSystem = false, isToolPower = false, voltage = 5.000000, useVppFirst = false, useLowVoltageProgramming = true, useMaintainActivePower = false
559 1720829397885 GEN4_TO_CONTROLLER_LOG:GEN4_CONNECT_INT_LOG Payload End
559 1720829397885 NativeController::GetVoltageInfo entry
559 1720829397885 pro JtagIce3 [0x01] <<< 02 00 01 00 02 
559 1720829397886 pro JtagIce3 [0x01] >>> 84 01 0B 14 00 
559 1720829397886 pro JtagIce3 [0x01] <<< 02 00 01 20 02 
559 1720829397888 pro JtagIce3 [0x01] >>> 84 01 00 00 11 
559 1720829397888 NativeController::GetVoltageInfo TSUP exit with exception + The requested command is not supported. (17)
559 1720829397888 pro JtagIce3 [0x01] <<< 02 00 01 02 02 
559 1720829397889 pro JtagIce3 [0x01] >>> 84 01 00 00 11 
559 1720829397889 NativeController::GetVoltageInfo VUSB exit with exception + The requested command is not supported. (17)
559 1720829397889 NativeController::GetVoltageInfo exit
559 1720829397889 GEN4_TO_CONTROLLER_LOG:GEN4_CONNECT_INT_LOG Post:SetPowerInfo
559 1720829397889 GEN4_TO_CONTROLLER_LOG:GEN4_CONNECT_INT_LOG Return Value
559 1720829397889 GEN4_TO_CONTROLLER_LOG:GEN4_CONNECT_INT_LOG none
559 1720829397889 GEN4_TO_CONTROLLER_LOG:GEN4_CONNECT_INT_LOG Return End

559 1720829397889 GEN4_TO_CONTROLLER_LOG:GEN4_CONNECT_INT_LOG Pre:GetVoltageInfo
559 1720829397889 GEN4_TO_CONTROLLER_LOG:GEN4_CONNECT_INT_LOG Payload
559 1720829397889 GEN4_TO_CONTROLLER_LOG:GEN4_CONNECT_INT_LOG null
559 1720829397889 GEN4_TO_CONTROLLER_LOG:GEN4_CONNECT_INT_LOG Payload End
559 1720829397889 NativeController::GetVoltageInfo entry
559 1720829397889 pro JtagIce3 [0x01] <<< 02 00 01 00 02 
559 1720829397891 pro JtagIce3 [0x01] >>> 84 01 00 14 00 
559 1720829397891 pro JtagIce3 [0x01] <<< 02 00 01 20 02 
559 1720829397892 pro JtagIce3 [0x01] >>> 84 01 00 00 11 
559 1720829397893 NativeController::GetVoltageInfo TSUP exit with exception + The requested command is not supported. (17)
559 1720829397893 pro JtagIce3 [0x01] <<< 02 00 01 02 02 
559 1720829397894 pro JtagIce3 [0x01] >>> 84 01 00 00 11 
559 1720829397894 NativeController::GetVoltageInfo VUSB exit with exception + The requested command is not supported. (17)
559 1720829397894 NativeController::GetVoltageInfo exit
559 1720829397894 GEN4_TO_CONTROLLER_LOG:GEN4_CONNECT_INT_LOG Post:GetVoltageInfo
559 1720829397894 GEN4_TO_CONTROLLER_LOG:GEN4_CONNECT_INT_LOG Return Value
559 1720829397894 GEN4_TO_CONTROLLER_LOG:GEN4_CONNECT_INT_LOG VoltagesInfo: Values:
559 1720829397894 GEN4_TO_CONTROLLER_LOG:GEN4_CONNECT_INT_LOG VoltagesInfo: internalVdd = 0, internalVpp = 0, targetVdd = 0, targetVpp = -2147483648, vddSense = 5120, temp = 0, vddCurrentSense = 0, vddVoltageSense = -2147483648
559 1720829397894 GEN4_TO_CONTROLLER_LOG:GEN4_CONNECT_INT_LOG Return End

559 1720829397894 GEN4_TO_CONTROLLER_LOG:GEN4_CONNECT_INT_LOG Pre:SetLEDBrightness
559 1720829397894 GEN4_TO_CONTROLLER_LOG:GEN4_CONNECT_INT_LOG Payload
559 1720829397894 GEN4_TO_CONTROLLER_LOG:GEN4_CONNECT_INT_LOG 5
559 1720829397894 GEN4_TO_CONTROLLER_LOG:GEN4_CONNECT_INT_LOG Payload End
559 1720829397894 GEN4_TO_CONTROLLER_LOG:GEN4_CONNECT_INT_LOG Post:SetLEDBrightness
559 1720829397894 GEN4_TO_CONTROLLER_LOG:GEN4_CONNECT_INT_LOG Return Value
559 1720829397894 GEN4_TO_CONTROLLER_LOG:GEN4_CONNECT_INT_LOG none
559 1720829397894 GEN4_TO_CONTROLLER_LOG:GEN4_CONNECT_INT_LOG Return End

559 1720829397894 GEN4_TO_CONTROLLER_LOG:GEN4_CONNECT_INT_LOG Pre:SetToolInfo
559 1720829397894 GEN4_TO_CONTROLLER_LOG:GEN4_CONNECT_INT_LOG Payload
559 1720829397894 GEN4_TO_CONTROLLER_LOG:GEN4_CONNECT_INT_LOG ToolInfo: Values:
559 1720829397894 GEN4_TO_CONTROLLER_LOG:GEN4_CONNECT_INT_LOG ToolInfo: speedLevel = 1, PGCResistance = 4700, PGDResistance = 4700, PGCPullDir = PullDown, PGDPullDir = PullDown, ICSPSelected = Wire2
559 1720829397894 GEN4_TO_CONTROLLER_LOG:GEN4_CONNECT_INT_LOG Payload End
559 1720829397894 GEN4_TO_CONTROLLER_LOG:GEN4_CONNECT_INT_LOG Post:SetToolInfo
559 1720829397894 GEN4_TO_CONTROLLER_LOG:GEN4_CONNECT_INT_LOG Return Value
559 1720829397894 GEN4_TO_CONTROLLER_LOG:GEN4_CONNECT_INT_LOG none
559 1720829397894 GEN4_TO_CONTROLLER_LOG:GEN4_CONNECT_INT_LOG Return End

559 1720829397894 GEN4_TO_CONTROLLER_LOG:GEN4_CONNECT_INT_LOG Pre:GetTargetIDInfo
559 1720829397894 GEN4_TO_CONTROLLER_LOG:GEN4_CONNECT_INT_LOG Payload
559 1720829397894 GEN4_TO_CONTROLLER_LOG:GEN4_CONNECT_INT_LOG null
559 1720829397894 GEN4_TO_CONTROLLER_LOG:GEN4_CONNECT_INT_LOG Payload End
559 1720829397894 NativeController::GetTargetIDInfo entry
559 1720829397894 pro JtagIce3 [0x12] <<< 01 00 01 31 02 F4 01 
559 1720829397895 pro JtagIce3 [0x12] >>> 80 00 
559 1720829397895 pro JtagIce3 [0x12] <<< 01 00 00 00 01 05 
559 1720829397896 pro JtagIce3 [0x12] >>> 80 00 
559 1720829397896 pro JtagIce3 [0x12] <<< 01 00 00 01 01 01 
559 1720829397897 pro JtagIce3 [0x12] >>> 80 00 
559 1720829397897 pro JtagIce3 [0x12] <<< 01 00 01 00 01 08 
559 1720829397898 pro JtagIce3 [0x12] >>> 80 00 
559 1720829397898 pro JtagIce3 [0x12] <<< 01 00 02 00 30 00 80 40 20 00 10 80 0F 94 11 8C 0A 98 08 DC 05 EE 02 00 40 00 00 00 01 20 00 0A 05 FF 00 FF 00 00 14 00 13 00 11 80 12 8A 12 28 94 00 00 00 00 
559 1720829397899 pro JtagIce3 [0x12] >>> 80 00 
559 1720829397899 pro JtagIce3 [0x12] <<< 01 00 03 06 01 00 
559 1720829397900 pro JtagIce3 [0x12] >>> 80 00 
559 1720829397900 pro JtagIce3 [0x12] <<< 10 00 00 
559 1720829398028 pro JtagIce3 [0x12] >>> A0 00 19 
559 1720829398028 NativeController::GetTargetIDInfo exit with exception PDI physical timed out. (25)
