RichardSefton/AUV/MidtermPrototypeCode/Motor_Module_Test.X/queuelogs/debugtool.txt

576 1718416530967 GEN4_CONNECT_DIAGNOSTICS:MPLABCommTool is null

576 1718416530967 GEN4_TO_CONTROLLER_LOG:GEN4_CONNECT_INT_LOG Pre:GetFirmwareInfo
576 1718416530967 GEN4_TO_CONTROLLER_LOG:GEN4_CONNECT_INT_LOG Payload
576 1718416530967 GEN4_TO_CONTROLLER_LOG:GEN4_CONNECT_INT_LOG null
576 1718416530967 GEN4_TO_CONTROLLER_LOG:GEN4_CONNECT_INT_LOG Payload End
576 1718416530967 NativeController::GetFirmwareInfo entry
576 1718416530967 pro JtagIce3 [0x01] <<< 02 00 00 00 01 
576 1718416530969 pro JtagIce3 [0x01] >>> 84 01 00 00 
576 1718416530969 NativeController::getFirmwareVersion entry
576 1718416530969 pro JtagIce3 [0x01] <<< 02 00 00 01 01 
576 1718416530970 pro JtagIce3 [0x01] >>> 84 01 01 00 
576 1718416530970 pro JtagIce3 [0x01] <<< 02 00 00 02 01 
576 1718416530972 pro JtagIce3 [0x01] >>> 84 01 2D 00 
576 1718416530972 pro JtagIce3 [0x01] <<< 02 00 00 03 02 
576 1718416530973 pro JtagIce3 [0x01] >>> 84 01 07 00 00 
576 1718416530973 NativeController::getFirmwareVersion exit
576 1718416530973 pro JtagIce3 [0x01] <<< 02 00 00 09 01 
576 1718416530974 pro JtagIce3 [0x01] >>> 84 01 00 11 
576 1718416530974 NativeController::tryGetFPGAVersion entry
576 1718416530974 pro JtagIce3 [0x01] <<< 02 00 00 10 01 
576 1718416530975 pro JtagIce3 [0x01] >>> 84 01 00 11 
576 1718416530975 pro JtagIce3 [0x01] <<< 02 00 00 11 01 
576 1718416530976 pro JtagIce3 [0x01] >>> 84 01 00 11 
576 1718416530976 pro JtagIce3 [0x01] <<< 02 00 00 12 01 
576 1718416530977 pro JtagIce3 [0x01] >>> 84 01 00 11 
576 1718416530977 NativeController::tryGetFPGAVersion exit
576 1718416530977 NativeController::tryGetFPGAVersion exit with exception No value present
576 1718416530977 pro JtagIce3 [0x01] <<< 02 00 00 06 01 
576 1718416530979 pro JtagIce3 [0x01] >>> 84 01 05 00 
576 1718416530979 pro JtagIce3 [0x01] <<< 02 00 00 07 01 
576 1718416530980 pro JtagIce3 [0x01] >>> 84 01 05 00 
576 1718416530980 pro JtagIce3 [0x01] <<< 02 00 00 0A 01 
576 1718416530981 pro JtagIce3 [0x01] >>> 84 01 00 11 
576 1718416530981 NativeController::GetFirmwareInfo exit
576 1718416530981 GEN4_TO_CONTROLLER_LOG:GEN4_CONNECT_INT_LOG Post:GetFirmwareInfo
576 1718416530981 GEN4_TO_CONTROLLER_LOG:GEN4_CONNECT_INT_LOG Return Value
576 1718416530981 GEN4_TO_CONTROLLER_LOG:GEN4_CONNECT_INT_LOG FirmwareInfo: Values:
576 1718416530981 GEN4_TO_CONTROLLER_LOG:GEN4_CONNECT_INT_LOG FirmwareInfo: boot = false, bootVer = 5.5.0 (0x05.0x05.0x00), apVer = 1.45.7 (0x01.0x2d.0x07), fpgaVer = null, scriptVer = null, macAddress = , devID = 0, devID1 = 0, devSN0 = 0, devSN1 = 0, serialNumber = null, appCommitID = null, scriptCommitID = null, PCB_ID = 0
576 1718416530981 GEN4_TO_CONTROLLER_LOG:GEN4_CONNECT_INT_LOG Return End

576 1718416530981 GEN4_TO_CONTROLLER_LOG:GEN4_CONNECT_INT_LOG Pre:SetPowerInfo
576 1718416530981 GEN4_TO_CONTROLLER_LOG:GEN4_CONNECT_INT_LOG Payload
576 1718416530981 GEN4_TO_CONTROLLER_LOG:GEN4_CONNECT_INT_LOG PowerInfo: Values:
576 1718416530981 GEN4_TO_CONTROLLER_LOG:GEN4_CONNECT_INT_LOG PowerInfo: shotDownSystem = true, isToolPower = false, voltage = 0.000000, useVppFirst = false, useLowVoltageProgramming = true, useMaintainActivePower = false
576 1718416530981 GEN4_TO_CONTROLLER_LOG:GEN4_CONNECT_INT_LOG Payload End
576 1718416530981 NativeController::GetVoltageInfo entry
576 1718416530981 pro JtagIce3 [0x01] <<< 02 00 01 00 02 
576 1718416530982 pro JtagIce3 [0x01] >>> 84 01 7E 12 00 
576 1718416530982 pro JtagIce3 [0x01] <<< 02 00 01 20 02 
576 1718416530983 pro JtagIce3 [0x01] >>> 84 01 00 00 11 
576 1718416530983 NativeController::GetVoltageInfo TSUP exit with exception + The requested command is not supported. (17)
576 1718416530983 pro JtagIce3 [0x01] <<< 02 00 01 02 02 
576 1718416530984 pro JtagIce3 [0x01] >>> 84 01 00 00 11 
576 1718416530984 NativeController::GetVoltageInfo VUSB exit with exception + The requested command is not supported. (17)
576 1718416530984 NativeController::GetVoltageInfo exit
576 1718416530984 GEN4_TO_CONTROLLER_LOG:GEN4_CONNECT_INT_LOG Post:SetPowerInfo
576 1718416530984 GEN4_TO_CONTROLLER_LOG:GEN4_CONNECT_INT_LOG Return Value
576 1718416530984 GEN4_TO_CONTROLLER_LOG:GEN4_CONNECT_INT_LOG none
576 1718416530984 GEN4_TO_CONTROLLER_LOG:GEN4_CONNECT_INT_LOG Return End

576 1718416530984 GEN4_TO_CONTROLLER_LOG:GEN4_CONNECT_INT_LOG Pre:Disconnect
576 1718416530984 GEN4_TO_CONTROLLER_LOG:GEN4_CONNECT_INT_LOG Payload
576 1718416530984 GEN4_TO_CONTROLLER_LOG:GEN4_CONNECT_INT_LOG Payload End
576 1718416530984 NativeController::Disconnect entry
576 1718416530984 pro JtagIce3 [0x01] <<< 11 00 00 
576 1718416530985 pro JtagIce3 [0x01] >>> 80 00 
576 1718416530985 NativeController::Disconnect exit
576 1718416530985 GEN4_TO_CONTROLLER_LOG:GEN4_CONNECT_INT_LOG Post:Disconnect
576 1718416530985 GEN4_TO_CONTROLLER_LOG:GEN4_CONNECT_INT_LOG Return Value
576 1718416530985 GEN4_TO_CONTROLLER_LOG:GEN4_CONNECT_INT_LOG none
576 1718416530985 GEN4_TO_CONTROLLER_LOG:GEN4_CONNECT_INT_LOG Return End
576 1718416530986 GEN4_CONNECT_DIAGNOSTICS:Removing plug and play observer com.microchip.mplab.mdbcore.RI4Tool.RI4ToolBase$RI4PlugNPlayObserver@2f5a0d74
576 1718416530986 GEN4_CONNECT_DIAGNOSTICS:Begin PlugNPlayObservers list dump:
576 1718416530986 GEN4_CONNECT_DIAGNOSTICS:End PlugNPlayObservers list dump:
576 1718416531086 GEN4_CONNECT_DIAGNOSTICS:Calling RIDbgToolCom.Disconnect
576 1718416531086 GEN4_CONNECT_DIAGNOSTICS:Calling MPLABCommTool.Detach to remove tool from plug and play list
576 1718416531086 GEN4_CONNECT_DIAGNOSTICS:Calling RIDbgToolCom.DisconnectFromMPlabComm
576 1718416531086 GEN4_CONNECT_DIAGNOSTICS:Calling MPLABCommTool.Disconnect
588 1718416535701 GEN4_CONNECT_DIAGNOSTICS:MPLABCommTool is NOT null
588 1718416535701 GEN4_CONNECT_DIAGNOSTICS:AttachedToolPID = 2141, AttachedToolVID = 3eb
588 1718416535701 GEN4_CONNECT_DIAGNOSTICS:transport type = USB
588 1718416535701 GEN4_CONNECT_DIAGNOSTICS:AttachedToolPID = 2141, AttachedToolVID = 3eb
588 1718416535702 com.microchip.mplab.mdbcore.RealICETool.RIDbgToolCom
588 1718416535702 GEN4_CONNECT_DIAGNOSTICS:Before MPLABCommTool.Connect()
588 1718416535702 GEN4_CONNECT_DIAGNOSTICS:After MPLABCommTool.Connect()
588 1718416535702 GEN4_CONNECT_DIAGNOSTICS:MPLABCommTool.Connect() returned MPLABCOMM_NO_ERROR
588 1718416535702 GEN4_CONNECT_DIAGNOSTICS:Attaching to MPLABCommTool plugnplay
588 1718416535702 GEN4_CONNECT_DIAGNOSTICS:Adding new plug and play observer com.microchip.mplab.mdbcore.RI4Tool.RI4ToolBase$RI4PlugNPlayObserver@582e1273
588 1718416535702 GEN4_CONNECT_DIAGNOSTICS:Begin PlugNPlayObservers list dump:
588 1718416535702 GEN4_CONNECT_DIAGNOSTICS:com.microchip.mplab.mdbcore.RI4Tool.RI4ToolBase$RI4PlugNPlayObserver@582e1273
588 1718416535702 GEN4_CONNECT_DIAGNOSTICS:End PlugNPlayObservers list dump:
588 1718416535703 GEN4_CONNECT_DIAGNOSTICS:Registering for alternate PNP notifications. CommPnPCriteria.cPIDList = [2177, 2179, 217a, 2142, 2142], CommPnPCriteria.cSerialNumber = j42700073141

588 1718416535717 GEN4_TO_CONTROLLER_LOG:GEN4_INIT_INT_LOG_ATtiny1627 Pre:init
588 1718416535717 GEN4_TO_CONTROLLER_LOG:GEN4_INIT_INT_LOG_ATtiny1627 Payload
588 1718416535717 GEN4_TO_CONTROLLER_LOG:GEN4_INIT_INT_LOG_ATtiny1627 DeviceInfo: Values:
588 1718416535717 GEN4_TO_CONTROLLER_LOG:GEN4_INIT_INT_LOG_ATtiny1627 DeviceInfo: pcAddress = 7fffffffffffffff, Vpp = 5.00, useRowEraseIfVoltageIsLow = false, voltageBelowWhichUseRowErase = 0.00, deviceName = ATtiny1627, programmerType = 
588 1718416535717 GEN4_TO_CONTROLLER_LOG:GEN4_INIT_INT_LOG_ATtiny1627 DeviceInfo: MemInfo values:
588 1718416535717 GEN4_TO_CONTROLLER_LOG:GEN4_INIT_INT_LOG_ATtiny1627 DeviceInfo: mask = ffff, exists = true, startAddr = 00000000, endAddr = 00003fff, rowSize = 0040, rowEraseSize = 0040, addrInc = 0001, widthProgram = 0001
588 1718416535717 GEN4_TO_CONTROLLER_LOG:GEN4_INIT_INT_LOG_ATtiny1627 DeviceInfo: mask = 00ff, exists = true, startAddr = 00821280, endAddr = 0083128a, rowSize = 0001, rowEraseSize = 0000, addrInc = 0001, widthProgram = 0001
588 1718416535717 GEN4_TO_CONTROLLER_LOG:GEN4_INIT_INT_LOG_ATtiny1627 DeviceInfo: mask = 0000, exists = false, startAddr = 00000000, endAddr = 00000000, rowSize = 0000, rowEraseSize = 0000, addrInc = 0000, widthProgram = 0000
588 1718416535717 GEN4_TO_CONTROLLER_LOG:GEN4_INIT_INT_LOG_ATtiny1627 DeviceInfo: mask = 00ff, exists = true, startAddr = 00001400, endAddr = 000014ff, rowSize = 0020, rowEraseSize = 0000, addrInc = 0001, widthProgram = 0001
588 1718416535717 GEN4_TO_CONTROLLER_LOG:GEN4_INIT_INT_LOG_ATtiny1627 DeviceInfo: mask = 00ff, exists = true, startAddr = 00001300, endAddr = 0000131f, rowSize = 0020, rowEraseSize = 0000, addrInc = 0001, widthProgram = 0001
588 1718416535717 GEN4_TO_CONTROLLER_LOG:GEN4_INIT_INT_LOG_ATtiny1627 DeviceInfo: mask = 0000, exists = false, startAddr = 00000000, endAddr = 00000000, rowSize = 0000, rowEraseSize = 0040, addrInc = 0000, widthProgram = 0000
588 1718416535717 GEN4_TO_CONTROLLER_LOG:GEN4_INIT_INT_LOG_ATtiny1627 DeviceInfo: mask = 0000, exists = false, startAddr = 00000000, endAddr = 00000000, rowSize = 0000, rowEraseSize = 0000, addrInc = 0001, widthProgram = 0001
588 1718416535717 GEN4_TO_CONTROLLER_LOG:GEN4_INIT_INT_LOG_ATtiny1627 DeviceInfo: mask = 0000, exists = false, startAddr = 00000000, endAddr = 00000000, rowSize = 0000, rowEraseSize = 0000, addrInc = 0000, widthProgram = 0000
588 1718416535717 GEN4_TO_CONTROLLER_LOG:GEN4_INIT_INT_LOG_ATtiny1627 DeviceInfo: mask = 0000, exists = false, startAddr = 00000000, endAddr = 00000000, rowSize = 0000, rowEraseSize = 0000, addrInc = 0000, widthProgram = 0000
588 1718416535717 GEN4_TO_CONTROLLER_LOG:GEN4_INIT_INT_LOG_ATtiny1627 DeviceInfo: mask = 0000, exists = false, startAddr = 00000000, endAddr = 00000000, rowSize = 0000, rowEraseSize = 0000, addrInc = 0000, widthProgram = 0000
588 1718416535717 GEN4_TO_CONTROLLER_LOG:GEN4_INIT_INT_LOG_ATtiny1627 DeviceInfo: mask = 0000, exists = false, startAddr = 00000000, endAddr = 00000000, rowSize = 0000, rowEraseSize = 0000, addrInc = 0000, widthProgram = 0000
588 1718416535717 GEN4_TO_CONTROLLER_LOG:GEN4_INIT_INT_LOG_ATtiny1627 DeviceInfo: mask = 0000, exists = false, startAddr = 00000000, endAddr = 00000000, rowSize = 0000, rowEraseSize = 0000, addrInc = 0001, widthProgram = 0001
588 1718416535717 GEN4_TO_CONTROLLER_LOG:GEN4_INIT_INT_LOG_ATtiny1627 DeviceInfo: mask = 0000, exists = false, startAddr = 00000000, endAddr = 00000000, rowSize = 0000, rowEraseSize = 0000, addrInc = 0000, widthProgram = 0000
588 1718416535717 GEN4_TO_CONTROLLER_LOG:GEN4_INIT_INT_LOG_ATtiny1627 DeviceInfo: mask = 0000, exists = false, startAddr = 00000000, endAddr = 00000000, rowSize = 0000, rowEraseSize = 0000, addrInc = 0000, widthProgram = 0000
588 1718416535717 GEN4_TO_CONTROLLER_LOG:GEN4_INIT_INT_LOG_ATtiny1627 DeviceInfo: mask = 0000, exists = false, startAddr = 00000000, endAddr = 00000000, rowSize = 0000, rowEraseSize = 0000, addrInc = 0000, widthProgram = 0000
588 1718416535717 GEN4_TO_CONTROLLER_LOG:GEN4_INIT_INT_LOG_ATtiny1627 DeviceInfo: mask = 0000, exists = false, startAddr = 00000000, endAddr = 00000000, rowSize = 0000, rowEraseSize = 0000, addrInc = 0000, widthProgram = 0000
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
588 1718416535718 GEN4_TO_CONTROLLER_LOG:GEN4_INIT_INT_LOG_ATtiny1627 com.microchip.mplab.libs.atmelice.implementations.ConnectInterface@1e413b6a
588 1718416535718 GEN4_TO_CONTROLLER_LOG:GEN4_INIT_INT_LOG_ATtiny1627 Return End

588 1718416535718 GEN4_TO_CONTROLLER_LOG:GEN4_INIT_INT_LOG_ATtiny1627 Pre:GetInterfaceProvider
588 1718416535718 GEN4_TO_CONTROLLER_LOG:GEN4_INIT_INT_LOG_ATtiny1627 Payload
588 1718416535718 GEN4_TO_CONTROLLER_LOG:GEN4_INIT_INT_LOG_ATtiny1627 RI4ControllerDiagnosticsInterface
588 1718416535718 GEN4_TO_CONTROLLER_LOG:GEN4_INIT_INT_LOG_ATtiny1627 Payload End
588 1718416535718 GEN4_TO_CONTROLLER_LOG:GEN4_INIT_INT_LOG_ATtiny1627 Post:GetInterfaceProvider
588 1718416535718 GEN4_TO_CONTROLLER_LOG:GEN4_INIT_INT_LOG_ATtiny1627 Return Value
588 1718416535718 GEN4_TO_CONTROLLER_LOG:GEN4_INIT_INT_LOG_ATtiny1627 com.microchip.mplab.libs.atmelice.implementations.UnimplementedDiagnostics@279023fa
588 1718416535718 GEN4_TO_CONTROLLER_LOG:GEN4_INIT_INT_LOG_ATtiny1627 Return End

588 1718416535718 GEN4_TO_CONTROLLER_LOG:GEN4_INIT_INT_LOG_ATtiny1627 Pre:GetInterfaceProvider
588 1718416535718 GEN4_TO_CONTROLLER_LOG:GEN4_INIT_INT_LOG_ATtiny1627 Payload
588 1718416535718 GEN4_TO_CONTROLLER_LOG:GEN4_INIT_INT_LOG_ATtiny1627 ProgrammerToGo
588 1718416535718 GEN4_TO_CONTROLLER_LOG:GEN4_INIT_INT_LOG_ATtiny1627 Payload End
588 1718416535718 GEN4_TO_CONTROLLER_LOG:GEN4_INIT_INT_LOG_ATtiny1627 Post:GetInterfaceProvider
588 1718416535718 GEN4_TO_CONTROLLER_LOG:GEN4_INIT_INT_LOG_ATtiny1627 Return Value
588 1718416535718 GEN4_TO_CONTROLLER_LOG:GEN4_INIT_INT_LOG_ATtiny1627 null
588 1718416535718 GEN4_TO_CONTROLLER_LOG:GEN4_INIT_INT_LOG_ATtiny1627 Return End

588 1718416535718 GEN4_TO_CONTROLLER_LOG:GEN4_INIT_INT_LOG_ATtiny1627 Pre:GetInterfaceProvider
588 1718416535718 GEN4_TO_CONTROLLER_LOG:GEN4_INIT_INT_LOG_ATtiny1627 Payload
588 1718416535718 GEN4_TO_CONTROLLER_LOG:GEN4_INIT_INT_LOG_ATtiny1627 Status
588 1718416535718 GEN4_TO_CONTROLLER_LOG:GEN4_INIT_INT_LOG_ATtiny1627 Payload End
588 1718416535718 GEN4_TO_CONTROLLER_LOG:GEN4_INIT_INT_LOG_ATtiny1627 Post:GetInterfaceProvider
588 1718416535718 GEN4_TO_CONTROLLER_LOG:GEN4_INIT_INT_LOG_ATtiny1627 Return Value
588 1718416535718 GEN4_TO_CONTROLLER_LOG:GEN4_INIT_INT_LOG_ATtiny1627 null
588 1718416535718 GEN4_TO_CONTROLLER_LOG:GEN4_INIT_INT_LOG_ATtiny1627 Return End

588 1718416535718 GEN4_TO_CONTROLLER_LOG:GEN4_CONNECT_INT_LOG Pre:EstablishCommunincations
588 1718416535718 GEN4_TO_CONTROLLER_LOG:GEN4_CONNECT_INT_LOG Payload
588 1718416535718 GEN4_TO_CONTROLLER_LOG:GEN4_CONNECT_INT_LOG com.microchip.mplab.mdbcore.AtmelIceScripting.AIceScriptingCom@7b05a1dc
588 1718416535718 GEN4_TO_CONTROLLER_LOG:GEN4_CONNECT_INT_LOG Payload End
588 1718416535718 NativeController::EstablishCommunincations entry
588 1718416535718 pro JtagIce3 [0x00] <<< 00 00 00 
588 1718416535721 pro JtagIce3 [0x00] >>> 81 00 00 01 11 12 13 14 
588 1718416535721 pro JtagIce3 [0x01] <<< 10 00 
588 1718416535723 pro JtagIce3 [0x01] >>> 80 00 
588 1718416535723 pro JtagIce3 [0x00] <<< 00 00 03 
588 1718416535724 pro JtagIce3 [0x00] >>> 81 00 01 04 05 06 07 
588 1718416535724 pro JtagIce3 [0x01] <<< 02 00 01 20 02 
588 1718416535726 pro JtagIce3 [0x01] >>> 84 01 00 00 11 
588 1718416535726 NativeController::EstablishCommunincations exit
588 1718416535726 GEN4_TO_CONTROLLER_LOG:GEN4_CONNECT_INT_LOG Post:EstablishCommunincations
588 1718416535726 GEN4_TO_CONTROLLER_LOG:GEN4_CONNECT_INT_LOG Return Value
588 1718416535726 GEN4_TO_CONTROLLER_LOG:GEN4_CONNECT_INT_LOG true
588 1718416535726 GEN4_TO_CONTROLLER_LOG:GEN4_CONNECT_INT_LOG Return End

588 1718416535726 GEN4_TO_CONTROLLER_LOG:GEN4_CONNECT_INT_LOG Pre:GetFirmwareInfo
588 1718416535726 GEN4_TO_CONTROLLER_LOG:GEN4_CONNECT_INT_LOG Payload
588 1718416535726 GEN4_TO_CONTROLLER_LOG:GEN4_CONNECT_INT_LOG null
588 1718416535726 GEN4_TO_CONTROLLER_LOG:GEN4_CONNECT_INT_LOG Payload End
588 1718416535726 NativeController::GetFirmwareInfo entry
588 1718416535726 pro JtagIce3 [0x01] <<< 02 00 00 00 01 
588 1718416535727 pro JtagIce3 [0x01] >>> 84 01 00 00 
588 1718416535727 NativeController::getFirmwareVersion entry
588 1718416535727 pro JtagIce3 [0x01] <<< 02 00 00 01 01 
588 1718416535728 pro JtagIce3 [0x01] >>> 84 01 01 00 
588 1718416535728 pro JtagIce3 [0x01] <<< 02 00 00 02 01 
588 1718416535730 pro JtagIce3 [0x01] >>> 84 01 2D 00 
588 1718416535730 pro JtagIce3 [0x01] <<< 02 00 00 03 02 
588 1718416535732 pro JtagIce3 [0x01] >>> 84 01 07 00 00 
588 1718416535732 NativeController::getFirmwareVersion exit
588 1718416535732 pro JtagIce3 [0x01] <<< 02 00 00 09 01 
588 1718416535733 pro JtagIce3 [0x01] >>> 84 01 00 11 
588 1718416535733 NativeController::tryGetFPGAVersion entry
588 1718416535733 pro JtagIce3 [0x01] <<< 02 00 00 10 01 
588 1718416535734 pro JtagIce3 [0x01] >>> 84 01 00 11 
588 1718416535734 pro JtagIce3 [0x01] <<< 02 00 00 11 01 
588 1718416535735 pro JtagIce3 [0x01] >>> 84 01 00 11 
588 1718416535735 pro JtagIce3 [0x01] <<< 02 00 00 12 01 
588 1718416535736 pro JtagIce3 [0x01] >>> 84 01 00 11 
588 1718416535736 NativeController::tryGetFPGAVersion exit
588 1718416535736 NativeController::tryGetFPGAVersion exit with exception No value present
588 1718416535736 pro JtagIce3 [0x01] <<< 02 00 00 06 01 
588 1718416535737 pro JtagIce3 [0x01] >>> 84 01 05 00 
588 1718416535737 pro JtagIce3 [0x01] <<< 02 00 00 07 01 
588 1718416535738 pro JtagIce3 [0x01] >>> 84 01 05 00 
588 1718416535738 pro JtagIce3 [0x01] <<< 02 00 00 0A 01 
588 1718416535739 pro JtagIce3 [0x01] >>> 84 01 00 11 
588 1718416535739 NativeController::GetFirmwareInfo exit
588 1718416535739 GEN4_TO_CONTROLLER_LOG:GEN4_CONNECT_INT_LOG Post:GetFirmwareInfo
588 1718416535739 GEN4_TO_CONTROLLER_LOG:GEN4_CONNECT_INT_LOG Return Value
588 1718416535739 GEN4_TO_CONTROLLER_LOG:GEN4_CONNECT_INT_LOG FirmwareInfo: Values:
588 1718416535739 GEN4_TO_CONTROLLER_LOG:GEN4_CONNECT_INT_LOG FirmwareInfo: boot = false, bootVer = 5.5.0 (0x05.0x05.0x00), apVer = 1.45.7 (0x01.0x2d.0x07), fpgaVer = null, scriptVer = null, macAddress = , devID = 0, devID1 = 0, devSN0 = 0, devSN1 = 0, serialNumber = null, appCommitID = null, scriptCommitID = null, PCB_ID = 0
588 1718416535739 GEN4_TO_CONTROLLER_LOG:GEN4_CONNECT_INT_LOG Return End
588 1718416535740 GEN4_CONNECT_DIAGNOSTICS:ENTERING: com.microchip.mplab.mdbcore.RI4Tool.ConnectionHandler.CheckForFWUpdates()
588 1718416535740 GEN4_CONNECT_DIAGNOSTICS:Created FirmwareUpdateHandler com.microchip.mplab.mdbcore.AtmelIceScripting.OperationHandlers.AIceScriptingFirmwareUpdateHandler@26cfe71e

588 1718416535741 GEN4_TO_CONTROLLER_LOG:GEN4_CONNECT_INT_LOG Pre:SetUpdateFirmwareInfo
588 1718416535741 GEN4_TO_CONTROLLER_LOG:GEN4_CONNECT_INT_LOG Payload
588 1718416535741 GEN4_TO_CONTROLLER_LOG:GEN4_CONNECT_INT_LOG UpdateFirmwareInfo: Values:
588 1718416535741 GEN4_TO_CONTROLLER_LOG:GEN4_CONNECT_INT_LOG UpdateFirmwareInfo: license = dCejLCt9ZV4fWdqYk3htQgdNYCC2nccSTvVdTD2oCjW3gRUtjikRtla11IiYo1wq, updateId = 2147483647
588 1718416535741 GEN4_TO_CONTROLLER_LOG:GEN4_CONNECT_INT_LOG Payload End
588 1718416535741 GEN4_TO_CONTROLLER_LOG:GEN4_CONNECT_INT_LOG Post:SetUpdateFirmwareInfo
588 1718416535741 GEN4_TO_CONTROLLER_LOG:GEN4_CONNECT_INT_LOG Return Value
588 1718416535741 GEN4_TO_CONTROLLER_LOG:GEN4_CONNECT_INT_LOG none
588 1718416535741 GEN4_TO_CONTROLLER_LOG:GEN4_CONNECT_INT_LOG Return End
588 1718416535741 GEN4_CONNECT_DIAGNOSTICS:EXITING: com.microchip.mplab.mdbcore.RI4Tool.ConnectionHandler.CheckForFWUpdates()

588 1718416535741 GEN4_TO_CONTROLLER_LOG:GEN4_CONNECT_INT_LOG Pre:SetPowerInfo
588 1718416535741 GEN4_TO_CONTROLLER_LOG:GEN4_CONNECT_INT_LOG Payload
588 1718416535741 GEN4_TO_CONTROLLER_LOG:GEN4_CONNECT_INT_LOG PowerInfo: Values:
588 1718416535741 GEN4_TO_CONTROLLER_LOG:GEN4_CONNECT_INT_LOG PowerInfo: shotDownSystem = false, isToolPower = false, voltage = 5.000000, useVppFirst = false, useLowVoltageProgramming = true, useMaintainActivePower = false
588 1718416535741 GEN4_TO_CONTROLLER_LOG:GEN4_CONNECT_INT_LOG Payload End
588 1718416535741 NativeController::GetVoltageInfo entry
588 1718416535741 pro JtagIce3 [0x01] <<< 02 00 01 00 02 
588 1718416535743 pro JtagIce3 [0x01] >>> 84 01 82 12 00 
588 1718416535743 pro JtagIce3 [0x01] <<< 02 00 01 20 02 
588 1718416535744 pro JtagIce3 [0x01] >>> 84 01 00 00 11 
588 1718416535744 NativeController::GetVoltageInfo TSUP exit with exception + The requested command is not supported. (17)
588 1718416535744 pro JtagIce3 [0x01] <<< 02 00 01 02 02 
588 1718416535745 pro JtagIce3 [0x01] >>> 84 01 00 00 11 
588 1718416535745 NativeController::GetVoltageInfo VUSB exit with exception + The requested command is not supported. (17)
588 1718416535745 NativeController::GetVoltageInfo exit
588 1718416535745 GEN4_TO_CONTROLLER_LOG:GEN4_CONNECT_INT_LOG Post:SetPowerInfo
588 1718416535745 GEN4_TO_CONTROLLER_LOG:GEN4_CONNECT_INT_LOG Return Value
588 1718416535745 GEN4_TO_CONTROLLER_LOG:GEN4_CONNECT_INT_LOG none
588 1718416535745 GEN4_TO_CONTROLLER_LOG:GEN4_CONNECT_INT_LOG Return End

588 1718416535745 GEN4_TO_CONTROLLER_LOG:GEN4_CONNECT_INT_LOG Pre:GetVoltageInfo
588 1718416535745 GEN4_TO_CONTROLLER_LOG:GEN4_CONNECT_INT_LOG Payload
588 1718416535745 GEN4_TO_CONTROLLER_LOG:GEN4_CONNECT_INT_LOG null
588 1718416535745 GEN4_TO_CONTROLLER_LOG:GEN4_CONNECT_INT_LOG Payload End
588 1718416535745 NativeController::GetVoltageInfo entry
588 1718416535745 pro JtagIce3 [0x01] <<< 02 00 01 00 02 
588 1718416535746 pro JtagIce3 [0x01] >>> 84 01 84 12 00 
588 1718416535746 pro JtagIce3 [0x01] <<< 02 00 01 20 02 
588 1718416535747 pro JtagIce3 [0x01] >>> 84 01 00 00 11 
588 1718416535747 NativeController::GetVoltageInfo TSUP exit with exception + The requested command is not supported. (17)
588 1718416535747 pro JtagIce3 [0x01] <<< 02 00 01 02 02 
588 1718416535748 pro JtagIce3 [0x01] >>> 84 01 00 00 11 
588 1718416535748 NativeController::GetVoltageInfo VUSB exit with exception + The requested command is not supported. (17)
588 1718416535748 NativeController::GetVoltageInfo exit
588 1718416535748 GEN4_TO_CONTROLLER_LOG:GEN4_CONNECT_INT_LOG Post:GetVoltageInfo
588 1718416535748 GEN4_TO_CONTROLLER_LOG:GEN4_CONNECT_INT_LOG Return Value
588 1718416535748 GEN4_TO_CONTROLLER_LOG:GEN4_CONNECT_INT_LOG VoltagesInfo: Values:
588 1718416535748 GEN4_TO_CONTROLLER_LOG:GEN4_CONNECT_INT_LOG VoltagesInfo: internalVdd = 0, internalVpp = 0, targetVdd = 0, targetVpp = -2147483648, vddSense = 4740, temp = 0, vddCurrentSense = 0, vddVoltageSense = -2147483648
588 1718416535748 GEN4_TO_CONTROLLER_LOG:GEN4_CONNECT_INT_LOG Return End

588 1718416535748 GEN4_TO_CONTROLLER_LOG:GEN4_CONNECT_INT_LOG Pre:SetLEDBrightness
588 1718416535748 GEN4_TO_CONTROLLER_LOG:GEN4_CONNECT_INT_LOG Payload
588 1718416535748 GEN4_TO_CONTROLLER_LOG:GEN4_CONNECT_INT_LOG 5
588 1718416535748 GEN4_TO_CONTROLLER_LOG:GEN4_CONNECT_INT_LOG Payload End
588 1718416535748 GEN4_TO_CONTROLLER_LOG:GEN4_CONNECT_INT_LOG Post:SetLEDBrightness
588 1718416535748 GEN4_TO_CONTROLLER_LOG:GEN4_CONNECT_INT_LOG Return Value
588 1718416535748 GEN4_TO_CONTROLLER_LOG:GEN4_CONNECT_INT_LOG none
588 1718416535748 GEN4_TO_CONTROLLER_LOG:GEN4_CONNECT_INT_LOG Return End

588 1718416535748 GEN4_TO_CONTROLLER_LOG:GEN4_CONNECT_INT_LOG Pre:SetToolInfo
588 1718416535748 GEN4_TO_CONTROLLER_LOG:GEN4_CONNECT_INT_LOG Payload
588 1718416535748 GEN4_TO_CONTROLLER_LOG:GEN4_CONNECT_INT_LOG ToolInfo: Values:
588 1718416535748 GEN4_TO_CONTROLLER_LOG:GEN4_CONNECT_INT_LOG ToolInfo: speedLevel = 1, PGCResistance = 4700, PGDResistance = 4700, PGCPullDir = PullDown, PGDPullDir = PullDown, ICSPSelected = Wire2
588 1718416535748 GEN4_TO_CONTROLLER_LOG:GEN4_CONNECT_INT_LOG Payload End
588 1718416535748 GEN4_TO_CONTROLLER_LOG:GEN4_CONNECT_INT_LOG Post:SetToolInfo
588 1718416535748 GEN4_TO_CONTROLLER_LOG:GEN4_CONNECT_INT_LOG Return Value
588 1718416535748 GEN4_TO_CONTROLLER_LOG:GEN4_CONNECT_INT_LOG none
588 1718416535748 GEN4_TO_CONTROLLER_LOG:GEN4_CONNECT_INT_LOG Return End

588 1718416535748 GEN4_TO_CONTROLLER_LOG:GEN4_CONNECT_INT_LOG Pre:GetTargetIDInfo
588 1718416535748 GEN4_TO_CONTROLLER_LOG:GEN4_CONNECT_INT_LOG Payload
588 1718416535748 GEN4_TO_CONTROLLER_LOG:GEN4_CONNECT_INT_LOG null
588 1718416535748 GEN4_TO_CONTROLLER_LOG:GEN4_CONNECT_INT_LOG Payload End
588 1718416535748 NativeController::GetTargetIDInfo entry
588 1718416535748 pro JtagIce3 [0x12] <<< 01 00 01 31 02 F4 01 
588 1718416535749 pro JtagIce3 [0x12] >>> 80 00 
588 1718416535749 pro JtagIce3 [0x12] <<< 01 00 00 00 01 05 
588 1718416535750 pro JtagIce3 [0x12] >>> 80 00 
588 1718416535750 pro JtagIce3 [0x12] <<< 01 00 00 01 01 01 
588 1718416535751 pro JtagIce3 [0x12] >>> 80 00 
588 1718416535751 pro JtagIce3 [0x12] <<< 01 00 01 00 01 08 
588 1718416535752 pro JtagIce3 [0x12] >>> 80 00 
588 1718416535752 pro JtagIce3 [0x12] <<< 01 00 02 00 30 00 80 40 20 00 10 80 0F 94 11 8C 0A 98 08 DC 05 EE 02 00 40 00 00 00 01 20 00 0A 05 FF 00 FF 00 00 14 00 13 00 11 80 12 8A 12 28 94 00 00 00 00 
588 1718416535753 pro JtagIce3 [0x12] >>> 80 00 
588 1718416535753 pro JtagIce3 [0x12] <<< 01 00 03 06 01 00 
588 1718416535754 pro JtagIce3 [0x12] >>> 80 00 
588 1718416535754 pro JtagIce3 [0x12] <<< 10 00 00 
588 1718416535881 pro JtagIce3 [0x12] >>> A0 00 19 
588 1718416535881 NativeController::GetTargetIDInfo exit with exception PDI physical timed out. (25)
