RichardSefton/AUV/MidtermPrototypeCode/Prototype_Controller.X/queuelogs/debugtool.txt

9865 1718421304042 GEN4_TO_CONTROLLER_LOG:GEN4_INIT_INT_LOG_ATtiny1627 null
9865 1718421304042 GEN4_TO_CONTROLLER_LOG:GEN4_INIT_INT_LOG_ATtiny1627 Return End

9865 1718421304042 GEN4_TO_CONTROLLER_LOG:GEN4_CONNECT_INT_LOG Pre:EstablishCommunincations
9865 1718421304042 GEN4_TO_CONTROLLER_LOG:GEN4_CONNECT_INT_LOG Payload
9865 1718421304042 GEN4_TO_CONTROLLER_LOG:GEN4_CONNECT_INT_LOG com.microchip.mplab.mdbcore.AtmelIceScripting.AIceScriptingCom@de64308
9865 1718421304042 GEN4_TO_CONTROLLER_LOG:GEN4_CONNECT_INT_LOG Payload End
9865 1718421304042 NativeController::EstablishCommunincations entry
9865 1718421304042 pro JtagIce3 [0x00] <<< 00 00 00 
9865 1718421304043 pro JtagIce3 [0x00] >>> 81 00 00 01 11 12 13 14 
9865 1718421304043 pro JtagIce3 [0x01] <<< 10 00 
9865 1718421304044 pro JtagIce3 [0x01] >>> 80 00 
9865 1718421304044 pro JtagIce3 [0x00] <<< 00 00 03 
9865 1718421304045 pro JtagIce3 [0x00] >>> 81 00 01 04 05 06 07 
9865 1718421304045 pro JtagIce3 [0x01] <<< 02 00 01 20 02 
9865 1718421304046 pro JtagIce3 [0x01] >>> 84 01 00 00 11 
9865 1718421304046 NativeController::EstablishCommunincations exit
9865 1718421304046 GEN4_TO_CONTROLLER_LOG:GEN4_CONNECT_INT_LOG Post:EstablishCommunincations
9865 1718421304046 GEN4_TO_CONTROLLER_LOG:GEN4_CONNECT_INT_LOG Return Value
9865 1718421304046 GEN4_TO_CONTROLLER_LOG:GEN4_CONNECT_INT_LOG true
9865 1718421304046 GEN4_TO_CONTROLLER_LOG:GEN4_CONNECT_INT_LOG Return End

9865 1718421304046 GEN4_TO_CONTROLLER_LOG:GEN4_CONNECT_INT_LOG Pre:GetFirmwareInfo
9865 1718421304046 GEN4_TO_CONTROLLER_LOG:GEN4_CONNECT_INT_LOG Payload
9865 1718421304046 GEN4_TO_CONTROLLER_LOG:GEN4_CONNECT_INT_LOG null
9865 1718421304046 GEN4_TO_CONTROLLER_LOG:GEN4_CONNECT_INT_LOG Payload End
9865 1718421304046 NativeController::GetFirmwareInfo entry
9865 1718421304046 pro JtagIce3 [0x01] <<< 02 00 00 00 01 
9865 1718421304047 pro JtagIce3 [0x01] >>> 84 01 00 00 
9865 1718421304047 NativeController::getFirmwareVersion entry
9865 1718421304047 pro JtagIce3 [0x01] <<< 02 00 00 01 01 
9865 1718421304048 pro JtagIce3 [0x01] >>> 84 01 01 00 
9865 1718421304048 pro JtagIce3 [0x01] <<< 02 00 00 02 01 
9865 1718421304049 pro JtagIce3 [0x01] >>> 84 01 2D 00 
9865 1718421304049 pro JtagIce3 [0x01] <<< 02 00 00 03 02 
9865 1718421304050 pro JtagIce3 [0x01] >>> 84 01 07 00 00 
9865 1718421304050 NativeController::getFirmwareVersion exit
9865 1718421304051 pro JtagIce3 [0x01] <<< 02 00 00 09 01 
9865 1718421304052 pro JtagIce3 [0x01] >>> 84 01 00 11 
9865 1718421304052 NativeController::tryGetFPGAVersion entry
9865 1718421304052 pro JtagIce3 [0x01] <<< 02 00 00 10 01 
9865 1718421304053 pro JtagIce3 [0x01] >>> 84 01 00 11 
9865 1718421304053 pro JtagIce3 [0x01] <<< 02 00 00 11 01 
9865 1718421304054 pro JtagIce3 [0x01] >>> 84 01 00 11 
9865 1718421304054 pro JtagIce3 [0x01] <<< 02 00 00 12 01 
9865 1718421304055 pro JtagIce3 [0x01] >>> 84 01 00 11 
9865 1718421304055 NativeController::tryGetFPGAVersion exit
9865 1718421304055 NativeController::tryGetFPGAVersion exit with exception No value present
9865 1718421304055 pro JtagIce3 [0x01] <<< 02 00 00 06 01 
9865 1718421304056 pro JtagIce3 [0x01] >>> 84 01 05 00 
9865 1718421304056 pro JtagIce3 [0x01] <<< 02 00 00 07 01 
9865 1718421304057 pro JtagIce3 [0x01] >>> 84 01 05 00 
9865 1718421304057 pro JtagIce3 [0x01] <<< 02 00 00 0A 01 
9865 1718421304058 pro JtagIce3 [0x01] >>> 84 01 00 11 
9865 1718421304058 NativeController::GetFirmwareInfo exit
9865 1718421304058 GEN4_TO_CONTROLLER_LOG:GEN4_CONNECT_INT_LOG Post:GetFirmwareInfo
9865 1718421304058 GEN4_TO_CONTROLLER_LOG:GEN4_CONNECT_INT_LOG Return Value
9865 1718421304058 GEN4_TO_CONTROLLER_LOG:GEN4_CONNECT_INT_LOG FirmwareInfo: Values:
9865 1718421304058 GEN4_TO_CONTROLLER_LOG:GEN4_CONNECT_INT_LOG FirmwareInfo: boot = false, bootVer = 5.5.0 (0x05.0x05.0x00), apVer = 1.45.7 (0x01.0x2d.0x07), fpgaVer = null, scriptVer = null, macAddress = , devID = 0, devID1 = 0, devSN0 = 0, devSN1 = 0, serialNumber = null, appCommitID = null, scriptCommitID = null, PCB_ID = 0
9865 1718421304058 GEN4_TO_CONTROLLER_LOG:GEN4_CONNECT_INT_LOG Return End
9865 1718421304058 GEN4_CONNECT_DIAGNOSTICS:ENTERING: com.microchip.mplab.mdbcore.RI4Tool.ConnectionHandler.CheckForFWUpdates()
9865 1718421304058 GEN4_CONNECT_DIAGNOSTICS:Created FirmwareUpdateHandler com.microchip.mplab.mdbcore.AtmelIceScripting.OperationHandlers.AIceScriptingFirmwareUpdateHandler@5386cb1d

9865 1718421304060 GEN4_TO_CONTROLLER_LOG:GEN4_CONNECT_INT_LOG Pre:SetUpdateFirmwareInfo
9865 1718421304060 GEN4_TO_CONTROLLER_LOG:GEN4_CONNECT_INT_LOG Payload
9865 1718421304060 GEN4_TO_CONTROLLER_LOG:GEN4_CONNECT_INT_LOG UpdateFirmwareInfo: Values:
9865 1718421304060 GEN4_TO_CONTROLLER_LOG:GEN4_CONNECT_INT_LOG UpdateFirmwareInfo: license = dCejLCt9ZV4fWdqYk3htQgdNYCC2nccSTvVdTD2oCjW3gRUtjikRtla11IiYo1wq, updateId = 2147483647
9865 1718421304060 GEN4_TO_CONTROLLER_LOG:GEN4_CONNECT_INT_LOG Payload End
9865 1718421304060 GEN4_TO_CONTROLLER_LOG:GEN4_CONNECT_INT_LOG Post:SetUpdateFirmwareInfo
9865 1718421304060 GEN4_TO_CONTROLLER_LOG:GEN4_CONNECT_INT_LOG Return Value
9865 1718421304060 GEN4_TO_CONTROLLER_LOG:GEN4_CONNECT_INT_LOG none
9865 1718421304060 GEN4_TO_CONTROLLER_LOG:GEN4_CONNECT_INT_LOG Return End
9865 1718421304060 GEN4_CONNECT_DIAGNOSTICS:EXITING: com.microchip.mplab.mdbcore.RI4Tool.ConnectionHandler.CheckForFWUpdates()

9865 1718421304060 GEN4_TO_CONTROLLER_LOG:GEN4_CONNECT_INT_LOG Pre:SetPowerInfo
9865 1718421304060 GEN4_TO_CONTROLLER_LOG:GEN4_CONNECT_INT_LOG Payload
9865 1718421304060 GEN4_TO_CONTROLLER_LOG:GEN4_CONNECT_INT_LOG PowerInfo: Values:
9865 1718421304060 GEN4_TO_CONTROLLER_LOG:GEN4_CONNECT_INT_LOG PowerInfo: shotDownSystem = false, isToolPower = false, voltage = 5.000000, useVppFirst = false, useLowVoltageProgramming = true, useMaintainActivePower = false
9865 1718421304060 GEN4_TO_CONTROLLER_LOG:GEN4_CONNECT_INT_LOG Payload End
9865 1718421304060 NativeController::GetVoltageInfo entry
9865 1718421304060 pro JtagIce3 [0x01] <<< 02 00 01 00 02 
9865 1718421304061 pro JtagIce3 [0x01] >>> 84 01 E5 12 00 
9865 1718421304061 pro JtagIce3 [0x01] <<< 02 00 01 20 02 
9865 1718421304062 pro JtagIce3 [0x01] >>> 84 01 00 00 11 
9865 1718421304062 NativeController::GetVoltageInfo TSUP exit with exception + The requested command is not supported. (17)
9865 1718421304062 pro JtagIce3 [0x01] <<< 02 00 01 02 02 
9865 1718421304063 pro JtagIce3 [0x01] >>> 84 01 00 00 11 
9865 1718421304063 NativeController::GetVoltageInfo VUSB exit with exception + The requested command is not supported. (17)
9865 1718421304063 NativeController::GetVoltageInfo exit
9865 1718421304063 GEN4_TO_CONTROLLER_LOG:GEN4_CONNECT_INT_LOG Post:SetPowerInfo
9865 1718421304063 GEN4_TO_CONTROLLER_LOG:GEN4_CONNECT_INT_LOG Return Value
9865 1718421304063 GEN4_TO_CONTROLLER_LOG:GEN4_CONNECT_INT_LOG none
9865 1718421304063 GEN4_TO_CONTROLLER_LOG:GEN4_CONNECT_INT_LOG Return End

9865 1718421304063 GEN4_TO_CONTROLLER_LOG:GEN4_CONNECT_INT_LOG Pre:GetVoltageInfo
9865 1718421304063 GEN4_TO_CONTROLLER_LOG:GEN4_CONNECT_INT_LOG Payload
9865 1718421304063 GEN4_TO_CONTROLLER_LOG:GEN4_CONNECT_INT_LOG null
9865 1718421304063 GEN4_TO_CONTROLLER_LOG:GEN4_CONNECT_INT_LOG Payload End
9865 1718421304063 NativeController::GetVoltageInfo entry
9865 1718421304063 pro JtagIce3 [0x01] <<< 02 00 01 00 02 
9865 1718421304064 pro JtagIce3 [0x01] >>> 84 01 E6 12 00 
9865 1718421304064 pro JtagIce3 [0x01] <<< 02 00 01 20 02 
9865 1718421304065 pro JtagIce3 [0x01] >>> 84 01 00 00 11 
9865 1718421304065 NativeController::GetVoltageInfo TSUP exit with exception + The requested command is not supported. (17)
9865 1718421304065 pro JtagIce3 [0x01] <<< 02 00 01 02 02 
9865 1718421304066 pro JtagIce3 [0x01] >>> 84 01 00 00 11 
9865 1718421304066 NativeController::GetVoltageInfo VUSB exit with exception + The requested command is not supported. (17)
9865 1718421304066 NativeController::GetVoltageInfo exit
9865 1718421304066 GEN4_TO_CONTROLLER_LOG:GEN4_CONNECT_INT_LOG Post:GetVoltageInfo
9865 1718421304066 GEN4_TO_CONTROLLER_LOG:GEN4_CONNECT_INT_LOG Return Value
9865 1718421304066 GEN4_TO_CONTROLLER_LOG:GEN4_CONNECT_INT_LOG VoltagesInfo: Values:
9865 1718421304066 GEN4_TO_CONTROLLER_LOG:GEN4_CONNECT_INT_LOG VoltagesInfo: internalVdd = 0, internalVpp = 0, targetVdd = 0, targetVpp = -2147483648, vddSense = 4838, temp = 0, vddCurrentSense = 0, vddVoltageSense = -2147483648
9865 1718421304066 GEN4_TO_CONTROLLER_LOG:GEN4_CONNECT_INT_LOG Return End

9865 1718421304066 GEN4_TO_CONTROLLER_LOG:GEN4_CONNECT_INT_LOG Pre:SetLEDBrightness
9865 1718421304066 GEN4_TO_CONTROLLER_LOG:GEN4_CONNECT_INT_LOG Payload
9865 1718421304066 GEN4_TO_CONTROLLER_LOG:GEN4_CONNECT_INT_LOG 5
9865 1718421304066 GEN4_TO_CONTROLLER_LOG:GEN4_CONNECT_INT_LOG Payload End
9865 1718421304066 GEN4_TO_CONTROLLER_LOG:GEN4_CONNECT_INT_LOG Post:SetLEDBrightness
9865 1718421304066 GEN4_TO_CONTROLLER_LOG:GEN4_CONNECT_INT_LOG Return Value
9865 1718421304066 GEN4_TO_CONTROLLER_LOG:GEN4_CONNECT_INT_LOG none
9865 1718421304066 GEN4_TO_CONTROLLER_LOG:GEN4_CONNECT_INT_LOG Return End

9865 1718421304066 GEN4_TO_CONTROLLER_LOG:GEN4_CONNECT_INT_LOG Pre:SetToolInfo
9865 1718421304066 GEN4_TO_CONTROLLER_LOG:GEN4_CONNECT_INT_LOG Payload
9865 1718421304066 GEN4_TO_CONTROLLER_LOG:GEN4_CONNECT_INT_LOG ToolInfo: Values:
9865 1718421304066 GEN4_TO_CONTROLLER_LOG:GEN4_CONNECT_INT_LOG ToolInfo: speedLevel = 1, PGCResistance = 4700, PGDResistance = 4700, PGCPullDir = PullDown, PGDPullDir = PullDown, ICSPSelected = Wire2
9865 1718421304066 GEN4_TO_CONTROLLER_LOG:GEN4_CONNECT_INT_LOG Payload End
9865 1718421304066 GEN4_TO_CONTROLLER_LOG:GEN4_CONNECT_INT_LOG Post:SetToolInfo
9865 1718421304066 GEN4_TO_CONTROLLER_LOG:GEN4_CONNECT_INT_LOG Return Value
9865 1718421304066 GEN4_TO_CONTROLLER_LOG:GEN4_CONNECT_INT_LOG none
9865 1718421304066 GEN4_TO_CONTROLLER_LOG:GEN4_CONNECT_INT_LOG Return End

9865 1718421304066 GEN4_TO_CONTROLLER_LOG:GEN4_CONNECT_INT_LOG Pre:GetTargetIDInfo
9865 1718421304066 GEN4_TO_CONTROLLER_LOG:GEN4_CONNECT_INT_LOG Payload
9865 1718421304066 GEN4_TO_CONTROLLER_LOG:GEN4_CONNECT_INT_LOG null
9865 1718421304066 GEN4_TO_CONTROLLER_LOG:GEN4_CONNECT_INT_LOG Payload End
9865 1718421304066 NativeController::GetTargetIDInfo entry
9865 1718421304066 pro JtagIce3 [0x12] <<< 01 00 01 31 02 F4 01 
9865 1718421304067 pro JtagIce3 [0x12] >>> 80 00 
9865 1718421304067 pro JtagIce3 [0x12] <<< 01 00 00 00 01 05 
9865 1718421304068 pro JtagIce3 [0x12] >>> 80 00 
9865 1718421304068 pro JtagIce3 [0x12] <<< 01 00 00 01 01 01 
9865 1718421304069 pro JtagIce3 [0x12] >>> 80 00 
9865 1718421304069 pro JtagIce3 [0x12] <<< 01 00 01 00 01 08 
9865 1718421304070 pro JtagIce3 [0x12] >>> 80 00 
9865 1718421304070 pro JtagIce3 [0x12] <<< 01 00 02 00 30 00 80 40 20 00 10 80 0F 94 11 8C 0A 98 08 DC 05 EE 02 00 40 00 00 00 01 20 00 0A 05 FF 00 FF 00 00 14 00 13 00 11 80 12 8A 12 28 94 00 00 00 00 
9865 1718421304071 pro JtagIce3 [0x12] >>> 80 00 
9865 1718421304071 pro JtagIce3 [0x12] <<< 01 00 03 06 01 00 
9865 1718421304072 pro JtagIce3 [0x12] >>> 80 00 
9865 1718421304072 pro JtagIce3 [0x12] <<< 10 00 00 
9865 1718421304084 pro JtagIce3 [0x12] >>> 84 00 74 69 6E 79 00 
9865 1718421304084 pro JtagIce3 [0x12] <<< 01 00 03 06 01 00 
9865 1718421304085 pro JtagIce3 [0x12] >>> 80 00 
9865 1718421304085 pro JtagIce3 [0x12] <<< 15 00 
9865 1718421304151 pro JtagIce3 [0x12] >>> 80 00 
9865 1718421304151 pro JtagIce3 [0x12] <<< 21 00 B4 00 11 00 00 03 00 00 00 
9865 1718421304153 pro JtagIce3 [0x12] >>> 84 00 1E 94 28 00 
9865 1718421304153 pro JtagIce3 [0x12] <<< 21 00 B4 00 11 00 00 03 00 00 00 
9865 1718421304155 pro JtagIce3 [0x12] >>> 84 00 1E 94 28 00 
9865 1718421304155 pro JtagIce3 [0x12] <<< 21 00 B4 00 11 00 00 03 00 00 00 
9865 1718421304157 pro JtagIce3 [0x12] >>> 84 00 1E 94 28 00 
9865 1718421304157 pro JtagIce3 [0x12] <<< 21 00 B2 01 0F 00 00 01 00 00 00 
9865 1718421304158 pro JtagIce3 [0x12] >>> 84 00 04 00 
9865 1718421304159 pro JtagIce3 [0x12] <<< 16 00 
9865 1718421304160 pro JtagIce3 [0x12] >>> 80 00 
9865 1718421304160 pro JtagIce3 [0x12] <<< 11 00 
9865 1718421304162 pro JtagIce3 [0x12] >>> 80 00 
9865 1718421304162 pro JtagIce3 [0x01] <<< 11 00 00 
9865 1718421304164 pro JtagIce3 [0x01] >>> 80 00 
9865 1718421304164 NativeController::GetTargetIDInfo exit device ID 0x1e9428
9865 1718421304164 GEN4_TO_CONTROLLER_LOG:GEN4_CONNECT_INT_LOG Post:GetTargetIDInfo
9865 1718421304164 GEN4_TO_CONTROLLER_LOG:GEN4_CONNECT_INT_LOG Return Value
9865 1718421304164 GEN4_TO_CONTROLLER_LOG:GEN4_CONNECT_INT_LOG TargetIDInfo: Values:
9865 1718421304164 GEN4_TO_CONTROLLER_LOG:GEN4_CONNECT_INT_LOG TargetIDInfo: DeviceID = 001e9428
9865 1718421304164 GEN4_TO_CONTROLLER_LOG:GEN4_CONNECT_INT_LOG Return End

9865 1718421304166 GEN4_TO_CONTROLLER_LOG:GEN4_PROGRAM_INT_LOG_ATtiny1627 Pre:SendOperation
9865 1718421304166 GEN4_TO_CONTROLLER_LOG:GEN4_PROGRAM_INT_LOG_ATtiny1627 Payload
9865 1718421304166 GEN4_TO_CONTROLLER_LOG:GEN4_PROGRAM_INT_LOG_ATtiny1627 OperationInfo: Values:
9865 1718421304166 GEN4_TO_CONTROLLER_LOG:GEN4_PROGRAM_INT_LOG_ATtiny1627 OperationInfo: Type = erase, Mask = 00000000, Erase = false, Production Mode = false
9865 1718421304166 GEN4_TO_CONTROLLER_LOG:GEN4_PROGRAM_INT_LOG_ATtiny1627 TransferInfo: Start = 0, End = 3fff, Buffer Length = 0, Type = Pgm, Mask = 00000000
9865 1718421304166 GEN4_TO_CONTROLLER_LOG:GEN4_PROGRAM_INT_LOG_ATtiny1627 TransferInfo: Start = 1280, End = 1288, Buffer Length = 0, Type = Cfg, Mask = 00000000
9865 1718421304166 GEN4_TO_CONTROLLER_LOG:GEN4_PROGRAM_INT_LOG_ATtiny1627 TransferInfo: Start = 128a, End = 128a, Buffer Length = 0, Type = Cfg, Mask = 00000000
9865 1718421304166 GEN4_TO_CONTROLLER_LOG:GEN4_PROGRAM_INT_LOG_ATtiny1627 TransferInfo: Start = 1400, End = 14ff, Buffer Length = 0, Type = EEData, Mask = 00000000
9865 1718421304166 GEN4_TO_CONTROLLER_LOG:GEN4_PROGRAM_INT_LOG_ATtiny1627 TransferInfo: Start = 1300, End = 131f, Buffer Length = 0, Type = UserID, Mask = 00000000
9865 1718421304166 GEN4_TO_CONTROLLER_LOG:GEN4_PROGRAM_INT_LOG_ATtiny1627 Payload End
9865 1718421304166 pro JtagIce3 [0x12] <<< 01 00 01 31 02 F4 01 
9865 1718421304167 pro JtagIce3 [0x12] >>> 80 00 
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
9865 1718421304669 GEN4_TO_CONTROLLER_LOG:GEN4_DEBUG_INT_LOG_ATtiny1627 Return Value
9865 1718421304669 GEN4_TO_CONTROLLER_LOG:GEN4_DEBUG_INT_LOG_ATtiny1627 none
9865 1718421304669 GEN4_TO_CONTROLLER_LOG:GEN4_DEBUG_INT_LOG_ATtiny1627 Return End

9870 1718421304676 GEN4_TO_CONTROLLER_LOG:GEN4_DEBUG_INT_LOG_ATtiny1627 Pre:setTraceDescriptor
9870 1718421304676 GEN4_TO_CONTROLLER_LOG:GEN4_DEBUG_INT_LOG_ATtiny1627 Payload
9870 1718421304676 GEN4_TO_CONTROLLER_LOG:GEN4_DEBUG_INT_LOG_ATtiny1627 com.microchip.mplab.libs.RI4ToolsController.DataClasses.TraceDescriptor@1afba8d
9870 1718421304676 GEN4_TO_CONTROLLER_LOG:GEN4_DEBUG_INT_LOG_ATtiny1627 Payload End
9870 1718421304676 GEN4_TO_CONTROLLER_LOG:GEN4_DEBUG_INT_LOG_ATtiny1627 Post:setTraceDescriptor
9870 1718421304676 GEN4_TO_CONTROLLER_LOG:GEN4_DEBUG_INT_LOG_ATtiny1627 Return Value
9870 1718421304676 GEN4_TO_CONTROLLER_LOG:GEN4_DEBUG_INT_LOG_ATtiny1627 none
9870 1718421304676 GEN4_TO_CONTROLLER_LOG:GEN4_DEBUG_INT_LOG_ATtiny1627 Return End

9870 1718421304676 GEN4_TO_CONTROLLER_LOG:GEN4_DEBUG_INT_LOG_ATtiny1627 Pre:SetSoftwareBreakpoint
9870 1718421304676 GEN4_TO_CONTROLLER_LOG:GEN4_DEBUG_INT_LOG_ATtiny1627 Payload
9870 1718421304676 GEN4_TO_CONTROLLER_LOG:GEN4_DEBUG_INT_LOG_ATtiny1627 78
9870 1718421304676 GEN4_TO_CONTROLLER_LOG:GEN4_DEBUG_INT_LOG_ATtiny1627 9598
9870 1718421304676 GEN4_TO_CONTROLLER_LOG:GEN4_DEBUG_INT_LOG_ATtiny1627 1
9870 1718421304676 GEN4_TO_CONTROLLER_LOG:GEN4_DEBUG_INT_LOG_ATtiny1627 Payload End
9870 1718421304676 pro JtagIce3 [0x12] <<< 43 00 F0 00 00 00 
9870 1718421304678 pro JtagIce3 [0x12] >>> 80 00 
9870 1718421304678 GEN4_TO_CONTROLLER_LOG:GEN4_DEBUG_INT_LOG_ATtiny1627 Post:SetSoftwareBreakpoint
9870 1718421304678 GEN4_TO_CONTROLLER_LOG:GEN4_DEBUG_INT_LOG_ATtiny1627 Return Value
9870 1718421304678 GEN4_TO_CONTROLLER_LOG:GEN4_DEBUG_INT_LOG_ATtiny1627 9598
9870 1718421304678 GEN4_TO_CONTROLLER_LOG:GEN4_DEBUG_INT_LOG_ATtiny1627 Return End

9870 1718421304678 GEN4_TO_CONTROLLER_LOG:GEN4_DEBUG_INT_LOG_ATtiny1627 Pre:SetSoftwareBreakpoint
9870 1718421304678 GEN4_TO_CONTROLLER_LOG:GEN4_DEBUG_INT_LOG_ATtiny1627 Payload
9870 1718421304678 GEN4_TO_CONTROLLER_LOG:GEN4_DEBUG_INT_LOG_ATtiny1627 ef
9870 1718421304678 GEN4_TO_CONTROLLER_LOG:GEN4_DEBUG_INT_LOG_ATtiny1627 9598
9870 1718421304678 GEN4_TO_CONTROLLER_LOG:GEN4_DEBUG_INT_LOG_ATtiny1627 1
9870 1718421304678 GEN4_TO_CONTROLLER_LOG:GEN4_DEBUG_INT_LOG_ATtiny1627 Payload End
9870 1718421304678 pro JtagIce3 [0x12] <<< 43 00 DE 01 00 00 
9870 1718421304679 pro JtagIce3 [0x12] >>> 80 00 
9870 1718421304679 GEN4_TO_CONTROLLER_LOG:GEN4_DEBUG_INT_LOG_ATtiny1627 Post:SetSoftwareBreakpoint
9870 1718421304679 GEN4_TO_CONTROLLER_LOG:GEN4_DEBUG_INT_LOG_ATtiny1627 Return Value
9870 1718421304679 GEN4_TO_CONTROLLER_LOG:GEN4_DEBUG_INT_LOG_ATtiny1627 9598
9870 1718421304679 GEN4_TO_CONTROLLER_LOG:GEN4_DEBUG_INT_LOG_ATtiny1627 Return End

9870 1718421304679 GEN4_TO_CONTROLLER_LOG:GEN4_DEBUG_INT_LOG_ATtiny1627 Pre:SetSoftwareBreakpoint
9870 1718421304679 GEN4_TO_CONTROLLER_LOG:GEN4_DEBUG_INT_LOG_ATtiny1627 Payload
9870 1718421304679 GEN4_TO_CONTROLLER_LOG:GEN4_DEBUG_INT_LOG_ATtiny1627 ad
9870 1718421304679 GEN4_TO_CONTROLLER_LOG:GEN4_DEBUG_INT_LOG_ATtiny1627 9598
9870 1718421304679 GEN4_TO_CONTROLLER_LOG:GEN4_DEBUG_INT_LOG_ATtiny1627 1
9870 1718421304679 GEN4_TO_CONTROLLER_LOG:GEN4_DEBUG_INT_LOG_ATtiny1627 Payload End
9870 1718421304679 pro JtagIce3 [0x12] <<< 43 00 5A 01 00 00 
9870 1718421304680 pro JtagIce3 [0x12] >>> 80 00 
9870 1718421304680 GEN4_TO_CONTROLLER_LOG:GEN4_DEBUG_INT_LOG_ATtiny1627 Post:SetSoftwareBreakpoint
9870 1718421304680 GEN4_TO_CONTROLLER_LOG:GEN4_DEBUG_INT_LOG_ATtiny1627 Return Value
9870 1718421304680 GEN4_TO_CONTROLLER_LOG:GEN4_DEBUG_INT_LOG_ATtiny1627 9598
9870 1718421304680 GEN4_TO_CONTROLLER_LOG:GEN4_DEBUG_INT_LOG_ATtiny1627 Return End

9870 1718421304680 GEN4_TO_CONTROLLER_LOG:GEN4_DEBUG_INT_LOG_ATtiny1627 Pre:SetSoftwareBreakpoint
9870 1718421304680 GEN4_TO_CONTROLLER_LOG:GEN4_DEBUG_INT_LOG_ATtiny1627 Payload
9870 1718421304680 GEN4_TO_CONTROLLER_LOG:GEN4_DEBUG_INT_LOG_ATtiny1627 108
9870 1718421304680 GEN4_TO_CONTROLLER_LOG:GEN4_DEBUG_INT_LOG_ATtiny1627 9598
9870 1718421304680 GEN4_TO_CONTROLLER_LOG:GEN4_DEBUG_INT_LOG_ATtiny1627 1
9870 1718421304680 GEN4_TO_CONTROLLER_LOG:GEN4_DEBUG_INT_LOG_ATtiny1627 Payload End
9870 1718421304680 pro JtagIce3 [0x12] <<< 43 00 10 02 00 00 
9870 1718421304681 pro JtagIce3 [0x12] >>> 80 00 
9870 1718421304681 GEN4_TO_CONTROLLER_LOG:GEN4_DEBUG_INT_LOG_ATtiny1627 Post:SetSoftwareBreakpoint
9870 1718421304681 GEN4_TO_CONTROLLER_LOG:GEN4_DEBUG_INT_LOG_ATtiny1627 Return Value
9870 1718421304681 GEN4_TO_CONTROLLER_LOG:GEN4_DEBUG_INT_LOG_ATtiny1627 9598
9870 1718421304681 GEN4_TO_CONTROLLER_LOG:GEN4_DEBUG_INT_LOG_ATtiny1627 Return End

9870 1718421304681 GEN4_TO_CONTROLLER_LOG:GEN4_DEBUG_INT_LOG_ATtiny1627 Pre:GetPC
9870 1718421304681 GEN4_TO_CONTROLLER_LOG:GEN4_DEBUG_INT_LOG_ATtiny1627 Payload
9870 1718421304681 GEN4_TO_CONTROLLER_LOG:GEN4_DEBUG_INT_LOG_ATtiny1627 null
9870 1718421304681 GEN4_TO_CONTROLLER_LOG:GEN4_DEBUG_INT_LOG_ATtiny1627 Payload End
9870 1718421304681 pro JtagIce3 [0x12] <<< 35 00 
9870 1718421304682 pro JtagIce3 [0x12] >>> 83 00 00 00 00 00 
9870 1718421304682 GEN4_TO_CONTROLLER_LOG:GEN4_DEBUG_INT_LOG_ATtiny1627 Post:GetPC
9870 1718421304682 GEN4_TO_CONTROLLER_LOG:GEN4_DEBUG_INT_LOG_ATtiny1627 Return Value
9870 1718421304682 GEN4_TO_CONTROLLER_LOG:GEN4_DEBUG_INT_LOG_ATtiny1627 0
9870 1718421304682 GEN4_TO_CONTROLLER_LOG:GEN4_DEBUG_INT_LOG_ATtiny1627 Return End

9870 1718421304683 GEN4_TO_CONTROLLER_LOG:GEN4_DEBUG_INT_LOG_ATtiny1627 Pre:RunTarget
9870 1718421304683 GEN4_TO_CONTROLLER_LOG:GEN4_DEBUG_INT_LOG_ATtiny1627 Payload
9870 1718421304683 GEN4_TO_CONTROLLER_LOG:GEN4_DEBUG_INT_LOG_ATtiny1627 com.microchip.mplab.mdbcore.RI4Tool.atmelice.AIceDebugHandlerWithBP@5902e60
9870 1718421304683 GEN4_TO_CONTROLLER_LOG:GEN4_DEBUG_INT_LOG_ATtiny1627 Payload End
9870 1718421304683 pro JtagIce3 [0x12] <<< 32 00 
9870 1718421304735 pro JtagIce3 [0x12] >>> 80 00 
9870 1718421304737 pro JtagIce3 ||| 0E 00 6D 0A 12 40 78 00 00 00 01 04 20 AB 
9870 1718421304738 GEN4_TO_CONTROLLER_LOG:GEN4_DEBUG_INT_LOG_ATtiny1627 Post:RunTarget
9870 1718421304738 GEN4_TO_CONTROLLER_LOG:GEN4_DEBUG_INT_LOG_ATtiny1627 Return Value
9870 1718421304738 GEN4_TO_CONTROLLER_LOG:GEN4_DEBUG_INT_LOG_ATtiny1627 false
9870 1718421304738 GEN4_TO_CONTROLLER_LOG:GEN4_DEBUG_INT_LOG_ATtiny1627 Return End

9870 1718421304997 GEN4_TO_CONTROLLER_LOG:GEN4_DEBUG_INT_LOG_ATtiny1627 Pre:GetPC
9870 1718421304997 GEN4_TO_CONTROLLER_LOG:GEN4_DEBUG_INT_LOG_ATtiny1627 Payload
9870 1718421304997 GEN4_TO_CONTROLLER_LOG:GEN4_DEBUG_INT_LOG_ATtiny1627 null
9870 1718421304997 GEN4_TO_CONTROLLER_LOG:GEN4_DEBUG_INT_LOG_ATtiny1627 Payload End
9870 1718421304997 pro JtagIce3 [0x12] <<< 35 00 
9870 1718421304999 pro JtagIce3 [0x12] >>> 83 00 78 00 00 00 
9870 1718421304999 GEN4_TO_CONTROLLER_LOG:GEN4_DEBUG_INT_LOG_ATtiny1627 Post:GetPC
9870 1718421304999 GEN4_TO_CONTROLLER_LOG:GEN4_DEBUG_INT_LOG_ATtiny1627 Return Value
9870 1718421304999 GEN4_TO_CONTROLLER_LOG:GEN4_DEBUG_INT_LOG_ATtiny1627 78
9870 1718421304999 GEN4_TO_CONTROLLER_LOG:GEN4_DEBUG_INT_LOG_ATtiny1627 Return End

9856 1718421304999 GEN4_TO_CONTROLLER_LOG:GEN4_DEBUG_INT_LOG_ATtiny1627 Pre:GetPC
9856 1718421304999 GEN4_TO_CONTROLLER_LOG:GEN4_DEBUG_INT_LOG_ATtiny1627 Payload
9856 1718421304999 GEN4_TO_CONTROLLER_LOG:GEN4_DEBUG_INT_LOG_ATtiny1627 null
9856 1718421304999 GEN4_TO_CONTROLLER_LOG:GEN4_DEBUG_INT_LOG_ATtiny1627 Payload End
9856 1718421304999 pro JtagIce3 [0x12] <<< 35 00 
9856 1718421305001 pro JtagIce3 [0x12] >>> 83 00 78 00 00 00 
9856 1718421305001 GEN4_TO_CONTROLLER_LOG:GEN4_DEBUG_INT_LOG_ATtiny1627 Post:GetPC
9856 1718421305001 GEN4_TO_CONTROLLER_LOG:GEN4_DEBUG_INT_LOG_ATtiny1627 Return Value
9856 1718421305001 GEN4_TO_CONTROLLER_LOG:GEN4_DEBUG_INT_LOG_ATtiny1627 78
9856 1718421305001 GEN4_TO_CONTROLLER_LOG:GEN4_DEBUG_INT_LOG_ATtiny1627 Return End

9856 1718421305001 GEN4_TO_CONTROLLER_LOG:GEN4_DEBUG_INT_LOG_ATtiny1627 Pre:DebugReadTargetMemory
9856 1718421305001 GEN4_TO_CONTROLLER_LOG:GEN4_DEBUG_INT_LOG_ATtiny1627 Payload
9856 1718421305001 GEN4_TO_CONTROLLER_LOG:GEN4_DEBUG_INT_LOG_ATtiny1627 FileRegs
9856 1718421305001 GEN4_TO_CONTROLLER_LOG:GEN4_DEBUG_INT_LOG_ATtiny1627 3d
9856 1718421305001 GEN4_TO_CONTROLLER_LOG:GEN4_DEBUG_INT_LOG_ATtiny1627 3e
9856 1718421305001 GEN4_TO_CONTROLLER_LOG:GEN4_DEBUG_INT_LOG_ATtiny1627 Length = 2
9856 1718421305001 GEN4_TO_CONTROLLER_LOG:GEN4_DEBUG_INT_LOG_ATtiny1627 Payload End
9856 1718421305001 pro JtagIce3 [0x12] <<< 21 00 20 3D 00 00 00 02 00 00 00 
9856 1718421305003 pro JtagIce3 [0x12] >>> 84 00 FD 3F 00 
9856 1718421305003 GEN4_TO_CONTROLLER_LOG:GEN4_DEBUG_INT_LOG_ATtiny1627 Post:DebugReadTargetMemory
9856 1718421305003 GEN4_TO_CONTROLLER_LOG:GEN4_DEBUG_INT_LOG_ATtiny1627 Return Value
9856 1718421305003 GEN4_TO_CONTROLLER_LOG:GEN4_DEBUG_INT_LOG_ATtiny1627 true
9856 1718421305003 GEN4_TO_CONTROLLER_LOG:GEN4_DEBUG_INT_LOG_ATtiny1627 Return End

9856 1718421305006 GEN4_TO_CONTROLLER_LOG:GEN4_DEBUG_INT_LOG_ATtiny1627 Pre:DebugReadTargetMemory
9856 1718421305006 GEN4_TO_CONTROLLER_LOG:GEN4_DEBUG_INT_LOG_ATtiny1627 Payload
9856 1718421305006 GEN4_TO_CONTROLLER_LOG:GEN4_DEBUG_INT_LOG_ATtiny1627 FileRegs
9856 1718421305006 GEN4_TO_CONTROLLER_LOG:GEN4_DEBUG_INT_LOG_ATtiny1627 3f
9856 1718421305006 GEN4_TO_CONTROLLER_LOG:GEN4_DEBUG_INT_LOG_ATtiny1627 3f
9856 1718421305006 GEN4_TO_CONTROLLER_LOG:GEN4_DEBUG_INT_LOG_ATtiny1627 Length = 1
9856 1718421305006 GEN4_TO_CONTROLLER_LOG:GEN4_DEBUG_INT_LOG_ATtiny1627 Payload End
9856 1718421305006 pro JtagIce3 [0x12] <<< 21 00 20 3F 00 00 00 01 00 00 00 
9856 1718421305007 pro JtagIce3 [0x12] >>> 84 00 02 00 
9856 1718421305007 GEN4_TO_CONTROLLER_LOG:GEN4_DEBUG_INT_LOG_ATtiny1627 Post:DebugReadTargetMemory
9856 1718421305007 GEN4_TO_CONTROLLER_LOG:GEN4_DEBUG_INT_LOG_ATtiny1627 Return Value
9856 1718421305007 GEN4_TO_CONTROLLER_LOG:GEN4_DEBUG_INT_LOG_ATtiny1627 true
9856 1718421305007 GEN4_TO_CONTROLLER_LOG:GEN4_DEBUG_INT_LOG_ATtiny1627 Return End

9637 1718421306003 GEN4_TO_CONTROLLER_LOG:GEN4_DEBUG_INT_LOG_ATtiny1627 Pre:DebugReadTargetMemory
9637 1718421306003 GEN4_TO_CONTROLLER_LOG:GEN4_DEBUG_INT_LOG_ATtiny1627 Payload
9637 1718421306003 GEN4_TO_CONTROLLER_LOG:GEN4_DEBUG_INT_LOG_ATtiny1627 FileRegs
9637 1718421306003 GEN4_TO_CONTROLLER_LOG:GEN4_DEBUG_INT_LOG_ATtiny1627 3f
9637 1718421306003 GEN4_TO_CONTROLLER_LOG:GEN4_DEBUG_INT_LOG_ATtiny1627 3f
9637 1718421306003 GEN4_TO_CONTROLLER_LOG:GEN4_DEBUG_INT_LOG_ATtiny1627 Length = 1
9637 1718421306003 GEN4_TO_CONTROLLER_LOG:GEN4_DEBUG_INT_LOG_ATtiny1627 Payload End
9637 1718421306003 pro JtagIce3 [0x12] <<< 21 00 20 3F 00 00 00 01 00 00 00 
9637 1718421306005 pro JtagIce3 [0x12] >>> 84 00 02 00 
9637 1718421306005 GEN4_TO_CONTROLLER_LOG:GEN4_DEBUG_INT_LOG_ATtiny1627 Post:DebugReadTargetMemory
9637 1718421306005 GEN4_TO_CONTROLLER_LOG:GEN4_DEBUG_INT_LOG_ATtiny1627 Return Value
9637 1718421306005 GEN4_TO_CONTROLLER_LOG:GEN4_DEBUG_INT_LOG_ATtiny1627 true
9637 1718421306005 GEN4_TO_CONTROLLER_LOG:GEN4_DEBUG_INT_LOG_ATtiny1627 Return End

9873 1718421307503 GEN4_TO_CONTROLLER_LOG:GEN4_DEBUG_INT_LOG_ATtiny1627 Pre:setTraceDescriptor
9873 1718421307503 GEN4_TO_CONTROLLER_LOG:GEN4_DEBUG_INT_LOG_ATtiny1627 Payload
9873 1718421307503 GEN4_TO_CONTROLLER_LOG:GEN4_DEBUG_INT_LOG_ATtiny1627 com.microchip.mplab.libs.RI4ToolsController.DataClasses.TraceDescriptor@208d091f
9873 1718421307503 GEN4_TO_CONTROLLER_LOG:GEN4_DEBUG_INT_LOG_ATtiny1627 Payload End
9873 1718421307503 GEN4_TO_CONTROLLER_LOG:GEN4_DEBUG_INT_LOG_ATtiny1627 Post:setTraceDescriptor
9873 1718421307503 GEN4_TO_CONTROLLER_LOG:GEN4_DEBUG_INT_LOG_ATtiny1627 Return Value
9873 1718421307503 GEN4_TO_CONTROLLER_LOG:GEN4_DEBUG_INT_LOG_ATtiny1627 none
9873 1718421307503 GEN4_TO_CONTROLLER_LOG:GEN4_DEBUG_INT_LOG_ATtiny1627 Return End

9873 1718421307503 GEN4_TO_CONTROLLER_LOG:GEN4_DEBUG_INT_LOG_ATtiny1627 Pre:GetPC
9873 1718421307503 GEN4_TO_CONTROLLER_LOG:GEN4_DEBUG_INT_LOG_ATtiny1627 Payload
9873 1718421307503 GEN4_TO_CONTROLLER_LOG:GEN4_DEBUG_INT_LOG_ATtiny1627 null
9873 1718421307503 GEN4_TO_CONTROLLER_LOG:GEN4_DEBUG_INT_LOG_ATtiny1627 Payload End
9873 1718421307503 pro JtagIce3 [0x12] <<< 35 00 
9873 1718421307505 pro JtagIce3 [0x12] >>> 83 00 78 00 00 00 
9873 1718421307505 GEN4_TO_CONTROLLER_LOG:GEN4_DEBUG_INT_LOG_ATtiny1627 Post:GetPC
9873 1718421307505 GEN4_TO_CONTROLLER_LOG:GEN4_DEBUG_INT_LOG_ATtiny1627 Return Value
9873 1718421307505 GEN4_TO_CONTROLLER_LOG:GEN4_DEBUG_INT_LOG_ATtiny1627 78
9873 1718421307505 GEN4_TO_CONTROLLER_LOG:GEN4_DEBUG_INT_LOG_ATtiny1627 Return End

9873 1718421307505 GEN4_TO_CONTROLLER_LOG:GEN4_DEBUG_INT_LOG_ATtiny1627 Pre:SetSoftwareBreakpoint
9873 1718421307505 GEN4_TO_CONTROLLER_LOG:GEN4_DEBUG_INT_LOG_ATtiny1627 Payload
9873 1718421307505 GEN4_TO_CONTROLLER_LOG:GEN4_DEBUG_INT_LOG_ATtiny1627 78
9873 1718421307505 GEN4_TO_CONTROLLER_LOG:GEN4_DEBUG_INT_LOG_ATtiny1627 9598
9873 1718421307505 GEN4_TO_CONTROLLER_LOG:GEN4_DEBUG_INT_LOG_ATtiny1627 0
9873 1718421307505 GEN4_TO_CONTROLLER_LOG:GEN4_DEBUG_INT_LOG_ATtiny1627 Payload End
9873 1718421307505 pro JtagIce3 [0x12] <<< 44 00 F0 00 00 00 
9873 1718421307507 pro JtagIce3 [0x12] >>> 80 00 
9873 1718421307507 GEN4_TO_CONTROLLER_LOG:GEN4_DEBUG_INT_LOG_ATtiny1627 Post:SetSoftwareBreakpoint
9873 1718421307507 GEN4_TO_CONTROLLER_LOG:GEN4_DEBUG_INT_LOG_ATtiny1627 Return Value
9873 1718421307507 GEN4_TO_CONTROLLER_LOG:GEN4_DEBUG_INT_LOG_ATtiny1627 9598
9873 1718421307507 GEN4_TO_CONTROLLER_LOG:GEN4_DEBUG_INT_LOG_ATtiny1627 Return End

9873 1718421307507 GEN4_TO_CONTROLLER_LOG:GEN4_DEBUG_INT_LOG_ATtiny1627 Pre:StepTarget
9873 1718421307507 GEN4_TO_CONTROLLER_LOG:GEN4_DEBUG_INT_LOG_ATtiny1627 Payload
9873 1718421307507 GEN4_TO_CONTROLLER_LOG:GEN4_DEBUG_INT_LOG_ATtiny1627 0
9873 1718421307507 GEN4_TO_CONTROLLER_LOG:GEN4_DEBUG_INT_LOG_ATtiny1627 Payload End
9873 1718421307507 pro JtagIce3 [0x12] <<< 34 00 01 01 
9873 1718421307521 pro JtagIce3 [0x12] >>> 80 00 
9873 1718421307541 pro JtagIce3 ||| 0E 00 6E 0A 12 40 50 00 00 00 01 04 01 AB 
9873 1718421307543 GEN4_TO_CONTROLLER_LOG:GEN4_DEBUG_INT_LOG_ATtiny1627 Post:StepTarget
9873 1718421307543 GEN4_TO_CONTROLLER_LOG:GEN4_DEBUG_INT_LOG_ATtiny1627 Return Value
9873 1718421307543 GEN4_TO_CONTROLLER_LOG:GEN4_DEBUG_INT_LOG_ATtiny1627 true
9873 1718421307543 GEN4_TO_CONTROLLER_LOG:GEN4_DEBUG_INT_LOG_ATtiny1627 Return End

9873 1718421307543 GEN4_TO_CONTROLLER_LOG:GEN4_DEBUG_INT_LOG_ATtiny1627 Pre:SetSoftwareBreakpoint
9873 1718421307543 GEN4_TO_CONTROLLER_LOG:GEN4_DEBUG_INT_LOG_ATtiny1627 Payload
9873 1718421307543 GEN4_TO_CONTROLLER_LOG:GEN4_DEBUG_INT_LOG_ATtiny1627 78
9873 1718421307543 GEN4_TO_CONTROLLER_LOG:GEN4_DEBUG_INT_LOG_ATtiny1627 9598
9873 1718421307543 GEN4_TO_CONTROLLER_LOG:GEN4_DEBUG_INT_LOG_ATtiny1627 1
9873 1718421307543 GEN4_TO_CONTROLLER_LOG:GEN4_DEBUG_INT_LOG_ATtiny1627 Payload End
9873 1718421307543 pro JtagIce3 [0x12] <<< 43 00 F0 00 00 00 
9873 1718421307544 pro JtagIce3 [0x12] >>> 80 00 
9873 1718421307544 GEN4_TO_CONTROLLER_LOG:GEN4_DEBUG_INT_LOG_ATtiny1627 Post:SetSoftwareBreakpoint
9873 1718421307544 GEN4_TO_CONTROLLER_LOG:GEN4_DEBUG_INT_LOG_ATtiny1627 Return Value
9873 1718421307544 GEN4_TO_CONTROLLER_LOG:GEN4_DEBUG_INT_LOG_ATtiny1627 9598
9873 1718421307544 GEN4_TO_CONTROLLER_LOG:GEN4_DEBUG_INT_LOG_ATtiny1627 Return End

9873 1718421307544 GEN4_TO_CONTROLLER_LOG:GEN4_DEBUG_INT_LOG_ATtiny1627 Pre:RunTarget
9873 1718421307544 GEN4_TO_CONTROLLER_LOG:GEN4_DEBUG_INT_LOG_ATtiny1627 Payload
9873 1718421307544 GEN4_TO_CONTROLLER_LOG:GEN4_DEBUG_INT_LOG_ATtiny1627 com.microchip.mplab.mdbcore.RI4Tool.atmelice.AIceDebugHandlerWithBP@5902e60
9873 1718421307544 GEN4_TO_CONTROLLER_LOG:GEN4_DEBUG_INT_LOG_ATtiny1627 Payload End
9873 1718421307544 pro JtagIce3 [0x12] <<< 32 00 
9873 1718421307558 pro JtagIce3 [0x12] >>> 80 00 
9873 1718421307560 GEN4_TO_CONTROLLER_LOG:GEN4_DEBUG_INT_LOG_ATtiny1627 Post:RunTarget
9873 1718421307560 GEN4_TO_CONTROLLER_LOG:GEN4_DEBUG_INT_LOG_ATtiny1627 Return Value
9873 1718421307560 GEN4_TO_CONTROLLER_LOG:GEN4_DEBUG_INT_LOG_ATtiny1627 true
9873 1718421307560 GEN4_TO_CONTROLLER_LOG:GEN4_DEBUG_INT_LOG_ATtiny1627 Return End
9873 1718421313237 pro JtagIce3 ||| 0E 00 6F 0A 12 40 AD 00 00 00 01 04 20 AB 

9873 1718421313239 GEN4_TO_CONTROLLER_LOG:GEN4_DEBUG_INT_LOG_ATtiny1627 Pre:GetPC
9873 1718421313239 GEN4_TO_CONTROLLER_LOG:GEN4_DEBUG_INT_LOG_ATtiny1627 Payload
9873 1718421313239 GEN4_TO_CONTROLLER_LOG:GEN4_DEBUG_INT_LOG_ATtiny1627 null
9873 1718421313239 GEN4_TO_CONTROLLER_LOG:GEN4_DEBUG_INT_LOG_ATtiny1627 Payload End
9873 1718421313239 pro JtagIce3 [0x12] <<< 35 00 
9873 1718421313241 pro JtagIce3 [0x12] >>> 83 00 AD 00 00 00 
9873 1718421313241 GEN4_TO_CONTROLLER_LOG:GEN4_DEBUG_INT_LOG_ATtiny1627 Post:GetPC
9873 1718421313241 GEN4_TO_CONTROLLER_LOG:GEN4_DEBUG_INT_LOG_ATtiny1627 Return Value
9873 1718421313241 GEN4_TO_CONTROLLER_LOG:GEN4_DEBUG_INT_LOG_ATtiny1627 ad
9873 1718421313241 GEN4_TO_CONTROLLER_LOG:GEN4_DEBUG_INT_LOG_ATtiny1627 Return End

7033 1718421313241 GEN4_TO_CONTROLLER_LOG:GEN4_DEBUG_INT_LOG_ATtiny1627 Pre:GetPC
7033 1718421313241 GEN4_TO_CONTROLLER_LOG:GEN4_DEBUG_INT_LOG_ATtiny1627 Payload
7033 1718421313241 GEN4_TO_CONTROLLER_LOG:GEN4_DEBUG_INT_LOG_ATtiny1627 null
7033 1718421313241 GEN4_TO_CONTROLLER_LOG:GEN4_DEBUG_INT_LOG_ATtiny1627 Payload End
7033 1718421313241 pro JtagIce3 [0x12] <<< 35 00 
7033 1718421313242 pro JtagIce3 [0x12] >>> 83 00 AD 00 00 00 
7033 1718421313242 GEN4_TO_CONTROLLER_LOG:GEN4_DEBUG_INT_LOG_ATtiny1627 Post:GetPC
7033 1718421313242 GEN4_TO_CONTROLLER_LOG:GEN4_DEBUG_INT_LOG_ATtiny1627 Return Value
7033 1718421313242 GEN4_TO_CONTROLLER_LOG:GEN4_DEBUG_INT_LOG_ATtiny1627 ad
7033 1718421313242 GEN4_TO_CONTROLLER_LOG:GEN4_DEBUG_INT_LOG_ATtiny1627 Return End

7033 1718421313242 GEN4_TO_CONTROLLER_LOG:GEN4_DEBUG_INT_LOG_ATtiny1627 Pre:DebugReadTargetMemory
7033 1718421313242 GEN4_TO_CONTROLLER_LOG:GEN4_DEBUG_INT_LOG_ATtiny1627 Payload
7033 1718421313242 GEN4_TO_CONTROLLER_LOG:GEN4_DEBUG_INT_LOG_ATtiny1627 FileRegs
7033 1718421313242 GEN4_TO_CONTROLLER_LOG:GEN4_DEBUG_INT_LOG_ATtiny1627 3d
7033 1718421313242 GEN4_TO_CONTROLLER_LOG:GEN4_DEBUG_INT_LOG_ATtiny1627 3e
7033 1718421313242 GEN4_TO_CONTROLLER_LOG:GEN4_DEBUG_INT_LOG_ATtiny1627 Length = 2
7033 1718421313242 GEN4_TO_CONTROLLER_LOG:GEN4_DEBUG_INT_LOG_ATtiny1627 Payload End
7033 1718421313242 pro JtagIce3 [0x12] <<< 21 00 20 3D 00 00 00 02 00 00 00 
7033 1718421313243 pro JtagIce3 [0x12] >>> 84 00 E9 3F 00 
7033 1718421313243 GEN4_TO_CONTROLLER_LOG:GEN4_DEBUG_INT_LOG_ATtiny1627 Post:DebugReadTargetMemory
7033 1718421313243 GEN4_TO_CONTROLLER_LOG:GEN4_DEBUG_INT_LOG_ATtiny1627 Return Value
7033 1718421313243 GEN4_TO_CONTROLLER_LOG:GEN4_DEBUG_INT_LOG_ATtiny1627 true
7033 1718421313243 GEN4_TO_CONTROLLER_LOG:GEN4_DEBUG_INT_LOG_ATtiny1627 Return End

9639 1718421314244 GEN4_TO_CONTROLLER_LOG:GEN4_DEBUG_INT_LOG_ATtiny1627 Pre:DebugReadTargetMemory
9639 1718421314244 GEN4_TO_CONTROLLER_LOG:GEN4_DEBUG_INT_LOG_ATtiny1627 Payload
9639 1718421314244 GEN4_TO_CONTROLLER_LOG:GEN4_DEBUG_INT_LOG_ATtiny1627 FileRegs
9639 1718421314245 GEN4_TO_CONTROLLER_LOG:GEN4_DEBUG_INT_LOG_ATtiny1627 3f
9639 1718421314245 GEN4_TO_CONTROLLER_LOG:GEN4_DEBUG_INT_LOG_ATtiny1627 3f
9639 1718421314245 GEN4_TO_CONTROLLER_LOG:GEN4_DEBUG_INT_LOG_ATtiny1627 Length = 1
9639 1718421314245 GEN4_TO_CONTROLLER_LOG:GEN4_DEBUG_INT_LOG_ATtiny1627 Payload End
9639 1718421314245 pro JtagIce3 [0x12] <<< 21 00 20 3F 00 00 00 01 00 00 00 
9639 1718421314246 pro JtagIce3 [0x12] >>> 84 00 82 00 
9639 1718421314246 GEN4_TO_CONTROLLER_LOG:GEN4_DEBUG_INT_LOG_ATtiny1627 Post:DebugReadTargetMemory
9639 1718421314246 GEN4_TO_CONTROLLER_LOG:GEN4_DEBUG_INT_LOG_ATtiny1627 Return Value
9639 1718421314246 GEN4_TO_CONTROLLER_LOG:GEN4_DEBUG_INT_LOG_ATtiny1627 true
9639 1718421314246 GEN4_TO_CONTROLLER_LOG:GEN4_DEBUG_INT_LOG_ATtiny1627 Return End

9930 1718421315246 GEN4_TO_CONTROLLER_LOG:GEN4_DEBUG_INT_LOG_ATtiny1627 Pre:setTraceDescriptor
9930 1718421315246 GEN4_TO_CONTROLLER_LOG:GEN4_DEBUG_INT_LOG_ATtiny1627 Payload
9930 1718421315246 GEN4_TO_CONTROLLER_LOG:GEN4_DEBUG_INT_LOG_ATtiny1627 com.microchip.mplab.libs.RI4ToolsController.DataClasses.TraceDescriptor@7c8b9856
9930 1718421315246 GEN4_TO_CONTROLLER_LOG:GEN4_DEBUG_INT_LOG_ATtiny1627 Payload End
9930 1718421315246 GEN4_TO_CONTROLLER_LOG:GEN4_DEBUG_INT_LOG_ATtiny1627 Post:setTraceDescriptor
9930 1718421315246 GEN4_TO_CONTROLLER_LOG:GEN4_DEBUG_INT_LOG_ATtiny1627 Return Value
9930 1718421315246 GEN4_TO_CONTROLLER_LOG:GEN4_DEBUG_INT_LOG_ATtiny1627 none
9930 1718421315246 GEN4_TO_CONTROLLER_LOG:GEN4_DEBUG_INT_LOG_ATtiny1627 Return End

9930 1718421315246 GEN4_TO_CONTROLLER_LOG:GEN4_DEBUG_INT_LOG_ATtiny1627 Pre:GetPC
9930 1718421315246 GEN4_TO_CONTROLLER_LOG:GEN4_DEBUG_INT_LOG_ATtiny1627 Payload
9930 1718421315246 GEN4_TO_CONTROLLER_LOG:GEN4_DEBUG_INT_LOG_ATtiny1627 null
9930 1718421315246 GEN4_TO_CONTROLLER_LOG:GEN4_DEBUG_INT_LOG_ATtiny1627 Payload End
9930 1718421315246 pro JtagIce3 [0x12] <<< 35 00 
9930 1718421315247 pro JtagIce3 [0x12] >>> 83 00 AD 00 00 00 
9930 1718421315247 GEN4_TO_CONTROLLER_LOG:GEN4_DEBUG_INT_LOG_ATtiny1627 Post:GetPC
9930 1718421315247 GEN4_TO_CONTROLLER_LOG:GEN4_DEBUG_INT_LOG_ATtiny1627 Return Value
9930 1718421315247 GEN4_TO_CONTROLLER_LOG:GEN4_DEBUG_INT_LOG_ATtiny1627 ad
9930 1718421315247 GEN4_TO_CONTROLLER_LOG:GEN4_DEBUG_INT_LOG_ATtiny1627 Return End

9930 1718421315247 GEN4_TO_CONTROLLER_LOG:GEN4_DEBUG_INT_LOG_ATtiny1627 Pre:SetSoftwareBreakpoint
9930 1718421315247 GEN4_TO_CONTROLLER_LOG:GEN4_DEBUG_INT_LOG_ATtiny1627 Payload
9930 1718421315247 GEN4_TO_CONTROLLER_LOG:GEN4_DEBUG_INT_LOG_ATtiny1627 ad
9930 1718421315247 GEN4_TO_CONTROLLER_LOG:GEN4_DEBUG_INT_LOG_ATtiny1627 9598
9930 1718421315247 GEN4_TO_CONTROLLER_LOG:GEN4_DEBUG_INT_LOG_ATtiny1627 0
9930 1718421315247 GEN4_TO_CONTROLLER_LOG:GEN4_DEBUG_INT_LOG_ATtiny1627 Payload End
9930 1718421315247 pro JtagIce3 [0x12] <<< 44 00 5A 01 00 00 
9930 1718421315248 pro JtagIce3 [0x12] >>> 80 00 
9930 1718421315248 GEN4_TO_CONTROLLER_LOG:GEN4_DEBUG_INT_LOG_ATtiny1627 Post:SetSoftwareBreakpoint
9930 1718421315248 GEN4_TO_CONTROLLER_LOG:GEN4_DEBUG_INT_LOG_ATtiny1627 Return Value
9930 1718421315248 GEN4_TO_CONTROLLER_LOG:GEN4_DEBUG_INT_LOG_ATtiny1627 9598
9930 1718421315248 GEN4_TO_CONTROLLER_LOG:GEN4_DEBUG_INT_LOG_ATtiny1627 Return End

9930 1718421315248 GEN4_TO_CONTROLLER_LOG:GEN4_DEBUG_INT_LOG_ATtiny1627 Pre:StepTarget
9930 1718421315248 GEN4_TO_CONTROLLER_LOG:GEN4_DEBUG_INT_LOG_ATtiny1627 Payload
9930 1718421315248 GEN4_TO_CONTROLLER_LOG:GEN4_DEBUG_INT_LOG_ATtiny1627 0
9930 1718421315248 GEN4_TO_CONTROLLER_LOG:GEN4_DEBUG_INT_LOG_ATtiny1627 Payload End
9930 1718421315248 pro JtagIce3 [0x12] <<< 34 00 01 01 
9930 1718421315262 pro JtagIce3 [0x12] >>> 80 00 
9930 1718421315294 pro JtagIce3 ||| 0E 00 70 0A 12 40 AF 00 00 00 01 04 01 AB 
9930 1718421315296 GEN4_TO_CONTROLLER_LOG:GEN4_DEBUG_INT_LOG_ATtiny1627 Post:StepTarget
9930 1718421315296 GEN4_TO_CONTROLLER_LOG:GEN4_DEBUG_INT_LOG_ATtiny1627 Return Value
9930 1718421315296 GEN4_TO_CONTROLLER_LOG:GEN4_DEBUG_INT_LOG_ATtiny1627 true
9930 1718421315296 GEN4_TO_CONTROLLER_LOG:GEN4_DEBUG_INT_LOG_ATtiny1627 Return End

9930 1718421315296 GEN4_TO_CONTROLLER_LOG:GEN4_DEBUG_INT_LOG_ATtiny1627 Pre:SetSoftwareBreakpoint
9930 1718421315296 GEN4_TO_CONTROLLER_LOG:GEN4_DEBUG_INT_LOG_ATtiny1627 Payload
9930 1718421315296 GEN4_TO_CONTROLLER_LOG:GEN4_DEBUG_INT_LOG_ATtiny1627 ad
9930 1718421315296 GEN4_TO_CONTROLLER_LOG:GEN4_DEBUG_INT_LOG_ATtiny1627 9598
9930 1718421315296 GEN4_TO_CONTROLLER_LOG:GEN4_DEBUG_INT_LOG_ATtiny1627 1
9930 1718421315296 GEN4_TO_CONTROLLER_LOG:GEN4_DEBUG_INT_LOG_ATtiny1627 Payload End
9930 1718421315296 pro JtagIce3 [0x12] <<< 43 00 5A 01 00 00 
9930 1718421315297 pro JtagIce3 [0x12] >>> 80 00 
9930 1718421315297 GEN4_TO_CONTROLLER_LOG:GEN4_DEBUG_INT_LOG_ATtiny1627 Post:SetSoftwareBreakpoint
9930 1718421315297 GEN4_TO_CONTROLLER_LOG:GEN4_DEBUG_INT_LOG_ATtiny1627 Return Value
9930 1718421315297 GEN4_TO_CONTROLLER_LOG:GEN4_DEBUG_INT_LOG_ATtiny1627 9598
9930 1718421315297 GEN4_TO_CONTROLLER_LOG:GEN4_DEBUG_INT_LOG_ATtiny1627 Return End

9930 1718421315297 GEN4_TO_CONTROLLER_LOG:GEN4_DEBUG_INT_LOG_ATtiny1627 Pre:RunTarget
9930 1718421315297 GEN4_TO_CONTROLLER_LOG:GEN4_DEBUG_INT_LOG_ATtiny1627 Payload
9930 1718421315297 GEN4_TO_CONTROLLER_LOG:GEN4_DEBUG_INT_LOG_ATtiny1627 com.microchip.mplab.mdbcore.RI4Tool.atmelice.AIceDebugHandlerWithBP@5902e60
9930 1718421315297 GEN4_TO_CONTROLLER_LOG:GEN4_DEBUG_INT_LOG_ATtiny1627 Payload End
9930 1718421315297 pro JtagIce3 [0x12] <<< 32 00 
9930 1718421315311 pro JtagIce3 [0x12] >>> 80 00 
9930 1718421315312 GEN4_TO_CONTROLLER_LOG:GEN4_DEBUG_INT_LOG_ATtiny1627 Post:RunTarget
9930 1718421315312 GEN4_TO_CONTROLLER_LOG:GEN4_DEBUG_INT_LOG_ATtiny1627 Return Value
9930 1718421315312 GEN4_TO_CONTROLLER_LOG:GEN4_DEBUG_INT_LOG_ATtiny1627 true
9930 1718421315312 GEN4_TO_CONTROLLER_LOG:GEN4_DEBUG_INT_LOG_ATtiny1627 Return End
9930 1718421315569 pro JtagIce3 ||| 0E 00 71 0A 12 40 EF 00 00 00 01 04 20 AB 

9930 1718421315571 GEN4_TO_CONTROLLER_LOG:GEN4_DEBUG_INT_LOG_ATtiny1627 Pre:GetPC
9930 1718421315571 GEN4_TO_CONTROLLER_LOG:GEN4_DEBUG_INT_LOG_ATtiny1627 Payload
9930 1718421315571 GEN4_TO_CONTROLLER_LOG:GEN4_DEBUG_INT_LOG_ATtiny1627 null
9930 1718421315571 GEN4_TO_CONTROLLER_LOG:GEN4_DEBUG_INT_LOG_ATtiny1627 Payload End
9930 1718421315571 pro JtagIce3 [0x12] <<< 35 00 
9930 1718421315572 pro JtagIce3 [0x12] >>> 83 00 EF 00 00 00 
9930 1718421315572 GEN4_TO_CONTROLLER_LOG:GEN4_DEBUG_INT_LOG_ATtiny1627 Post:GetPC
9930 1718421315572 GEN4_TO_CONTROLLER_LOG:GEN4_DEBUG_INT_LOG_ATtiny1627 Return Value
9930 1718421315572 GEN4_TO_CONTROLLER_LOG:GEN4_DEBUG_INT_LOG_ATtiny1627 ef
9930 1718421315572 GEN4_TO_CONTROLLER_LOG:GEN4_DEBUG_INT_LOG_ATtiny1627 Return End

9633 1718421315572 GEN4_TO_CONTROLLER_LOG:GEN4_DEBUG_INT_LOG_ATtiny1627 Pre:GetPC
9633 1718421315572 GEN4_TO_CONTROLLER_LOG:GEN4_DEBUG_INT_LOG_ATtiny1627 Payload
9633 1718421315572 GEN4_TO_CONTROLLER_LOG:GEN4_DEBUG_INT_LOG_ATtiny1627 null
9633 1718421315572 GEN4_TO_CONTROLLER_LOG:GEN4_DEBUG_INT_LOG_ATtiny1627 Payload End
9633 1718421315572 pro JtagIce3 [0x12] <<< 35 00 
9633 1718421315573 pro JtagIce3 [0x12] >>> 83 00 EF 00 00 00 
9633 1718421315573 GEN4_TO_CONTROLLER_LOG:GEN4_DEBUG_INT_LOG_ATtiny1627 Post:GetPC
9633 1718421315573 GEN4_TO_CONTROLLER_LOG:GEN4_DEBUG_INT_LOG_ATtiny1627 Return Value
9633 1718421315573 GEN4_TO_CONTROLLER_LOG:GEN4_DEBUG_INT_LOG_ATtiny1627 ef
9633 1718421315573 GEN4_TO_CONTROLLER_LOG:GEN4_DEBUG_INT_LOG_ATtiny1627 Return End

9633 1718421315574 GEN4_TO_CONTROLLER_LOG:GEN4_DEBUG_INT_LOG_ATtiny1627 Pre:DebugReadTargetMemory
9633 1718421315574 GEN4_TO_CONTROLLER_LOG:GEN4_DEBUG_INT_LOG_ATtiny1627 Payload
9633 1718421315574 GEN4_TO_CONTROLLER_LOG:GEN4_DEBUG_INT_LOG_ATtiny1627 FileRegs
9633 1718421315574 GEN4_TO_CONTROLLER_LOG:GEN4_DEBUG_INT_LOG_ATtiny1627 3d
9633 1718421315574 GEN4_TO_CONTROLLER_LOG:GEN4_DEBUG_INT_LOG_ATtiny1627 3e
9633 1718421315574 GEN4_TO_CONTROLLER_LOG:GEN4_DEBUG_INT_LOG_ATtiny1627 Length = 2
9633 1718421315574 GEN4_TO_CONTROLLER_LOG:GEN4_DEBUG_INT_LOG_ATtiny1627 Payload End
9633 1718421315574 pro JtagIce3 [0x12] <<< 21 00 20 3D 00 00 00 02 00 00 00 
9633 1718421315575 pro JtagIce3 [0x12] >>> 84 00 E9 3F 00 
9633 1718421315575 GEN4_TO_CONTROLLER_LOG:GEN4_DEBUG_INT_LOG_ATtiny1627 Post:DebugReadTargetMemory
9633 1718421315575 GEN4_TO_CONTROLLER_LOG:GEN4_DEBUG_INT_LOG_ATtiny1627 Return Value
9633 1718421315575 GEN4_TO_CONTROLLER_LOG:GEN4_DEBUG_INT_LOG_ATtiny1627 true
9633 1718421315575 GEN4_TO_CONTROLLER_LOG:GEN4_DEBUG_INT_LOG_ATtiny1627 Return End

9934 1718421316513 GEN4_TO_CONTROLLER_LOG:GEN4_DEBUG_INT_LOG_ATtiny1627 Pre:setTraceDescriptor
9934 1718421316513 GEN4_TO_CONTROLLER_LOG:GEN4_DEBUG_INT_LOG_ATtiny1627 Payload
9934 1718421316513 GEN4_TO_CONTROLLER_LOG:GEN4_DEBUG_INT_LOG_ATtiny1627 com.microchip.mplab.libs.RI4ToolsController.DataClasses.TraceDescriptor@5a9b1229
9934 1718421316513 GEN4_TO_CONTROLLER_LOG:GEN4_DEBUG_INT_LOG_ATtiny1627 Payload End
9934 1718421316513 GEN4_TO_CONTROLLER_LOG:GEN4_DEBUG_INT_LOG_ATtiny1627 Post:setTraceDescriptor
9934 1718421316513 GEN4_TO_CONTROLLER_LOG:GEN4_DEBUG_INT_LOG_ATtiny1627 Return Value
9934 1718421316513 GEN4_TO_CONTROLLER_LOG:GEN4_DEBUG_INT_LOG_ATtiny1627 none
9934 1718421316513 GEN4_TO_CONTROLLER_LOG:GEN4_DEBUG_INT_LOG_ATtiny1627 Return End

9934 1718421316513 GEN4_TO_CONTROLLER_LOG:GEN4_DEBUG_INT_LOG_ATtiny1627 Pre:GetPC
9934 1718421316513 GEN4_TO_CONTROLLER_LOG:GEN4_DEBUG_INT_LOG_ATtiny1627 Payload
9934 1718421316513 GEN4_TO_CONTROLLER_LOG:GEN4_DEBUG_INT_LOG_ATtiny1627 null
9934 1718421316513 GEN4_TO_CONTROLLER_LOG:GEN4_DEBUG_INT_LOG_ATtiny1627 Payload End
9934 1718421316513 pro JtagIce3 [0x12] <<< 35 00 
9934 1718421316515 pro JtagIce3 [0x12] >>> 83 00 EF 00 00 00 
9934 1718421316515 GEN4_TO_CONTROLLER_LOG:GEN4_DEBUG_INT_LOG_ATtiny1627 Post:GetPC
9934 1718421316515 GEN4_TO_CONTROLLER_LOG:GEN4_DEBUG_INT_LOG_ATtiny1627 Return Value
9934 1718421316515 GEN4_TO_CONTROLLER_LOG:GEN4_DEBUG_INT_LOG_ATtiny1627 ef
9934 1718421316515 GEN4_TO_CONTROLLER_LOG:GEN4_DEBUG_INT_LOG_ATtiny1627 Return End

9934 1718421316515 GEN4_TO_CONTROLLER_LOG:GEN4_DEBUG_INT_LOG_ATtiny1627 Pre:SetSoftwareBreakpoint
9934 1718421316515 GEN4_TO_CONTROLLER_LOG:GEN4_DEBUG_INT_LOG_ATtiny1627 Payload
9934 1718421316515 GEN4_TO_CONTROLLER_LOG:GEN4_DEBUG_INT_LOG_ATtiny1627 ef
9934 1718421316515 GEN4_TO_CONTROLLER_LOG:GEN4_DEBUG_INT_LOG_ATtiny1627 9598
9934 1718421316515 GEN4_TO_CONTROLLER_LOG:GEN4_DEBUG_INT_LOG_ATtiny1627 0
9934 1718421316515 GEN4_TO_CONTROLLER_LOG:GEN4_DEBUG_INT_LOG_ATtiny1627 Payload End
9934 1718421316515 pro JtagIce3 [0x12] <<< 44 00 DE 01 00 00 
9934 1718421316516 pro JtagIce3 [0x12] >>> 80 00 
9934 1718421316516 GEN4_TO_CONTROLLER_LOG:GEN4_DEBUG_INT_LOG_ATtiny1627 Post:SetSoftwareBreakpoint
9934 1718421316516 GEN4_TO_CONTROLLER_LOG:GEN4_DEBUG_INT_LOG_ATtiny1627 Return Value
9934 1718421316516 GEN4_TO_CONTROLLER_LOG:GEN4_DEBUG_INT_LOG_ATtiny1627 9598
9934 1718421316516 GEN4_TO_CONTROLLER_LOG:GEN4_DEBUG_INT_LOG_ATtiny1627 Return End

9934 1718421316516 GEN4_TO_CONTROLLER_LOG:GEN4_DEBUG_INT_LOG_ATtiny1627 Pre:StepTarget
9934 1718421316516 GEN4_TO_CONTROLLER_LOG:GEN4_DEBUG_INT_LOG_ATtiny1627 Payload
9934 1718421316516 GEN4_TO_CONTROLLER_LOG:GEN4_DEBUG_INT_LOG_ATtiny1627 0
9934 1718421316516 GEN4_TO_CONTROLLER_LOG:GEN4_DEBUG_INT_LOG_ATtiny1627 Payload End
9934 1718421316516 pro JtagIce3 [0x12] <<< 34 00 01 01 
9934 1718421316530 pro JtagIce3 [0x12] >>> 80 00 
9934 1718421316532 pro JtagIce3 ||| 0E 00 72 0A 12 40 F0 00 00 00 01 04 01 AB 
9934 1718421316533 GEN4_TO_CONTROLLER_LOG:GEN4_DEBUG_INT_LOG_ATtiny1627 Post:StepTarget
9934 1718421316533 GEN4_TO_CONTROLLER_LOG:GEN4_DEBUG_INT_LOG_ATtiny1627 Return Value
9934 1718421316533 GEN4_TO_CONTROLLER_LOG:GEN4_DEBUG_INT_LOG_ATtiny1627 true
9934 1718421316533 GEN4_TO_CONTROLLER_LOG:GEN4_DEBUG_INT_LOG_ATtiny1627 Return End

9934 1718421316533 GEN4_TO_CONTROLLER_LOG:GEN4_DEBUG_INT_LOG_ATtiny1627 Pre:SetSoftwareBreakpoint
9934 1718421316533 GEN4_TO_CONTROLLER_LOG:GEN4_DEBUG_INT_LOG_ATtiny1627 Payload
9934 1718421316533 GEN4_TO_CONTROLLER_LOG:GEN4_DEBUG_INT_LOG_ATtiny1627 ef
9934 1718421316533 GEN4_TO_CONTROLLER_LOG:GEN4_DEBUG_INT_LOG_ATtiny1627 9598
9934 1718421316533 GEN4_TO_CONTROLLER_LOG:GEN4_DEBUG_INT_LOG_ATtiny1627 1
9934 1718421316533 GEN4_TO_CONTROLLER_LOG:GEN4_DEBUG_INT_LOG_ATtiny1627 Payload End
9934 1718421316533 pro JtagIce3 [0x12] <<< 43 00 DE 01 00 00 
9934 1718421316534 pro JtagIce3 [0x12] >>> 80 00 
9934 1718421316534 GEN4_TO_CONTROLLER_LOG:GEN4_DEBUG_INT_LOG_ATtiny1627 Post:SetSoftwareBreakpoint
9934 1718421316534 GEN4_TO_CONTROLLER_LOG:GEN4_DEBUG_INT_LOG_ATtiny1627 Return Value
9934 1718421316534 GEN4_TO_CONTROLLER_LOG:GEN4_DEBUG_INT_LOG_ATtiny1627 9598
9934 1718421316534 GEN4_TO_CONTROLLER_LOG:GEN4_DEBUG_INT_LOG_ATtiny1627 Return End

9934 1718421316534 GEN4_TO_CONTROLLER_LOG:GEN4_DEBUG_INT_LOG_ATtiny1627 Pre:RunTarget
9934 1718421316534 GEN4_TO_CONTROLLER_LOG:GEN4_DEBUG_INT_LOG_ATtiny1627 Payload
9934 1718421316534 GEN4_TO_CONTROLLER_LOG:GEN4_DEBUG_INT_LOG_ATtiny1627 com.microchip.mplab.mdbcore.RI4Tool.atmelice.AIceDebugHandlerWithBP@5902e60
9934 1718421316534 GEN4_TO_CONTROLLER_LOG:GEN4_DEBUG_INT_LOG_ATtiny1627 Payload End
9934 1718421316534 pro JtagIce3 [0x12] <<< 32 00 
9934 1718421316548 pro JtagIce3 [0x12] >>> 80 00 
9934 1718421316549 GEN4_TO_CONTROLLER_LOG:GEN4_DEBUG_INT_LOG_ATtiny1627 Post:RunTarget
9934 1718421316549 GEN4_TO_CONTROLLER_LOG:GEN4_DEBUG_INT_LOG_ATtiny1627 Return Value
9934 1718421316549 GEN4_TO_CONTROLLER_LOG:GEN4_DEBUG_INT_LOG_ATtiny1627 true
9934 1718421316549 GEN4_TO_CONTROLLER_LOG:GEN4_DEBUG_INT_LOG_ATtiny1627 Return End
9934 1718421316806 pro JtagIce3 ||| 0E 00 73 0A 12 40 08 01 00 00 01 04 20 AB 

9934 1718421316809 GEN4_TO_CONTROLLER_LOG:GEN4_DEBUG_INT_LOG_ATtiny1627 Pre:GetPC
9934 1718421316809 GEN4_TO_CONTROLLER_LOG:GEN4_DEBUG_INT_LOG_ATtiny1627 Payload
9934 1718421316809 GEN4_TO_CONTROLLER_LOG:GEN4_DEBUG_INT_LOG_ATtiny1627 null
9934 1718421316809 GEN4_TO_CONTROLLER_LOG:GEN4_DEBUG_INT_LOG_ATtiny1627 Payload End
9934 1718421316809 pro JtagIce3 [0x12] <<< 35 00 
9934 1718421316810 pro JtagIce3 [0x12] >>> 83 00 08 01 00 00 
9934 1718421316810 GEN4_TO_CONTROLLER_LOG:GEN4_DEBUG_INT_LOG_ATtiny1627 Post:GetPC
9934 1718421316810 GEN4_TO_CONTROLLER_LOG:GEN4_DEBUG_INT_LOG_ATtiny1627 Return Value
9934 1718421316810 GEN4_TO_CONTROLLER_LOG:GEN4_DEBUG_INT_LOG_ATtiny1627 108
9934 1718421316810 GEN4_TO_CONTROLLER_LOG:GEN4_DEBUG_INT_LOG_ATtiny1627 Return End

9593 1718421316810 GEN4_TO_CONTROLLER_LOG:GEN4_DEBUG_INT_LOG_ATtiny1627 Pre:GetPC
9593 1718421316810 GEN4_TO_CONTROLLER_LOG:GEN4_DEBUG_INT_LOG_ATtiny1627 Payload
9593 1718421316810 GEN4_TO_CONTROLLER_LOG:GEN4_DEBUG_INT_LOG_ATtiny1627 null
9593 1718421316810 GEN4_TO_CONTROLLER_LOG:GEN4_DEBUG_INT_LOG_ATtiny1627 Payload End
9593 1718421316810 pro JtagIce3 [0x12] <<< 35 00 
9593 1718421316812 pro JtagIce3 [0x12] >>> 83 00 08 01 00 00 
9593 1718421316812 GEN4_TO_CONTROLLER_LOG:GEN4_DEBUG_INT_LOG_ATtiny1627 Post:GetPC
9593 1718421316812 GEN4_TO_CONTROLLER_LOG:GEN4_DEBUG_INT_LOG_ATtiny1627 Return Value
9593 1718421316812 GEN4_TO_CONTROLLER_LOG:GEN4_DEBUG_INT_LOG_ATtiny1627 108
9593 1718421316812 GEN4_TO_CONTROLLER_LOG:GEN4_DEBUG_INT_LOG_ATtiny1627 Return End

9593 1718421316812 GEN4_TO_CONTROLLER_LOG:GEN4_DEBUG_INT_LOG_ATtiny1627 Pre:DebugReadTargetMemory
9593 1718421316812 GEN4_TO_CONTROLLER_LOG:GEN4_DEBUG_INT_LOG_ATtiny1627 Payload
9593 1718421316812 GEN4_TO_CONTROLLER_LOG:GEN4_DEBUG_INT_LOG_ATtiny1627 FileRegs
9593 1718421316812 GEN4_TO_CONTROLLER_LOG:GEN4_DEBUG_INT_LOG_ATtiny1627 3d
9593 1718421316812 GEN4_TO_CONTROLLER_LOG:GEN4_DEBUG_INT_LOG_ATtiny1627 3e
9593 1718421316812 GEN4_TO_CONTROLLER_LOG:GEN4_DEBUG_INT_LOG_ATtiny1627 Length = 2
9593 1718421316812 GEN4_TO_CONTROLLER_LOG:GEN4_DEBUG_INT_LOG_ATtiny1627 Payload End
9593 1718421316812 pro JtagIce3 [0x12] <<< 21 00 20 3D 00 00 00 02 00 00 00 
9593 1718421316813 pro JtagIce3 [0x12] >>> 84 00 E9 3F 00 
9593 1718421316813 GEN4_TO_CONTROLLER_LOG:GEN4_DEBUG_INT_LOG_ATtiny1627 Post:DebugReadTargetMemory
9593 1718421316813 GEN4_TO_CONTROLLER_LOG:GEN4_DEBUG_INT_LOG_ATtiny1627 Return Value
9593 1718421316813 GEN4_TO_CONTROLLER_LOG:GEN4_DEBUG_INT_LOG_ATtiny1627 true
9593 1718421316813 GEN4_TO_CONTROLLER_LOG:GEN4_DEBUG_INT_LOG_ATtiny1627 Return End

9593 1718421316815 GEN4_TO_CONTROLLER_LOG:GEN4_DEBUG_INT_LOG_ATtiny1627 Pre:DebugReadTargetMemory
9593 1718421316815 GEN4_TO_CONTROLLER_LOG:GEN4_DEBUG_INT_LOG_ATtiny1627 Payload
9593 1718421316815 GEN4_TO_CONTROLLER_LOG:GEN4_DEBUG_INT_LOG_ATtiny1627 FileRegs
9593 1718421316815 GEN4_TO_CONTROLLER_LOG:GEN4_DEBUG_INT_LOG_ATtiny1627 3f
9593 1718421316815 GEN4_TO_CONTROLLER_LOG:GEN4_DEBUG_INT_LOG_ATtiny1627 3f
9593 1718421316815 GEN4_TO_CONTROLLER_LOG:GEN4_DEBUG_INT_LOG_ATtiny1627 Length = 1
9593 1718421316815 GEN4_TO_CONTROLLER_LOG:GEN4_DEBUG_INT_LOG_ATtiny1627 Payload End
9593 1718421316815 pro JtagIce3 [0x12] <<< 21 00 20 3F 00 00 00 01 00 00 00 
9593 1718421316817 pro JtagIce3 [0x12] >>> 84 00 82 00 
9593 1718421316817 GEN4_TO_CONTROLLER_LOG:GEN4_DEBUG_INT_LOG_ATtiny1627 Post:DebugReadTargetMemory
9593 1718421316817 GEN4_TO_CONTROLLER_LOG:GEN4_DEBUG_INT_LOG_ATtiny1627 Return Value
9593 1718421316817 GEN4_TO_CONTROLLER_LOG:GEN4_DEBUG_INT_LOG_ATtiny1627 true
9593 1718421316817 GEN4_TO_CONTROLLER_LOG:GEN4_DEBUG_INT_LOG_ATtiny1627 Return End

9937 1718421317548 GEN4_TO_CONTROLLER_LOG:GEN4_DEBUG_INT_LOG_ATtiny1627 Pre:setTraceDescriptor
9937 1718421317548 GEN4_TO_CONTROLLER_LOG:GEN4_DEBUG_INT_LOG_ATtiny1627 Payload
9937 1718421317548 GEN4_TO_CONTROLLER_LOG:GEN4_DEBUG_INT_LOG_ATtiny1627 com.microchip.mplab.libs.RI4ToolsController.DataClasses.TraceDescriptor@1998ac
9937 1718421317548 GEN4_TO_CONTROLLER_LOG:GEN4_DEBUG_INT_LOG_ATtiny1627 Payload End
9937 1718421317548 GEN4_TO_CONTROLLER_LOG:GEN4_DEBUG_INT_LOG_ATtiny1627 Post:setTraceDescriptor
9937 1718421317548 GEN4_TO_CONTROLLER_LOG:GEN4_DEBUG_INT_LOG_ATtiny1627 Return Value
9937 1718421317548 GEN4_TO_CONTROLLER_LOG:GEN4_DEBUG_INT_LOG_ATtiny1627 none
9937 1718421317548 GEN4_TO_CONTROLLER_LOG:GEN4_DEBUG_INT_LOG_ATtiny1627 Return End

9937 1718421317548 GEN4_TO_CONTROLLER_LOG:GEN4_DEBUG_INT_LOG_ATtiny1627 Pre:GetPC
9937 1718421317548 GEN4_TO_CONTROLLER_LOG:GEN4_DEBUG_INT_LOG_ATtiny1627 Payload
9937 1718421317548 GEN4_TO_CONTROLLER_LOG:GEN4_DEBUG_INT_LOG_ATtiny1627 null
9937 1718421317548 GEN4_TO_CONTROLLER_LOG:GEN4_DEBUG_INT_LOG_ATtiny1627 Payload End
9937 1718421317548 pro JtagIce3 [0x12] <<< 35 00 
9937 1718421317550 pro JtagIce3 [0x12] >>> 83 00 08 01 00 00 
9937 1718421317550 GEN4_TO_CONTROLLER_LOG:GEN4_DEBUG_INT_LOG_ATtiny1627 Post:GetPC
9937 1718421317550 GEN4_TO_CONTROLLER_LOG:GEN4_DEBUG_INT_LOG_ATtiny1627 Return Value
9937 1718421317550 GEN4_TO_CONTROLLER_LOG:GEN4_DEBUG_INT_LOG_ATtiny1627 108
9937 1718421317550 GEN4_TO_CONTROLLER_LOG:GEN4_DEBUG_INT_LOG_ATtiny1627 Return End

9937 1718421317550 GEN4_TO_CONTROLLER_LOG:GEN4_DEBUG_INT_LOG_ATtiny1627 Pre:SetSoftwareBreakpoint
9937 1718421317550 GEN4_TO_CONTROLLER_LOG:GEN4_DEBUG_INT_LOG_ATtiny1627 Payload
9937 1718421317550 GEN4_TO_CONTROLLER_LOG:GEN4_DEBUG_INT_LOG_ATtiny1627 108
9937 1718421317550 GEN4_TO_CONTROLLER_LOG:GEN4_DEBUG_INT_LOG_ATtiny1627 9598
9937 1718421317550 GEN4_TO_CONTROLLER_LOG:GEN4_DEBUG_INT_LOG_ATtiny1627 0
9937 1718421317550 GEN4_TO_CONTROLLER_LOG:GEN4_DEBUG_INT_LOG_ATtiny1627 Payload End
9937 1718421317550 pro JtagIce3 [0x12] <<< 44 00 10 02 00 00 
9937 1718421317552 pro JtagIce3 [0x12] >>> 80 00 
9937 1718421317552 GEN4_TO_CONTROLLER_LOG:GEN4_DEBUG_INT_LOG_ATtiny1627 Post:SetSoftwareBreakpoint
9937 1718421317552 GEN4_TO_CONTROLLER_LOG:GEN4_DEBUG_INT_LOG_ATtiny1627 Return Value
9937 1718421317552 GEN4_TO_CONTROLLER_LOG:GEN4_DEBUG_INT_LOG_ATtiny1627 9598
9937 1718421317552 GEN4_TO_CONTROLLER_LOG:GEN4_DEBUG_INT_LOG_ATtiny1627 Return End

9937 1718421317552 GEN4_TO_CONTROLLER_LOG:GEN4_DEBUG_INT_LOG_ATtiny1627 Pre:StepTarget
9937 1718421317552 GEN4_TO_CONTROLLER_LOG:GEN4_DEBUG_INT_LOG_ATtiny1627 Payload
9937 1718421317552 GEN4_TO_CONTROLLER_LOG:GEN4_DEBUG_INT_LOG_ATtiny1627 0
9937 1718421317552 GEN4_TO_CONTROLLER_LOG:GEN4_DEBUG_INT_LOG_ATtiny1627 Payload End
9937 1718421317552 pro JtagIce3 [0x12] <<< 34 00 01 01 
9937 1718421317566 pro JtagIce3 [0x12] >>> 80 00 
9937 1718421317604 pro JtagIce3 ||| 0E 00 74 0A 12 40 09 01 00 00 01 04 01 AB 
9937 1718421317605 GEN4_TO_CONTROLLER_LOG:GEN4_DEBUG_INT_LOG_ATtiny1627 Post:StepTarget
9937 1718421317605 GEN4_TO_CONTROLLER_LOG:GEN4_DEBUG_INT_LOG_ATtiny1627 Return Value
9937 1718421317605 GEN4_TO_CONTROLLER_LOG:GEN4_DEBUG_INT_LOG_ATtiny1627 true
9937 1718421317605 GEN4_TO_CONTROLLER_LOG:GEN4_DEBUG_INT_LOG_ATtiny1627 Return End

9937 1718421317605 GEN4_TO_CONTROLLER_LOG:GEN4_DEBUG_INT_LOG_ATtiny1627 Pre:SetSoftwareBreakpoint
9937 1718421317605 GEN4_TO_CONTROLLER_LOG:GEN4_DEBUG_INT_LOG_ATtiny1627 Payload
9937 1718421317605 GEN4_TO_CONTROLLER_LOG:GEN4_DEBUG_INT_LOG_ATtiny1627 108
9937 1718421317605 GEN4_TO_CONTROLLER_LOG:GEN4_DEBUG_INT_LOG_ATtiny1627 9598
9937 1718421317605 GEN4_TO_CONTROLLER_LOG:GEN4_DEBUG_INT_LOG_ATtiny1627 1
9937 1718421317605 GEN4_TO_CONTROLLER_LOG:GEN4_DEBUG_INT_LOG_ATtiny1627 Payload End
9937 1718421317605 pro JtagIce3 [0x12] <<< 43 00 10 02 00 00 
9937 1718421317606 pro JtagIce3 [0x12] >>> 80 00 
9937 1718421317606 GEN4_TO_CONTROLLER_LOG:GEN4_DEBUG_INT_LOG_ATtiny1627 Post:SetSoftwareBreakpoint
9937 1718421317606 GEN4_TO_CONTROLLER_LOG:GEN4_DEBUG_INT_LOG_ATtiny1627 Return Value
9937 1718421317606 GEN4_TO_CONTROLLER_LOG:GEN4_DEBUG_INT_LOG_ATtiny1627 9598
9937 1718421317606 GEN4_TO_CONTROLLER_LOG:GEN4_DEBUG_INT_LOG_ATtiny1627 Return End

9937 1718421317606 GEN4_TO_CONTROLLER_LOG:GEN4_DEBUG_INT_LOG_ATtiny1627 Pre:RunTarget
9937 1718421317606 GEN4_TO_CONTROLLER_LOG:GEN4_DEBUG_INT_LOG_ATtiny1627 Payload
9937 1718421317606 GEN4_TO_CONTROLLER_LOG:GEN4_DEBUG_INT_LOG_ATtiny1627 com.microchip.mplab.mdbcore.RI4Tool.atmelice.AIceDebugHandlerWithBP@5902e60
9937 1718421317606 GEN4_TO_CONTROLLER_LOG:GEN4_DEBUG_INT_LOG_ATtiny1627 Payload End
9937 1718421317606 pro JtagIce3 [0x12] <<< 32 00 
9937 1718421317620 pro JtagIce3 [0x12] >>> 80 00 
9937 1718421317621 GEN4_TO_CONTROLLER_LOG:GEN4_DEBUG_INT_LOG_ATtiny1627 Post:RunTarget
9937 1718421317621 GEN4_TO_CONTROLLER_LOG:GEN4_DEBUG_INT_LOG_ATtiny1627 Return Value
9937 1718421317621 GEN4_TO_CONTROLLER_LOG:GEN4_DEBUG_INT_LOG_ATtiny1627 true
9937 1718421317621 GEN4_TO_CONTROLLER_LOG:GEN4_DEBUG_INT_LOG_ATtiny1627 Return End
9937 1718421317879 pro JtagIce3 ||| 0E 00 75 0A 12 40 78 00 00 00 01 04 20 AB 

9937 1718421317882 GEN4_TO_CONTROLLER_LOG:GEN4_DEBUG_INT_LOG_ATtiny1627 Pre:GetPC
9937 1718421317882 GEN4_TO_CONTROLLER_LOG:GEN4_DEBUG_INT_LOG_ATtiny1627 Payload
9937 1718421317882 GEN4_TO_CONTROLLER_LOG:GEN4_DEBUG_INT_LOG_ATtiny1627 null
9937 1718421317882 GEN4_TO_CONTROLLER_LOG:GEN4_DEBUG_INT_LOG_ATtiny1627 Payload End
9937 1718421317882 pro JtagIce3 [0x12] <<< 35 00 
9937 1718421317883 pro JtagIce3 [0x12] >>> 83 00 78 00 00 00 
9937 1718421317883 GEN4_TO_CONTROLLER_LOG:GEN4_DEBUG_INT_LOG_ATtiny1627 Post:GetPC
9937 1718421317883 GEN4_TO_CONTROLLER_LOG:GEN4_DEBUG_INT_LOG_ATtiny1627 Return Value
9937 1718421317883 GEN4_TO_CONTROLLER_LOG:GEN4_DEBUG_INT_LOG_ATtiny1627 78
9937 1718421317883 GEN4_TO_CONTROLLER_LOG:GEN4_DEBUG_INT_LOG_ATtiny1627 Return End

9858 1718421317884 GEN4_TO_CONTROLLER_LOG:GEN4_DEBUG_INT_LOG_ATtiny1627 Pre:GetPC
9858 1718421317884 GEN4_TO_CONTROLLER_LOG:GEN4_DEBUG_INT_LOG_ATtiny1627 Payload
9858 1718421317884 GEN4_TO_CONTROLLER_LOG:GEN4_DEBUG_INT_LOG_ATtiny1627 null
9858 1718421317884 GEN4_TO_CONTROLLER_LOG:GEN4_DEBUG_INT_LOG_ATtiny1627 Payload End
9858 1718421317884 pro JtagIce3 [0x12] <<< 35 00 
9858 1718421317885 pro JtagIce3 [0x12] >>> 83 00 78 00 00 00 
9858 1718421317885 GEN4_TO_CONTROLLER_LOG:GEN4_DEBUG_INT_LOG_ATtiny1627 Post:GetPC
9858 1718421317885 GEN4_TO_CONTROLLER_LOG:GEN4_DEBUG_INT_LOG_ATtiny1627 Return Value
9858 1718421317885 GEN4_TO_CONTROLLER_LOG:GEN4_DEBUG_INT_LOG_ATtiny1627 78
9858 1718421317885 GEN4_TO_CONTROLLER_LOG:GEN4_DEBUG_INT_LOG_ATtiny1627 Return End

9858 1718421317886 GEN4_TO_CONTROLLER_LOG:GEN4_DEBUG_INT_LOG_ATtiny1627 Pre:DebugReadTargetMemory
9858 1718421317886 GEN4_TO_CONTROLLER_LOG:GEN4_DEBUG_INT_LOG_ATtiny1627 Payload
9858 1718421317886 GEN4_TO_CONTROLLER_LOG:GEN4_DEBUG_INT_LOG_ATtiny1627 FileRegs
9858 1718421317886 GEN4_TO_CONTROLLER_LOG:GEN4_DEBUG_INT_LOG_ATtiny1627 3d
9858 1718421317886 GEN4_TO_CONTROLLER_LOG:GEN4_DEBUG_INT_LOG_ATtiny1627 3e
9858 1718421317886 GEN4_TO_CONTROLLER_LOG:GEN4_DEBUG_INT_LOG_ATtiny1627 Length = 2
9858 1718421317886 GEN4_TO_CONTROLLER_LOG:GEN4_DEBUG_INT_LOG_ATtiny1627 Payload End
9858 1718421317886 pro JtagIce3 [0x12] <<< 21 00 20 3D 00 00 00 02 00 00 00 
9858 1718421317887 pro JtagIce3 [0x12] >>> 84 00 FD 3F 00 
9858 1718421317887 GEN4_TO_CONTROLLER_LOG:GEN4_DEBUG_INT_LOG_ATtiny1627 Post:DebugReadTargetMemory
9858 1718421317887 GEN4_TO_CONTROLLER_LOG:GEN4_DEBUG_INT_LOG_ATtiny1627 Return Value
9858 1718421317887 GEN4_TO_CONTROLLER_LOG:GEN4_DEBUG_INT_LOG_ATtiny1627 true
9858 1718421317887 GEN4_TO_CONTROLLER_LOG:GEN4_DEBUG_INT_LOG_ATtiny1627 Return End

9858 1718421317896 GEN4_TO_CONTROLLER_LOG:GEN4_DEBUG_INT_LOG_ATtiny1627 Pre:DebugReadTargetMemory
9858 1718421317896 GEN4_TO_CONTROLLER_LOG:GEN4_DEBUG_INT_LOG_ATtiny1627 Payload
9858 1718421317896 GEN4_TO_CONTROLLER_LOG:GEN4_DEBUG_INT_LOG_ATtiny1627 FileRegs
9858 1718421317896 GEN4_TO_CONTROLLER_LOG:GEN4_DEBUG_INT_LOG_ATtiny1627 3f
9858 1718421317896 GEN4_TO_CONTROLLER_LOG:GEN4_DEBUG_INT_LOG_ATtiny1627 3f
9858 1718421317896 GEN4_TO_CONTROLLER_LOG:GEN4_DEBUG_INT_LOG_ATtiny1627 Length = 1
9858 1718421317896 GEN4_TO_CONTROLLER_LOG:GEN4_DEBUG_INT_LOG_ATtiny1627 Payload End
9858 1718421317896 pro JtagIce3 [0x12] <<< 21 00 20 3F 00 00 00 01 00 00 00 
9858 1718421317898 pro JtagIce3 [0x12] >>> 84 00 02 00 
9858 1718421317898 GEN4_TO_CONTROLLER_LOG:GEN4_DEBUG_INT_LOG_ATtiny1627 Post:DebugReadTargetMemory
9858 1718421317898 GEN4_TO_CONTROLLER_LOG:GEN4_DEBUG_INT_LOG_ATtiny1627 Return Value
9858 1718421317898 GEN4_TO_CONTROLLER_LOG:GEN4_DEBUG_INT_LOG_ATtiny1627 true
9858 1718421317898 GEN4_TO_CONTROLLER_LOG:GEN4_DEBUG_INT_LOG_ATtiny1627 Return End

9858 1718421318886 GEN4_TO_CONTROLLER_LOG:GEN4_DEBUG_INT_LOG_ATtiny1627 Pre:DebugReadTargetMemory
9858 1718421318886 GEN4_TO_CONTROLLER_LOG:GEN4_DEBUG_INT_LOG_ATtiny1627 Payload
9858 1718421318886 GEN4_TO_CONTROLLER_LOG:GEN4_DEBUG_INT_LOG_ATtiny1627 FileRegs
9858 1718421318886 GEN4_TO_CONTROLLER_LOG:GEN4_DEBUG_INT_LOG_ATtiny1627 3f
9858 1718421318886 GEN4_TO_CONTROLLER_LOG:GEN4_DEBUG_INT_LOG_ATtiny1627 3f
9858 1718421318886 GEN4_TO_CONTROLLER_LOG:GEN4_DEBUG_INT_LOG_ATtiny1627 Length = 1
9858 1718421318886 GEN4_TO_CONTROLLER_LOG:GEN4_DEBUG_INT_LOG_ATtiny1627 Payload End
9858 1718421318886 pro JtagIce3 [0x12] <<< 21 00 20 3F 00 00 00 01 00 00 00 
9858 1718421318887 pro JtagIce3 [0x12] >>> 84 00 02 00 
9858 1718421318887 GEN4_TO_CONTROLLER_LOG:GEN4_DEBUG_INT_LOG_ATtiny1627 Post:DebugReadTargetMemory
9858 1718421318887 GEN4_TO_CONTROLLER_LOG:GEN4_DEBUG_INT_LOG_ATtiny1627 Return Value
9858 1718421318887 GEN4_TO_CONTROLLER_LOG:GEN4_DEBUG_INT_LOG_ATtiny1627 true
9858 1718421318887 GEN4_TO_CONTROLLER_LOG:GEN4_DEBUG_INT_LOG_ATtiny1627 Return End

9940 1718421318889 GEN4_TO_CONTROLLER_LOG:GEN4_DEBUG_INT_LOG_ATtiny1627 Pre:setTraceDescriptor
9940 1718421318889 GEN4_TO_CONTROLLER_LOG:GEN4_DEBUG_INT_LOG_ATtiny1627 Payload
9940 1718421318889 GEN4_TO_CONTROLLER_LOG:GEN4_DEBUG_INT_LOG_ATtiny1627 com.microchip.mplab.libs.RI4ToolsController.DataClasses.TraceDescriptor@541bca7f
9940 1718421318889 GEN4_TO_CONTROLLER_LOG:GEN4_DEBUG_INT_LOG_ATtiny1627 Payload End
9940 1718421318889 GEN4_TO_CONTROLLER_LOG:GEN4_DEBUG_INT_LOG_ATtiny1627 Post:setTraceDescriptor
9940 1718421318889 GEN4_TO_CONTROLLER_LOG:GEN4_DEBUG_INT_LOG_ATtiny1627 Return Value
9940 1718421318889 GEN4_TO_CONTROLLER_LOG:GEN4_DEBUG_INT_LOG_ATtiny1627 none
9940 1718421318889 GEN4_TO_CONTROLLER_LOG:GEN4_DEBUG_INT_LOG_ATtiny1627 Return End

9940 1718421318890 GEN4_TO_CONTROLLER_LOG:GEN4_DEBUG_INT_LOG_ATtiny1627 Pre:GetPC
9940 1718421318890 GEN4_TO_CONTROLLER_LOG:GEN4_DEBUG_INT_LOG_ATtiny1627 Payload
9940 1718421318890 GEN4_TO_CONTROLLER_LOG:GEN4_DEBUG_INT_LOG_ATtiny1627 null
9940 1718421318890 GEN4_TO_CONTROLLER_LOG:GEN4_DEBUG_INT_LOG_ATtiny1627 Payload End
9940 1718421318890 pro JtagIce3 [0x12] <<< 35 00 
9940 1718421318891 pro JtagIce3 [0x12] >>> 83 00 78 00 00 00 
9940 1718421318891 GEN4_TO_CONTROLLER_LOG:GEN4_DEBUG_INT_LOG_ATtiny1627 Post:GetPC
9940 1718421318891 GEN4_TO_CONTROLLER_LOG:GEN4_DEBUG_INT_LOG_ATtiny1627 Return Value
9940 1718421318891 GEN4_TO_CONTROLLER_LOG:GEN4_DEBUG_INT_LOG_ATtiny1627 78
9940 1718421318891 GEN4_TO_CONTROLLER_LOG:GEN4_DEBUG_INT_LOG_ATtiny1627 Return End

9940 1718421318891 GEN4_TO_CONTROLLER_LOG:GEN4_DEBUG_INT_LOG_ATtiny1627 Pre:SetSoftwareBreakpoint
9940 1718421318891 GEN4_TO_CONTROLLER_LOG:GEN4_DEBUG_INT_LOG_ATtiny1627 Payload
9940 1718421318891 GEN4_TO_CONTROLLER_LOG:GEN4_DEBUG_INT_LOG_ATtiny1627 78
9940 1718421318891 GEN4_TO_CONTROLLER_LOG:GEN4_DEBUG_INT_LOG_ATtiny1627 9598
9940 1718421318891 GEN4_TO_CONTROLLER_LOG:GEN4_DEBUG_INT_LOG_ATtiny1627 0
9940 1718421318891 GEN4_TO_CONTROLLER_LOG:GEN4_DEBUG_INT_LOG_ATtiny1627 Payload End
9940 1718421318891 pro JtagIce3 [0x12] <<< 44 00 F0 00 00 00 
9940 1718421318892 pro JtagIce3 [0x12] >>> 80 00 
9940 1718421318892 GEN4_TO_CONTROLLER_LOG:GEN4_DEBUG_INT_LOG_ATtiny1627 Post:SetSoftwareBreakpoint
9940 1718421318892 GEN4_TO_CONTROLLER_LOG:GEN4_DEBUG_INT_LOG_ATtiny1627 Return Value
9940 1718421318892 GEN4_TO_CONTROLLER_LOG:GEN4_DEBUG_INT_LOG_ATtiny1627 9598
9940 1718421318892 GEN4_TO_CONTROLLER_LOG:GEN4_DEBUG_INT_LOG_ATtiny1627 Return End

9940 1718421318892 GEN4_TO_CONTROLLER_LOG:GEN4_DEBUG_INT_LOG_ATtiny1627 Pre:StepTarget
9940 1718421318892 GEN4_TO_CONTROLLER_LOG:GEN4_DEBUG_INT_LOG_ATtiny1627 Payload
9940 1718421318892 GEN4_TO_CONTROLLER_LOG:GEN4_DEBUG_INT_LOG_ATtiny1627 0
9940 1718421318892 GEN4_TO_CONTROLLER_LOG:GEN4_DEBUG_INT_LOG_ATtiny1627 Payload End
9940 1718421318892 pro JtagIce3 [0x12] <<< 34 00 01 01 
9940 1718421318907 pro JtagIce3 [0x12] >>> 80 00 
9940 1718421318930 pro JtagIce3 ||| 0E 00 76 0A 12 40 50 00 00 00 01 04 01 AB 
9940 1718421318931 GEN4_TO_CONTROLLER_LOG:GEN4_DEBUG_INT_LOG_ATtiny1627 Post:StepTarget
9940 1718421318931 GEN4_TO_CONTROLLER_LOG:GEN4_DEBUG_INT_LOG_ATtiny1627 Return Value
9940 1718421318931 GEN4_TO_CONTROLLER_LOG:GEN4_DEBUG_INT_LOG_ATtiny1627 true
9940 1718421318931 GEN4_TO_CONTROLLER_LOG:GEN4_DEBUG_INT_LOG_ATtiny1627 Return End

9940 1718421318931 GEN4_TO_CONTROLLER_LOG:GEN4_DEBUG_INT_LOG_ATtiny1627 Pre:SetSoftwareBreakpoint
9940 1718421318931 GEN4_TO_CONTROLLER_LOG:GEN4_DEBUG_INT_LOG_ATtiny1627 Payload
9940 1718421318931 GEN4_TO_CONTROLLER_LOG:GEN4_DEBUG_INT_LOG_ATtiny1627 78
9940 1718421318931 GEN4_TO_CONTROLLER_LOG:GEN4_DEBUG_INT_LOG_ATtiny1627 9598
9940 1718421318931 GEN4_TO_CONTROLLER_LOG:GEN4_DEBUG_INT_LOG_ATtiny1627 1
9940 1718421318931 GEN4_TO_CONTROLLER_LOG:GEN4_DEBUG_INT_LOG_ATtiny1627 Payload End
9940 1718421318931 pro JtagIce3 [0x12] <<< 43 00 F0 00 00 00 
9940 1718421318932 pro JtagIce3 [0x12] >>> 80 00 
9940 1718421318932 GEN4_TO_CONTROLLER_LOG:GEN4_DEBUG_INT_LOG_ATtiny1627 Post:SetSoftwareBreakpoint
9940 1718421318932 GEN4_TO_CONTROLLER_LOG:GEN4_DEBUG_INT_LOG_ATtiny1627 Return Value
9940 1718421318932 GEN4_TO_CONTROLLER_LOG:GEN4_DEBUG_INT_LOG_ATtiny1627 9598
9940 1718421318932 GEN4_TO_CONTROLLER_LOG:GEN4_DEBUG_INT_LOG_ATtiny1627 Return End

9940 1718421318932 GEN4_TO_CONTROLLER_LOG:GEN4_DEBUG_INT_LOG_ATtiny1627 Pre:RunTarget
9940 1718421318932 GEN4_TO_CONTROLLER_LOG:GEN4_DEBUG_INT_LOG_ATtiny1627 Payload
9940 1718421318932 GEN4_TO_CONTROLLER_LOG:GEN4_DEBUG_INT_LOG_ATtiny1627 com.microchip.mplab.mdbcore.RI4Tool.atmelice.AIceDebugHandlerWithBP@5902e60
9940 1718421318932 GEN4_TO_CONTROLLER_LOG:GEN4_DEBUG_INT_LOG_ATtiny1627 Payload End
9940 1718421318932 pro JtagIce3 [0x12] <<< 32 00 
9940 1718421318946 pro JtagIce3 [0x12] >>> 80 00 
9940 1718421318947 GEN4_TO_CONTROLLER_LOG:GEN4_DEBUG_INT_LOG_ATtiny1627 Post:RunTarget
9940 1718421318947 GEN4_TO_CONTROLLER_LOG:GEN4_DEBUG_INT_LOG_ATtiny1627 Return Value
9940 1718421318947 GEN4_TO_CONTROLLER_LOG:GEN4_DEBUG_INT_LOG_ATtiny1627 true
9940 1718421318947 GEN4_TO_CONTROLLER_LOG:GEN4_DEBUG_INT_LOG_ATtiny1627 Return End

9856 1718421322045 GEN4_TO_CONTROLLER_LOG:GEN4_DEBUG_INT_LOG_ATtiny1627 Pre:DebugReadTargetMemory
9856 1718421322045 GEN4_TO_CONTROLLER_LOG:GEN4_DEBUG_INT_LOG_ATtiny1627 Payload
9856 1718421322045 GEN4_TO_CONTROLLER_LOG:GEN4_DEBUG_INT_LOG_ATtiny1627 FileRegs
9856 1718421322045 GEN4_TO_CONTROLLER_LOG:GEN4_DEBUG_INT_LOG_ATtiny1627 3d
9856 1718421322045 GEN4_TO_CONTROLLER_LOG:GEN4_DEBUG_INT_LOG_ATtiny1627 3e
9856 1718421322045 GEN4_TO_CONTROLLER_LOG:GEN4_DEBUG_INT_LOG_ATtiny1627 Length = 2
9856 1718421322045 GEN4_TO_CONTROLLER_LOG:GEN4_DEBUG_INT_LOG_ATtiny1627 Payload End
9856 1718421322045 pro JtagIce3 [0x12] <<< 21 00 20 3D 00 00 00 02 00 00 00 
9856 1718421322047 pro JtagIce3 [0x12] >>> 84 00 FD 3F 00 
9856 1718421322047 GEN4_TO_CONTROLLER_LOG:GEN4_DEBUG_INT_LOG_ATtiny1627 Post:DebugReadTargetMemory
9856 1718421322047 GEN4_TO_CONTROLLER_LOG:GEN4_DEBUG_INT_LOG_ATtiny1627 Return Value
9856 1718421322047 GEN4_TO_CONTROLLER_LOG:GEN4_DEBUG_INT_LOG_ATtiny1627 true
9856 1718421322047 GEN4_TO_CONTROLLER_LOG:GEN4_DEBUG_INT_LOG_ATtiny1627 Return End
9856 1718421322049 GEN4_CONNECT_DIAGNOSTICS:MPLABCommTool is null

9856 1718421322049 GEN4_TO_CONTROLLER_LOG:GEN4_DEBUG_INT_LOG_ATtiny1627 Pre:EndDebugSession
9856 1718421322049 GEN4_TO_CONTROLLER_LOG:GEN4_DEBUG_INT_LOG_ATtiny1627 Payload
9856 1718421322049 GEN4_TO_CONTROLLER_LOG:GEN4_DEBUG_INT_LOG_ATtiny1627 null
9856 1718421322049 GEN4_TO_CONTROLLER_LOG:GEN4_DEBUG_INT_LOG_ATtiny1627 Payload End
9856 1718421322049 pro JtagIce3 [0x12] <<< 45 00 
9856 1718421322050 pro JtagIce3 [0x12] >>> A0 00 32 
9856 1718421322050 GEN4_CONNECT_DIAGNOSTICS:Removing plug and play observer com.microchip.mplab.mdbcore.RI4Tool.RI4ToolBase$RI4PlugNPlayObserver@ca79669
9856 1718421322050 GEN4_CONNECT_DIAGNOSTICS:Begin PlugNPlayObservers list dump:
9856 1718421322050 GEN4_CONNECT_DIAGNOSTICS:End PlugNPlayObservers list dump:
9856 1718421322151 GEN4_CONNECT_DIAGNOSTICS:Calling RIDbgToolCom.Disconnect
9856 1718421322151 GEN4_CONNECT_DIAGNOSTICS:Calling MPLABCommTool.Detach to remove tool from plug and play list
9856 1718421322151 GEN4_CONNECT_DIAGNOSTICS:Calling RIDbgToolCom.DisconnectFromMPlabComm
9856 1718421322151 GEN4_CONNECT_DIAGNOSTICS:Calling MPLABCommTool.Disconnect
