RichardSefton/AUV/MidtermPrototypeCode/HC-SR04_Ultrasonic_Prototype.X/queuelogs/debugtool.txt

4526 1718406886962 pro JtagIce3 [0x12] >>> 80 00 
4526 1718406886962 pro JtagIce3 [0x12] <<< 20 00 00 00 00 00 00 
4526 1718406886968 pro JtagIce3 [0x12] >>> 80 00 
4526 1718406886968 GEN4_TO_CONTROLLER_LOG:GEN4_PROGRAM_INT_LOG_ATtiny1627 Post:SendOperation
4526 1718406886968 GEN4_TO_CONTROLLER_LOG:GEN4_PROGRAM_INT_LOG_ATtiny1627 Return Value
4526 1718406886968 GEN4_TO_CONTROLLER_LOG:GEN4_PROGRAM_INT_LOG_ATtiny1627 None
4526 1718406886968 GEN4_TO_CONTROLLER_LOG:GEN4_PROGRAM_INT_LOG_ATtiny1627 Return End

4526 1718406886968 GEN4_TO_CONTROLLER_LOG:GEN4_PROGRAM_INT_LOG_ATtiny1627 Pre:SendOperation
4526 1718406886968 GEN4_TO_CONTROLLER_LOG:GEN4_PROGRAM_INT_LOG_ATtiny1627 Payload
4526 1718406886968 GEN4_TO_CONTROLLER_LOG:GEN4_PROGRAM_INT_LOG_ATtiny1627 OperationInfo: Values:
4526 1718406886968 GEN4_TO_CONTROLLER_LOG:GEN4_PROGRAM_INT_LOG_ATtiny1627 OperationInfo: Type = write, Mask = 00000000, Erase = false, Production Mode = true
4526 1718406886968 GEN4_TO_CONTROLLER_LOG:GEN4_PROGRAM_INT_LOG_ATtiny1627 TransferInfo: Start = 0, End = 53f, Buffer Length = 1344, Type = Pgm, Mask = 00000000
4526 1718406886968 GEN4_TO_CONTROLLER_LOG:GEN4_PROGRAM_INT_LOG_ATtiny1627 Payload End
4526 1718406886969 pro JtagIce3 [0x12] <<< 23 00 C0 00 00 00 00 40 00 00 00 00 0C 94 3C 00 0C 94 59 00 0C 94 59 00 0C 94 59 00 0C 94 59 00 0C 94 59 00 0C 94 59 00 0C 94 59 00 0C 94 59 00 0C 94 59 00 0C 94 59 00 0C 94 59 00 0C 94 59 00 0C 94 59 00 0C 94 0A 01 0C 94 59 00 
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
4526 1718406887271 pro JtagIce3 [0x12] <<< 21 00 C0 00 05 00 00 40 00 00 00 
4526 1718406887274 pro JtagIce3 [0x12] >>> 84 00 0C 3D FF FF FF FF FF FF FF FF FF FF FF FF FF FF FF FF FF FF FF FF FF FF FF FF FF FF FF FF FF FF FF FF FF FF FF FF FF FF FF FF FF FF FF FF FF FF FF FF FF FF FF FF FF FF FF FF FF FF FF FF FF FF 00 
4526 1718406887274 GEN4_TO_CONTROLLER_LOG:GEN4_PROGRAM_INT_LOG_ATtiny1627 Post:SendOperation
4526 1718406887274 GEN4_TO_CONTROLLER_LOG:GEN4_PROGRAM_INT_LOG_ATtiny1627 Return Value
4526 1718406887274 GEN4_TO_CONTROLLER_LOG:GEN4_PROGRAM_INT_LOG_ATtiny1627 None
4526 1718406887274 GEN4_TO_CONTROLLER_LOG:GEN4_PROGRAM_INT_LOG_ATtiny1627 Return End

4526 1718406887274 GEN4_TO_CONTROLLER_LOG:GEN4_PROGRAM_INT_LOG_ATtiny1627 Pre:endOfOperations
4526 1718406887274 GEN4_TO_CONTROLLER_LOG:GEN4_PROGRAM_INT_LOG_ATtiny1627 Payload
4526 1718406887274 GEN4_TO_CONTROLLER_LOG:GEN4_PROGRAM_INT_LOG_ATtiny1627 null
4526 1718406887274 GEN4_TO_CONTROLLER_LOG:GEN4_PROGRAM_INT_LOG_ATtiny1627 Payload End
4526 1718406887274 pro JtagIce3 [0x12] <<< 16 00 
4526 1718406887276 pro JtagIce3 [0x12] >>> 80 00 
4526 1718406887276 pro JtagIce3 [0x12] <<< 11 00 
4526 1718406887277 pro JtagIce3 [0x12] >>> 80 00 
4526 1718406887277 pro JtagIce3 [0x01] <<< 11 00 00 
4526 1718406887278 pro JtagIce3 [0x01] >>> 80 00 
4526 1718406887278 GEN4_TO_CONTROLLER_LOG:GEN4_PROGRAM_INT_LOG_ATtiny1627 Post:endOfOperations
4526 1718406887278 GEN4_TO_CONTROLLER_LOG:GEN4_PROGRAM_INT_LOG_ATtiny1627 Return Value
4526 1718406887278 GEN4_TO_CONTROLLER_LOG:GEN4_PROGRAM_INT_LOG_ATtiny1627 None
4526 1718406887278 GEN4_TO_CONTROLLER_LOG:GEN4_PROGRAM_INT_LOG_ATtiny1627 Return End

4526 1718406887279 GEN4_TO_CONTROLLER_LOG:GEN4_PROGRAM_INT_LOG_ATtiny1627 Pre:SendOperation
4526 1718406887279 GEN4_TO_CONTROLLER_LOG:GEN4_PROGRAM_INT_LOG_ATtiny1627 Payload
4526 1718406887279 GEN4_TO_CONTROLLER_LOG:GEN4_PROGRAM_INT_LOG_ATtiny1627 OperationInfo: Values:
4526 1718406887279 GEN4_TO_CONTROLLER_LOG:GEN4_PROGRAM_INT_LOG_ATtiny1627 OperationInfo: Type = releasefromreset, Mask = 00000000, Erase = false, Production Mode = true
4526 1718406887279 GEN4_TO_CONTROLLER_LOG:GEN4_PROGRAM_INT_LOG_ATtiny1627 Payload End
4526 1718406887279 pro JtagIce3 [0x01] <<< 11 00 00 
4526 1718406887280 pro JtagIce3 [0x01] >>> 80 00 
4526 1718406887280 GEN4_TO_CONTROLLER_LOG:GEN4_PROGRAM_INT_LOG_ATtiny1627 Post:SendOperation
4526 1718406887280 GEN4_TO_CONTROLLER_LOG:GEN4_PROGRAM_INT_LOG_ATtiny1627 Return Value
4526 1718406887280 GEN4_TO_CONTROLLER_LOG:GEN4_PROGRAM_INT_LOG_ATtiny1627 None
4526 1718406887280 GEN4_TO_CONTROLLER_LOG:GEN4_PROGRAM_INT_LOG_ATtiny1627 Return End
4526 1718406887280 GEN4_CONNECT_DIAGNOSTICS:MPLABCommTool is null

4526 1718406887280 GEN4_TO_CONTROLLER_LOG:GEN4_CONNECT_INT_LOG Pre:GetFirmwareInfo
4526 1718406887280 GEN4_TO_CONTROLLER_LOG:GEN4_CONNECT_INT_LOG Payload
4526 1718406887280 GEN4_TO_CONTROLLER_LOG:GEN4_CONNECT_INT_LOG null
4526 1718406887280 GEN4_TO_CONTROLLER_LOG:GEN4_CONNECT_INT_LOG Payload End
4526 1718406887280 NativeController::GetFirmwareInfo entry
4526 1718406887280 pro JtagIce3 [0x01] <<< 02 00 00 00 01 
4526 1718406887281 pro JtagIce3 [0x01] >>> 84 01 00 00 
4526 1718406887281 NativeController::getFirmwareVersion entry
4526 1718406887281 pro JtagIce3 [0x01] <<< 02 00 00 01 01 
4526 1718406887282 pro JtagIce3 [0x01] >>> 84 01 01 00 
4526 1718406887282 pro JtagIce3 [0x01] <<< 02 00 00 02 01 
4526 1718406887283 pro JtagIce3 [0x01] >>> 84 01 2D 00 
4526 1718406887283 pro JtagIce3 [0x01] <<< 02 00 00 03 02 
4526 1718406887284 pro JtagIce3 [0x01] >>> 84 01 07 00 00 
4526 1718406887284 NativeController::getFirmwareVersion exit
4526 1718406887284 pro JtagIce3 [0x01] <<< 02 00 00 09 01 
4526 1718406887285 pro JtagIce3 [0x01] >>> 84 01 00 11 
4526 1718406887285 NativeController::tryGetFPGAVersion entry
4526 1718406887285 pro JtagIce3 [0x01] <<< 02 00 00 10 01 
4526 1718406887286 pro JtagIce3 [0x01] >>> 84 01 00 11 
4526 1718406887286 pro JtagIce3 [0x01] <<< 02 00 00 11 01 
4526 1718406887287 pro JtagIce3 [0x01] >>> 84 01 00 11 
4526 1718406887287 pro JtagIce3 [0x01] <<< 02 00 00 12 01 
4526 1718406887288 pro JtagIce3 [0x01] >>> 84 01 00 11 
4526 1718406887288 NativeController::tryGetFPGAVersion exit
4526 1718406887288 NativeController::tryGetFPGAVersion exit with exception No value present
4526 1718406887288 pro JtagIce3 [0x01] <<< 02 00 00 06 01 
4526 1718406887289 pro JtagIce3 [0x01] >>> 84 01 05 00 
4526 1718406887289 pro JtagIce3 [0x01] <<< 02 00 00 07 01 
4526 1718406887290 pro JtagIce3 [0x01] >>> 84 01 05 00 
4526 1718406887290 pro JtagIce3 [0x01] <<< 02 00 00 0A 01 
4526 1718406887291 pro JtagIce3 [0x01] >>> 84 01 00 11 
4526 1718406887291 NativeController::GetFirmwareInfo exit
4526 1718406887291 GEN4_TO_CONTROLLER_LOG:GEN4_CONNECT_INT_LOG Post:GetFirmwareInfo
4526 1718406887291 GEN4_TO_CONTROLLER_LOG:GEN4_CONNECT_INT_LOG Return Value
4526 1718406887291 GEN4_TO_CONTROLLER_LOG:GEN4_CONNECT_INT_LOG FirmwareInfo: Values:
4526 1718406887291 GEN4_TO_CONTROLLER_LOG:GEN4_CONNECT_INT_LOG FirmwareInfo: boot = false, bootVer = 5.5.0 (0x05.0x05.0x00), apVer = 1.45.7 (0x01.0x2d.0x07), fpgaVer = null, scriptVer = null, macAddress = , devID = 0, devID1 = 0, devSN0 = 0, devSN1 = 0, serialNumber = null, appCommitID = null, scriptCommitID = null, PCB_ID = 0
4526 1718406887291 GEN4_TO_CONTROLLER_LOG:GEN4_CONNECT_INT_LOG Return End

4526 1718406887291 GEN4_TO_CONTROLLER_LOG:GEN4_CONNECT_INT_LOG Pre:SetPowerInfo
4526 1718406887291 GEN4_TO_CONTROLLER_LOG:GEN4_CONNECT_INT_LOG Payload
4526 1718406887291 GEN4_TO_CONTROLLER_LOG:GEN4_CONNECT_INT_LOG PowerInfo: Values:
4526 1718406887292 GEN4_TO_CONTROLLER_LOG:GEN4_CONNECT_INT_LOG PowerInfo: shotDownSystem = true, isToolPower = false, voltage = 0.000000, useVppFirst = false, useLowVoltageProgramming = true, useMaintainActivePower = false
4526 1718406887292 GEN4_TO_CONTROLLER_LOG:GEN4_CONNECT_INT_LOG Payload End
4526 1718406887292 NativeController::GetVoltageInfo entry
4526 1718406887292 pro JtagIce3 [0x01] <<< 02 00 01 00 02 
4526 1718406887293 pro JtagIce3 [0x01] >>> 84 01 FE 11 00 
4526 1718406887293 pro JtagIce3 [0x01] <<< 02 00 01 20 02 
4526 1718406887294 pro JtagIce3 [0x01] >>> 84 01 00 00 11 
4526 1718406887294 NativeController::GetVoltageInfo TSUP exit with exception + The requested command is not supported. (17)
4526 1718406887294 pro JtagIce3 [0x01] <<< 02 00 01 02 02 
4526 1718406887295 pro JtagIce3 [0x01] >>> 84 01 00 00 11 
4526 1718406887295 NativeController::GetVoltageInfo VUSB exit with exception + The requested command is not supported. (17)
4526 1718406887295 NativeController::GetVoltageInfo exit
4526 1718406887295 GEN4_TO_CONTROLLER_LOG:GEN4_CONNECT_INT_LOG Post:SetPowerInfo
4526 1718406887295 GEN4_TO_CONTROLLER_LOG:GEN4_CONNECT_INT_LOG Return Value
4526 1718406887295 GEN4_TO_CONTROLLER_LOG:GEN4_CONNECT_INT_LOG none
4526 1718406887295 GEN4_TO_CONTROLLER_LOG:GEN4_CONNECT_INT_LOG Return End

4526 1718406887295 GEN4_TO_CONTROLLER_LOG:GEN4_CONNECT_INT_LOG Pre:Disconnect
4526 1718406887295 GEN4_TO_CONTROLLER_LOG:GEN4_CONNECT_INT_LOG Payload
4526 1718406887295 GEN4_TO_CONTROLLER_LOG:GEN4_CONNECT_INT_LOG Payload End
4526 1718406887295 NativeController::Disconnect entry
4526 1718406887295 pro JtagIce3 [0x01] <<< 11 00 00 
4526 1718406887297 pro JtagIce3 [0x01] >>> 80 00 
4526 1718406887297 NativeController::Disconnect exit
4526 1718406887297 GEN4_TO_CONTROLLER_LOG:GEN4_CONNECT_INT_LOG Post:Disconnect
4526 1718406887297 GEN4_TO_CONTROLLER_LOG:GEN4_CONNECT_INT_LOG Return Value
4526 1718406887297 GEN4_TO_CONTROLLER_LOG:GEN4_CONNECT_INT_LOG none
4526 1718406887297 GEN4_TO_CONTROLLER_LOG:GEN4_CONNECT_INT_LOG Return End
4526 1718406887297 GEN4_CONNECT_DIAGNOSTICS:Removing plug and play observer com.microchip.mplab.mdbcore.RI4Tool.RI4ToolBase$RI4PlugNPlayObserver@1bce5527
4526 1718406887297 GEN4_CONNECT_DIAGNOSTICS:Begin PlugNPlayObservers list dump:
4526 1718406887297 GEN4_CONNECT_DIAGNOSTICS:End PlugNPlayObservers list dump:
4526 1718406887397 GEN4_CONNECT_DIAGNOSTICS:Calling RIDbgToolCom.Disconnect
4526 1718406887397 GEN4_CONNECT_DIAGNOSTICS:Calling MPLABCommTool.Detach to remove tool from plug and play list
4526 1718406887397 GEN4_CONNECT_DIAGNOSTICS:Calling RIDbgToolCom.DisconnectFromMPlabComm
4526 1718406887397 GEN4_CONNECT_DIAGNOSTICS:Calling MPLABCommTool.Disconnect
4724 1718407654558 GEN4_CONNECT_DIAGNOSTICS:MPLABCommTool is NOT null
4724 1718407654558 GEN4_CONNECT_DIAGNOSTICS:AttachedToolPID = 2141, AttachedToolVID = 3eb
4724 1718407654558 GEN4_CONNECT_DIAGNOSTICS:transport type = USB
4724 1718407654558 GEN4_CONNECT_DIAGNOSTICS:AttachedToolPID = 2141, AttachedToolVID = 3eb
4724 1718407654558 com.microchip.mplab.mdbcore.RealICETool.RIDbgToolCom
4724 1718407654558 GEN4_CONNECT_DIAGNOSTICS:Before MPLABCommTool.Connect()
4724 1718407654558 GEN4_CONNECT_DIAGNOSTICS:After MPLABCommTool.Connect()
4724 1718407654558 GEN4_CONNECT_DIAGNOSTICS:MPLABCommTool.Connect() returned MPLABCOMM_NO_ERROR
4724 1718407654558 GEN4_CONNECT_DIAGNOSTICS:Attaching to MPLABCommTool plugnplay
4724 1718407654558 GEN4_CONNECT_DIAGNOSTICS:Adding new plug and play observer com.microchip.mplab.mdbcore.RI4Tool.RI4ToolBase$RI4PlugNPlayObserver@2753442e
4724 1718407654558 GEN4_CONNECT_DIAGNOSTICS:Begin PlugNPlayObservers list dump:
4724 1718407654558 GEN4_CONNECT_DIAGNOSTICS:com.microchip.mplab.mdbcore.RI4Tool.RI4ToolBase$RI4PlugNPlayObserver@2753442e
4724 1718407654558 GEN4_CONNECT_DIAGNOSTICS:End PlugNPlayObservers list dump:
4724 1718407654559 GEN4_CONNECT_DIAGNOSTICS:Registering for alternate PNP notifications. CommPnPCriteria.cPIDList = [2177, 2179, 217a, 2142, 2142], CommPnPCriteria.cSerialNumber = j42700073141

4724 1718407654576 GEN4_TO_CONTROLLER_LOG:GEN4_INIT_INT_LOG_ATtiny1627 Pre:init
4724 1718407654576 GEN4_TO_CONTROLLER_LOG:GEN4_INIT_INT_LOG_ATtiny1627 Payload
4724 1718407654576 GEN4_TO_CONTROLLER_LOG:GEN4_INIT_INT_LOG_ATtiny1627 DeviceInfo: Values:
4724 1718407654576 GEN4_TO_CONTROLLER_LOG:GEN4_INIT_INT_LOG_ATtiny1627 DeviceInfo: pcAddress = 7fffffffffffffff, Vpp = 5.00, useRowEraseIfVoltageIsLow = false, voltageBelowWhichUseRowErase = 0.00, deviceName = ATtiny1627, programmerType = 
4724 1718407654576 GEN4_TO_CONTROLLER_LOG:GEN4_INIT_INT_LOG_ATtiny1627 DeviceInfo: MemInfo values:
4724 1718407654576 GEN4_TO_CONTROLLER_LOG:GEN4_INIT_INT_LOG_ATtiny1627 DeviceInfo: mask = ffff, exists = true, startAddr = 00000000, endAddr = 00003fff, rowSize = 0040, rowEraseSize = 0040, addrInc = 0001, widthProgram = 0001
4724 1718407654576 GEN4_TO_CONTROLLER_LOG:GEN4_INIT_INT_LOG_ATtiny1627 DeviceInfo: mask = 00ff, exists = true, startAddr = 00821280, endAddr = 0083128a, rowSize = 0001, rowEraseSize = 0000, addrInc = 0001, widthProgram = 0001
4724 1718407654576 GEN4_TO_CONTROLLER_LOG:GEN4_INIT_INT_LOG_ATtiny1627 DeviceInfo: mask = 0000, exists = false, startAddr = 00000000, endAddr = 00000000, rowSize = 0000, rowEraseSize = 0000, addrInc = 0000, widthProgram = 0000
4724 1718407654576 GEN4_TO_CONTROLLER_LOG:GEN4_INIT_INT_LOG_ATtiny1627 DeviceInfo: mask = 00ff, exists = true, startAddr = 00001400, endAddr = 000014ff, rowSize = 0020, rowEraseSize = 0000, addrInc = 0001, widthProgram = 0001
4724 1718407654576 GEN4_TO_CONTROLLER_LOG:GEN4_INIT_INT_LOG_ATtiny1627 DeviceInfo: mask = 00ff, exists = true, startAddr = 00001300, endAddr = 0000131f, rowSize = 0020, rowEraseSize = 0000, addrInc = 0001, widthProgram = 0001
4724 1718407654576 GEN4_TO_CONTROLLER_LOG:GEN4_INIT_INT_LOG_ATtiny1627 DeviceInfo: mask = 0000, exists = false, startAddr = 00000000, endAddr = 00000000, rowSize = 0000, rowEraseSize = 0040, addrInc = 0000, widthProgram = 0000
4724 1718407654576 GEN4_TO_CONTROLLER_LOG:GEN4_INIT_INT_LOG_ATtiny1627 DeviceInfo: mask = 0000, exists = false, startAddr = 00000000, endAddr = 00000000, rowSize = 0000, rowEraseSize = 0000, addrInc = 0001, widthProgram = 0001
4724 1718407654576 GEN4_TO_CONTROLLER_LOG:GEN4_INIT_INT_LOG_ATtiny1627 DeviceInfo: mask = 0000, exists = false, startAddr = 00000000, endAddr = 00000000, rowSize = 0000, rowEraseSize = 0000, addrInc = 0000, widthProgram = 0000
4724 1718407654576 GEN4_TO_CONTROLLER_LOG:GEN4_INIT_INT_LOG_ATtiny1627 DeviceInfo: mask = 0000, exists = false, startAddr = 00000000, endAddr = 00000000, rowSize = 0000, rowEraseSize = 0000, addrInc = 0000, widthProgram = 0000
4724 1718407654576 GEN4_TO_CONTROLLER_LOG:GEN4_INIT_INT_LOG_ATtiny1627 DeviceInfo: mask = 0000, exists = false, startAddr = 00000000, endAddr = 00000000, rowSize = 0000, rowEraseSize = 0000, addrInc = 0000, widthProgram = 0000
4724 1718407654576 GEN4_TO_CONTROLLER_LOG:GEN4_INIT_INT_LOG_ATtiny1627 DeviceInfo: mask = 0000, exists = false, startAddr = 00000000, endAddr = 00000000, rowSize = 0000, rowEraseSize = 0000, addrInc = 0000, widthProgram = 0000
4724 1718407654576 GEN4_TO_CONTROLLER_LOG:GEN4_INIT_INT_LOG_ATtiny1627 DeviceInfo: mask = 0000, exists = false, startAddr = 00000000, endAddr = 00000000, rowSize = 0000, rowEraseSize = 0000, addrInc = 0001, widthProgram = 0001
4724 1718407654576 GEN4_TO_CONTROLLER_LOG:GEN4_INIT_INT_LOG_ATtiny1627 DeviceInfo: mask = 0000, exists = false, startAddr = 00000000, endAddr = 00000000, rowSize = 0000, rowEraseSize = 0000, addrInc = 0000, widthProgram = 0000
4724 1718407654576 GEN4_TO_CONTROLLER_LOG:GEN4_INIT_INT_LOG_ATtiny1627 DeviceInfo: mask = 0000, exists = false, startAddr = 00000000, endAddr = 00000000, rowSize = 0000, rowEraseSize = 0000, addrInc = 0000, widthProgram = 0000
4724 1718407654576 GEN4_TO_CONTROLLER_LOG:GEN4_INIT_INT_LOG_ATtiny1627 DeviceInfo: mask = 0000, exists = false, startAddr = 00000000, endAddr = 00000000, rowSize = 0000, rowEraseSize = 0000, addrInc = 0000, widthProgram = 0000
4724 1718407654576 GEN4_TO_CONTROLLER_LOG:GEN4_INIT_INT_LOG_ATtiny1627 DeviceInfo: mask = 0000, exists = false, startAddr = 00000000, endAddr = 00000000, rowSize = 0000, rowEraseSize = 0000, addrInc = 0000, widthProgram = 0000
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
4724 1718407654576 GEN4_TO_CONTROLLER_LOG:GEN4_INIT_INT_LOG_ATtiny1627 Address = 00821288, Mask = 000000ff
4724 1718407654576 GEN4_TO_CONTROLLER_LOG:GEN4_INIT_INT_LOG_ATtiny1627 Address = 0083128a, Mask = 000000ff
4724 1718407654576 GEN4_TO_CONTROLLER_LOG:GEN4_INIT_INT_LOG_ATtiny1627 BasicInfo: Values:
4724 1718407654576 GEN4_TO_CONTROLLER_LOG:GEN4_INIT_INT_LOG_ATtiny1627 Payload End
4724 1718407654576 GEN4_TO_CONTROLLER_LOG:GEN4_INIT_INT_LOG_ATtiny1627 Post:init
4724 1718407654576 GEN4_TO_CONTROLLER_LOG:GEN4_INIT_INT_LOG_ATtiny1627 Return Value
4724 1718407654576 GEN4_TO_CONTROLLER_LOG:GEN4_INIT_INT_LOG_ATtiny1627 none
4724 1718407654576 GEN4_TO_CONTROLLER_LOG:GEN4_INIT_INT_LOG_ATtiny1627 Return End

4724 1718407654576 GEN4_TO_CONTROLLER_LOG:GEN4_INIT_INT_LOG_ATtiny1627 Pre:GetInterfaceProvider
4724 1718407654576 GEN4_TO_CONTROLLER_LOG:GEN4_INIT_INT_LOG_ATtiny1627 Payload
4724 1718407654576 GEN4_TO_CONTROLLER_LOG:GEN4_INIT_INT_LOG_ATtiny1627 RI4DebugInterface
4724 1718407654576 GEN4_TO_CONTROLLER_LOG:GEN4_INIT_INT_LOG_ATtiny1627 Payload End
4724 1718407654576 GEN4_TO_CONTROLLER_LOG:GEN4_INIT_INT_LOG_ATtiny1627 Post:GetInterfaceProvider
4724 1718407654576 GEN4_TO_CONTROLLER_LOG:GEN4_INIT_INT_LOG_ATtiny1627 Return Value
4724 1718407654576 GEN4_TO_CONTROLLER_LOG:GEN4_INIT_INT_LOG_ATtiny1627 com.microchip.mplab.libs.atmelice.implementations.DebugInterface@1e52da1c
4724 1718407654576 GEN4_TO_CONTROLLER_LOG:GEN4_INIT_INT_LOG_ATtiny1627 Return End

4724 1718407654577 GEN4_TO_CONTROLLER_LOG:GEN4_INIT_INT_LOG_ATtiny1627 Pre:GetInterfaceProvider
4724 1718407654577 GEN4_TO_CONTROLLER_LOG:GEN4_INIT_INT_LOG_ATtiny1627 Payload
4724 1718407654577 GEN4_TO_CONTROLLER_LOG:GEN4_INIT_INT_LOG_ATtiny1627 RI4ProgramInterface
4724 1718407654577 GEN4_TO_CONTROLLER_LOG:GEN4_INIT_INT_LOG_ATtiny1627 Payload End
4724 1718407654577 GEN4_TO_CONTROLLER_LOG:GEN4_INIT_INT_LOG_ATtiny1627 Post:GetInterfaceProvider
4724 1718407654577 GEN4_TO_CONTROLLER_LOG:GEN4_INIT_INT_LOG_ATtiny1627 Return Value
4724 1718407654577 GEN4_TO_CONTROLLER_LOG:GEN4_INIT_INT_LOG_ATtiny1627 com.microchip.mplab.libs.atmelice.implementations.ProgramInterface@231d9fcc
4724 1718407654577 GEN4_TO_CONTROLLER_LOG:GEN4_INIT_INT_LOG_ATtiny1627 Return End

4724 1718407654577 GEN4_TO_CONTROLLER_LOG:GEN4_INIT_INT_LOG_ATtiny1627 Pre:GetInterfaceProvider
4724 1718407654577 GEN4_TO_CONTROLLER_LOG:GEN4_INIT_INT_LOG_ATtiny1627 Payload
4724 1718407654577 GEN4_TO_CONTROLLER_LOG:GEN4_INIT_INT_LOG_ATtiny1627 RI4ConnectInterface
4724 1718407654577 GEN4_TO_CONTROLLER_LOG:GEN4_INIT_INT_LOG_ATtiny1627 Payload End
4724 1718407654577 GEN4_TO_CONTROLLER_LOG:GEN4_INIT_INT_LOG_ATtiny1627 Post:GetInterfaceProvider
4724 1718407654577 GEN4_TO_CONTROLLER_LOG:GEN4_INIT_INT_LOG_ATtiny1627 Return Value
4724 1718407654577 GEN4_TO_CONTROLLER_LOG:GEN4_INIT_INT_LOG_ATtiny1627 com.microchip.mplab.libs.atmelice.implementations.ConnectInterface@527b06c1
4724 1718407654577 GEN4_TO_CONTROLLER_LOG:GEN4_INIT_INT_LOG_ATtiny1627 Return End

4724 1718407654577 GEN4_TO_CONTROLLER_LOG:GEN4_INIT_INT_LOG_ATtiny1627 Pre:GetInterfaceProvider
4724 1718407654577 GEN4_TO_CONTROLLER_LOG:GEN4_INIT_INT_LOG_ATtiny1627 Payload
4724 1718407654577 GEN4_TO_CONTROLLER_LOG:GEN4_INIT_INT_LOG_ATtiny1627 RI4ControllerDiagnosticsInterface
4724 1718407654577 GEN4_TO_CONTROLLER_LOG:GEN4_INIT_INT_LOG_ATtiny1627 Payload End
4724 1718407654577 GEN4_TO_CONTROLLER_LOG:GEN4_INIT_INT_LOG_ATtiny1627 Post:GetInterfaceProvider
4724 1718407654577 GEN4_TO_CONTROLLER_LOG:GEN4_INIT_INT_LOG_ATtiny1627 Return Value
4724 1718407654577 GEN4_TO_CONTROLLER_LOG:GEN4_INIT_INT_LOG_ATtiny1627 com.microchip.mplab.libs.atmelice.implementations.UnimplementedDiagnostics@74b06a99
4724 1718407654577 GEN4_TO_CONTROLLER_LOG:GEN4_INIT_INT_LOG_ATtiny1627 Return End

4724 1718407654577 GEN4_TO_CONTROLLER_LOG:GEN4_INIT_INT_LOG_ATtiny1627 Pre:GetInterfaceProvider
4724 1718407654577 GEN4_TO_CONTROLLER_LOG:GEN4_INIT_INT_LOG_ATtiny1627 Payload
4724 1718407654577 GEN4_TO_CONTROLLER_LOG:GEN4_INIT_INT_LOG_ATtiny1627 ProgrammerToGo
4724 1718407654577 GEN4_TO_CONTROLLER_LOG:GEN4_INIT_INT_LOG_ATtiny1627 Payload End
4724 1718407654577 GEN4_TO_CONTROLLER_LOG:GEN4_INIT_INT_LOG_ATtiny1627 Post:GetInterfaceProvider
4724 1718407654577 GEN4_TO_CONTROLLER_LOG:GEN4_INIT_INT_LOG_ATtiny1627 Return Value
4724 1718407654577 GEN4_TO_CONTROLLER_LOG:GEN4_INIT_INT_LOG_ATtiny1627 null
4724 1718407654577 GEN4_TO_CONTROLLER_LOG:GEN4_INIT_INT_LOG_ATtiny1627 Return End

4724 1718407654577 GEN4_TO_CONTROLLER_LOG:GEN4_INIT_INT_LOG_ATtiny1627 Pre:GetInterfaceProvider
4724 1718407654577 GEN4_TO_CONTROLLER_LOG:GEN4_INIT_INT_LOG_ATtiny1627 Payload
4724 1718407654577 GEN4_TO_CONTROLLER_LOG:GEN4_INIT_INT_LOG_ATtiny1627 Status
4724 1718407654577 GEN4_TO_CONTROLLER_LOG:GEN4_INIT_INT_LOG_ATtiny1627 Payload End
4724 1718407654577 GEN4_TO_CONTROLLER_LOG:GEN4_INIT_INT_LOG_ATtiny1627 Post:GetInterfaceProvider
4724 1718407654577 GEN4_TO_CONTROLLER_LOG:GEN4_INIT_INT_LOG_ATtiny1627 Return Value
4724 1718407654577 GEN4_TO_CONTROLLER_LOG:GEN4_INIT_INT_LOG_ATtiny1627 null
4724 1718407654577 GEN4_TO_CONTROLLER_LOG:GEN4_INIT_INT_LOG_ATtiny1627 Return End

4724 1718407654577 GEN4_TO_CONTROLLER_LOG:GEN4_CONNECT_INT_LOG Pre:EstablishCommunincations
4724 1718407654577 GEN4_TO_CONTROLLER_LOG:GEN4_CONNECT_INT_LOG Payload
4724 1718407654577 GEN4_TO_CONTROLLER_LOG:GEN4_CONNECT_INT_LOG com.microchip.mplab.mdbcore.AtmelIceScripting.AIceScriptingCom@615c4ce8
4724 1718407654577 GEN4_TO_CONTROLLER_LOG:GEN4_CONNECT_INT_LOG Payload End
4724 1718407654577 NativeController::EstablishCommunincations entry
4724 1718407654577 pro JtagIce3 [0x00] <<< 00 00 00 
4724 1718407654579 pro JtagIce3 [0x00] >>> 81 00 00 01 11 12 13 14 
4724 1718407654579 pro JtagIce3 [0x01] <<< 10 00 
4724 1718407654580 pro JtagIce3 [0x01] >>> 80 00 
4724 1718407654580 pro JtagIce3 [0x00] <<< 00 00 03 
4724 1718407654581 pro JtagIce3 [0x00] >>> 81 00 01 04 05 06 07 
4724 1718407654581 pro JtagIce3 [0x01] <<< 02 00 01 20 02 
4724 1718407654582 pro JtagIce3 [0x01] >>> 84 01 00 00 11 
4724 1718407654582 NativeController::EstablishCommunincations exit
4724 1718407654582 GEN4_TO_CONTROLLER_LOG:GEN4_CONNECT_INT_LOG Post:EstablishCommunincations
4724 1718407654582 GEN4_TO_CONTROLLER_LOG:GEN4_CONNECT_INT_LOG Return Value
4724 1718407654582 GEN4_TO_CONTROLLER_LOG:GEN4_CONNECT_INT_LOG true
4724 1718407654582 GEN4_TO_CONTROLLER_LOG:GEN4_CONNECT_INT_LOG Return End

4724 1718407654582 GEN4_TO_CONTROLLER_LOG:GEN4_CONNECT_INT_LOG Pre:GetFirmwareInfo
4724 1718407654582 GEN4_TO_CONTROLLER_LOG:GEN4_CONNECT_INT_LOG Payload
4724 1718407654582 GEN4_TO_CONTROLLER_LOG:GEN4_CONNECT_INT_LOG null
4724 1718407654582 GEN4_TO_CONTROLLER_LOG:GEN4_CONNECT_INT_LOG Payload End
4724 1718407654582 NativeController::GetFirmwareInfo entry
4724 1718407654582 pro JtagIce3 [0x01] <<< 02 00 00 00 01 
4724 1718407654583 pro JtagIce3 [0x01] >>> 84 01 00 00 
4724 1718407654583 NativeController::getFirmwareVersion entry
4724 1718407654583 pro JtagIce3 [0x01] <<< 02 00 00 01 01 
4724 1718407654584 pro JtagIce3 [0x01] >>> 84 01 01 00 
4724 1718407654584 pro JtagIce3 [0x01] <<< 02 00 00 02 01 
4724 1718407654585 pro JtagIce3 [0x01] >>> 84 01 2D 00 
4724 1718407654585 pro JtagIce3 [0x01] <<< 02 00 00 03 02 
4724 1718407654587 pro JtagIce3 [0x01] >>> 84 01 07 00 00 
4724 1718407654587 NativeController::getFirmwareVersion exit
4724 1718407654587 pro JtagIce3 [0x01] <<< 02 00 00 09 01 
4724 1718407654588 pro JtagIce3 [0x01] >>> 84 01 00 11 
4724 1718407654588 NativeController::tryGetFPGAVersion entry
4724 1718407654588 pro JtagIce3 [0x01] <<< 02 00 00 10 01 
4724 1718407654589 pro JtagIce3 [0x01] >>> 84 01 00 11 
4724 1718407654589 pro JtagIce3 [0x01] <<< 02 00 00 11 01 
4724 1718407654590 pro JtagIce3 [0x01] >>> 84 01 00 11 
4724 1718407654590 pro JtagIce3 [0x01] <<< 02 00 00 12 01 
4724 1718407654591 pro JtagIce3 [0x01] >>> 84 01 00 11 
4724 1718407654591 NativeController::tryGetFPGAVersion exit
4724 1718407654591 NativeController::tryGetFPGAVersion exit with exception No value present
4724 1718407654591 pro JtagIce3 [0x01] <<< 02 00 00 06 01 
4724 1718407654592 pro JtagIce3 [0x01] >>> 84 01 05 00 
4724 1718407654592 pro JtagIce3 [0x01] <<< 02 00 00 07 01 
4724 1718407654593 pro JtagIce3 [0x01] >>> 84 01 05 00 
4724 1718407654593 pro JtagIce3 [0x01] <<< 02 00 00 0A 01 
4724 1718407654594 pro JtagIce3 [0x01] >>> 84 01 00 11 
4724 1718407654594 NativeController::GetFirmwareInfo exit
4724 1718407654594 GEN4_TO_CONTROLLER_LOG:GEN4_CONNECT_INT_LOG Post:GetFirmwareInfo
4724 1718407654594 GEN4_TO_CONTROLLER_LOG:GEN4_CONNECT_INT_LOG Return Value
4724 1718407654594 GEN4_TO_CONTROLLER_LOG:GEN4_CONNECT_INT_LOG FirmwareInfo: Values:
4724 1718407654594 GEN4_TO_CONTROLLER_LOG:GEN4_CONNECT_INT_LOG FirmwareInfo: boot = false, bootVer = 5.5.0 (0x05.0x05.0x00), apVer = 1.45.7 (0x01.0x2d.0x07), fpgaVer = null, scriptVer = null, macAddress = , devID = 0, devID1 = 0, devSN0 = 0, devSN1 = 0, serialNumber = null, appCommitID = null, scriptCommitID = null, PCB_ID = 0
4724 1718407654594 GEN4_TO_CONTROLLER_LOG:GEN4_CONNECT_INT_LOG Return End
4724 1718407654594 GEN4_CONNECT_DIAGNOSTICS:ENTERING: com.microchip.mplab.mdbcore.RI4Tool.ConnectionHandler.CheckForFWUpdates()
4724 1718407654594 GEN4_CONNECT_DIAGNOSTICS:Created FirmwareUpdateHandler com.microchip.mplab.mdbcore.AtmelIceScripting.OperationHandlers.AIceScriptingFirmwareUpdateHandler@54e9caf9

4724 1718407654595 GEN4_TO_CONTROLLER_LOG:GEN4_CONNECT_INT_LOG Pre:SetUpdateFirmwareInfo
4724 1718407654595 GEN4_TO_CONTROLLER_LOG:GEN4_CONNECT_INT_LOG Payload
4724 1718407654595 GEN4_TO_CONTROLLER_LOG:GEN4_CONNECT_INT_LOG UpdateFirmwareInfo: Values:
4724 1718407654595 GEN4_TO_CONTROLLER_LOG:GEN4_CONNECT_INT_LOG UpdateFirmwareInfo: license = dCejLCt9ZV4fWdqYk3htQgdNYCC2nccSTvVdTD2oCjW3gRUtjikRtla11IiYo1wq, updateId = 2147483647
4724 1718407654595 GEN4_TO_CONTROLLER_LOG:GEN4_CONNECT_INT_LOG Payload End
4724 1718407654595 GEN4_TO_CONTROLLER_LOG:GEN4_CONNECT_INT_LOG Post:SetUpdateFirmwareInfo
4724 1718407654595 GEN4_TO_CONTROLLER_LOG:GEN4_CONNECT_INT_LOG Return Value
4724 1718407654595 GEN4_TO_CONTROLLER_LOG:GEN4_CONNECT_INT_LOG none
4724 1718407654595 GEN4_TO_CONTROLLER_LOG:GEN4_CONNECT_INT_LOG Return End
4724 1718407654595 GEN4_CONNECT_DIAGNOSTICS:EXITING: com.microchip.mplab.mdbcore.RI4Tool.ConnectionHandler.CheckForFWUpdates()

4724 1718407654596 GEN4_TO_CONTROLLER_LOG:GEN4_CONNECT_INT_LOG Pre:SetPowerInfo
4724 1718407654596 GEN4_TO_CONTROLLER_LOG:GEN4_CONNECT_INT_LOG Payload
4724 1718407654596 GEN4_TO_CONTROLLER_LOG:GEN4_CONNECT_INT_LOG PowerInfo: Values:
4724 1718407654596 GEN4_TO_CONTROLLER_LOG:GEN4_CONNECT_INT_LOG PowerInfo: shotDownSystem = false, isToolPower = false, voltage = 5.000000, useVppFirst = false, useLowVoltageProgramming = true, useMaintainActivePower = false
4724 1718407654596 GEN4_TO_CONTROLLER_LOG:GEN4_CONNECT_INT_LOG Payload End
4724 1718407654596 NativeController::GetVoltageInfo entry
4724 1718407654596 pro JtagIce3 [0x01] <<< 02 00 01 00 02 
4724 1718407654596 pro JtagIce3 [0x01] >>> 84 01 0F 12 00 
4724 1718407654597 pro JtagIce3 [0x01] <<< 02 00 01 20 02 
4724 1718407654597 pro JtagIce3 [0x01] >>> 84 01 00 00 11 
4724 1718407654597 NativeController::GetVoltageInfo TSUP exit with exception + The requested command is not supported. (17)
4724 1718407654597 pro JtagIce3 [0x01] <<< 02 00 01 02 02 
4724 1718407654598 pro JtagIce3 [0x01] >>> 84 01 00 00 11 
4724 1718407654598 NativeController::GetVoltageInfo VUSB exit with exception + The requested command is not supported. (17)
4724 1718407654598 NativeController::GetVoltageInfo exit
4724 1718407654598 GEN4_TO_CONTROLLER_LOG:GEN4_CONNECT_INT_LOG Post:SetPowerInfo
4724 1718407654598 GEN4_TO_CONTROLLER_LOG:GEN4_CONNECT_INT_LOG Return Value
4724 1718407654598 GEN4_TO_CONTROLLER_LOG:GEN4_CONNECT_INT_LOG none
4724 1718407654598 GEN4_TO_CONTROLLER_LOG:GEN4_CONNECT_INT_LOG Return End

4724 1718407654598 GEN4_TO_CONTROLLER_LOG:GEN4_CONNECT_INT_LOG Pre:GetVoltageInfo
4724 1718407654598 GEN4_TO_CONTROLLER_LOG:GEN4_CONNECT_INT_LOG Payload
4724 1718407654598 GEN4_TO_CONTROLLER_LOG:GEN4_CONNECT_INT_LOG null
4724 1718407654598 GEN4_TO_CONTROLLER_LOG:GEN4_CONNECT_INT_LOG Payload End
4724 1718407654598 NativeController::GetVoltageInfo entry
4724 1718407654598 pro JtagIce3 [0x01] <<< 02 00 01 00 02 
4724 1718407654599 pro JtagIce3 [0x01] >>> 84 01 08 12 00 
4724 1718407654599 pro JtagIce3 [0x01] <<< 02 00 01 20 02 
4724 1718407654601 pro JtagIce3 [0x01] >>> 84 01 00 00 11 
4724 1718407654601 NativeController::GetVoltageInfo TSUP exit with exception + The requested command is not supported. (17)
4724 1718407654601 pro JtagIce3 [0x01] <<< 02 00 01 02 02 
4724 1718407654602 pro JtagIce3 [0x01] >>> 84 01 00 00 11 
4724 1718407654602 NativeController::GetVoltageInfo VUSB exit with exception + The requested command is not supported. (17)
4724 1718407654602 NativeController::GetVoltageInfo exit
4724 1718407654602 GEN4_TO_CONTROLLER_LOG:GEN4_CONNECT_INT_LOG Post:GetVoltageInfo
4724 1718407654602 GEN4_TO_CONTROLLER_LOG:GEN4_CONNECT_INT_LOG Return Value
4724 1718407654602 GEN4_TO_CONTROLLER_LOG:GEN4_CONNECT_INT_LOG VoltagesInfo: Values:
4724 1718407654602 GEN4_TO_CONTROLLER_LOG:GEN4_CONNECT_INT_LOG VoltagesInfo: internalVdd = 0, internalVpp = 0, targetVdd = 0, targetVpp = -2147483648, vddSense = 4616, temp = 0, vddCurrentSense = 0, vddVoltageSense = -2147483648
4724 1718407654602 GEN4_TO_CONTROLLER_LOG:GEN4_CONNECT_INT_LOG Return End

4724 1718407654602 GEN4_TO_CONTROLLER_LOG:GEN4_CONNECT_INT_LOG Pre:SetLEDBrightness
4724 1718407654602 GEN4_TO_CONTROLLER_LOG:GEN4_CONNECT_INT_LOG Payload
4724 1718407654602 GEN4_TO_CONTROLLER_LOG:GEN4_CONNECT_INT_LOG 5
4724 1718407654602 GEN4_TO_CONTROLLER_LOG:GEN4_CONNECT_INT_LOG Payload End
4724 1718407654602 GEN4_TO_CONTROLLER_LOG:GEN4_CONNECT_INT_LOG Post:SetLEDBrightness
4724 1718407654602 GEN4_TO_CONTROLLER_LOG:GEN4_CONNECT_INT_LOG Return Value
4724 1718407654602 GEN4_TO_CONTROLLER_LOG:GEN4_CONNECT_INT_LOG none
4724 1718407654602 GEN4_TO_CONTROLLER_LOG:GEN4_CONNECT_INT_LOG Return End

4724 1718407654602 GEN4_TO_CONTROLLER_LOG:GEN4_CONNECT_INT_LOG Pre:SetToolInfo
4724 1718407654602 GEN4_TO_CONTROLLER_LOG:GEN4_CONNECT_INT_LOG Payload
4724 1718407654602 GEN4_TO_CONTROLLER_LOG:GEN4_CONNECT_INT_LOG ToolInfo: Values:
4724 1718407654602 GEN4_TO_CONTROLLER_LOG:GEN4_CONNECT_INT_LOG ToolInfo: speedLevel = 1, PGCResistance = 4700, PGDResistance = 4700, PGCPullDir = PullDown, PGDPullDir = PullDown, ICSPSelected = Wire2
4724 1718407654602 GEN4_TO_CONTROLLER_LOG:GEN4_CONNECT_INT_LOG Payload End
4724 1718407654602 GEN4_TO_CONTROLLER_LOG:GEN4_CONNECT_INT_LOG Post:SetToolInfo
4724 1718407654602 GEN4_TO_CONTROLLER_LOG:GEN4_CONNECT_INT_LOG Return Value
4724 1718407654602 GEN4_TO_CONTROLLER_LOG:GEN4_CONNECT_INT_LOG none
4724 1718407654602 GEN4_TO_CONTROLLER_LOG:GEN4_CONNECT_INT_LOG Return End

4724 1718407654602 GEN4_TO_CONTROLLER_LOG:GEN4_CONNECT_INT_LOG Pre:GetTargetIDInfo
4724 1718407654602 GEN4_TO_CONTROLLER_LOG:GEN4_CONNECT_INT_LOG Payload
4724 1718407654602 GEN4_TO_CONTROLLER_LOG:GEN4_CONNECT_INT_LOG null
4724 1718407654602 GEN4_TO_CONTROLLER_LOG:GEN4_CONNECT_INT_LOG Payload End
4724 1718407654602 NativeController::GetTargetIDInfo entry
4724 1718407654602 pro JtagIce3 [0x12] <<< 01 00 01 31 02 F4 01 
4724 1718407654603 pro JtagIce3 [0x12] >>> 80 00 
4724 1718407654603 pro JtagIce3 [0x12] <<< 01 00 00 00 01 05 
4724 1718407654604 pro JtagIce3 [0x12] >>> 80 00 
4724 1718407654604 pro JtagIce3 [0x12] <<< 01 00 00 01 01 01 
4724 1718407654605 pro JtagIce3 [0x12] >>> 80 00 
4724 1718407654605 pro JtagIce3 [0x12] <<< 01 00 01 00 01 08 
4724 1718407654606 pro JtagIce3 [0x12] >>> 80 00 
4724 1718407654606 pro JtagIce3 [0x12] <<< 01 00 02 00 30 00 80 40 20 00 10 80 0F 94 11 8C 0A 98 08 DC 05 EE 02 00 40 00 00 00 01 20 00 0A 05 FF 00 FF 00 00 14 00 13 00 11 80 12 8A 12 28 94 00 00 00 00 
4724 1718407654607 pro JtagIce3 [0x12] >>> 80 00 
4724 1718407654607 pro JtagIce3 [0x12] <<< 01 00 03 06 01 00 
4724 1718407654608 pro JtagIce3 [0x12] >>> 80 00 
4724 1718407654608 pro JtagIce3 [0x12] <<< 10 00 00 
4724 1718407654620 pro JtagIce3 [0x12] >>> 84 00 74 69 6E 79 00 
4724 1718407654620 pro JtagIce3 [0x12] <<< 01 00 03 06 01 00 
4724 1718407654622 pro JtagIce3 [0x12] >>> 80 00 
4724 1718407654622 pro JtagIce3 [0x12] <<< 15 00 
4724 1718407654688 pro JtagIce3 [0x12] >>> 80 00 
4724 1718407654688 pro JtagIce3 [0x12] <<< 21 00 B4 00 11 00 00 03 00 00 00 
4724 1718407654690 pro JtagIce3 [0x12] >>> 84 00 1E 94 28 00 
4724 1718407654690 pro JtagIce3 [0x12] <<< 21 00 B4 00 11 00 00 03 00 00 00 
4724 1718407654692 pro JtagIce3 [0x12] >>> 84 00 1E 94 28 00 
4724 1718407654692 pro JtagIce3 [0x12] <<< 21 00 B4 00 11 00 00 03 00 00 00 
4724 1718407654694 pro JtagIce3 [0x12] >>> 84 00 1E 94 28 00 
4724 1718407654694 pro JtagIce3 [0x12] <<< 21 00 B2 01 0F 00 00 01 00 00 00 
4724 1718407654696 pro JtagIce3 [0x12] >>> 84 00 04 00 
4724 1718407654696 pro JtagIce3 [0x12] <<< 16 00 
4724 1718407654698 pro JtagIce3 [0x12] >>> 80 00 
4724 1718407654698 pro JtagIce3 [0x12] <<< 11 00 
4724 1718407654699 pro JtagIce3 [0x12] >>> 80 00 
4724 1718407654699 pro JtagIce3 [0x01] <<< 11 00 00 
4724 1718407654700 pro JtagIce3 [0x01] >>> 80 00 
4724 1718407654700 NativeController::GetTargetIDInfo exit device ID 0x1e9428
4724 1718407654700 GEN4_TO_CONTROLLER_LOG:GEN4_CONNECT_INT_LOG Post:GetTargetIDInfo
4724 1718407654700 GEN4_TO_CONTROLLER_LOG:GEN4_CONNECT_INT_LOG Return Value
4724 1718407654700 GEN4_TO_CONTROLLER_LOG:GEN4_CONNECT_INT_LOG TargetIDInfo: Values:
4724 1718407654700 GEN4_TO_CONTROLLER_LOG:GEN4_CONNECT_INT_LOG TargetIDInfo: DeviceID = 001e9428
4724 1718407654700 GEN4_TO_CONTROLLER_LOG:GEN4_CONNECT_INT_LOG Return End

4724 1718407654701 GEN4_TO_CONTROLLER_LOG:GEN4_PROGRAM_INT_LOG_ATtiny1627 Pre:SendOperation
4724 1718407654701 GEN4_TO_CONTROLLER_LOG:GEN4_PROGRAM_INT_LOG_ATtiny1627 Payload
4724 1718407654701 GEN4_TO_CONTROLLER_LOG:GEN4_PROGRAM_INT_LOG_ATtiny1627 OperationInfo: Values:
4724 1718407654701 GEN4_TO_CONTROLLER_LOG:GEN4_PROGRAM_INT_LOG_ATtiny1627 OperationInfo: Type = erase, Mask = 00000000, Erase = false, Production Mode = true
4724 1718407654701 GEN4_TO_CONTROLLER_LOG:GEN4_PROGRAM_INT_LOG_ATtiny1627 TransferInfo: Start = 0, End = 3fff, Buffer Length = 0, Type = Pgm, Mask = 00000000
4724 1718407654701 GEN4_TO_CONTROLLER_LOG:GEN4_PROGRAM_INT_LOG_ATtiny1627 TransferInfo: Start = 1280, End = 1288, Buffer Length = 0, Type = Cfg, Mask = 00000000
4724 1718407654701 GEN4_TO_CONTROLLER_LOG:GEN4_PROGRAM_INT_LOG_ATtiny1627 TransferInfo: Start = 128a, End = 128a, Buffer Length = 0, Type = Cfg, Mask = 00000000
4724 1718407654701 GEN4_TO_CONTROLLER_LOG:GEN4_PROGRAM_INT_LOG_ATtiny1627 TransferInfo: Start = 1400, End = 14ff, Buffer Length = 0, Type = EEData, Mask = 00000000
4724 1718407654701 GEN4_TO_CONTROLLER_LOG:GEN4_PROGRAM_INT_LOG_ATtiny1627 TransferInfo: Start = 1300, End = 131f, Buffer Length = 0, Type = UserID, Mask = 00000000
4724 1718407654701 GEN4_TO_CONTROLLER_LOG:GEN4_PROGRAM_INT_LOG_ATtiny1627 Payload End
4724 1718407654701 pro JtagIce3 [0x12] <<< 01 00 01 31 02 F4 01 
4724 1718407654702 pro JtagIce3 [0x12] >>> 80 00 
4724 1718407654702 pro JtagIce3 [0x12] <<< 01 00 00 00 01 05 
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
4724 1718407655078 pro JtagIce3 [0x12] <<< 21 00 C0 00 05 00 00 40 00 00 00 
4724 1718407655082 pro JtagIce3 [0x12] >>> 84 00 9F 4F 08 95 F8 94 FF CF 28 7E 0C 3D FF FF FF FF FF FF FF FF FF FF FF FF FF FF FF FF FF FF FF FF FF FF FF FF FF FF FF FF FF FF FF FF FF FF FF FF FF FF FF FF FF FF FF FF FF FF FF FF FF FF FF FF 00 
4724 1718407655082 GEN4_TO_CONTROLLER_LOG:GEN4_PROGRAM_INT_LOG_ATtiny1627 Post:SendOperation
4724 1718407655082 GEN4_TO_CONTROLLER_LOG:GEN4_PROGRAM_INT_LOG_ATtiny1627 Return Value
4724 1718407655082 GEN4_TO_CONTROLLER_LOG:GEN4_PROGRAM_INT_LOG_ATtiny1627 None
4724 1718407655082 GEN4_TO_CONTROLLER_LOG:GEN4_PROGRAM_INT_LOG_ATtiny1627 Return End

4724 1718407655082 GEN4_TO_CONTROLLER_LOG:GEN4_PROGRAM_INT_LOG_ATtiny1627 Pre:endOfOperations
4724 1718407655082 GEN4_TO_CONTROLLER_LOG:GEN4_PROGRAM_INT_LOG_ATtiny1627 Payload
4724 1718407655082 GEN4_TO_CONTROLLER_LOG:GEN4_PROGRAM_INT_LOG_ATtiny1627 null
4724 1718407655082 GEN4_TO_CONTROLLER_LOG:GEN4_PROGRAM_INT_LOG_ATtiny1627 Payload End
4724 1718407655082 pro JtagIce3 [0x12] <<< 16 00 
4724 1718407655084 pro JtagIce3 [0x12] >>> 80 00 
4724 1718407655084 pro JtagIce3 [0x12] <<< 11 00 
4724 1718407655085 pro JtagIce3 [0x12] >>> 80 00 
4724 1718407655085 pro JtagIce3 [0x01] <<< 11 00 00 
4724 1718407655086 pro JtagIce3 [0x01] >>> 80 00 
4724 1718407655086 GEN4_TO_CONTROLLER_LOG:GEN4_PROGRAM_INT_LOG_ATtiny1627 Post:endOfOperations
4724 1718407655086 GEN4_TO_CONTROLLER_LOG:GEN4_PROGRAM_INT_LOG_ATtiny1627 Return Value
4724 1718407655086 GEN4_TO_CONTROLLER_LOG:GEN4_PROGRAM_INT_LOG_ATtiny1627 None
4724 1718407655086 GEN4_TO_CONTROLLER_LOG:GEN4_PROGRAM_INT_LOG_ATtiny1627 Return End

4724 1718407655087 GEN4_TO_CONTROLLER_LOG:GEN4_PROGRAM_INT_LOG_ATtiny1627 Pre:SendOperation
4724 1718407655087 GEN4_TO_CONTROLLER_LOG:GEN4_PROGRAM_INT_LOG_ATtiny1627 Payload
4724 1718407655087 GEN4_TO_CONTROLLER_LOG:GEN4_PROGRAM_INT_LOG_ATtiny1627 OperationInfo: Values:
4724 1718407655087 GEN4_TO_CONTROLLER_LOG:GEN4_PROGRAM_INT_LOG_ATtiny1627 OperationInfo: Type = releasefromreset, Mask = 00000000, Erase = false, Production Mode = true
4724 1718407655087 GEN4_TO_CONTROLLER_LOG:GEN4_PROGRAM_INT_LOG_ATtiny1627 Payload End
4724 1718407655087 pro JtagIce3 [0x01] <<< 11 00 00 
4724 1718407655088 pro JtagIce3 [0x01] >>> 80 00 
4724 1718407655088 GEN4_TO_CONTROLLER_LOG:GEN4_PROGRAM_INT_LOG_ATtiny1627 Post:SendOperation
4724 1718407655088 GEN4_TO_CONTROLLER_LOG:GEN4_PROGRAM_INT_LOG_ATtiny1627 Return Value
4724 1718407655088 GEN4_TO_CONTROLLER_LOG:GEN4_PROGRAM_INT_LOG_ATtiny1627 None
4724 1718407655088 GEN4_TO_CONTROLLER_LOG:GEN4_PROGRAM_INT_LOG_ATtiny1627 Return End
4724 1718407655088 GEN4_CONNECT_DIAGNOSTICS:MPLABCommTool is null

4724 1718407655088 GEN4_TO_CONTROLLER_LOG:GEN4_CONNECT_INT_LOG Pre:GetFirmwareInfo
4724 1718407655088 GEN4_TO_CONTROLLER_LOG:GEN4_CONNECT_INT_LOG Payload
4724 1718407655088 GEN4_TO_CONTROLLER_LOG:GEN4_CONNECT_INT_LOG null
4724 1718407655088 GEN4_TO_CONTROLLER_LOG:GEN4_CONNECT_INT_LOG Payload End
4724 1718407655088 NativeController::GetFirmwareInfo entry
4724 1718407655088 pro JtagIce3 [0x01] <<< 02 00 00 00 01 
4724 1718407655089 pro JtagIce3 [0x01] >>> 84 01 00 00 
4724 1718407655089 NativeController::getFirmwareVersion entry
4724 1718407655089 pro JtagIce3 [0x01] <<< 02 00 00 01 01 
4724 1718407655090 pro JtagIce3 [0x01] >>> 84 01 01 00 
4724 1718407655090 pro JtagIce3 [0x01] <<< 02 00 00 02 01 
4724 1718407655091 pro JtagIce3 [0x01] >>> 84 01 2D 00 
4724 1718407655091 pro JtagIce3 [0x01] <<< 02 00 00 03 02 
4724 1718407655092 pro JtagIce3 [0x01] >>> 84 01 07 00 00 
4724 1718407655092 NativeController::getFirmwareVersion exit
4724 1718407655092 pro JtagIce3 [0x01] <<< 02 00 00 09 01 
4724 1718407655093 pro JtagIce3 [0x01] >>> 84 01 00 11 
4724 1718407655093 NativeController::tryGetFPGAVersion entry
4724 1718407655093 pro JtagIce3 [0x01] <<< 02 00 00 10 01 
4724 1718407655094 pro JtagIce3 [0x01] >>> 84 01 00 11 
4724 1718407655094 pro JtagIce3 [0x01] <<< 02 00 00 11 01 
4724 1718407655095 pro JtagIce3 [0x01] >>> 84 01 00 11 
4724 1718407655095 pro JtagIce3 [0x01] <<< 02 00 00 12 01 
4724 1718407655096 pro JtagIce3 [0x01] >>> 84 01 00 11 
4724 1718407655096 NativeController::tryGetFPGAVersion exit
4724 1718407655096 NativeController::tryGetFPGAVersion exit with exception No value present
4724 1718407655096 pro JtagIce3 [0x01] <<< 02 00 00 06 01 
4724 1718407655097 pro JtagIce3 [0x01] >>> 84 01 05 00 
4724 1718407655097 pro JtagIce3 [0x01] <<< 02 00 00 07 01 
4724 1718407655098 pro JtagIce3 [0x01] >>> 84 01 05 00 
4724 1718407655098 pro JtagIce3 [0x01] <<< 02 00 00 0A 01 
4724 1718407655099 pro JtagIce3 [0x01] >>> 84 01 00 11 
4724 1718407655099 NativeController::GetFirmwareInfo exit
4724 1718407655099 GEN4_TO_CONTROLLER_LOG:GEN4_CONNECT_INT_LOG Post:GetFirmwareInfo
4724 1718407655099 GEN4_TO_CONTROLLER_LOG:GEN4_CONNECT_INT_LOG Return Value
4724 1718407655099 GEN4_TO_CONTROLLER_LOG:GEN4_CONNECT_INT_LOG FirmwareInfo: Values:
4724 1718407655099 GEN4_TO_CONTROLLER_LOG:GEN4_CONNECT_INT_LOG FirmwareInfo: boot = false, bootVer = 5.5.0 (0x05.0x05.0x00), apVer = 1.45.7 (0x01.0x2d.0x07), fpgaVer = null, scriptVer = null, macAddress = , devID = 0, devID1 = 0, devSN0 = 0, devSN1 = 0, serialNumber = null, appCommitID = null, scriptCommitID = null, PCB_ID = 0
4724 1718407655099 GEN4_TO_CONTROLLER_LOG:GEN4_CONNECT_INT_LOG Return End

4724 1718407655099 GEN4_TO_CONTROLLER_LOG:GEN4_CONNECT_INT_LOG Pre:SetPowerInfo
4724 1718407655099 GEN4_TO_CONTROLLER_LOG:GEN4_CONNECT_INT_LOG Payload
4724 1718407655099 GEN4_TO_CONTROLLER_LOG:GEN4_CONNECT_INT_LOG PowerInfo: Values:
4724 1718407655099 GEN4_TO_CONTROLLER_LOG:GEN4_CONNECT_INT_LOG PowerInfo: shotDownSystem = true, isToolPower = false, voltage = 0.000000, useVppFirst = false, useLowVoltageProgramming = true, useMaintainActivePower = false
4724 1718407655099 GEN4_TO_CONTROLLER_LOG:GEN4_CONNECT_INT_LOG Payload End
4724 1718407655099 NativeController::GetVoltageInfo entry
4724 1718407655099 pro JtagIce3 [0x01] <<< 02 00 01 00 02 
4724 1718407655100 pro JtagIce3 [0x01] >>> 84 01 11 12 00 
4724 1718407655100 pro JtagIce3 [0x01] <<< 02 00 01 20 02 
4724 1718407655101 pro JtagIce3 [0x01] >>> 84 01 00 00 11 
4724 1718407655101 NativeController::GetVoltageInfo TSUP exit with exception + The requested command is not supported. (17)
4724 1718407655101 pro JtagIce3 [0x01] <<< 02 00 01 02 02 
4724 1718407655102 pro JtagIce3 [0x01] >>> 84 01 00 00 11 
4724 1718407655102 NativeController::GetVoltageInfo VUSB exit with exception + The requested command is not supported. (17)
4724 1718407655102 NativeController::GetVoltageInfo exit
4724 1718407655102 GEN4_TO_CONTROLLER_LOG:GEN4_CONNECT_INT_LOG Post:SetPowerInfo
4724 1718407655102 GEN4_TO_CONTROLLER_LOG:GEN4_CONNECT_INT_LOG Return Value
4724 1718407655102 GEN4_TO_CONTROLLER_LOG:GEN4_CONNECT_INT_LOG none
4724 1718407655102 GEN4_TO_CONTROLLER_LOG:GEN4_CONNECT_INT_LOG Return End

4724 1718407655102 GEN4_TO_CONTROLLER_LOG:GEN4_CONNECT_INT_LOG Pre:Disconnect
4724 1718407655102 GEN4_TO_CONTROLLER_LOG:GEN4_CONNECT_INT_LOG Payload
4724 1718407655102 GEN4_TO_CONTROLLER_LOG:GEN4_CONNECT_INT_LOG Payload End
4724 1718407655102 NativeController::Disconnect entry
4724 1718407655102 pro JtagIce3 [0x01] <<< 11 00 00 
4724 1718407655103 pro JtagIce3 [0x01] >>> 80 00 
4724 1718407655103 NativeController::Disconnect exit
4724 1718407655103 GEN4_TO_CONTROLLER_LOG:GEN4_CONNECT_INT_LOG Post:Disconnect
4724 1718407655103 GEN4_TO_CONTROLLER_LOG:GEN4_CONNECT_INT_LOG Return Value
4724 1718407655103 GEN4_TO_CONTROLLER_LOG:GEN4_CONNECT_INT_LOG none
4724 1718407655103 GEN4_TO_CONTROLLER_LOG:GEN4_CONNECT_INT_LOG Return End
4724 1718407655103 GEN4_CONNECT_DIAGNOSTICS:Removing plug and play observer com.microchip.mplab.mdbcore.RI4Tool.RI4ToolBase$RI4PlugNPlayObserver@2753442e
4724 1718407655103 GEN4_CONNECT_DIAGNOSTICS:Begin PlugNPlayObservers list dump:
4724 1718407655103 GEN4_CONNECT_DIAGNOSTICS:End PlugNPlayObservers list dump:
4724 1718407655204 GEN4_CONNECT_DIAGNOSTICS:Calling RIDbgToolCom.Disconnect
4724 1718407655204 GEN4_CONNECT_DIAGNOSTICS:Calling MPLABCommTool.Detach to remove tool from plug and play list
4724 1718407655204 GEN4_CONNECT_DIAGNOSTICS:Calling RIDbgToolCom.DisconnectFromMPlabComm
4724 1718407655204 GEN4_CONNECT_DIAGNOSTICS:Calling MPLABCommTool.Disconnect
5307 1718408423799 GEN4_CONNECT_DIAGNOSTICS:MPLABCommTool is NOT null
5307 1718408423799 GEN4_CONNECT_DIAGNOSTICS:AttachedToolPID = 2141, AttachedToolVID = 3eb
5307 1718408423799 GEN4_CONNECT_DIAGNOSTICS:transport type = USB
5307 1718408423799 GEN4_CONNECT_DIAGNOSTICS:AttachedToolPID = 2141, AttachedToolVID = 3eb
5307 1718408423800 com.microchip.mplab.mdbcore.RealICETool.RIDbgToolCom
5307 1718408423800 GEN4_CONNECT_DIAGNOSTICS:Before MPLABCommTool.Connect()
5307 1718408423800 GEN4_CONNECT_DIAGNOSTICS:After MPLABCommTool.Connect()
5307 1718408423800 GEN4_CONNECT_DIAGNOSTICS:MPLABCommTool.Connect() returned MPLABCOMM_NO_ERROR
5307 1718408423800 GEN4_CONNECT_DIAGNOSTICS:Attaching to MPLABCommTool plugnplay
5307 1718408423800 GEN4_CONNECT_DIAGNOSTICS:Adding new plug and play observer com.microchip.mplab.mdbcore.RI4Tool.RI4ToolBase$RI4PlugNPlayObserver@5d1d5830
5307 1718408423800 GEN4_CONNECT_DIAGNOSTICS:Begin PlugNPlayObservers list dump:
5307 1718408423800 GEN4_CONNECT_DIAGNOSTICS:com.microchip.mplab.mdbcore.RI4Tool.RI4ToolBase$RI4PlugNPlayObserver@5d1d5830
5307 1718408423800 GEN4_CONNECT_DIAGNOSTICS:End PlugNPlayObservers list dump:
5307 1718408423800 GEN4_CONNECT_DIAGNOSTICS:Registering for alternate PNP notifications. CommPnPCriteria.cPIDList = [2177, 2179, 217a, 2142, 2142], CommPnPCriteria.cSerialNumber = j42700073141

5307 1718408423818 GEN4_TO_CONTROLLER_LOG:GEN4_INIT_INT_LOG_ATtiny1627 Pre:init
5307 1718408423818 GEN4_TO_CONTROLLER_LOG:GEN4_INIT_INT_LOG_ATtiny1627 Payload
5307 1718408423818 GEN4_TO_CONTROLLER_LOG:GEN4_INIT_INT_LOG_ATtiny1627 DeviceInfo: Values:
5307 1718408423818 GEN4_TO_CONTROLLER_LOG:GEN4_INIT_INT_LOG_ATtiny1627 DeviceInfo: pcAddress = 7fffffffffffffff, Vpp = 5.00, useRowEraseIfVoltageIsLow = false, voltageBelowWhichUseRowErase = 0.00, deviceName = ATtiny1627, programmerType = 
5307 1718408423818 GEN4_TO_CONTROLLER_LOG:GEN4_INIT_INT_LOG_ATtiny1627 DeviceInfo: MemInfo values:
5307 1718408423818 GEN4_TO_CONTROLLER_LOG:GEN4_INIT_INT_LOG_ATtiny1627 DeviceInfo: mask = ffff, exists = true, startAddr = 00000000, endAddr = 00003fff, rowSize = 0040, rowEraseSize = 0040, addrInc = 0001, widthProgram = 0001
5307 1718408423818 GEN4_TO_CONTROLLER_LOG:GEN4_INIT_INT_LOG_ATtiny1627 DeviceInfo: mask = 00ff, exists = true, startAddr = 00821280, endAddr = 0083128a, rowSize = 0001, rowEraseSize = 0000, addrInc = 0001, widthProgram = 0001
5307 1718408423818 GEN4_TO_CONTROLLER_LOG:GEN4_INIT_INT_LOG_ATtiny1627 DeviceInfo: mask = 0000, exists = false, startAddr = 00000000, endAddr = 00000000, rowSize = 0000, rowEraseSize = 0000, addrInc = 0000, widthProgram = 0000
5307 1718408423818 GEN4_TO_CONTROLLER_LOG:GEN4_INIT_INT_LOG_ATtiny1627 DeviceInfo: mask = 00ff, exists = true, startAddr = 00001400, endAddr = 000014ff, rowSize = 0020, rowEraseSize = 0000, addrInc = 0001, widthProgram = 0001
5307 1718408423818 GEN4_TO_CONTROLLER_LOG:GEN4_INIT_INT_LOG_ATtiny1627 DeviceInfo: mask = 00ff, exists = true, startAddr = 00001300, endAddr = 0000131f, rowSize = 0020, rowEraseSize = 0000, addrInc = 0001, widthProgram = 0001
5307 1718408423818 GEN4_TO_CONTROLLER_LOG:GEN4_INIT_INT_LOG_ATtiny1627 DeviceInfo: mask = 0000, exists = false, startAddr = 00000000, endAddr = 00000000, rowSize = 0000, rowEraseSize = 0040, addrInc = 0000, widthProgram = 0000
5307 1718408423818 GEN4_TO_CONTROLLER_LOG:GEN4_INIT_INT_LOG_ATtiny1627 DeviceInfo: mask = 0000, exists = false, startAddr = 00000000, endAddr = 00000000, rowSize = 0000, rowEraseSize = 0000, addrInc = 0001, widthProgram = 0001
5307 1718408423818 GEN4_TO_CONTROLLER_LOG:GEN4_INIT_INT_LOG_ATtiny1627 DeviceInfo: mask = 0000, exists = false, startAddr = 00000000, endAddr = 00000000, rowSize = 0000, rowEraseSize = 0000, addrInc = 0000, widthProgram = 0000
5307 1718408423818 GEN4_TO_CONTROLLER_LOG:GEN4_INIT_INT_LOG_ATtiny1627 DeviceInfo: mask = 0000, exists = false, startAddr = 00000000, endAddr = 00000000, rowSize = 0000, rowEraseSize = 0000, addrInc = 0000, widthProgram = 0000
5307 1718408423818 GEN4_TO_CONTROLLER_LOG:GEN4_INIT_INT_LOG_ATtiny1627 DeviceInfo: mask = 0000, exists = false, startAddr = 00000000, endAddr = 00000000, rowSize = 0000, rowEraseSize = 0000, addrInc = 0000, widthProgram = 0000
5307 1718408423818 GEN4_TO_CONTROLLER_LOG:GEN4_INIT_INT_LOG_ATtiny1627 DeviceInfo: mask = 0000, exists = false, startAddr = 00000000, endAddr = 00000000, rowSize = 0000, rowEraseSize = 0000, addrInc = 0000, widthProgram = 0000
5307 1718408423818 GEN4_TO_CONTROLLER_LOG:GEN4_INIT_INT_LOG_ATtiny1627 DeviceInfo: mask = 0000, exists = false, startAddr = 00000000, endAddr = 00000000, rowSize = 0000, rowEraseSize = 0000, addrInc = 0001, widthProgram = 0001
5307 1718408423818 GEN4_TO_CONTROLLER_LOG:GEN4_INIT_INT_LOG_ATtiny1627 DeviceInfo: mask = 0000, exists = false, startAddr = 00000000, endAddr = 00000000, rowSize = 0000, rowEraseSize = 0000, addrInc = 0000, widthProgram = 0000
5307 1718408423818 GEN4_TO_CONTROLLER_LOG:GEN4_INIT_INT_LOG_ATtiny1627 DeviceInfo: mask = 0000, exists = false, startAddr = 00000000, endAddr = 00000000, rowSize = 0000, rowEraseSize = 0000, addrInc = 0000, widthProgram = 0000
5307 1718408423818 GEN4_TO_CONTROLLER_LOG:GEN4_INIT_INT_LOG_ATtiny1627 DeviceInfo: mask = 0000, exists = false, startAddr = 00000000, endAddr = 00000000, rowSize = 0000, rowEraseSize = 0000, addrInc = 0000, widthProgram = 0000
5307 1718408423818 GEN4_TO_CONTROLLER_LOG:GEN4_INIT_INT_LOG_ATtiny1627 DeviceInfo: mask = 0000, exists = false, startAddr = 00000000, endAddr = 00000000, rowSize = 0000, rowEraseSize = 0000, addrInc = 0000, widthProgram = 0000
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
5307 1718408423818 GEN4_TO_CONTROLLER_LOG:GEN4_INIT_INT_LOG_ATtiny1627 com.microchip.mplab.libs.atmelice.implementations.ConnectInterface@67243b92
5307 1718408423818 GEN4_TO_CONTROLLER_LOG:GEN4_INIT_INT_LOG_ATtiny1627 Return End

5307 1718408423818 GEN4_TO_CONTROLLER_LOG:GEN4_INIT_INT_LOG_ATtiny1627 Pre:GetInterfaceProvider
5307 1718408423818 GEN4_TO_CONTROLLER_LOG:GEN4_INIT_INT_LOG_ATtiny1627 Payload
5307 1718408423818 GEN4_TO_CONTROLLER_LOG:GEN4_INIT_INT_LOG_ATtiny1627 RI4ControllerDiagnosticsInterface
5307 1718408423818 GEN4_TO_CONTROLLER_LOG:GEN4_INIT_INT_LOG_ATtiny1627 Payload End
5307 1718408423818 GEN4_TO_CONTROLLER_LOG:GEN4_INIT_INT_LOG_ATtiny1627 Post:GetInterfaceProvider
5307 1718408423818 GEN4_TO_CONTROLLER_LOG:GEN4_INIT_INT_LOG_ATtiny1627 Return Value
5307 1718408423818 GEN4_TO_CONTROLLER_LOG:GEN4_INIT_INT_LOG_ATtiny1627 com.microchip.mplab.libs.atmelice.implementations.UnimplementedDiagnostics@3f5a97ae
5307 1718408423818 GEN4_TO_CONTROLLER_LOG:GEN4_INIT_INT_LOG_ATtiny1627 Return End

5307 1718408423818 GEN4_TO_CONTROLLER_LOG:GEN4_INIT_INT_LOG_ATtiny1627 Pre:GetInterfaceProvider
5307 1718408423818 GEN4_TO_CONTROLLER_LOG:GEN4_INIT_INT_LOG_ATtiny1627 Payload
5307 1718408423818 GEN4_TO_CONTROLLER_LOG:GEN4_INIT_INT_LOG_ATtiny1627 ProgrammerToGo
5307 1718408423818 GEN4_TO_CONTROLLER_LOG:GEN4_INIT_INT_LOG_ATtiny1627 Payload End
5307 1718408423818 GEN4_TO_CONTROLLER_LOG:GEN4_INIT_INT_LOG_ATtiny1627 Post:GetInterfaceProvider
5307 1718408423818 GEN4_TO_CONTROLLER_LOG:GEN4_INIT_INT_LOG_ATtiny1627 Return Value
5307 1718408423818 GEN4_TO_CONTROLLER_LOG:GEN4_INIT_INT_LOG_ATtiny1627 null
5307 1718408423818 GEN4_TO_CONTROLLER_LOG:GEN4_INIT_INT_LOG_ATtiny1627 Return End

5307 1718408423818 GEN4_TO_CONTROLLER_LOG:GEN4_INIT_INT_LOG_ATtiny1627 Pre:GetInterfaceProvider
5307 1718408423818 GEN4_TO_CONTROLLER_LOG:GEN4_INIT_INT_LOG_ATtiny1627 Payload
5307 1718408423818 GEN4_TO_CONTROLLER_LOG:GEN4_INIT_INT_LOG_ATtiny1627 Status
5307 1718408423818 GEN4_TO_CONTROLLER_LOG:GEN4_INIT_INT_LOG_ATtiny1627 Payload End
5307 1718408423818 GEN4_TO_CONTROLLER_LOG:GEN4_INIT_INT_LOG_ATtiny1627 Post:GetInterfaceProvider
5307 1718408423818 GEN4_TO_CONTROLLER_LOG:GEN4_INIT_INT_LOG_ATtiny1627 Return Value
5307 1718408423818 GEN4_TO_CONTROLLER_LOG:GEN4_INIT_INT_LOG_ATtiny1627 null
5307 1718408423818 GEN4_TO_CONTROLLER_LOG:GEN4_INIT_INT_LOG_ATtiny1627 Return End

5307 1718408423819 GEN4_TO_CONTROLLER_LOG:GEN4_CONNECT_INT_LOG Pre:EstablishCommunincations
5307 1718408423819 GEN4_TO_CONTROLLER_LOG:GEN4_CONNECT_INT_LOG Payload
5307 1718408423819 GEN4_TO_CONTROLLER_LOG:GEN4_CONNECT_INT_LOG com.microchip.mplab.mdbcore.AtmelIceScripting.AIceScriptingCom@75d2c54d
5307 1718408423819 GEN4_TO_CONTROLLER_LOG:GEN4_CONNECT_INT_LOG Payload End
5307 1718408423819 NativeController::EstablishCommunincations entry
5307 1718408423819 pro JtagIce3 [0x00] <<< 00 00 00 
5307 1718408423820 pro JtagIce3 [0x00] >>> 81 00 00 01 11 12 13 14 
5307 1718408423820 pro JtagIce3 [0x01] <<< 10 00 
5307 1718408423822 pro JtagIce3 [0x01] >>> 80 00 
5307 1718408423822 pro JtagIce3 [0x00] <<< 00 00 03 
5307 1718408423823 pro JtagIce3 [0x00] >>> 81 00 01 04 05 06 07 
5307 1718408423823 pro JtagIce3 [0x01] <<< 02 00 01 20 02 
5307 1718408423824 pro JtagIce3 [0x01] >>> 84 01 00 00 11 
5307 1718408423824 NativeController::EstablishCommunincations exit
5307 1718408423824 GEN4_TO_CONTROLLER_LOG:GEN4_CONNECT_INT_LOG Post:EstablishCommunincations
5307 1718408423824 GEN4_TO_CONTROLLER_LOG:GEN4_CONNECT_INT_LOG Return Value
5307 1718408423824 GEN4_TO_CONTROLLER_LOG:GEN4_CONNECT_INT_LOG true
5307 1718408423824 GEN4_TO_CONTROLLER_LOG:GEN4_CONNECT_INT_LOG Return End

5307 1718408423824 GEN4_TO_CONTROLLER_LOG:GEN4_CONNECT_INT_LOG Pre:GetFirmwareInfo
5307 1718408423824 GEN4_TO_CONTROLLER_LOG:GEN4_CONNECT_INT_LOG Payload
5307 1718408423824 GEN4_TO_CONTROLLER_LOG:GEN4_CONNECT_INT_LOG null
5307 1718408423824 GEN4_TO_CONTROLLER_LOG:GEN4_CONNECT_INT_LOG Payload End
5307 1718408423824 NativeController::GetFirmwareInfo entry
5307 1718408423824 pro JtagIce3 [0x01] <<< 02 00 00 00 01 
5307 1718408423825 pro JtagIce3 [0x01] >>> 84 01 00 00 
5307 1718408423825 NativeController::getFirmwareVersion entry
5307 1718408423825 pro JtagIce3 [0x01] <<< 02 00 00 01 01 
5307 1718408423826 pro JtagIce3 [0x01] >>> 84 01 01 00 
5307 1718408423826 pro JtagIce3 [0x01] <<< 02 00 00 02 01 
5307 1718408423827 pro JtagIce3 [0x01] >>> 84 01 2D 00 
5307 1718408423827 pro JtagIce3 [0x01] <<< 02 00 00 03 02 
5307 1718408423828 pro JtagIce3 [0x01] >>> 84 01 07 00 00 
5307 1718408423828 NativeController::getFirmwareVersion exit
5307 1718408423828 pro JtagIce3 [0x01] <<< 02 00 00 09 01 
5307 1718408423829 pro JtagIce3 [0x01] >>> 84 01 00 11 
5307 1718408423829 NativeController::tryGetFPGAVersion entry
5307 1718408423829 pro JtagIce3 [0x01] <<< 02 00 00 10 01 
5307 1718408423830 pro JtagIce3 [0x01] >>> 84 01 00 11 
5307 1718408423830 pro JtagIce3 [0x01] <<< 02 00 00 11 01 
5307 1718408423831 pro JtagIce3 [0x01] >>> 84 01 00 11 
5307 1718408423831 pro JtagIce3 [0x01] <<< 02 00 00 12 01 
5307 1718408423832 pro JtagIce3 [0x01] >>> 84 01 00 11 
5307 1718408423832 NativeController::tryGetFPGAVersion exit
5307 1718408423832 NativeController::tryGetFPGAVersion exit with exception No value present
5307 1718408423832 pro JtagIce3 [0x01] <<< 02 00 00 06 01 
5307 1718408423833 pro JtagIce3 [0x01] >>> 84 01 05 00 
5307 1718408423833 pro JtagIce3 [0x01] <<< 02 00 00 07 01 
5307 1718408423834 pro JtagIce3 [0x01] >>> 84 01 05 00 
5307 1718408423834 pro JtagIce3 [0x01] <<< 02 00 00 0A 01 
5307 1718408423835 pro JtagIce3 [0x01] >>> 84 01 00 11 
5307 1718408423835 NativeController::GetFirmwareInfo exit
5307 1718408423835 GEN4_TO_CONTROLLER_LOG:GEN4_CONNECT_INT_LOG Post:GetFirmwareInfo
5307 1718408423835 GEN4_TO_CONTROLLER_LOG:GEN4_CONNECT_INT_LOG Return Value
5307 1718408423835 GEN4_TO_CONTROLLER_LOG:GEN4_CONNECT_INT_LOG FirmwareInfo: Values:
5307 1718408423835 GEN4_TO_CONTROLLER_LOG:GEN4_CONNECT_INT_LOG FirmwareInfo: boot = false, bootVer = 5.5.0 (0x05.0x05.0x00), apVer = 1.45.7 (0x01.0x2d.0x07), fpgaVer = null, scriptVer = null, macAddress = , devID = 0, devID1 = 0, devSN0 = 0, devSN1 = 0, serialNumber = null, appCommitID = null, scriptCommitID = null, PCB_ID = 0
5307 1718408423835 GEN4_TO_CONTROLLER_LOG:GEN4_CONNECT_INT_LOG Return End
5307 1718408423835 GEN4_CONNECT_DIAGNOSTICS:ENTERING: com.microchip.mplab.mdbcore.RI4Tool.ConnectionHandler.CheckForFWUpdates()
5307 1718408423835 GEN4_CONNECT_DIAGNOSTICS:Created FirmwareUpdateHandler com.microchip.mplab.mdbcore.AtmelIceScripting.OperationHandlers.AIceScriptingFirmwareUpdateHandler@2fe23116

5307 1718408423836 GEN4_TO_CONTROLLER_LOG:GEN4_CONNECT_INT_LOG Pre:SetUpdateFirmwareInfo
5307 1718408423836 GEN4_TO_CONTROLLER_LOG:GEN4_CONNECT_INT_LOG Payload
5307 1718408423836 GEN4_TO_CONTROLLER_LOG:GEN4_CONNECT_INT_LOG UpdateFirmwareInfo: Values:
5307 1718408423836 GEN4_TO_CONTROLLER_LOG:GEN4_CONNECT_INT_LOG UpdateFirmwareInfo: license = dCejLCt9ZV4fWdqYk3htQgdNYCC2nccSTvVdTD2oCjW3gRUtjikRtla11IiYo1wq, updateId = 2147483647
5307 1718408423836 GEN4_TO_CONTROLLER_LOG:GEN4_CONNECT_INT_LOG Payload End
5307 1718408423836 GEN4_TO_CONTROLLER_LOG:GEN4_CONNECT_INT_LOG Post:SetUpdateFirmwareInfo
5307 1718408423836 GEN4_TO_CONTROLLER_LOG:GEN4_CONNECT_INT_LOG Return Value
5307 1718408423836 GEN4_TO_CONTROLLER_LOG:GEN4_CONNECT_INT_LOG none
5307 1718408423836 GEN4_TO_CONTROLLER_LOG:GEN4_CONNECT_INT_LOG Return End
5307 1718408423836 GEN4_CONNECT_DIAGNOSTICS:EXITING: com.microchip.mplab.mdbcore.RI4Tool.ConnectionHandler.CheckForFWUpdates()

5307 1718408423836 GEN4_TO_CONTROLLER_LOG:GEN4_CONNECT_INT_LOG Pre:SetPowerInfo
5307 1718408423836 GEN4_TO_CONTROLLER_LOG:GEN4_CONNECT_INT_LOG Payload
5307 1718408423836 GEN4_TO_CONTROLLER_LOG:GEN4_CONNECT_INT_LOG PowerInfo: Values:
5307 1718408423836 GEN4_TO_CONTROLLER_LOG:GEN4_CONNECT_INT_LOG PowerInfo: shotDownSystem = false, isToolPower = false, voltage = 5.000000, useVppFirst = false, useLowVoltageProgramming = true, useMaintainActivePower = false
5307 1718408423836 GEN4_TO_CONTROLLER_LOG:GEN4_CONNECT_INT_LOG Payload End
5307 1718408423836 NativeController::GetVoltageInfo entry
5307 1718408423836 pro JtagIce3 [0x01] <<< 02 00 01 00 02 
5307 1718408423837 pro JtagIce3 [0x01] >>> 84 01 03 12 00 
5307 1718408423837 pro JtagIce3 [0x01] <<< 02 00 01 20 02 
5307 1718408423838 pro JtagIce3 [0x01] >>> 84 01 00 00 11 
5307 1718408423838 NativeController::GetVoltageInfo TSUP exit with exception + The requested command is not supported. (17)
5307 1718408423838 pro JtagIce3 [0x01] <<< 02 00 01 02 02 
5307 1718408423839 pro JtagIce3 [0x01] >>> 84 01 00 00 11 
5307 1718408423839 NativeController::GetVoltageInfo VUSB exit with exception + The requested command is not supported. (17)
5307 1718408423839 NativeController::GetVoltageInfo exit
5307 1718408423839 GEN4_TO_CONTROLLER_LOG:GEN4_CONNECT_INT_LOG Post:SetPowerInfo
5307 1718408423839 GEN4_TO_CONTROLLER_LOG:GEN4_CONNECT_INT_LOG Return Value
5307 1718408423839 GEN4_TO_CONTROLLER_LOG:GEN4_CONNECT_INT_LOG none
5307 1718408423839 GEN4_TO_CONTROLLER_LOG:GEN4_CONNECT_INT_LOG Return End

5307 1718408423839 GEN4_TO_CONTROLLER_LOG:GEN4_CONNECT_INT_LOG Pre:GetVoltageInfo
5307 1718408423839 GEN4_TO_CONTROLLER_LOG:GEN4_CONNECT_INT_LOG Payload
5307 1718408423839 GEN4_TO_CONTROLLER_LOG:GEN4_CONNECT_INT_LOG null
5307 1718408423839 GEN4_TO_CONTROLLER_LOG:GEN4_CONNECT_INT_LOG Payload End
5307 1718408423839 NativeController::GetVoltageInfo entry
5307 1718408423839 pro JtagIce3 [0x01] <<< 02 00 01 00 02 
5307 1718408423840 pro JtagIce3 [0x01] >>> 84 01 09 12 00 
5307 1718408423840 pro JtagIce3 [0x01] <<< 02 00 01 20 02 
5307 1718408423841 pro JtagIce3 [0x01] >>> 84 01 00 00 11 
5307 1718408423841 NativeController::GetVoltageInfo TSUP exit with exception + The requested command is not supported. (17)
5307 1718408423841 pro JtagIce3 [0x01] <<< 02 00 01 02 02 
5307 1718408423842 pro JtagIce3 [0x01] >>> 84 01 00 00 11 
5307 1718408423842 NativeController::GetVoltageInfo VUSB exit with exception + The requested command is not supported. (17)
5307 1718408423842 NativeController::GetVoltageInfo exit
5307 1718408423842 GEN4_TO_CONTROLLER_LOG:GEN4_CONNECT_INT_LOG Post:GetVoltageInfo
5307 1718408423842 GEN4_TO_CONTROLLER_LOG:GEN4_CONNECT_INT_LOG Return Value
5307 1718408423842 GEN4_TO_CONTROLLER_LOG:GEN4_CONNECT_INT_LOG VoltagesInfo: Values:
5307 1718408423842 GEN4_TO_CONTROLLER_LOG:GEN4_CONNECT_INT_LOG VoltagesInfo: internalVdd = 0, internalVpp = 0, targetVdd = 0, targetVpp = -2147483648, vddSense = 4617, temp = 0, vddCurrentSense = 0, vddVoltageSense = -2147483648
5307 1718408423842 GEN4_TO_CONTROLLER_LOG:GEN4_CONNECT_INT_LOG Return End

5307 1718408423842 GEN4_TO_CONTROLLER_LOG:GEN4_CONNECT_INT_LOG Pre:SetLEDBrightness
5307 1718408423842 GEN4_TO_CONTROLLER_LOG:GEN4_CONNECT_INT_LOG Payload
5307 1718408423842 GEN4_TO_CONTROLLER_LOG:GEN4_CONNECT_INT_LOG 5
5307 1718408423842 GEN4_TO_CONTROLLER_LOG:GEN4_CONNECT_INT_LOG Payload End
5307 1718408423842 GEN4_TO_CONTROLLER_LOG:GEN4_CONNECT_INT_LOG Post:SetLEDBrightness
5307 1718408423842 GEN4_TO_CONTROLLER_LOG:GEN4_CONNECT_INT_LOG Return Value
5307 1718408423842 GEN4_TO_CONTROLLER_LOG:GEN4_CONNECT_INT_LOG none
5307 1718408423842 GEN4_TO_CONTROLLER_LOG:GEN4_CONNECT_INT_LOG Return End

5307 1718408423842 GEN4_TO_CONTROLLER_LOG:GEN4_CONNECT_INT_LOG Pre:SetToolInfo
5307 1718408423842 GEN4_TO_CONTROLLER_LOG:GEN4_CONNECT_INT_LOG Payload
5307 1718408423842 GEN4_TO_CONTROLLER_LOG:GEN4_CONNECT_INT_LOG ToolInfo: Values:
5307 1718408423842 GEN4_TO_CONTROLLER_LOG:GEN4_CONNECT_INT_LOG ToolInfo: speedLevel = 1, PGCResistance = 4700, PGDResistance = 4700, PGCPullDir = PullDown, PGDPullDir = PullDown, ICSPSelected = Wire2
5307 1718408423842 GEN4_TO_CONTROLLER_LOG:GEN4_CONNECT_INT_LOG Payload End
5307 1718408423842 GEN4_TO_CONTROLLER_LOG:GEN4_CONNECT_INT_LOG Post:SetToolInfo
5307 1718408423842 GEN4_TO_CONTROLLER_LOG:GEN4_CONNECT_INT_LOG Return Value
5307 1718408423842 GEN4_TO_CONTROLLER_LOG:GEN4_CONNECT_INT_LOG none
5307 1718408423842 GEN4_TO_CONTROLLER_LOG:GEN4_CONNECT_INT_LOG Return End

5307 1718408423843 GEN4_TO_CONTROLLER_LOG:GEN4_CONNECT_INT_LOG Pre:GetTargetIDInfo
5307 1718408423843 GEN4_TO_CONTROLLER_LOG:GEN4_CONNECT_INT_LOG Payload
5307 1718408423843 GEN4_TO_CONTROLLER_LOG:GEN4_CONNECT_INT_LOG null
5307 1718408423843 GEN4_TO_CONTROLLER_LOG:GEN4_CONNECT_INT_LOG Payload End
5307 1718408423843 NativeController::GetTargetIDInfo entry
5307 1718408423843 pro JtagIce3 [0x12] <<< 01 00 01 31 02 F4 01 
5307 1718408423844 pro JtagIce3 [0x12] >>> 80 00 
5307 1718408423844 pro JtagIce3 [0x12] <<< 01 00 00 00 01 05 
5307 1718408423845 pro JtagIce3 [0x12] >>> 80 00 
5307 1718408423845 pro JtagIce3 [0x12] <<< 01 00 00 01 01 01 
5307 1718408423846 pro JtagIce3 [0x12] >>> 80 00 
5307 1718408423846 pro JtagIce3 [0x12] <<< 01 00 01 00 01 08 
5307 1718408423847 pro JtagIce3 [0x12] >>> 80 00 
5307 1718408423847 pro JtagIce3 [0x12] <<< 01 00 02 00 30 00 80 40 20 00 10 80 0F 94 11 8C 0A 98 08 DC 05 EE 02 00 40 00 00 00 01 20 00 0A 05 FF 00 FF 00 00 14 00 13 00 11 80 12 8A 12 28 94 00 00 00 00 
5307 1718408423848 pro JtagIce3 [0x12] >>> 80 00 
5307 1718408423848 pro JtagIce3 [0x12] <<< 01 00 03 06 01 00 
5307 1718408423849 pro JtagIce3 [0x12] >>> 80 00 
5307 1718408423849 pro JtagIce3 [0x12] <<< 10 00 00 
5307 1718408423976 pro JtagIce3 [0x12] >>> A0 00 19 
5307 1718408423976 NativeController::GetTargetIDInfo exit with exception PDI physical timed out. (25)
