RichardSefton/AUV/(threads)

Thread 1 (2024-05-29):

Proof of Concept: I2C

RichardSefton, 2024-05-29:
**Proof of concept**

For this proof of concept, two MCUs should be configured: One as a host, one as a client. The host should be able to issue instructions to the client to control an LED on the client.

RichardSefton, 2024-05-29:
- [ ] Investigate and research I2C
- [ ] Create client code
- [ ] Create host code
- [ ] Make host control client

Closed 2024-05-29.

Thread 10 (2024-05-29):

Source suitable material for project vessel

RichardSefton, 2024-05-29:
The vessel requires a suitable material to operate underwater.

The material should be easily waterproofed and withstand pressure up to a certain distance.

RichardSefton, 2024-05-29:
- [ ]  Look at plastic tubs
- [ ] Look at plastic tubing
- [ ] Research water pressure effects

Thread 11 (2024-05-29):

Get PCBs fabricated for individual modules

RichardSefton, 2024-05-29:
Design and get the pcbs for all project modules fabricated.

This is a requirement as breadboards could present loose connections and kill the device while it is operating.

Thread 12 (2024-05-29):

Find suitable power source (battery of the required voltage)

RichardSefton, 2024-05-29:
The AUV will require a power source

This should be a battery.

The battery should be at minimum powerful enough to control the devices that consume the most power (motors).

Voltage dividors will be required to not cook the MCUs so we will need a module to control this.

Thread 13 (2024-05-29):

Make vessel

RichardSefton, 2024-05-29:
An outer hull for the AUV will need to be contructed in the chosen material

This must be water tight and tested before electronics are added.

Shape tbd.

Thread 2 (2024-05-29):

Proof of Concept: Sonar

RichardSefton, 2024-05-29:
There is a requirement to make a sonar from scratch.

This should be able to detect the distance to an object.

Initial test will be over the air distance detection.

RichardSefton, 2024-05-29:
- [ ] Make Transmitting transducer emit a signal
- [ ] Receiving transducer receives emitted signal
- [ ] Receiver detects signal bounced off object
- [ ] Clean receiver signal
- [ ] ADC conversion to allow MCU to react to receiver signal
- [ ] Perform an action based on received signal on reaching a threshold

Thread 3 (2024-05-29):

Make Sonar module tuned for underwater applications

RichardSefton, 2024-05-29:
Building off the Proof of Concept Sonar, this will be the groundwork of the Sonar Module.

The Sonar module should progress to detect objects underwater.

Currently it is an unknown if the transducers require direct exposure to the water.

This may require tuning of the clock speed since speed of sound underwater is greater than ota

Thread 7 (2024-05-29):

Add motors for propulsion and direction control

RichardSefton, 2024-05-29:
Using a new MCU, Create devices to control motors.

This should have an I2C integration so it can be issued instructions from a Host controller.

The modules should simply drive a motor.

Thread 8 (2024-05-29):

Add motor for depth control

RichardSefton, 2024-05-29:
Using a new MCU, drive a motor that will controll the depth of the AUV

This should have an I2C integration so it can be issued instructions from a central host.

Thread 9 (2024-05-29):

Make algorithm to control actuators based on sonar ping results

RichardSefton, 2024-05-29:
Combine the motor driving modules with the controlled sonar modules so the results of the sonar pings will issue instructions to the motor modules to control the device.

Specific scenarios:

| Obstacle Direction | Action |
| --- | --- |
| Top | Stop and Go Down |
| Bottom | Stop and Go Up |
| Left | Stop and Turn Right |
| Right | Stop and Turn Left |
| Front | Reverse |
