RichardSefton/AUV/assesment/assets/AUV Drawing_Main v4.pdf

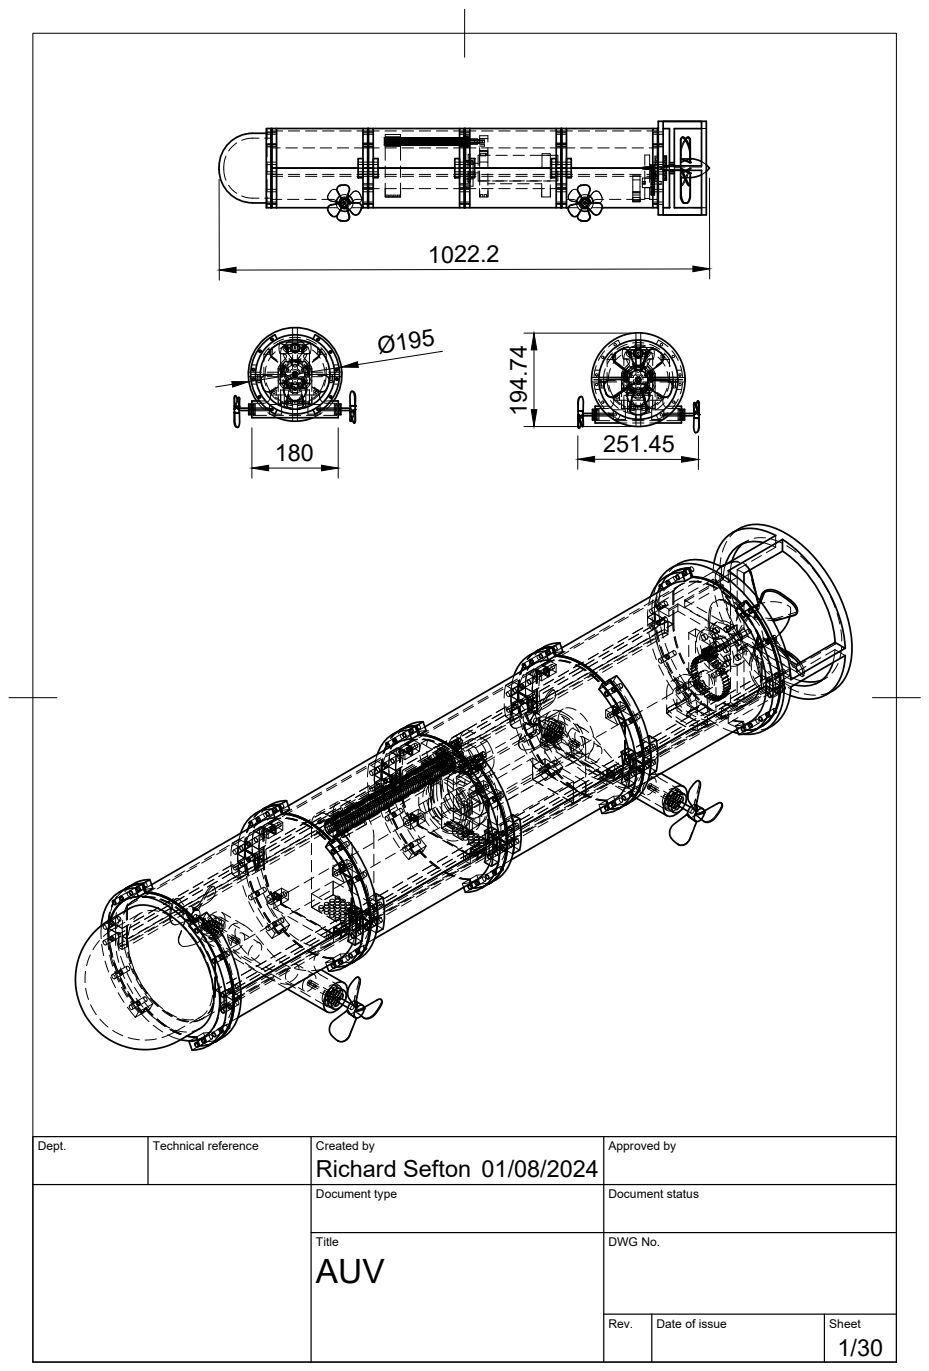
[picture p52: page 1]
Dept.; Technical reference; Created by; Approved by; Document type; Document status; Title; DWG No.; Rev.; Date of issue; Sheet; Richard Sefton

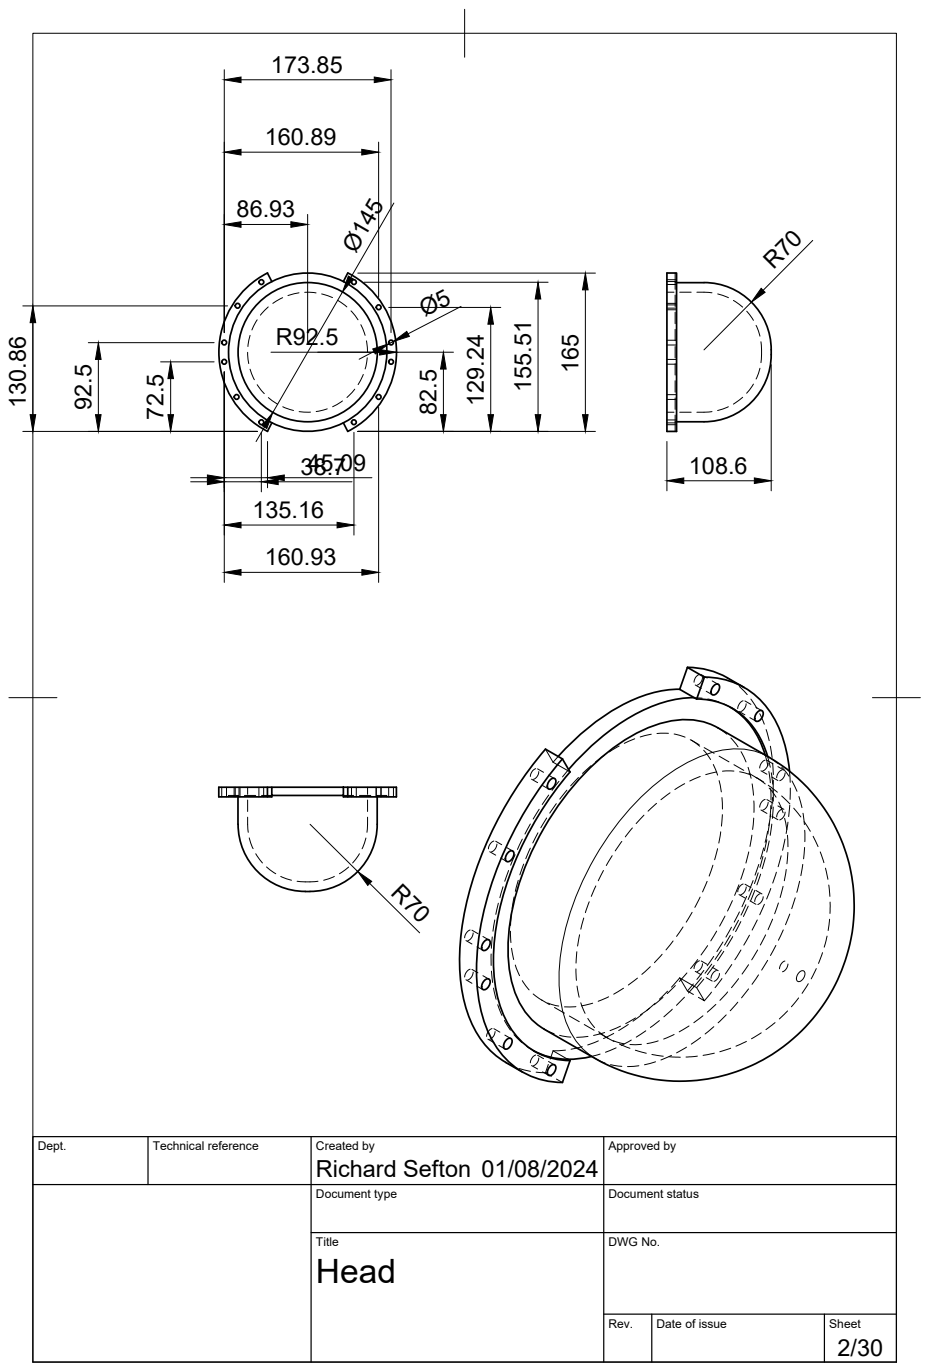
[picture p53: page 2]

Dept. | Technical reference | Created by Richard Sefton 01/08/2024 | Approved by

Document type | Document status

Title Head | DWG No.

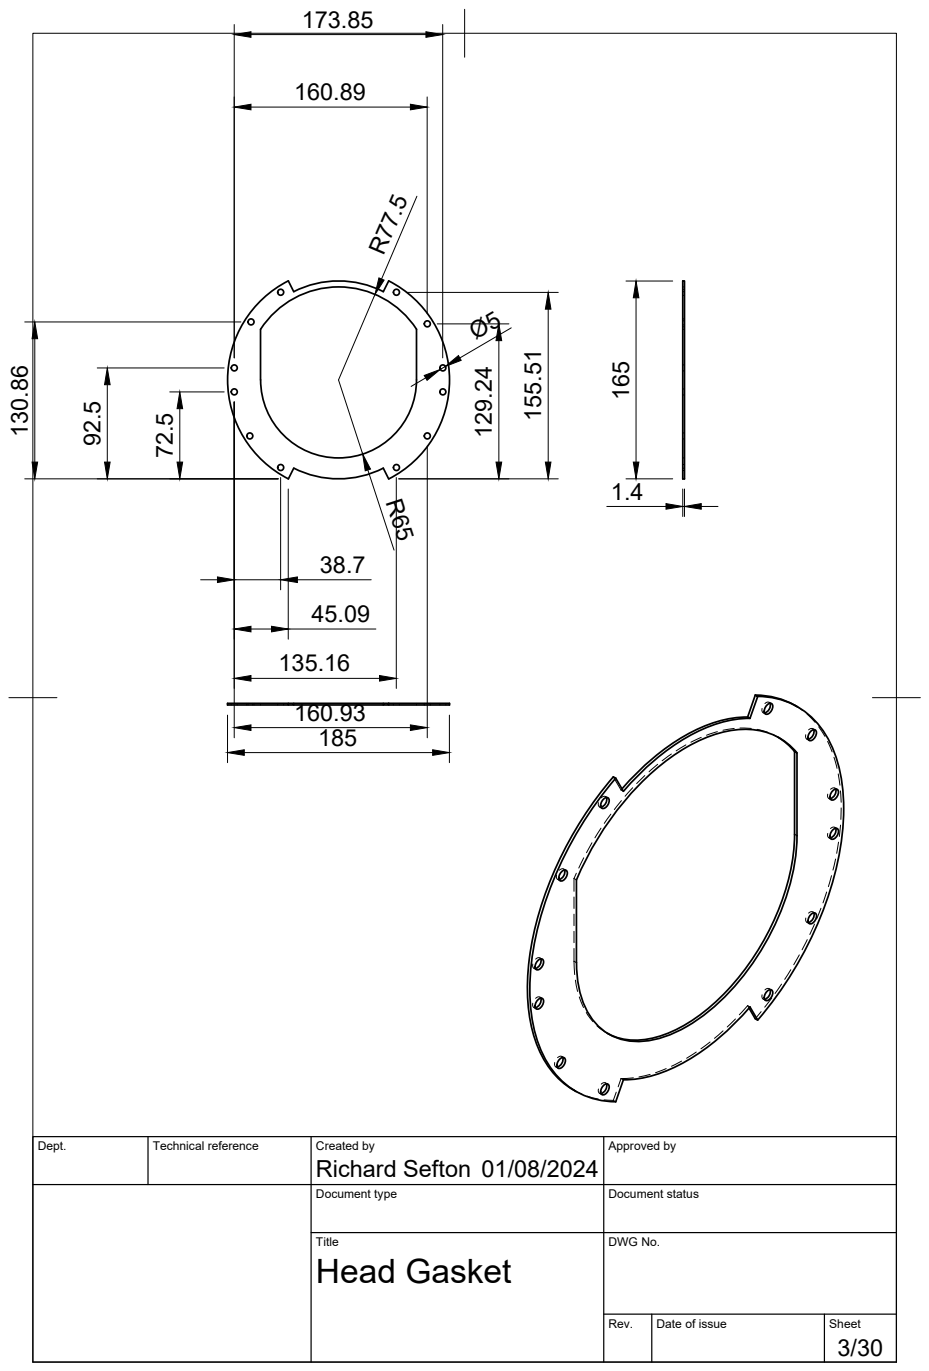
[picture p54: page 3]

Dept. | Technical reference | Created by Richard Sefton 01/08/2024 | Approved by

Document type | Document status

Title Head Gasket | DWG No.

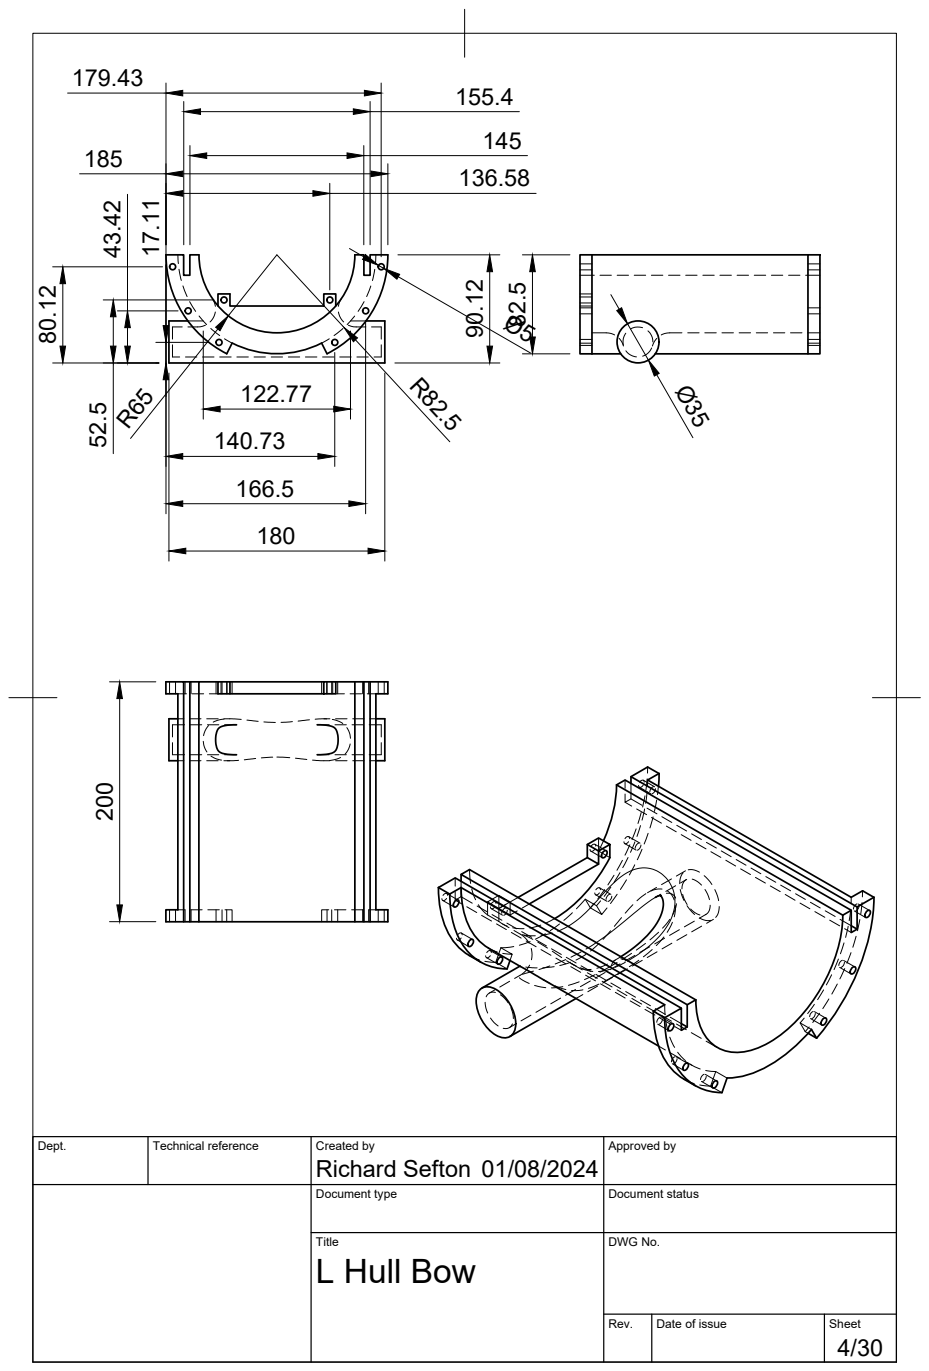
[picture p55: page 4]

Dept. | Technical reference | Created by Richard Sefton 01/08/2024 | Approved by

Document type | Document status

Title L Hull Bow | DWG No.

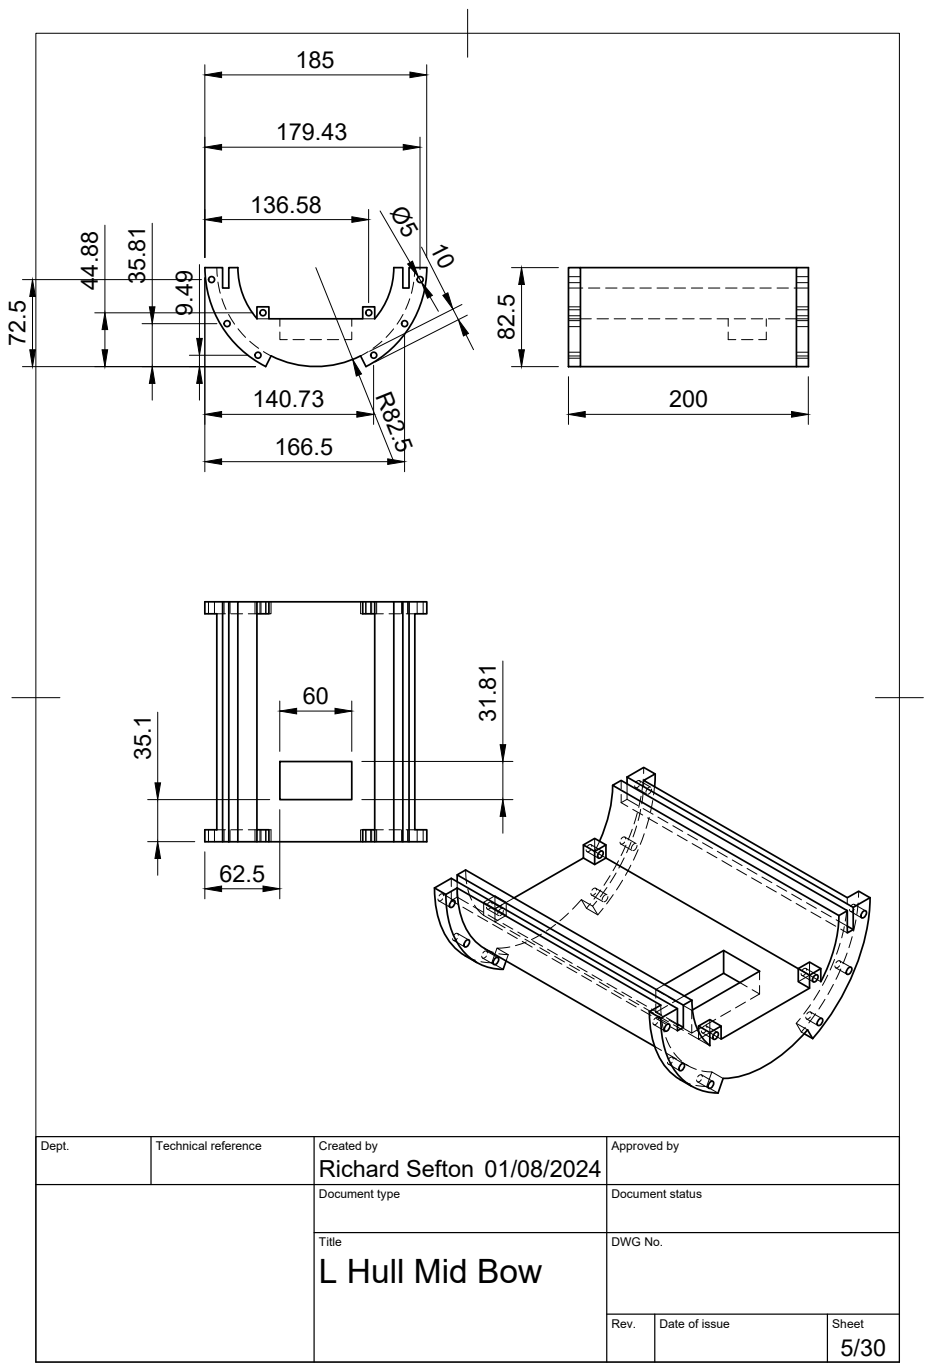
[picture p56: page 5]

Dept. | Technical reference | Created by Richard Sefton 01/08/2024 | Approved by

Document type | Document status

Title L Hull Mid Bow | DWG No.

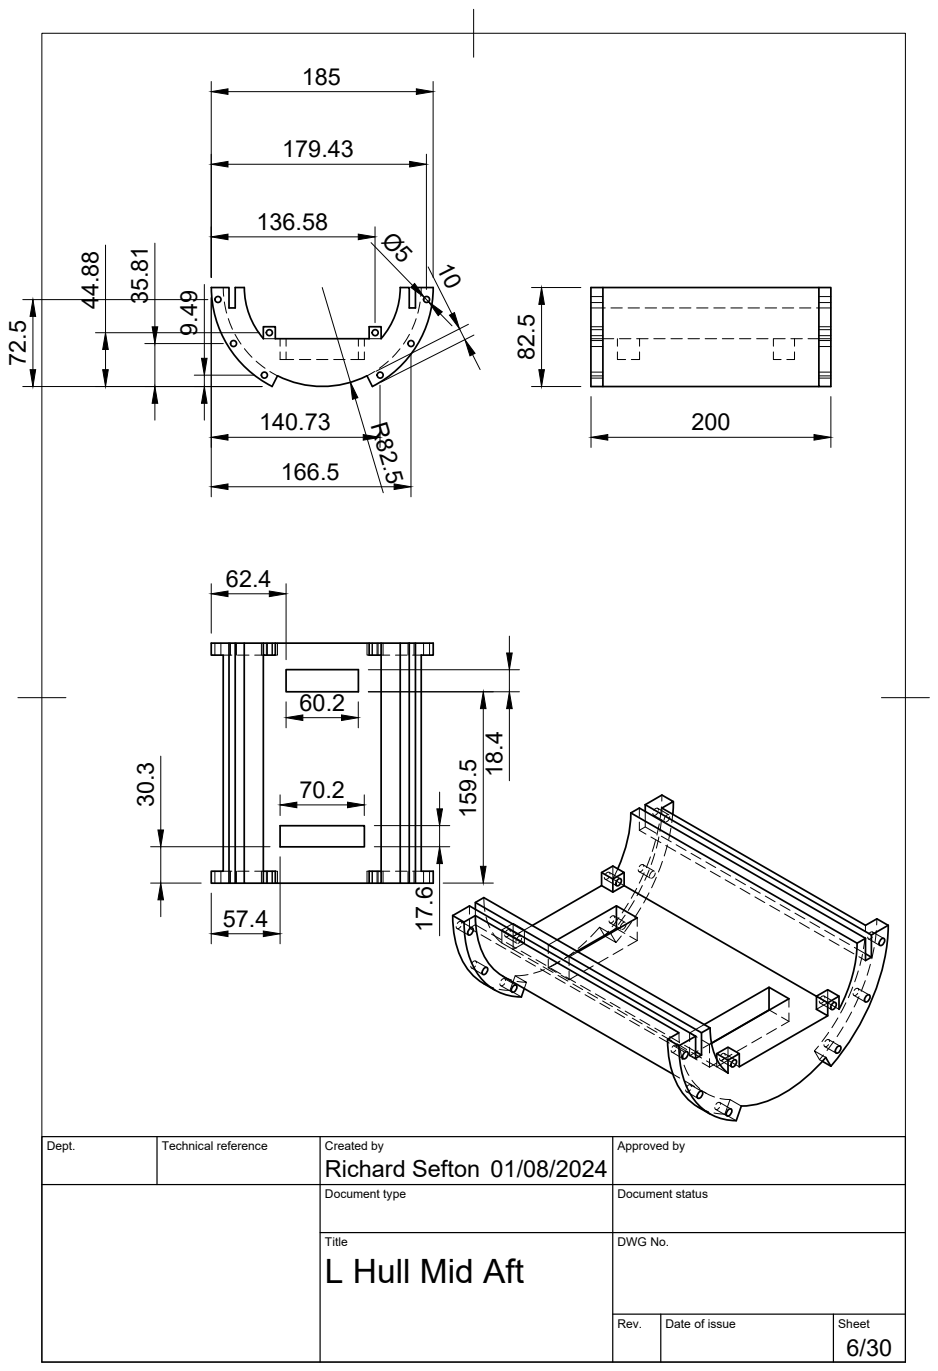
[picture p57: page 6]

Dept. | Technical reference | Created by Richard Sefton 01/08/2024 | Approved by

Document type | Document status

Title L Hull Mid Aft | DWG No.

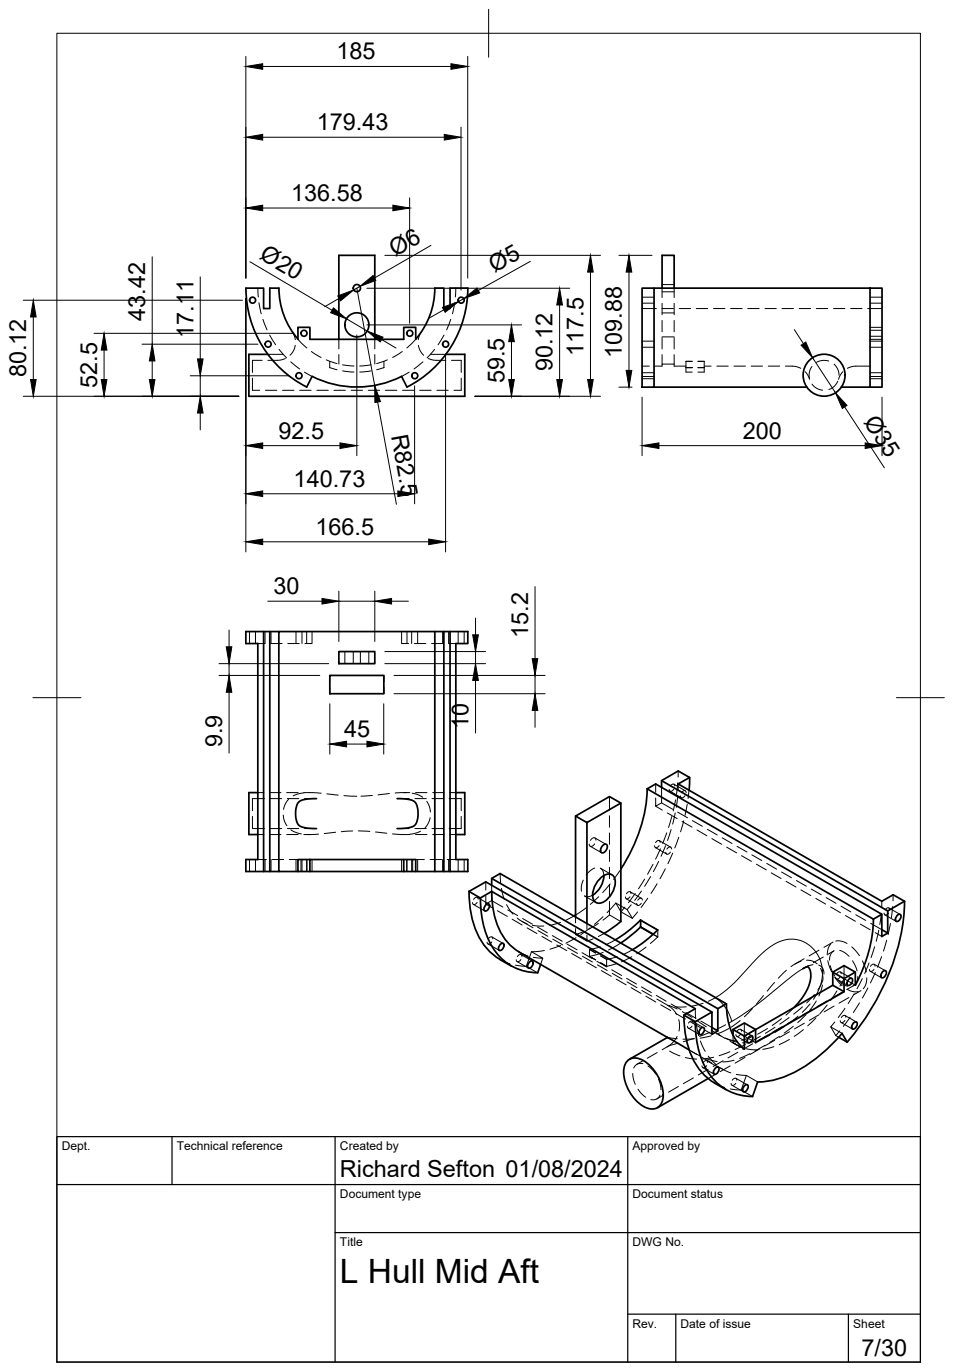
[picture p58: page 7]

Dept. | Technical reference | Created by Richard Sefton 01/08/2024 | Approved by

Document type | Document status

Title L Hull Mid Aft | DWG No.

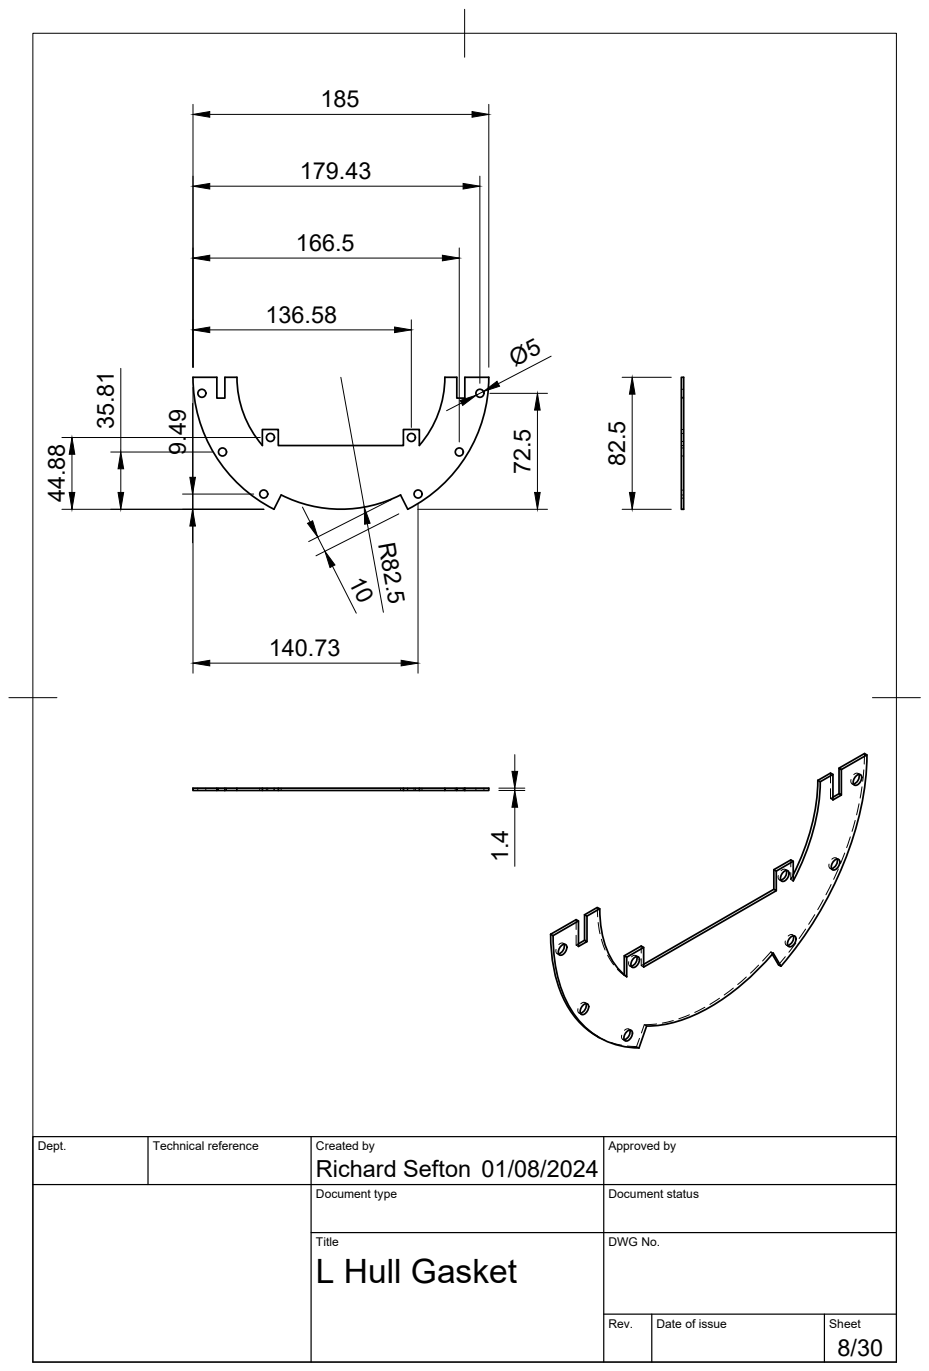
[picture p59: page 8]

Dept. | Technical reference | Created by Richard Sefton 01/08/2024 | Approved by

Document type | Document status

Title L Hull Gasket | DWG No.

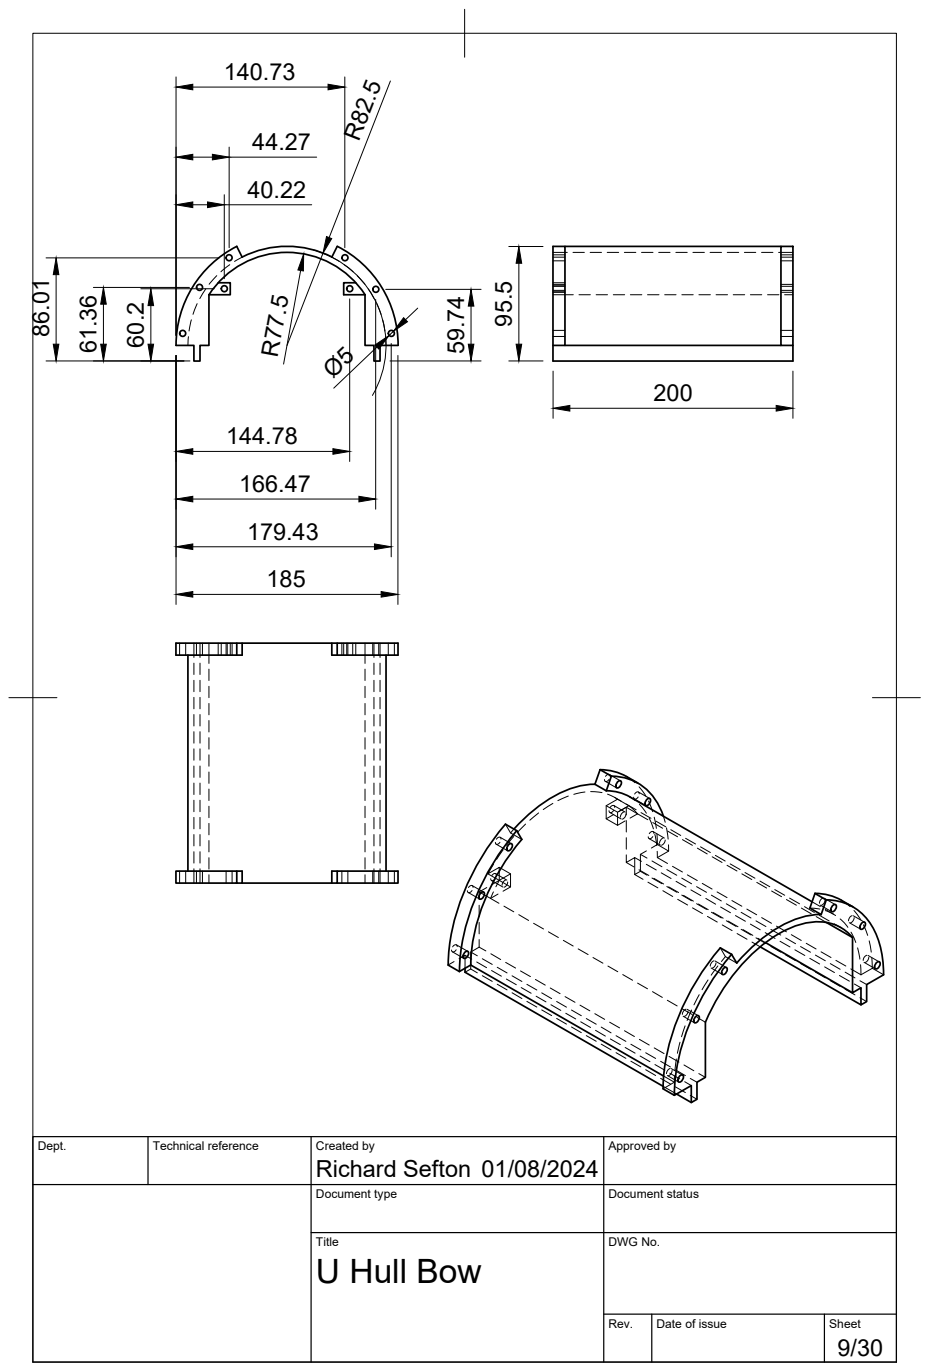
[picture p60: page 9]

Dept. | Technical reference | Created by Richard Sefton 01/08/2024 | Approved by

Document type | Document status

Title U Hull Bow | DWG No.

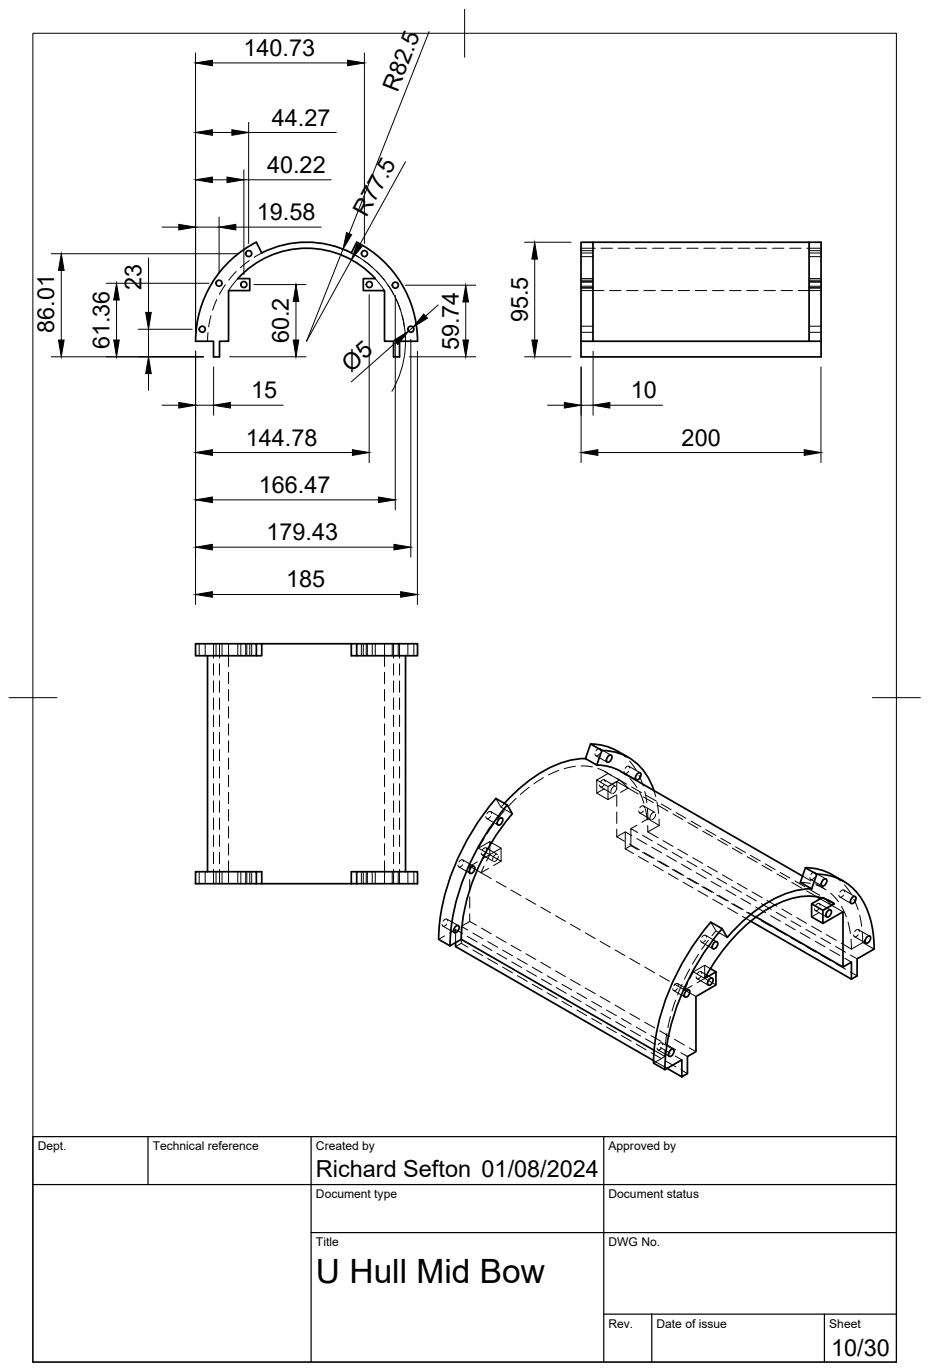
[picture p61: page 10]

Dept. | Technical reference | Created by Richard Sefton 01/08/2024 | Approved by

Document type | Document status

Title U Hull Mid Bow | DWG No.

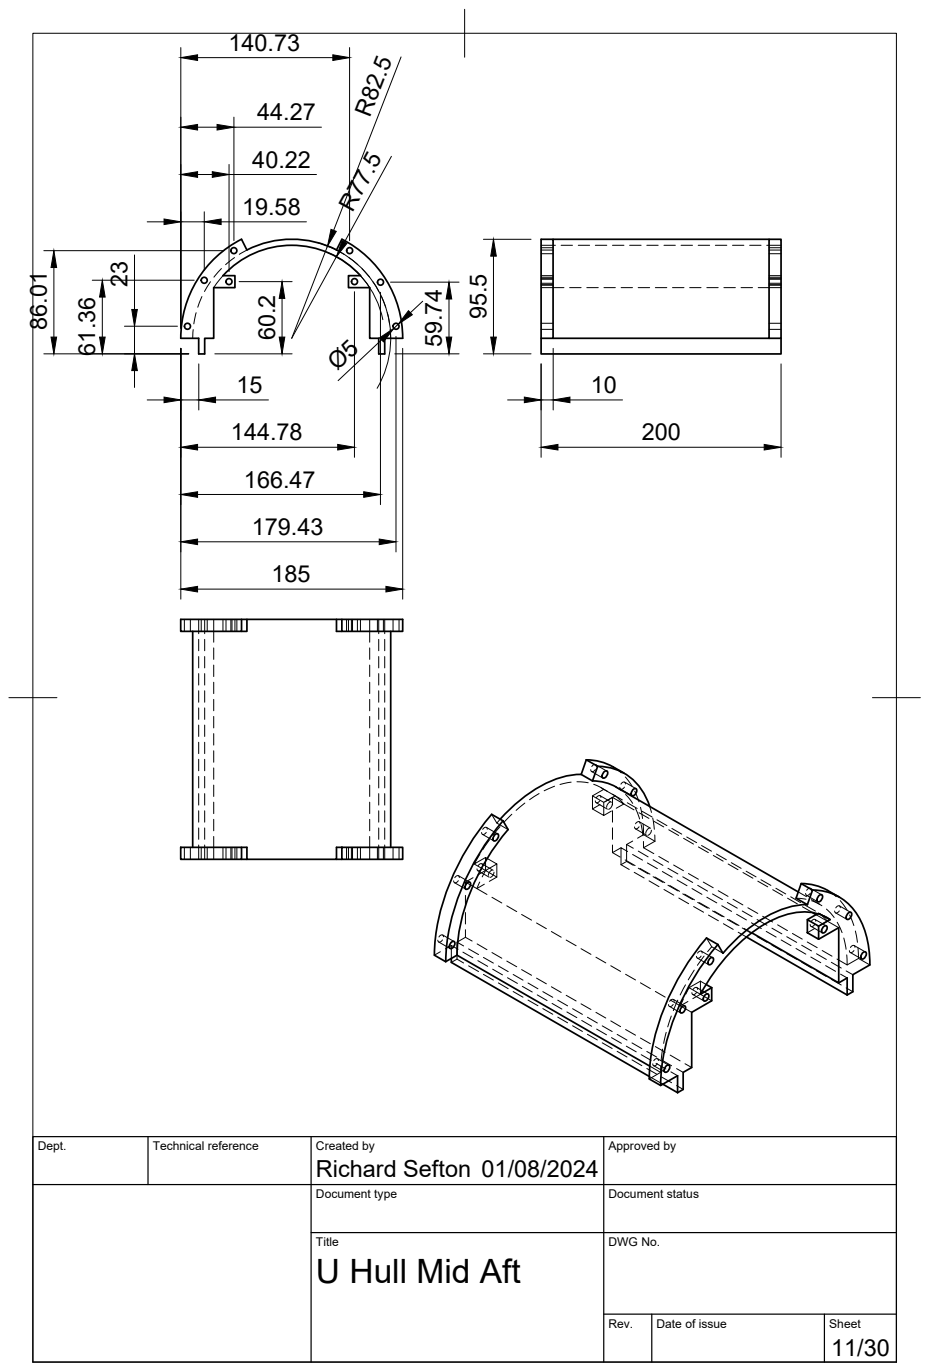
[picture p62: page 11]

Dept. | Technical reference | Created by Richard Sefton 01/08/2024 | Approved by

Document type | Document status

Title U Hull Mid Aft | DWG No.

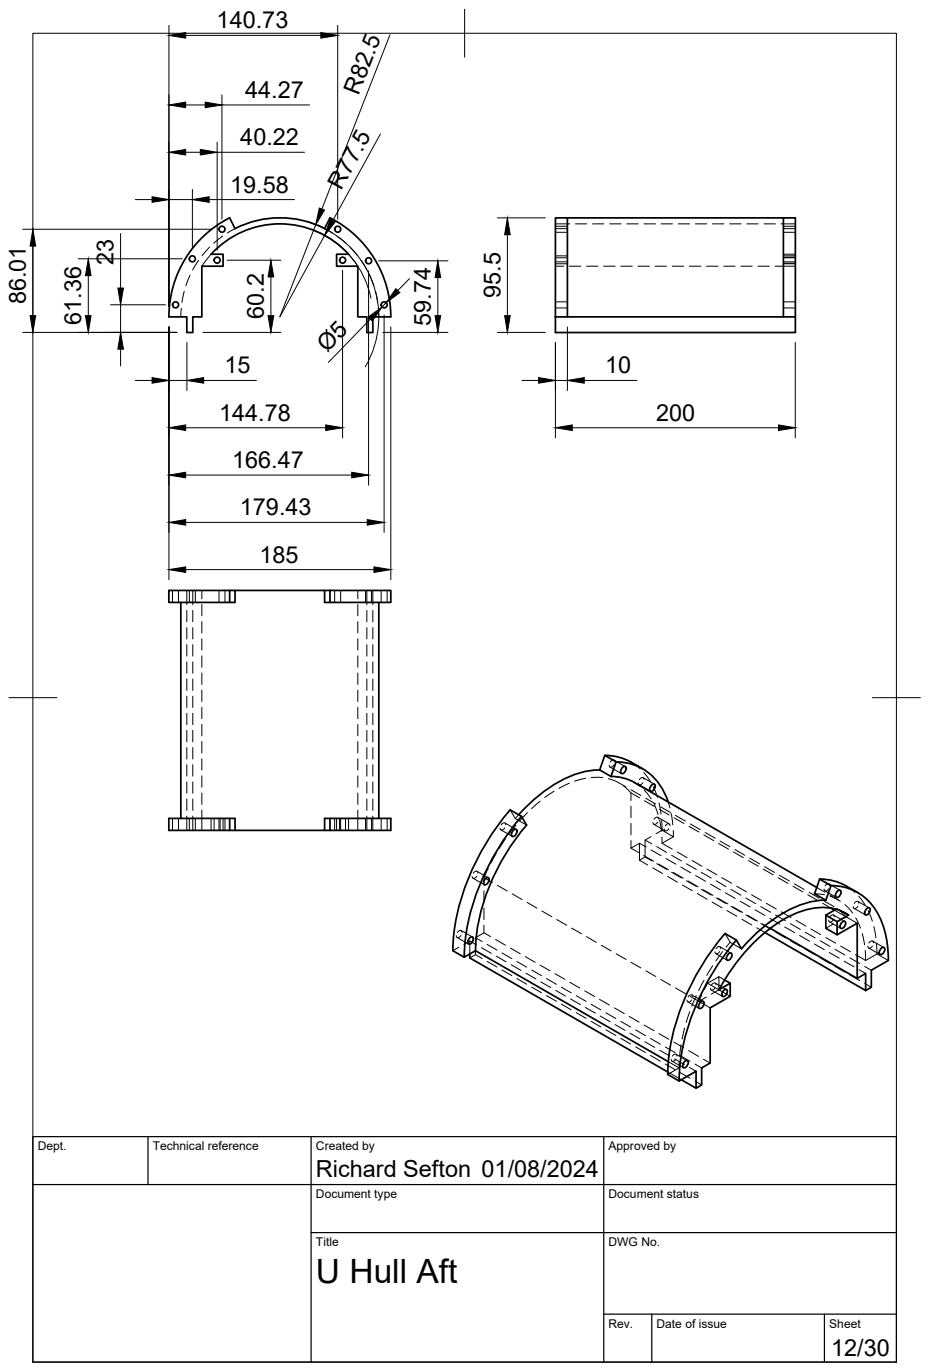
[picture p63: page 12]

Dept. | Technical reference | Created by Richard Sefton 01/08/2024 | Approved by

Document type | Document status

Title U Hull Aft | DWG No.

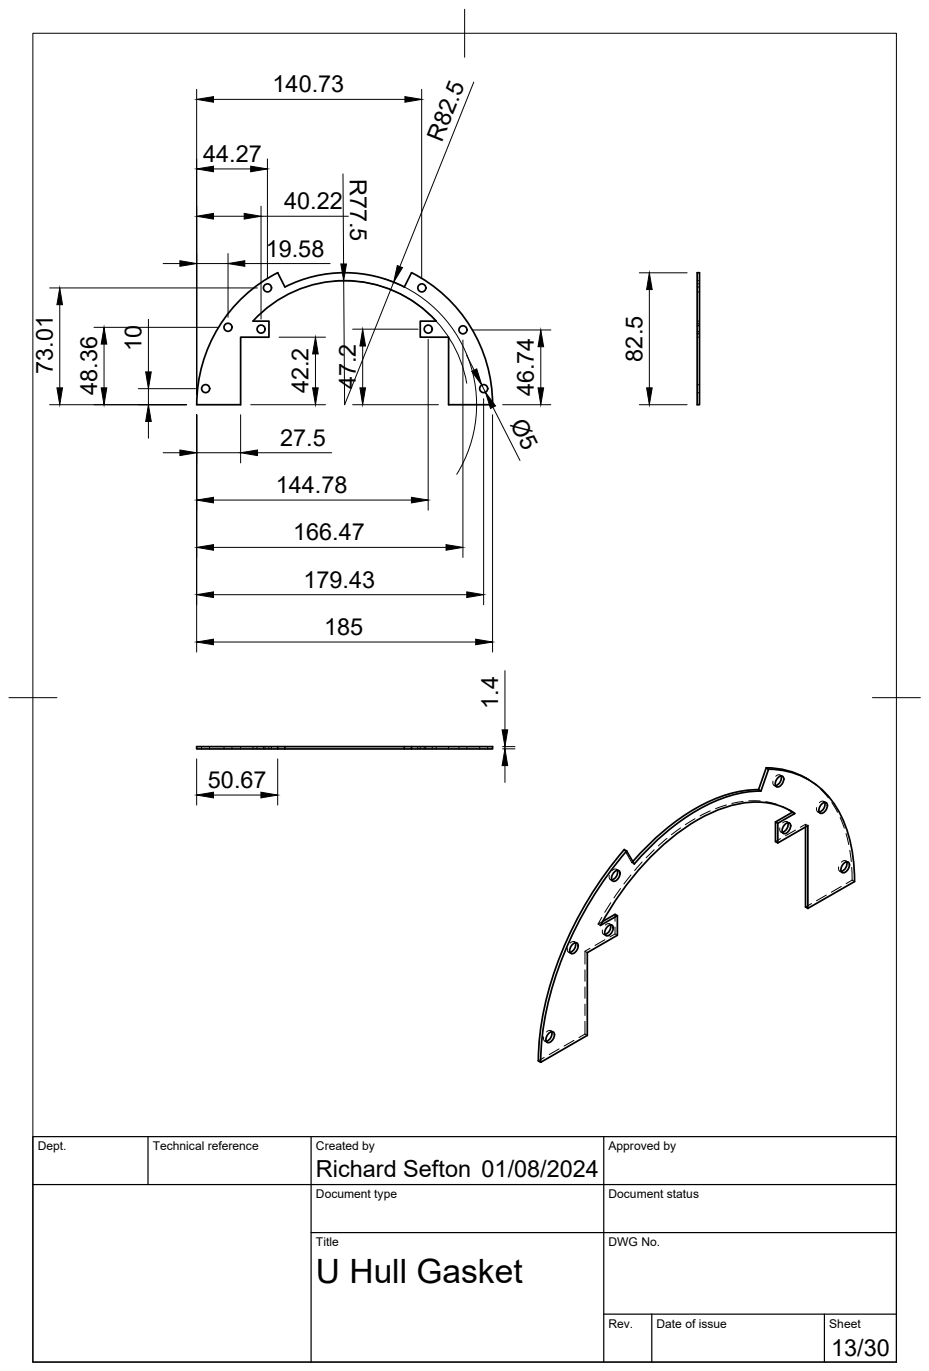
[picture p64: page 13]
Richard Sefton

Dept. | Technical reference | Created by 01/08/2024 | Approved by

Document type | Document status

Title U Hull Gasket | DWG No.

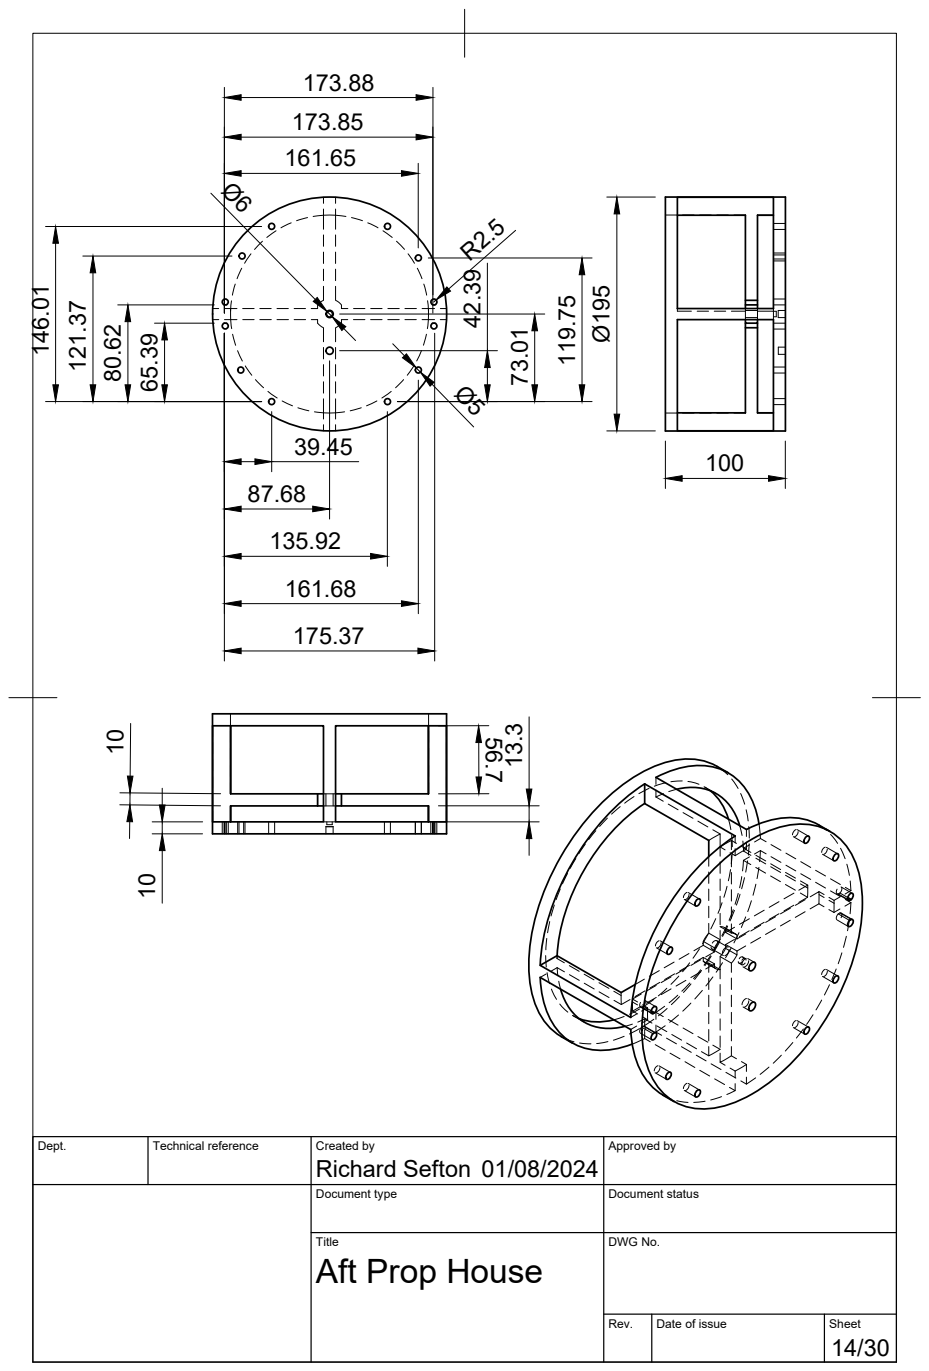
[picture p65: page 14]
Richard Sefton 146.01

Dept. | Technical reference | Created by 01/08/2024 | Approved by

Document type | Document status

Title Aft Prop House | DWG No.

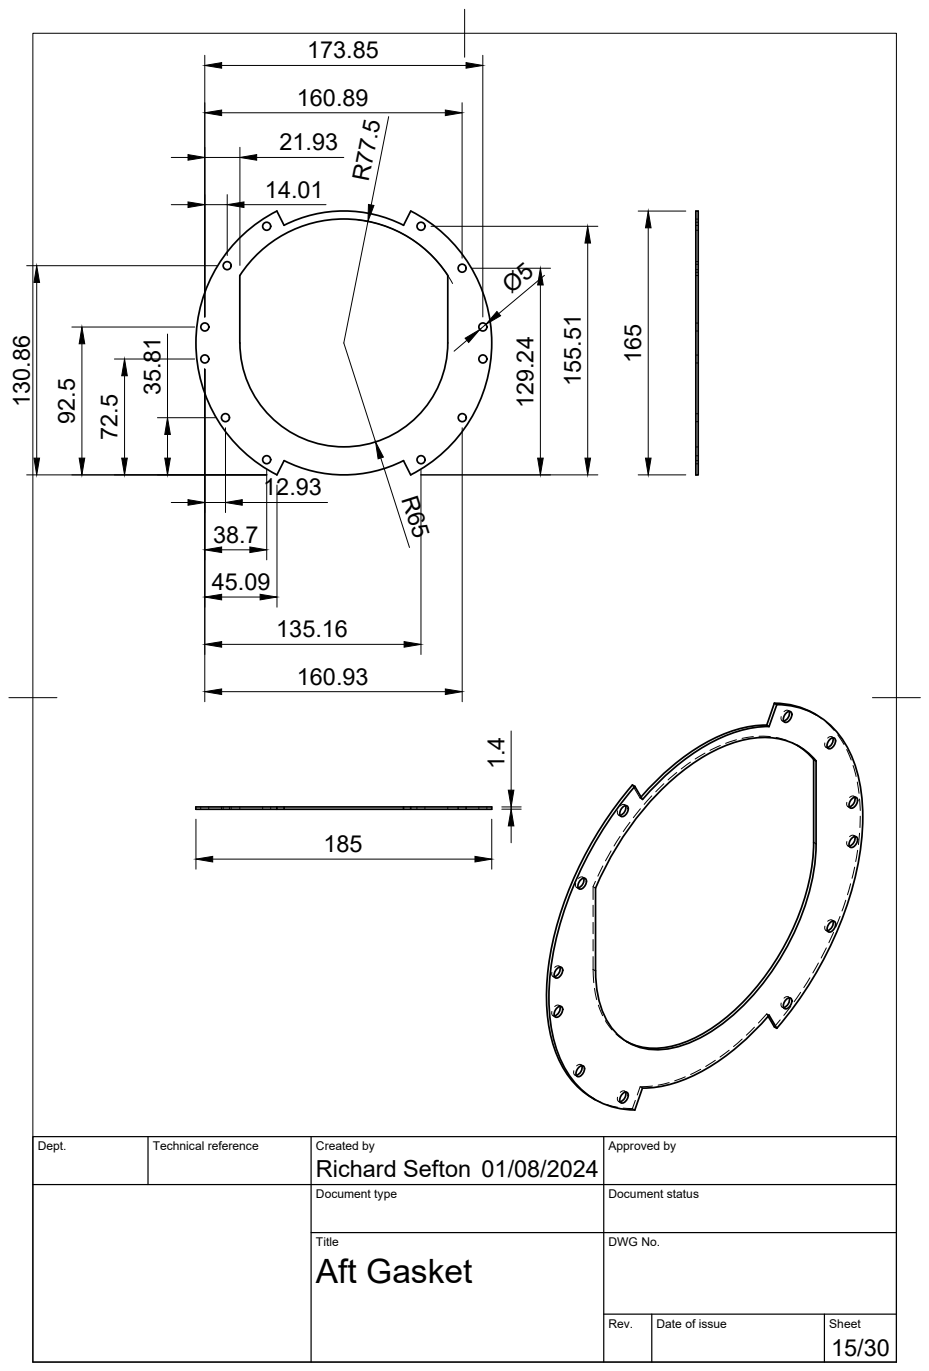
[picture p66: page 15]

Dept. | Technical reference | Created by Richard Sefton 01/08/2024 | Approved by

Document type | Document status

Title Aft Gasket | DWG No.

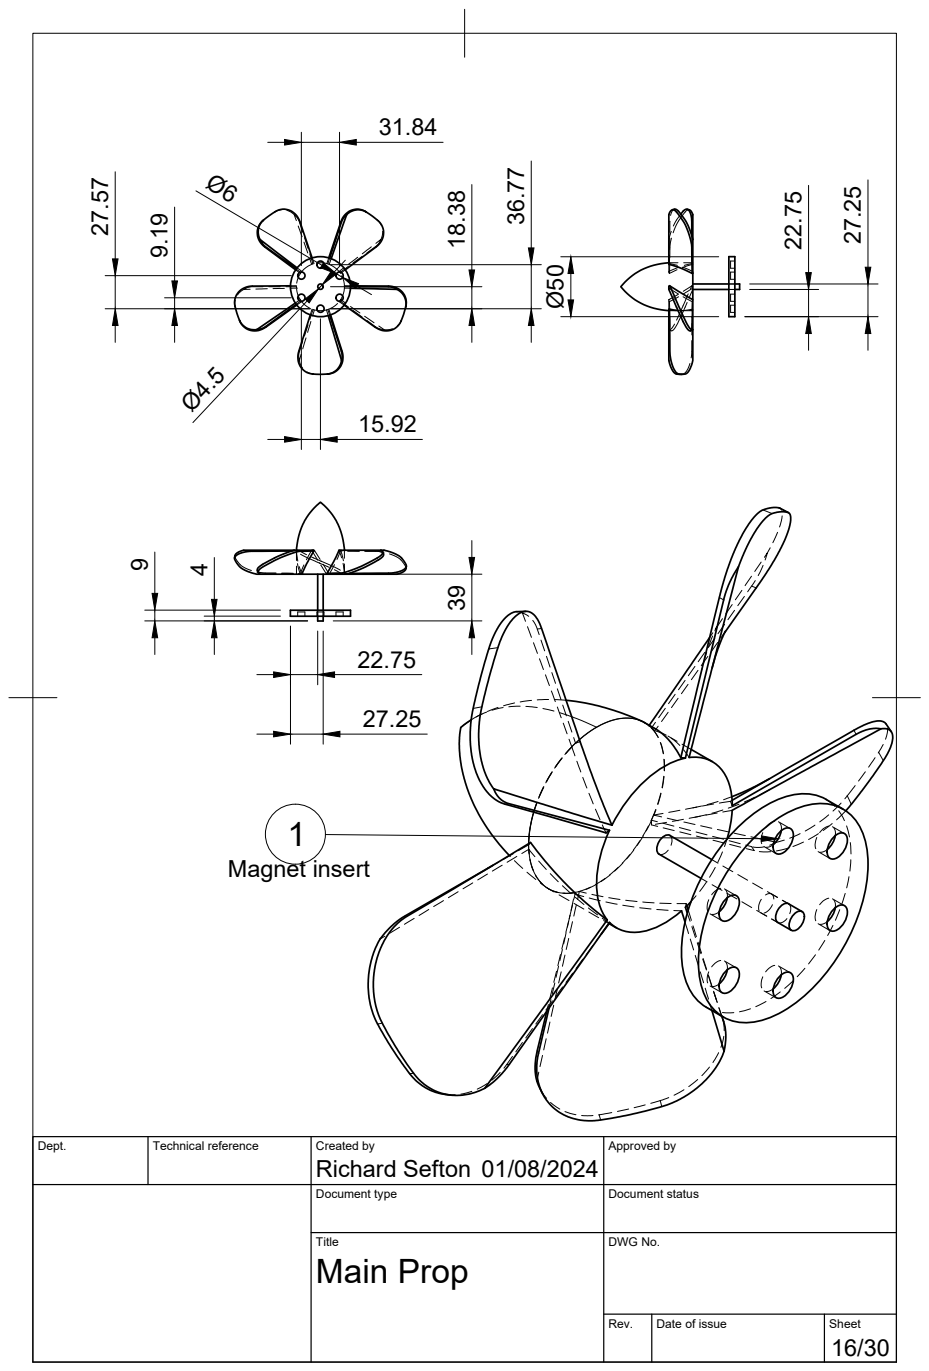
[picture p67: page 16]
Richard Sefton; Magnet insert

Dept. | Technical reference | Created by 01/08/2024 | Approved by

Document type | Document status

Title Main Prop | DWG No.

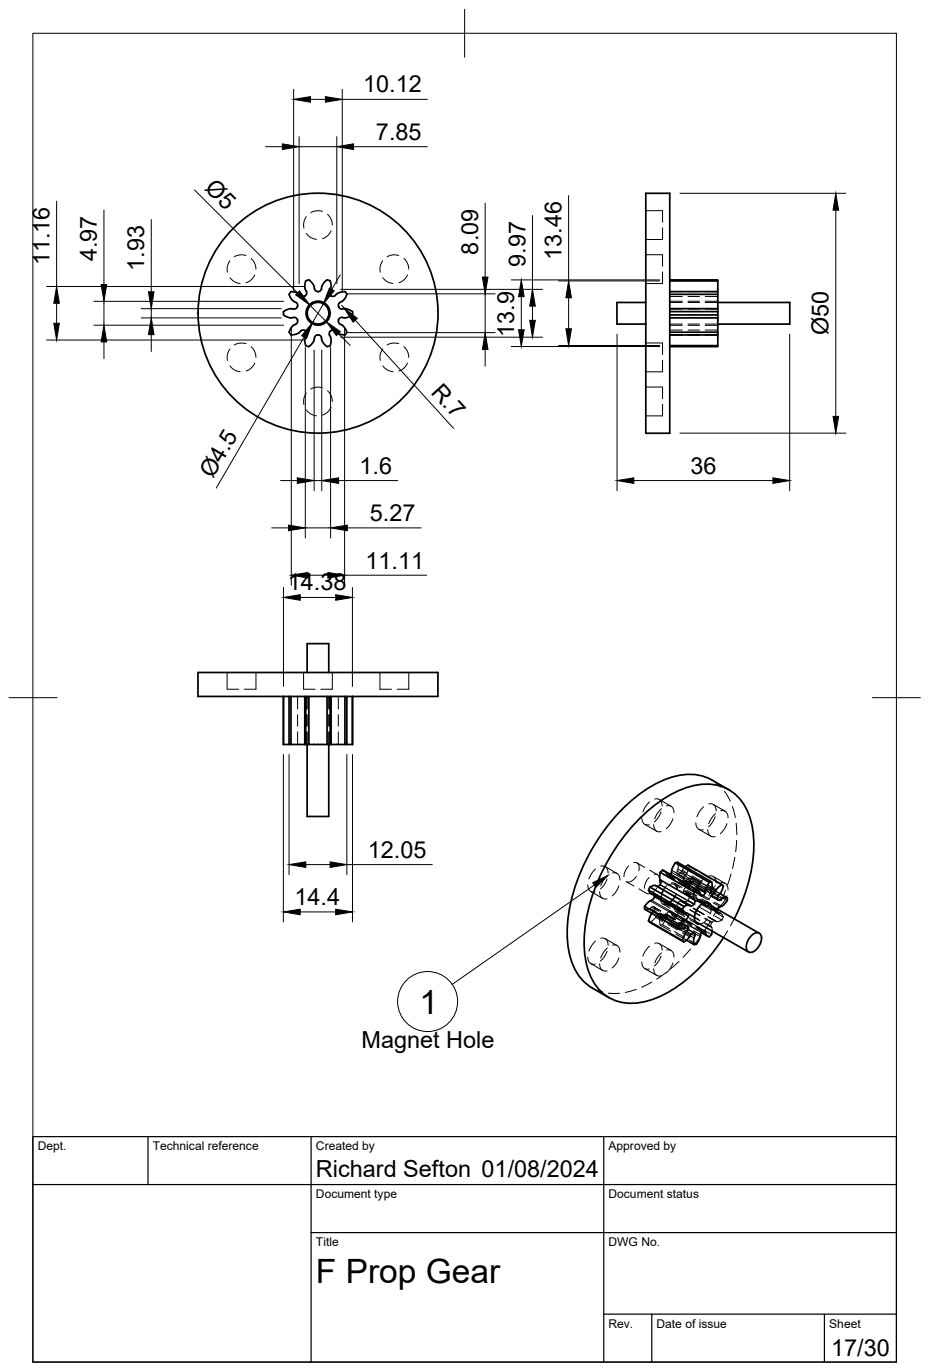
[picture p68: page 17]
Richard Sefton; Magnet Hole

Dept. | Technical reference | Created by 01/08/2024 | Approved by

Document type | Document status

Title F Prop Gear | DWG No.

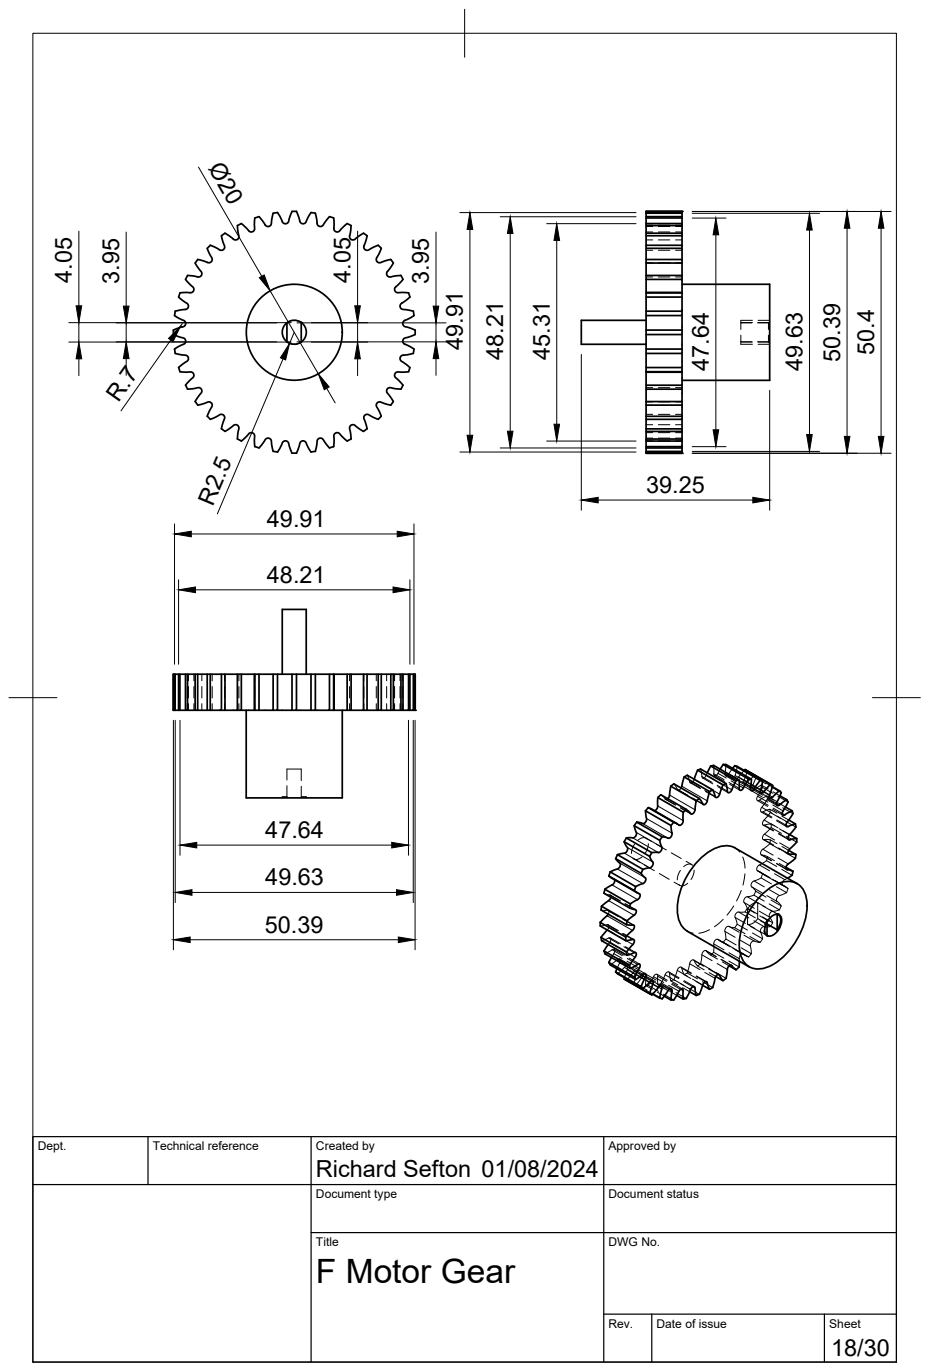
[picture p69: page 18]
Richard Sefton

Dept. | Technical reference | Created by 01/08/2024 | Approved by

Document type | Document status

Title F Motor Gear | DWG No.

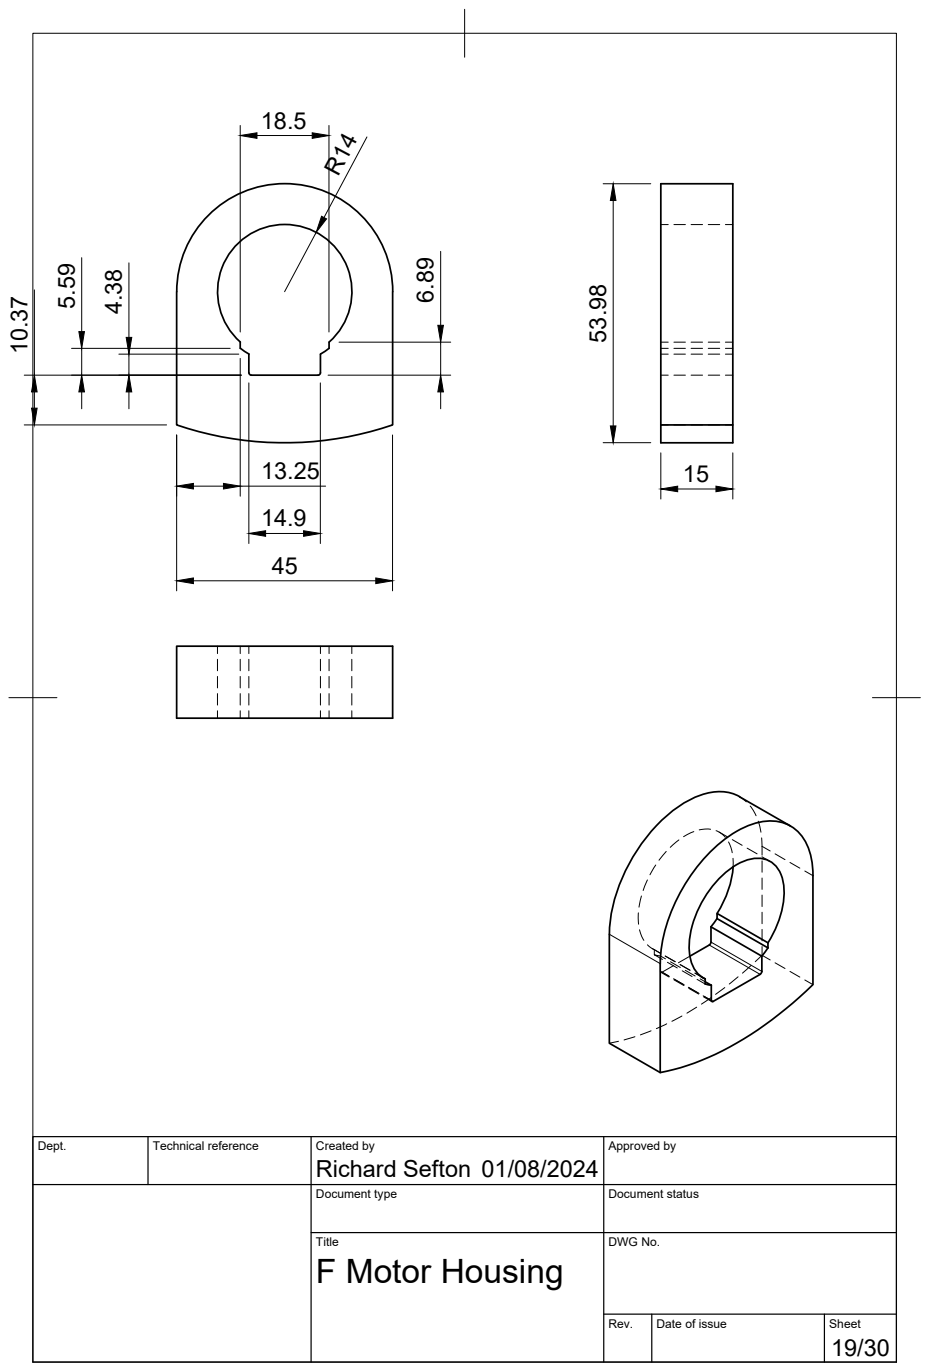
[picture p70: page 19]
Richard Sefton

Dept. | Technical reference | Created by 01/08/2024 | Approved by

Document type | Document status

Title F Motor Housing | DWG No.

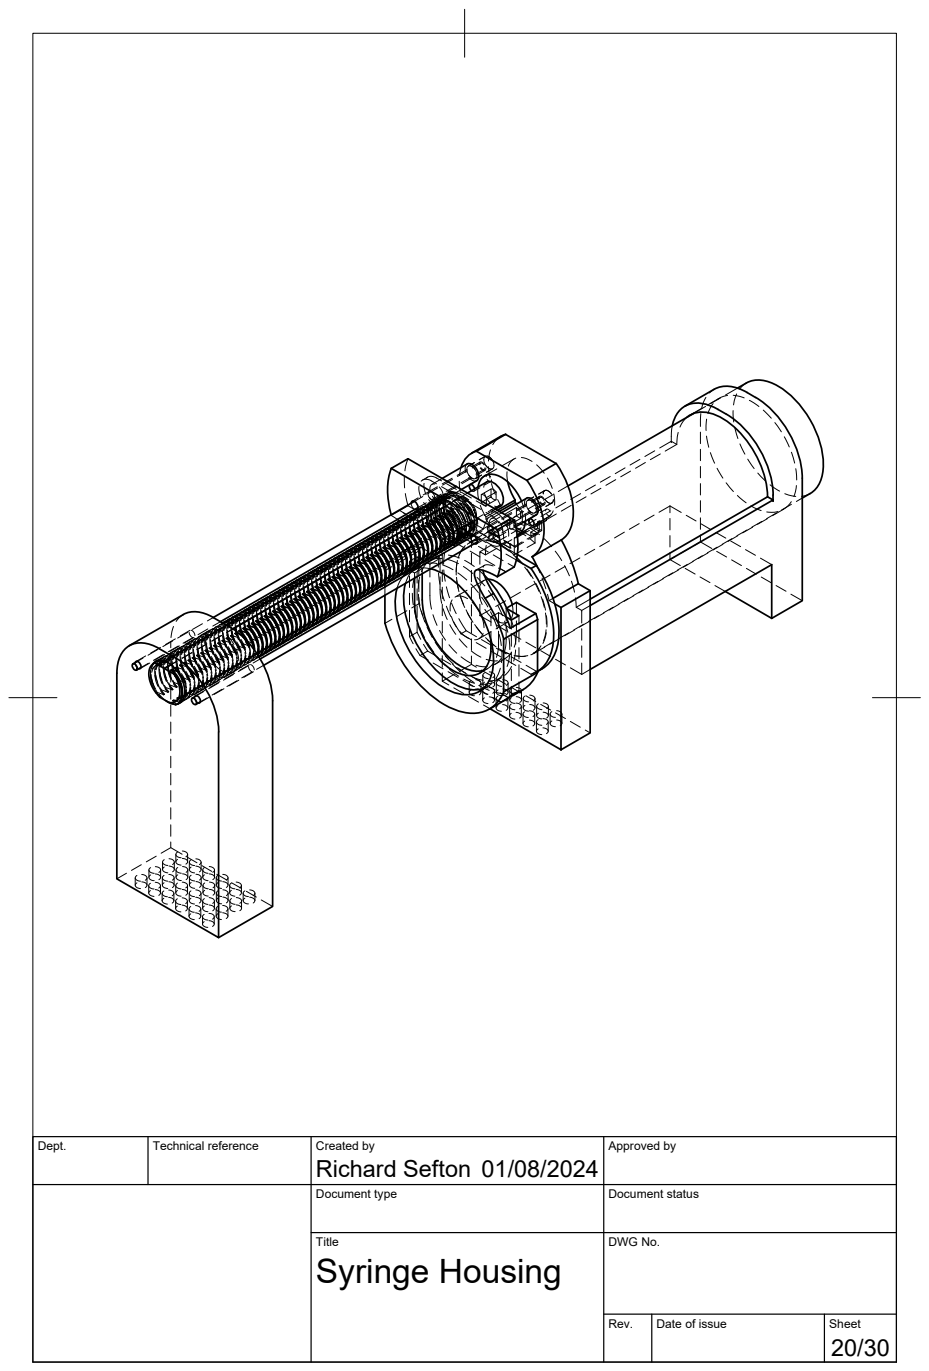
[picture p71: page 20]

Dept. | Technical reference | Created by Richard Sefton 01/08/2024 | Approved by

Document type | Document status

Title Syringe Housing | DWG No.

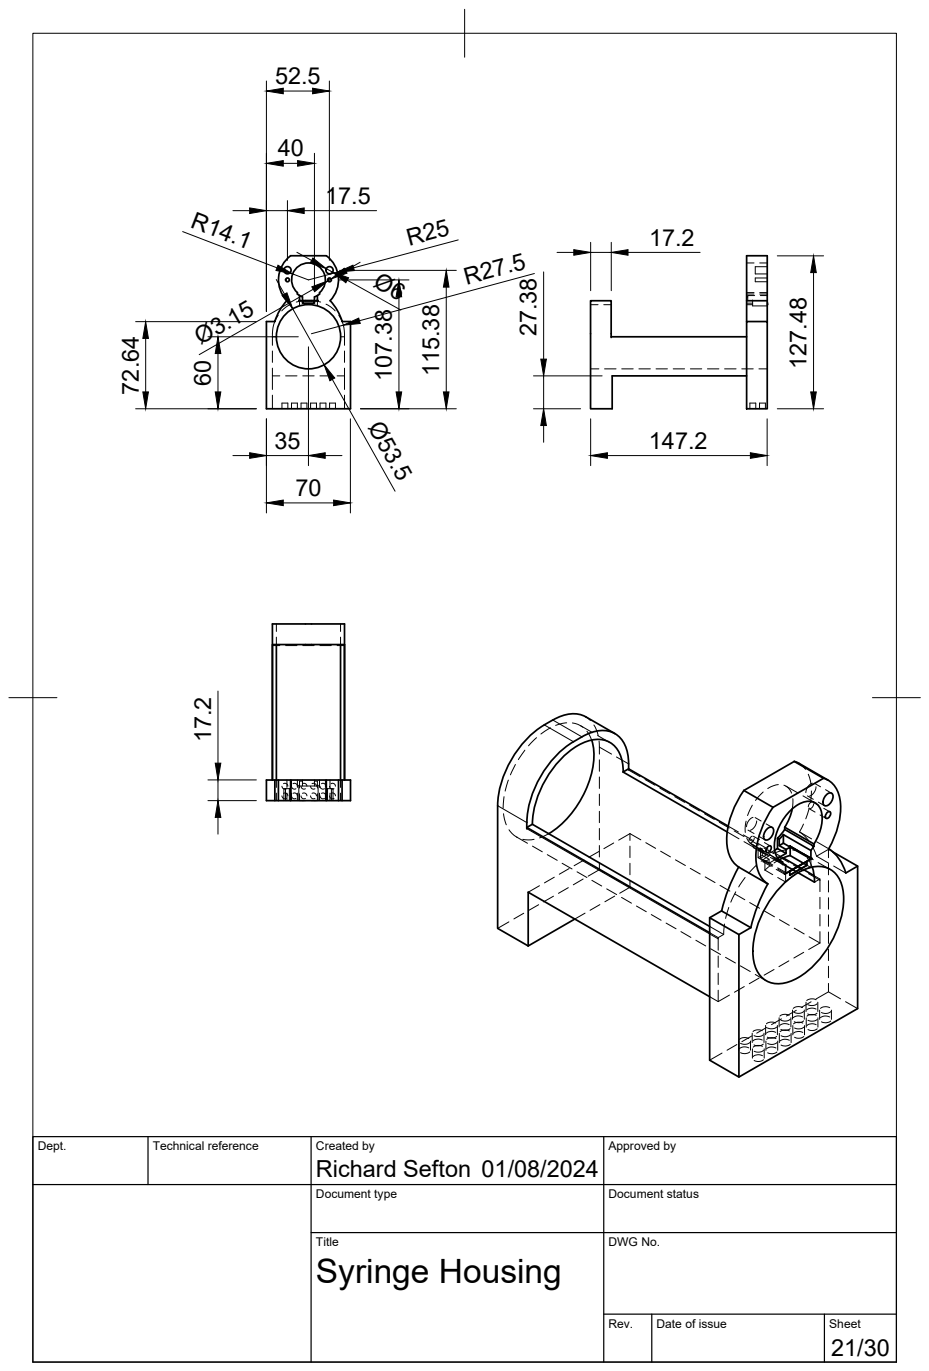
[picture p72: page 21]

Dept. | Technical reference | Created by Richard Sefton 01/08/2024 | Approved by

Document type | Document status

Title Syringe Housing | DWG No.

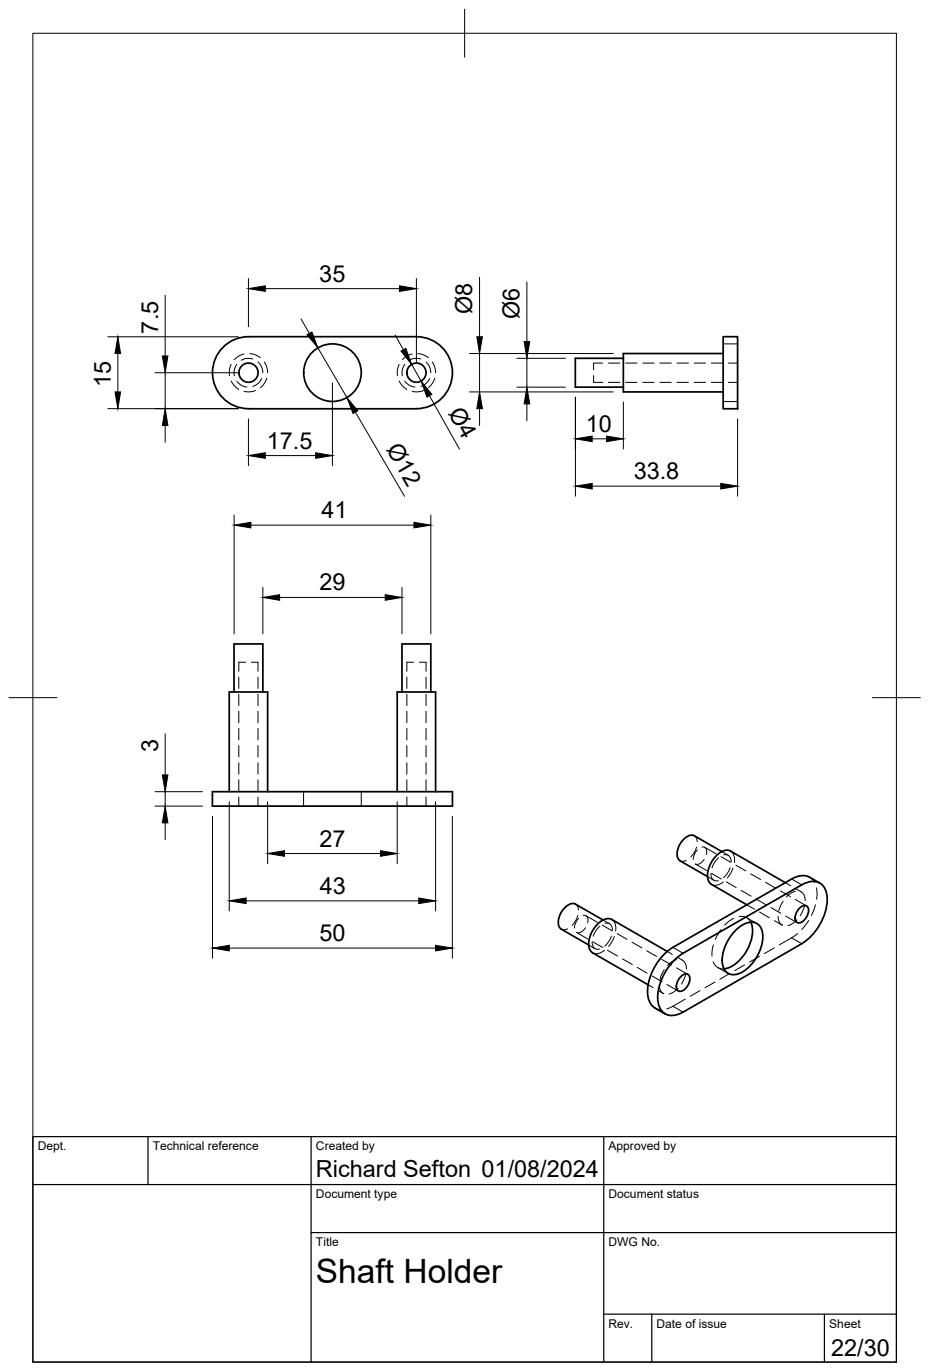
[picture p73: page 22]

Dept. | Technical reference | Created by Richard Sefton 01/08/2024 | Approved by

Document type | Document status

Title Shaft Holder | DWG No.

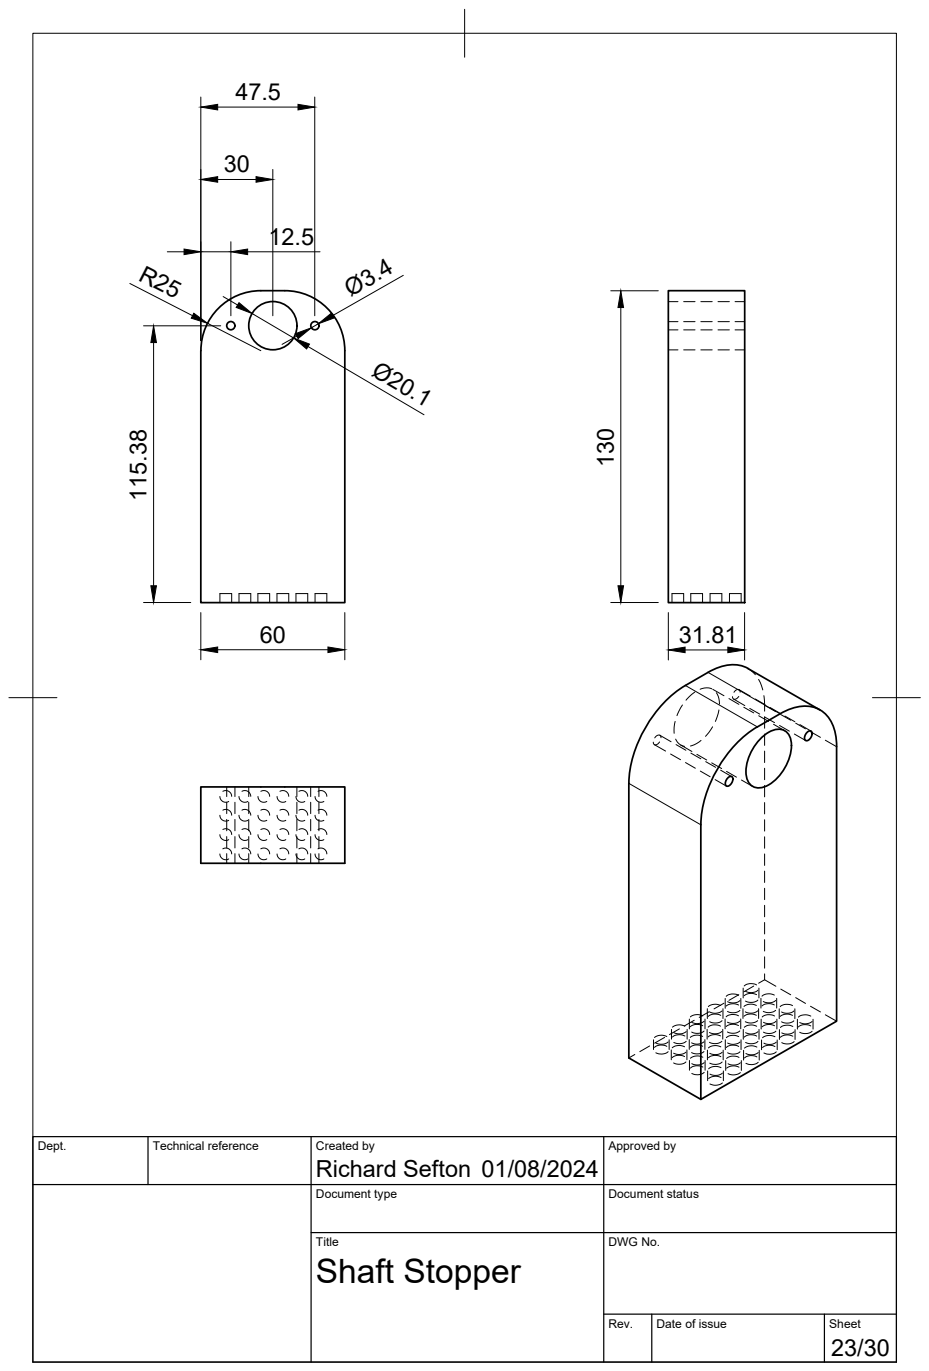
[picture p74: page 23]

Dept. | Technical reference | Created by Richard Sefton 01/08/2024 | Approved by

Document type | Document status

Title Shaft Stopper | DWG No.

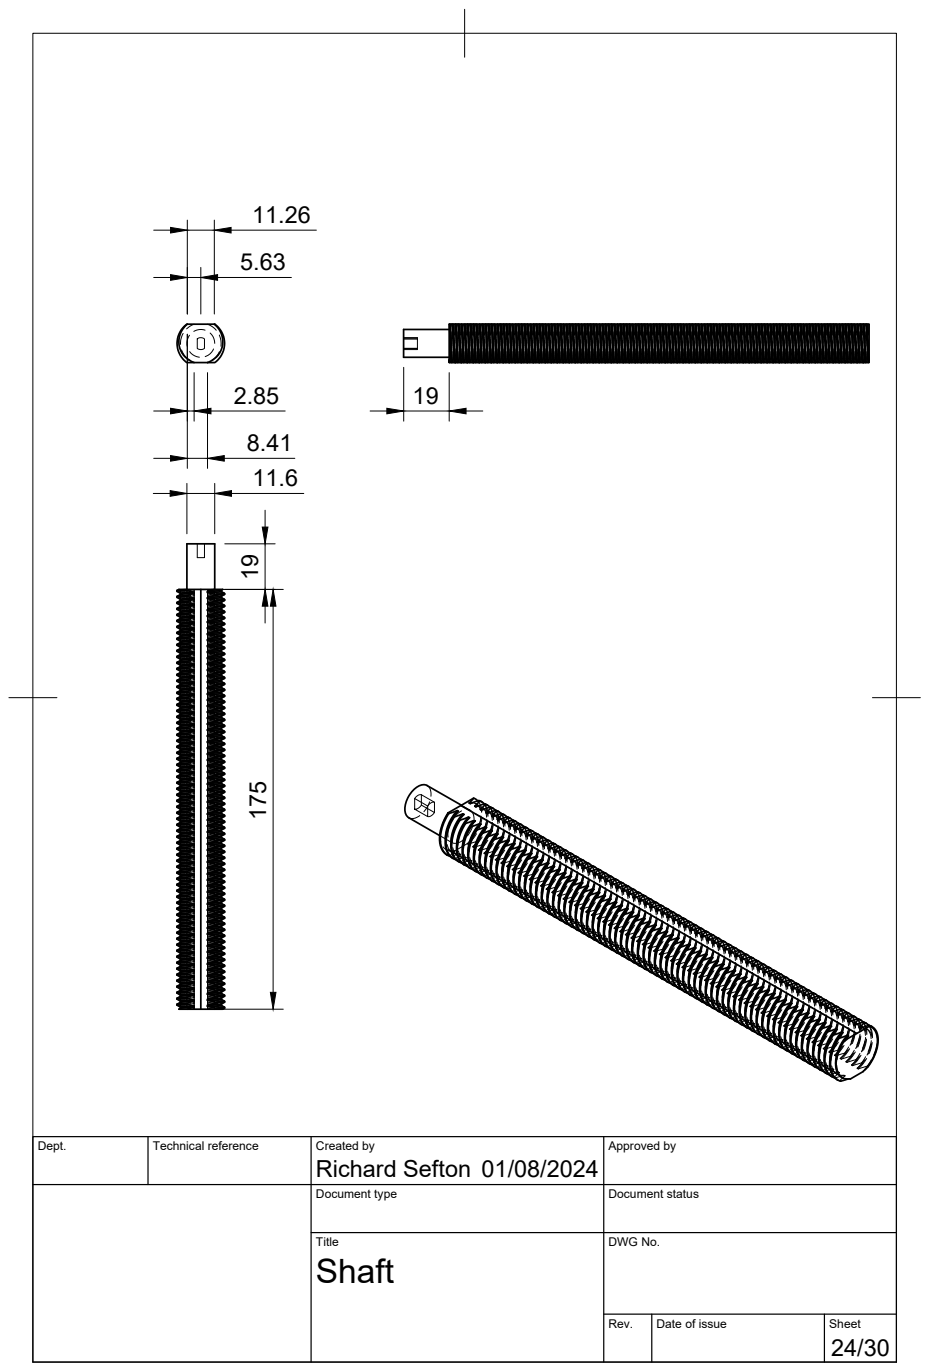
[picture p75: page 24]
Dept.; Technical reference; Created by; Approved by; Document type; Document status; Title; DWG No.; Richard Sefton

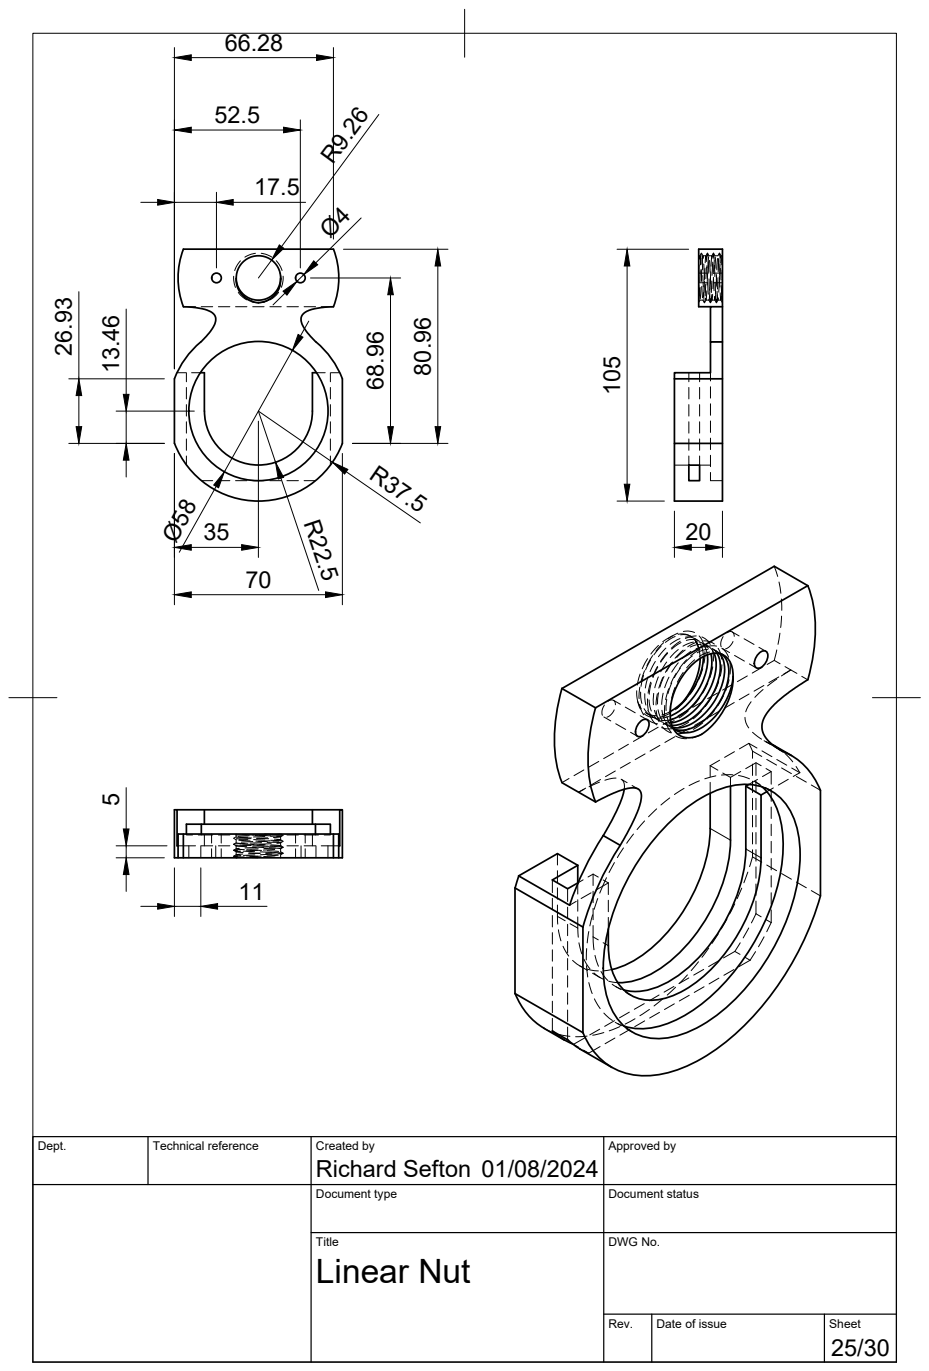
[picture p76: page 25]
Richard Sefton 80.96 R22.5 68.96

Dept. | Technical reference | Created by 01/08/2024 | Approved by

Document type | Document status

Title Linear Nut | DWG No.

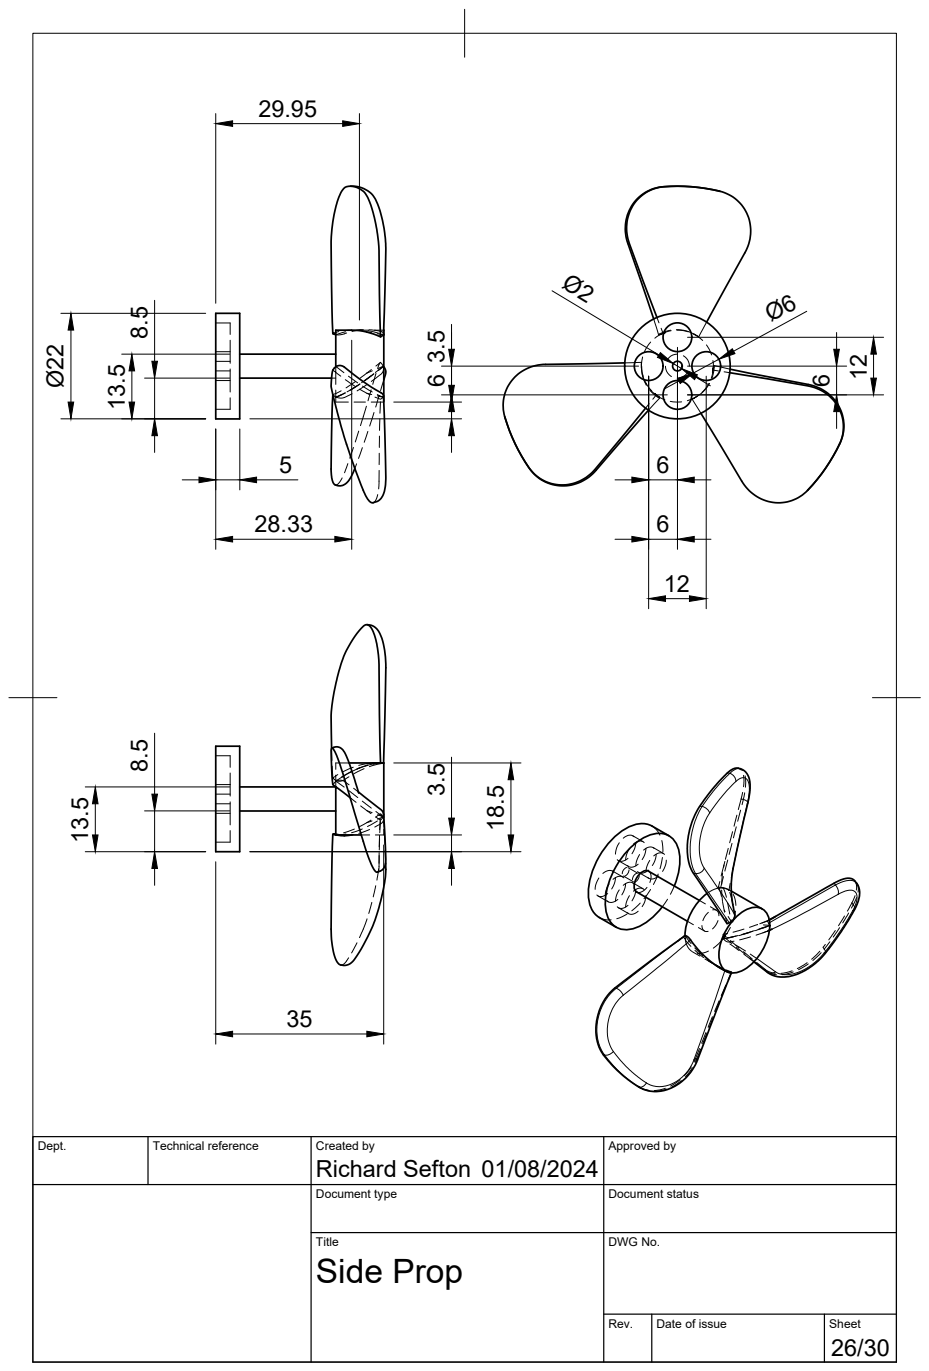
[picture p77: page 26]

Dept. | Technical reference | Created by Richard Sefton 01/08/2024 | Approved by

Document type | Document status

Title Side Prop | DWG No.

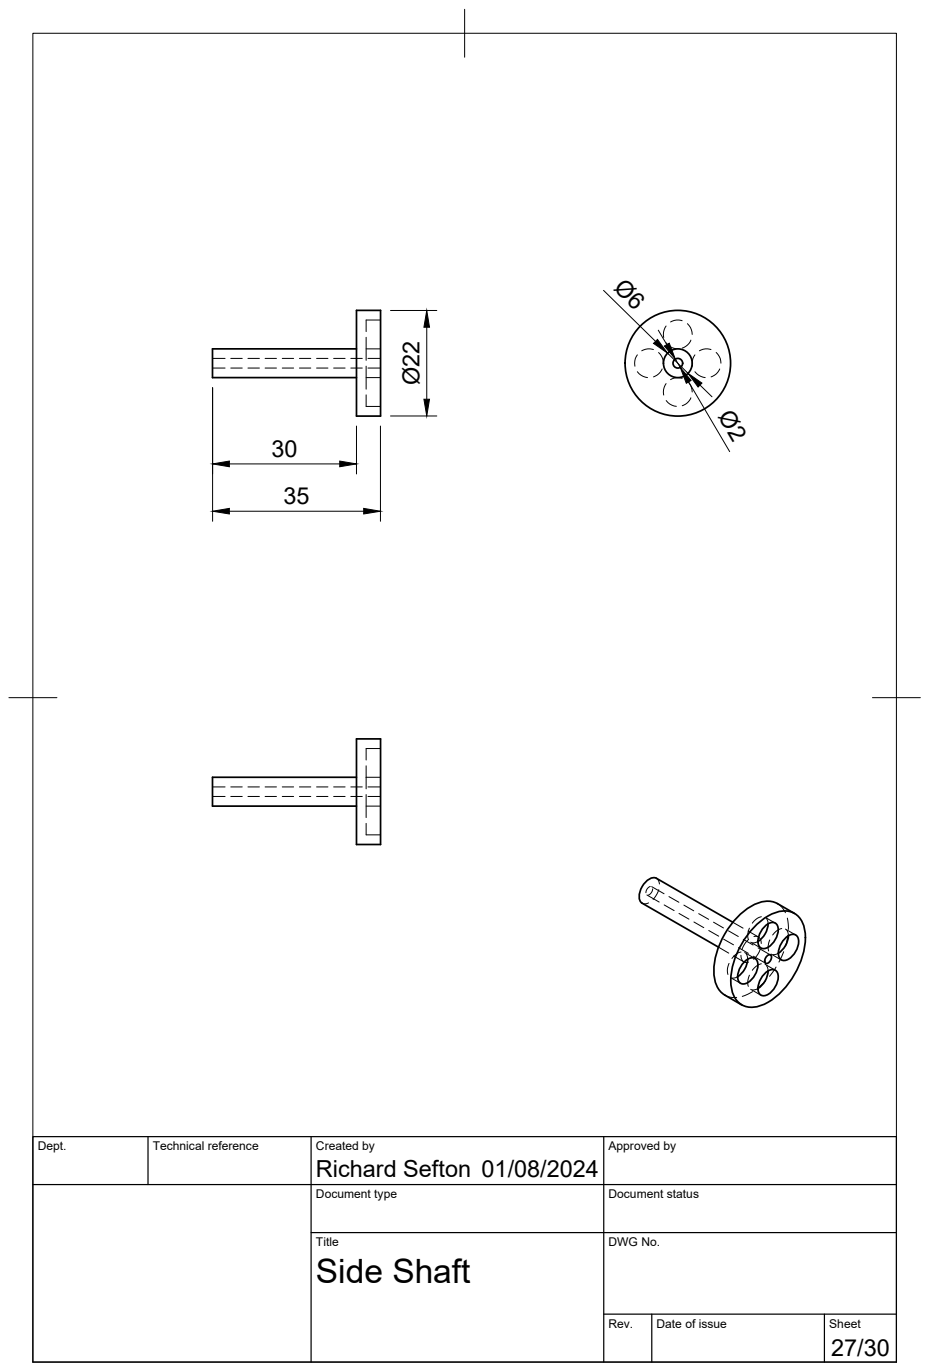
[picture p78: page 27]
Richard Sefton Ø22

Dept. | Technical reference | Created by 01/08/2024 | Approved by

Document type | Document status

Title Side Shaft | DWG No.

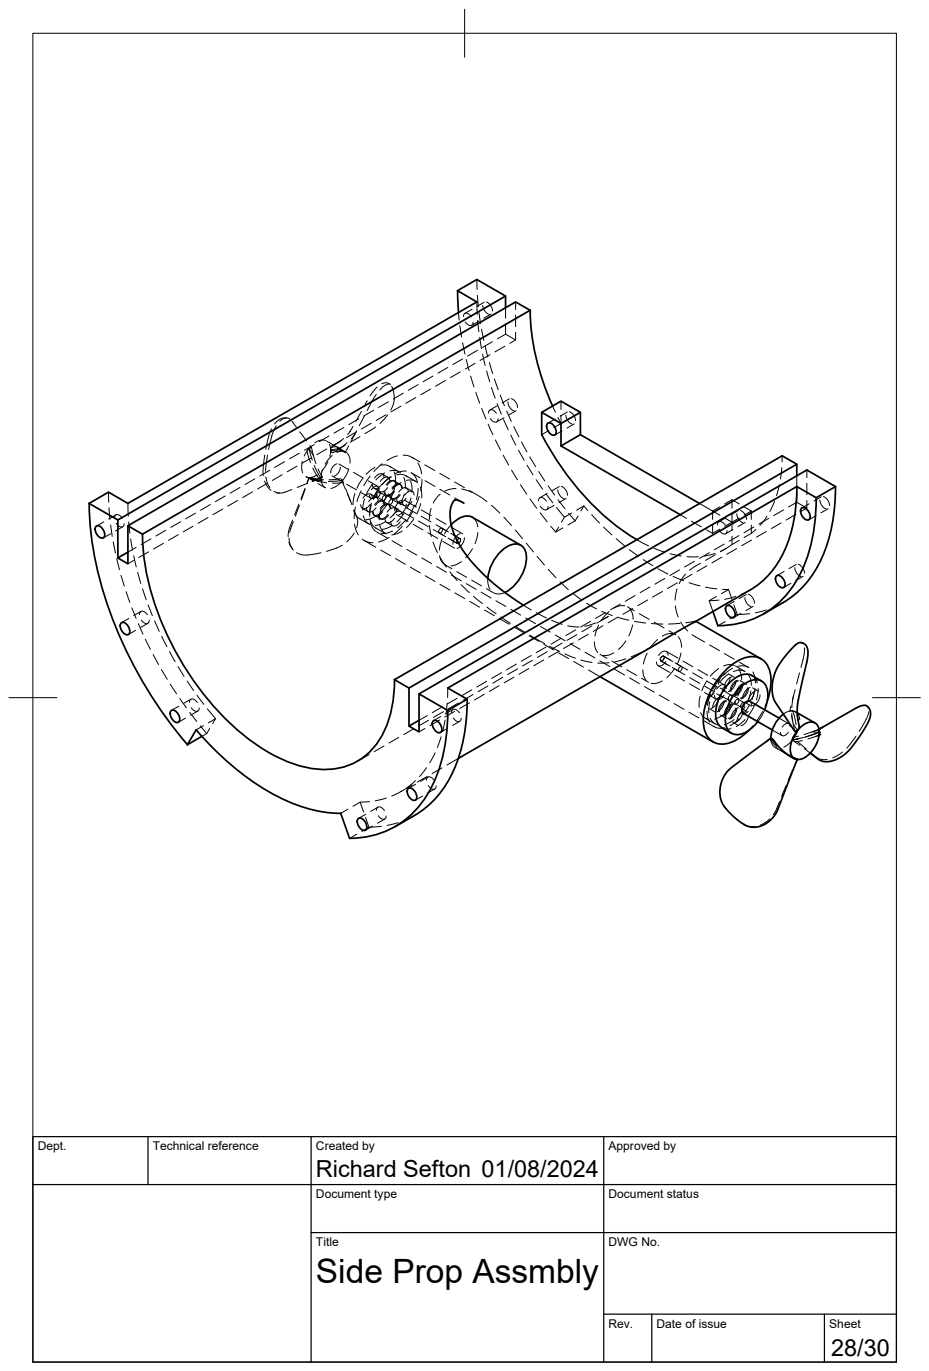
[picture p79: page 28]

Dept. | Technical reference | Created by Richard Sefton 01/08/2024 | Approved by

Document type | Document status

Title Side Prop Assmbly | DWG No.

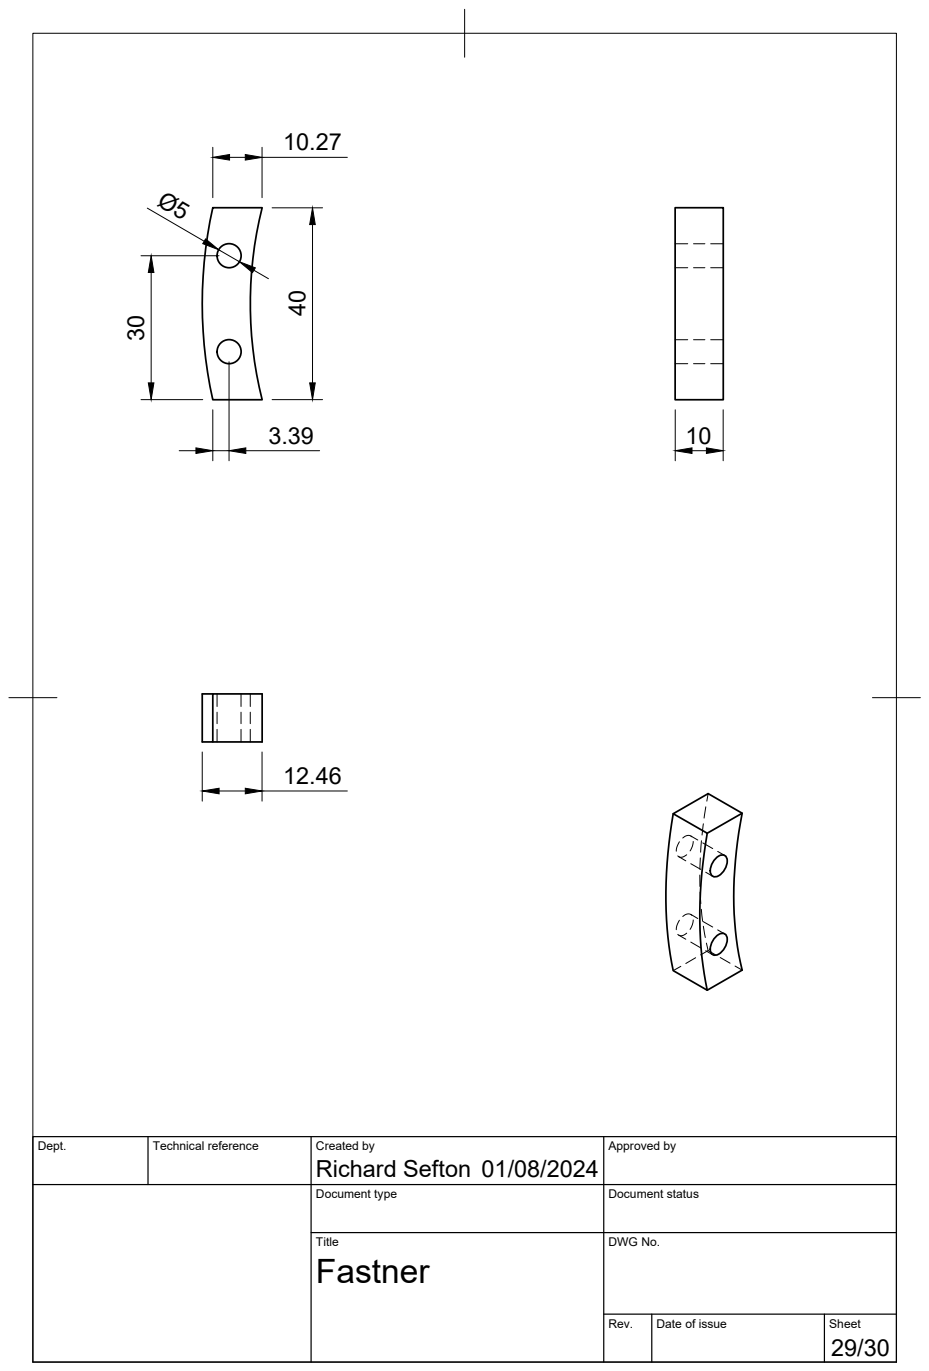
[picture p80: page 29]
Richard Sefton 40

Dept. | Technical reference | Created by 01/08/2024 | Approved by

Document type | Document status

Title Fastner | DWG No.

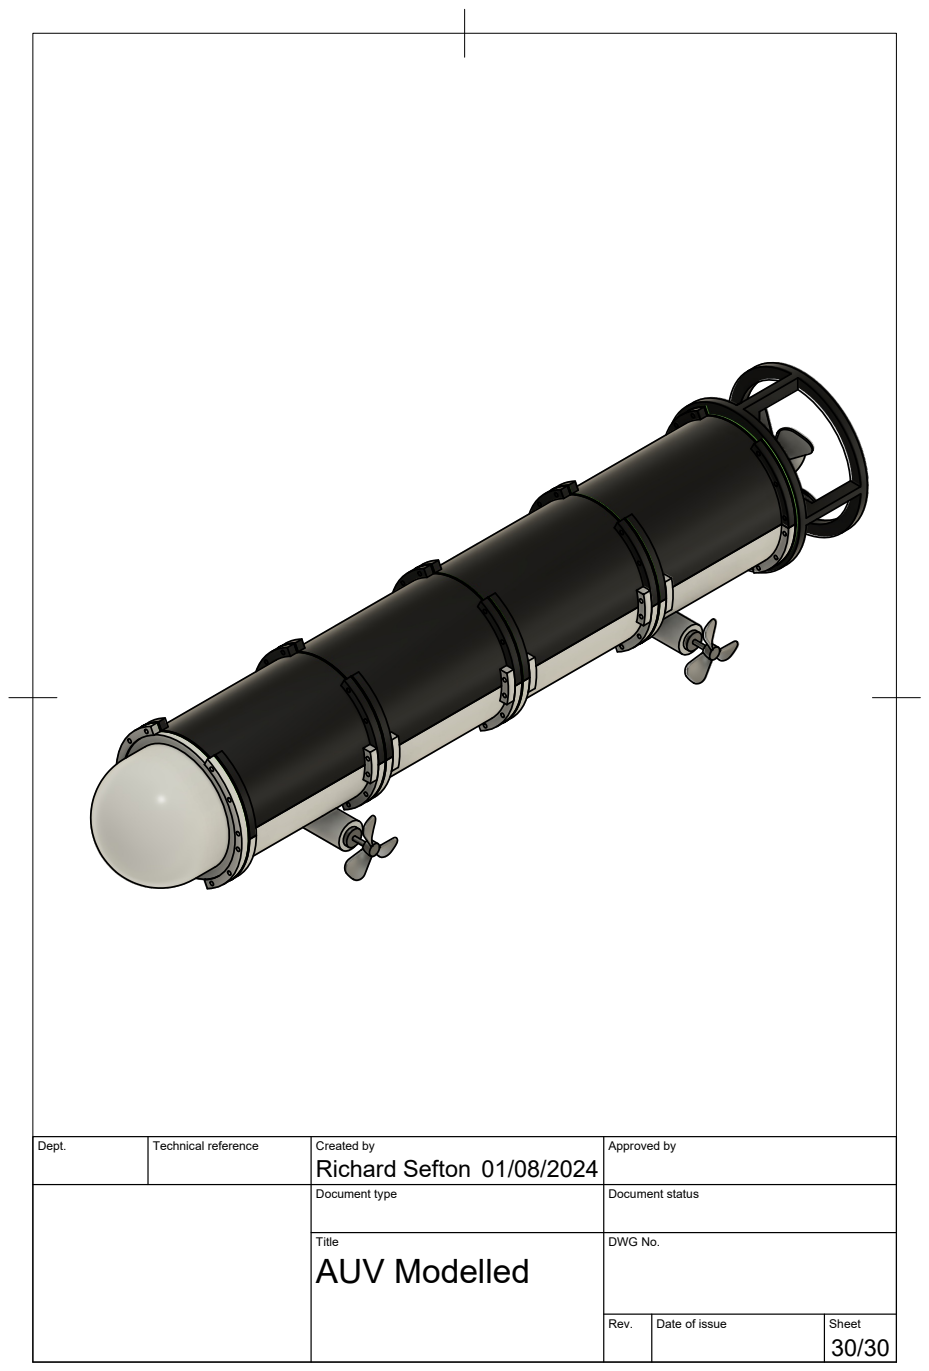
[picture p81: page 30]

Dept. | Technical reference | Created by Richard Sefton 01/08/2024 | Approved by

Document type | Document status

Title AUV Modelled | DWG No.
