RichardSefton/AUV/LTSpice_diagrams/ltspice_octo100v.asc

D1: diode
R1: res; 120
R2: res; 10
R3: res; 1.5k
U1: PC817A
V1: voltage; PULSE(5 0 0 0 0 0.0000125 0.000025)
V2: voltage; 12
V3: voltage; 5
Named nets: 0
.tran 180us
