RichardSefton/AUV/pcb/CentralController_PCB/CentralController.kicad_pcb

## KiCad design pcb/CentralController_PCB/CentralController.kicad_pcb (2024-07-02)

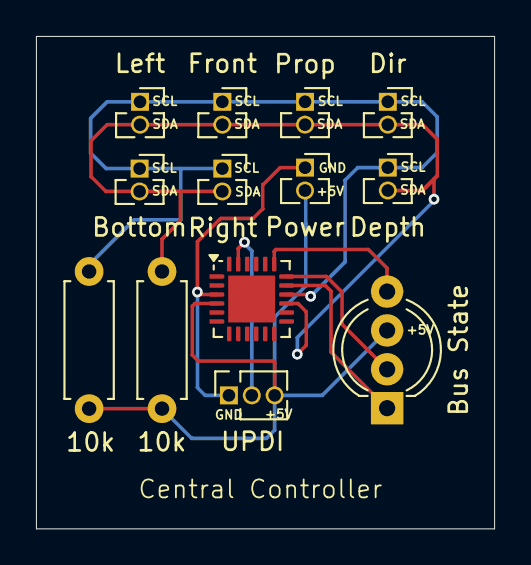
[picture p82: board CentralController.kicad_pcb from above]

Board: 2 copper layers, 25.5 x 27.4 mm, 13 parts (0 on the bottom side), 8 nets.

Parts:
D1: Bus State; LED_D5.0mm-4_RGB_Wide_Pins
J1: Front; PinSocket_1x02_P1.27mm_Vertical
J2: Left; PinSocket_1x02_P1.27mm_Vertical
J3: Right; PinSocket_1x02_P1.27mm_Vertical
J4: Bottom; PinSocket_1x02_P1.27mm_Vertical
J5: Power; PinSocket_1x02_P1.27mm_Vertical
J5#2: Prop; PinSocket_1x02_P1.27mm_Vertical
J6: Dir; PinSocket_1x02_P1.27mm_Vertical
J7: Depth; PinSocket_1x02_P1.27mm_Vertical
J8: UPDI; PinSocket_1x03_P1.27mm_Vertical
R1, R2: 10k; R_Axial_DIN0207_L6.3mm_D2.5mm_P7.62mm_Horizontal
U1: ATtiny1627; QFN-24-1EP_4x4mm_P0.5mm_EP2.6x2.6mm

Connections:
+5V: D1.3 (GK), J5.2, J8.3, R1.2, R2.2, U1.4 (VCC)
GND: J5.1, J8.1, U1.3 (GND)
unnamed: D1.1 (A), U1.17 (PC0)
unnamed: D1.2 (RK), U1.18 (PC1)
unnamed: D1.4 (BK), U1.19 (PC2)
unnamed: J1.1, J2.1, J3.1, J4.1, J5#2.1, J6.1, J7.1, R1.1, U1.16 (PB0)
unnamed: J1.2, J2.2, J3.2, J4.2, J5#2.2, J6.2, J7.2, R2.1, U1.15 (PB1)
unnamed: J8.2, U1.23 (~RESET/PA0)
