RichardSefton/AUV/pcb/VQFN_breakout/VQFN_breakout.kicad_pcb

## KiCad design pcb/VQFN_breakout/VQFN_breakout.kicad_pcb (2024-05-29)

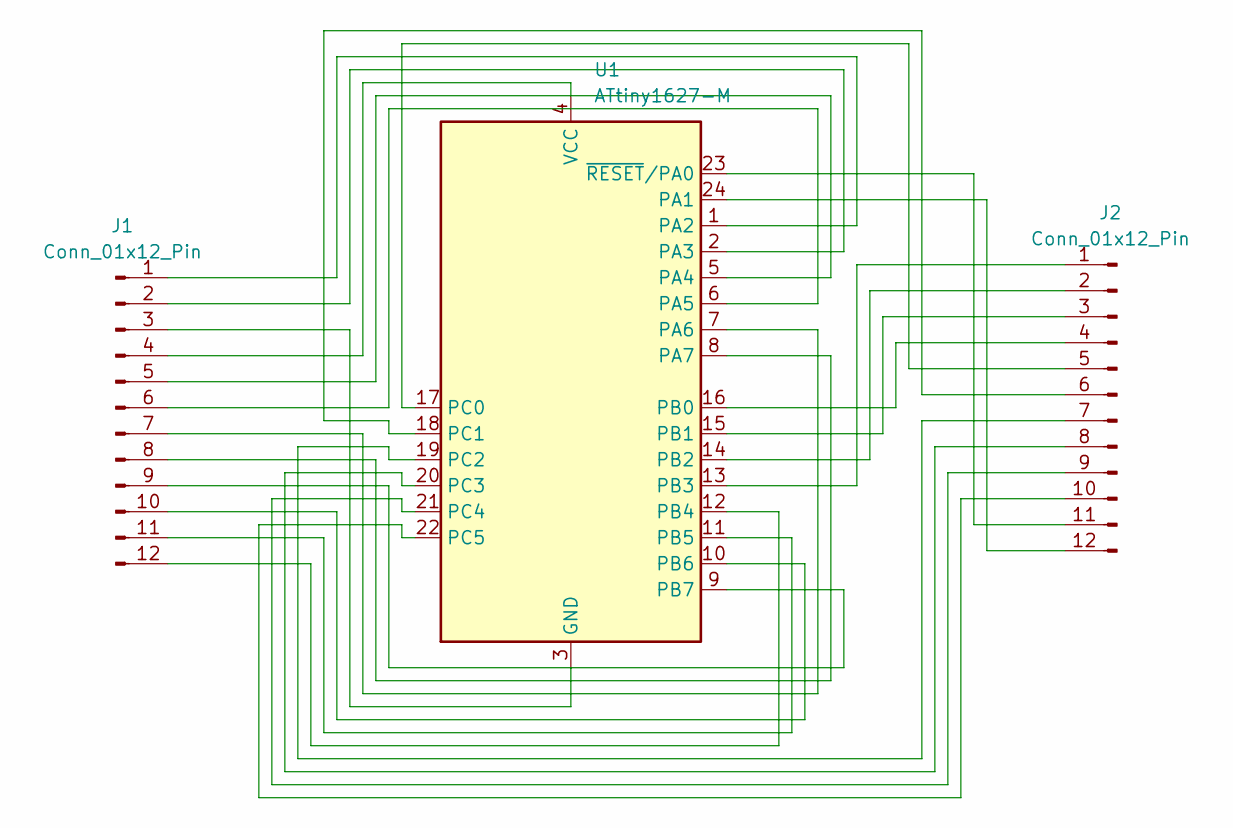
[picture p83: schematic VQFN_breakout.kicad_sch]

Parts:
J1, J2: Conn_01x12_Pin; PinSocket_1x12_P2.54mm_Vertical
U1: ATtiny1627-M; QFN-24-1EP_4x4mm_P0.5mm_EP2.6x2.6mm

Connections:
unnamed: J1.1, U1.1 (PA2)
unnamed: J1.2, U1.2 (PA3)
unnamed: J1.3, U1.3 (GND), U1.25 (GND)
unnamed: J1.4, U1.4 (VCC)
unnamed: J1.5, U1.5 (PA4)
unnamed: J1.6, U1.6 (PA5)
unnamed: J1.7, U1.7 (PA6)
unnamed: J1.8, U1.8 (PA7)
unnamed: J1.9, U1.9 (PB7)
unnamed: J1.10, U1.10 (PB6)
unnamed: J1.11, U1.11 (PB5)
unnamed: J1.12, U1.12 (PB4)
unnamed: J2.1, U1.13 (PB3)
unnamed: J2.2, U1.14 (PB2)
unnamed: J2.3, U1.15 (PB1)
unnamed: J2.4, U1.16 (PB0)
unnamed: J2.5, U1.17 (PC0)
unnamed: J2.6, U1.18 (PC1)
unnamed: J2.7, U1.19 (PC2)
unnamed: J2.8, U1.20 (PC3)
unnamed: J2.9, U1.21 (PC4)
unnamed: J2.10, U1.22 (PC5)
unnamed: J2.11, U1.23 (~RESET/PA0)
unnamed: J2.12, U1.24 (PA1)

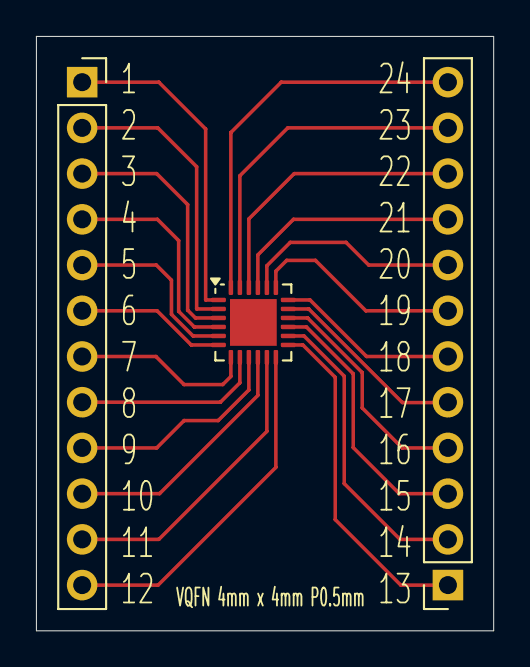
[picture p84: board VQFN_breakout.kicad_pcb from above]

Board: 2 copper layers, 25.4 x 33.0 mm, 3 parts (0 on the bottom side), 24 nets.
