RichardSefton/AUV/(commit log)

2024-05-29 Initial code dump.
    This commit includes the initial proof of concepts for I2C protocol between an host and client (working state) and also the
    currently ongoing sonar proof of concept which is currently transmitting on 40kHz to a 40kHz transducer.
2024-05-29 Added the PCB Breakout design for VQFN packaged chips. This includes the gerber files used by the company who fabricated the boards.
    [VQFN_breakout-B_Cu.gbr, VQFN_breakout-B_Mask.gbr, VQFN_breakout-B_Paste.gbr, VQFN_breakout-B_Silkscreen.gbr, VQFN_breakout-Edge_Cuts.gbr, VQFN_breakout-F_Cu.gbr, VQFN_breakout-F_Mask.gbr, VQFN_breakout-F_Paste.gbr]
2024-05-29 Added the i2c proof of concept kicad drawings (circuit diagram)
    [i2c_poc.kicad_pcb, i2c_poc.kicad_sch]
2024-06-08 Sonar in a working state with the current circuit diagram for it. (in the kicad drawings)
    [Sonar.kicad_pcb, Sonar.kicad_sch]
2024-06-09 Added i2c controller for sonar.
    This is working, but the sonar module itself is still being troublesome.
    It is not giving an accurate time. not sure why.
2024-06-09 Push before a rework
    I want to swap out TCB1 for RTC for greater accuracy.
    [controller.c, sonar.c]
2024-06-12 Added stepper motor driver test script ready for the prototype. Just needs i2c integration at this point.
    And some logic to control what it does when it receives a command. Maybe a command list or something?
2024-06-12 Added Prototype (for midterm) module projects.
    Projects added are a prototype motor controller, HC-SR04 based sonar module, and a controller
    All modules are i2c connected with the controller set as the host.
    In its current state its time to expand the I2C libraries to accomodate read operations.
2024-06-13 I2C Read oiperation is sending correct data.
    Current issue to resolve is the I2C rail doesn't handle multiple devices correctly.
    I think this is to do with arbitration rules.
    [I2C_Client.c, I2C_Client.h, I2C_Host.c, controller.c, motor.c, ultrasonic.c]
2024-06-14 I2C Broken but maybe salvageable?
    [I2C_Client.c, I2C_Host.c, I2C_Host.h, controller.c, motor.c]
2024-06-14 Refactored the I2C/TWI library.
    This should be a more stable version now. Developed inline with the datasheet.
    Still has a lot of work to be viable for wider applications, but at least for
    this prototype it should hold up. It just has to work for a weekend.
2024-06-15 Added LED Debug functions and colour defs
2024-06-15 Took hours and hours but a working prototype has been acheived!
2024-07-02 Made more models. Waiting to see if current ones fit once fabricated.
    [CentralController.kicad_pcb, CentralController.kicad_sch, Housing.3mf, Housing.step, LinearScrew-Screw.3mf, MotorHousing-Linear.FCStd, PushNut.FCStd, StepperMotor.FCStd]
2024-08-01 Made start on central controller.
    [CentralController.kicad_pcb, CentralController.kicad_sch]
2024-08-06 About to make changes to TWI library.
    [CentralController.kicad_pcb, CentralController.kicad_sch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]
2024-08-07 The Depth Controller and Central Controller are talking to one another.
    Need to reintegrate the sonar module to get the 3 modules working in tandem.
2024-08-09 central controller doesnt seem to want to work with peripherals enabled.
    [AUVv27_0808241707.dwg, Housing.3mf, Housing.step, LinearScrew-Screw.3mf, MotorHousing-Linear.FCStd, PushNut.FCStd, Sonar.kicad_pcb, Sonar.kicad_sch]
2024-08-12 Communication (TWI) is not quite working. Central controller seems to be at fault
    Or at least I think it is. The device seems to reset and other peripherals
    (RTC) do not have working ISRs so thats why the assumption is this is the fault.
    [CentralController.c, DepthController.c, SonarModule.c, TWI.c]
2024-08-12 Still not working but exploring other avenues as a fallback
    [CentralController.c, DepthController.c, TWI.c]
2024-08-15 Still not working. trying to port Wire.h
    [Wire.c, Wire.h, host.c, main.c, main.cpp, twi_pins.c, twi_pins.h]
2024-08-15 CWire added
    Still not working but I think its the best hope.
    Its a hacked version of Wire for arduino from megaTinyCore. Rewritten in C and hopefully
    decoupled.
    [CWire.c, CWire.h, client.c, host.c, twi_pins.c, twi_pins.h]
2024-08-16 Appears to be working for write operations. Need to expand and test
    Also just as a note it seems connected i2c devices need a common power source.
2024-08-16 Working on read and write operations.
    This is a hacked version or Wire from megaTinyCore. converted to C and dependencies removed.
    megatinycore version is used because it contains the correct registers.
    [client2.c, host.c]
2024-08-19 i2c working and adding more modules.
    converted the common code to library projects.
2024-08-20 Interconnected devices working. Need 2 more sonar and directional motor
2024-08-20 Added the other 2 sonar modules.
2024-09-02 Added midterm report so I can work on it elsewhere
    [AUV.kicad_pcb, AUV.kicad_sch, CentralController.kicad_pcb, CentralController.kicad_sch, DepthController.kicad_pcb, DepthController.kicad_sch, MainMotor.kicad_pcb, MainMotor.kicad_sch]
2024-09-03 First draft of Design portion of the FinalReport
    [AUV.kicad_pcb, AUV.kicad_sch, SideMotors.kicad_sch]
